s2chhaen/USV/README.md

Unmanned Surface Vehicle (USV)
# USV-Projekt

Im Projekt USV entwickeln Studenten unterschiedlicher Fachbereiche ein autonomes Wasserfahrzeug, welches eine vorgegebene Route fährt. Dabei müssen Kollisionen mit bewegten und unbewegten Hindernissen vermieden werden.

USV

(c) 2023 Joe.G
