s2chhaen/USV/01 Hardware/11 GPS/03 Software/99 demo/readme.md

## Testmessung für Kalmanfilter (GPS+IMU).
Messung und räumliche Kombination mehrerer Inertialsensoren.
Die Bewegung erfolgte im Gyrokoordinatensystem in Richtung der x-Achse

Messgrößen sind:
- Beschleunigung in ax, ay, az
- Drehraten in gx, gy, gz
- Timestamp
- Latitude, Longitude, Speed
- Satelliten

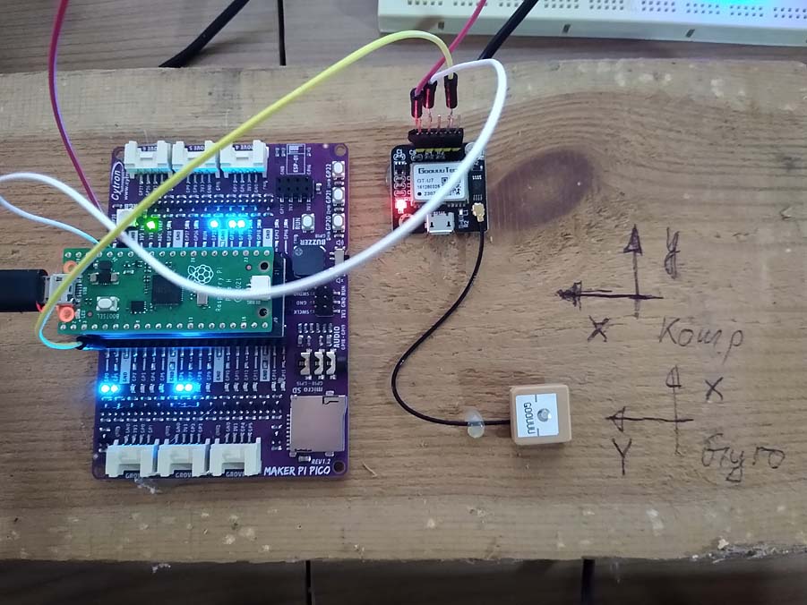
[picture p4: 01 Hardware/11 GPS/03 Software/99 demo/aufbau.jpg]
Versuchsaufbau
