s2chhaen/USV/01 Hardware/07 drive/02 Software/98 lib/README.md

## Hilfsfunktionen für die Antriebe

### PIO Module für RPi Pico RP2040 

1. uart_dma_rx.py (8 UART's für RX)
2. uart_dma_xx.py (8 UART's für TX)

### Steuerfunktion für Trust und Rudder

1. drive_system.py (aktuelle Steuerfunktion für Trust und Rudder)
2. test_drive_system.py (Testfunktionen)
