s2chhaen/USV/01 Hardware/06 energy_management/01 Firmware/Berechnungsformeln.docx

Berechnungsformeln von Spannung, Strom und Energie:

Spannung:

U=(ADC∙U_(Ref))/1024∙k=(ADC∙2,5 V)/1024∙6

ADC | … | Ausgangswert des Analog-Digital-Wandlers
URef | … | Referenzspannung des Analog-Digital-Wandlers
k | … | Verstärkungsfaktor des Spannungsteilers

Strom:

I=(ADC∙U_(Ref))/(1024∙R_S ∙m)+n/m=(ADC∙2,5 V)/(1024∙100 Ω∙0,00039487)+(0,00000451)/(0,00039487)

RS | … | Shuntwiderstand
m | … | Anstieg der Kalibrierfunktion
n | … | Offset der Kalibrierfunktion

Leistung:

P=U∙I

Energie:

E=P_(alt) ∙t+((P_(neu) -P_(alt) )∙t)/2

Palt | … | Leistung der vorherigen Messung
Pneu | … | Leistung der aktuellen Messung
t | … | Zeitintervall

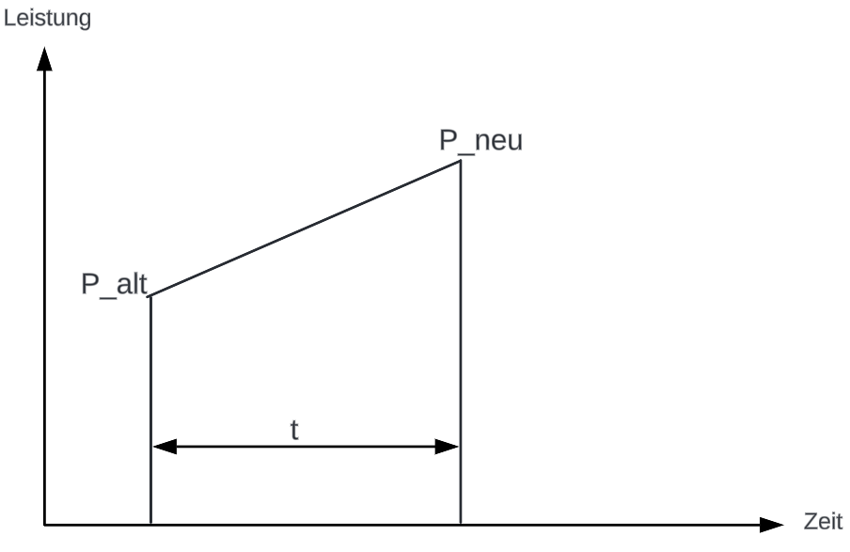
[picture p6: figure]
