s2chhaen/USV/01 Hardware/08 control/00 doc/Projektabschlusspräsentation.pdf

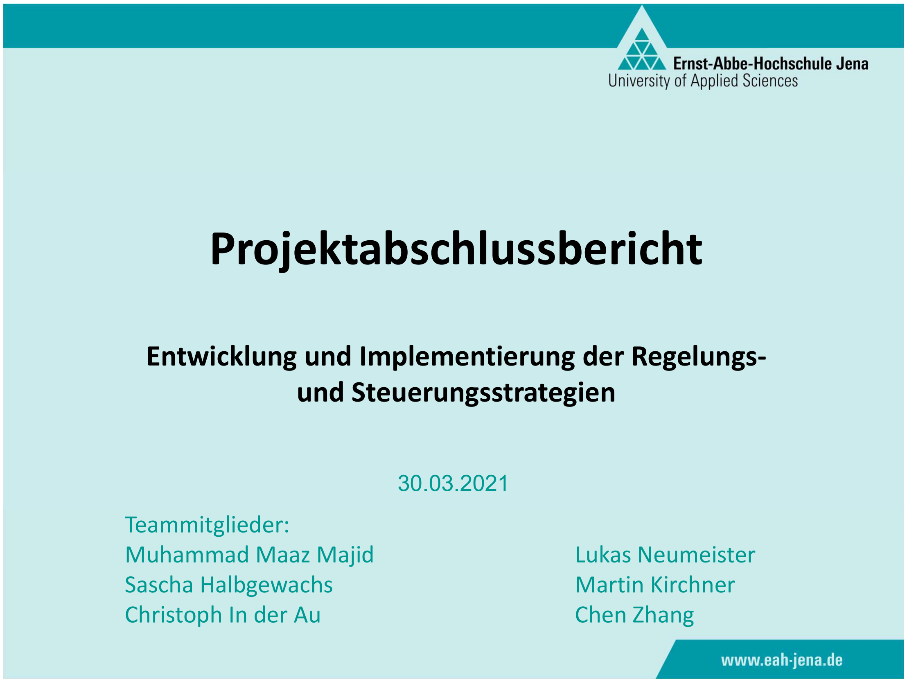
[picture p19: page 1]

# Projektabschlussbericht

## Entwicklung und Implementierung der Regelungs-und Steuerungsstrategien

30.03.2021
Teammitglieder:
Muhammad Maaz Majid | Lukas Neumeister
Sascha Halbgewachs | Martin Kirchner
Christoph In der Au | Chen Zhang

## Inhalt

## 1. Einleitung 2. Hardware und Buskommunikation 3. Regelungsstrategie 4. Ergebnisse und Validierung 5. Zusammenfassung und Ausblick

30.03.2021 | Chen Zhang | 2

# Einleitung

30.03.2021 | Chen Zhang | 3

Einleitung

## Aufteilung in Team

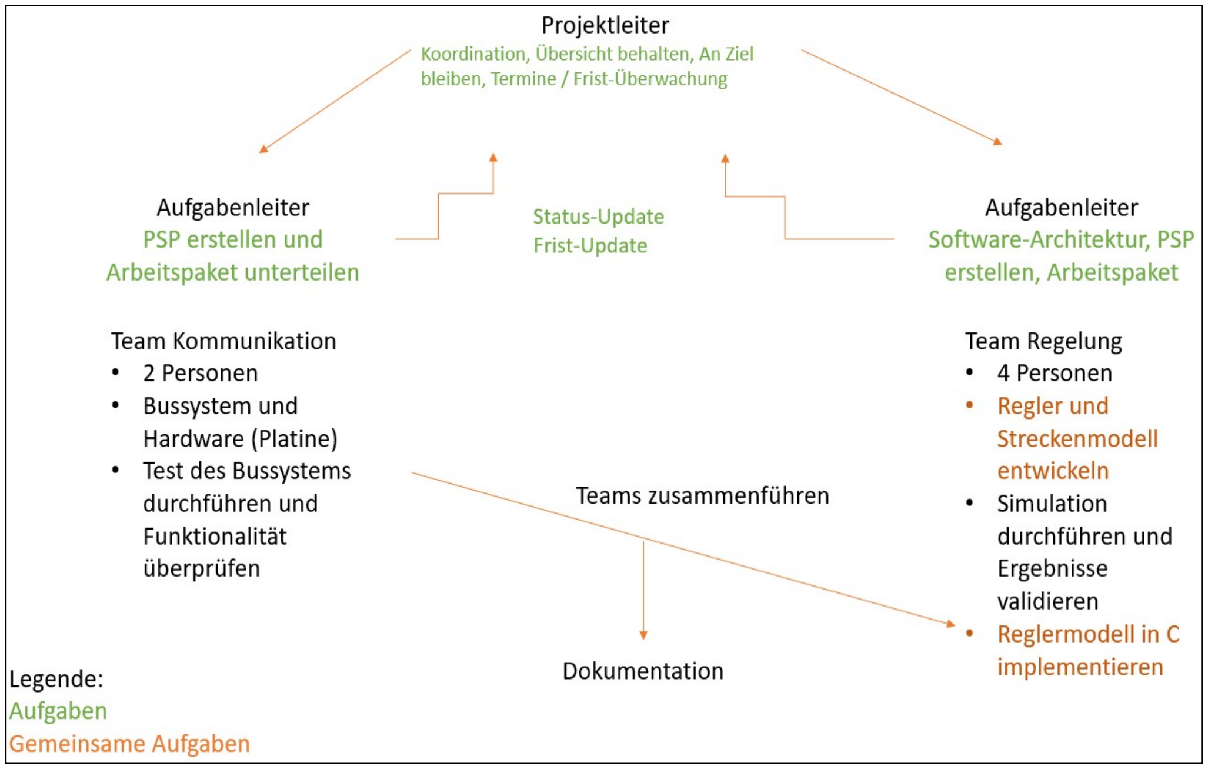
[picture p20: figure]

30.03.2021 | Chen Zhang | 4

# Hardware und Buskommunikation

30.03.2021 | Lukas Neumeister, Christoph In der Au | 5

Hardware und Buskommunikation

## Überblick

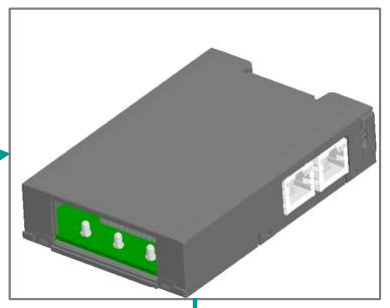
[picture p21: figure]
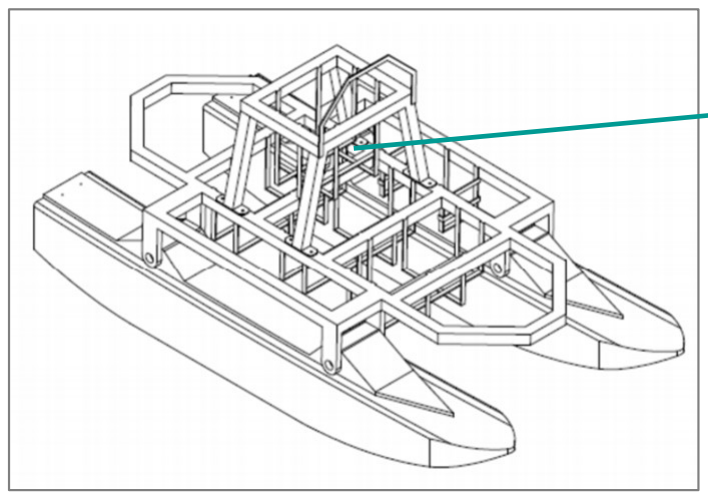
[picture p22: figure]
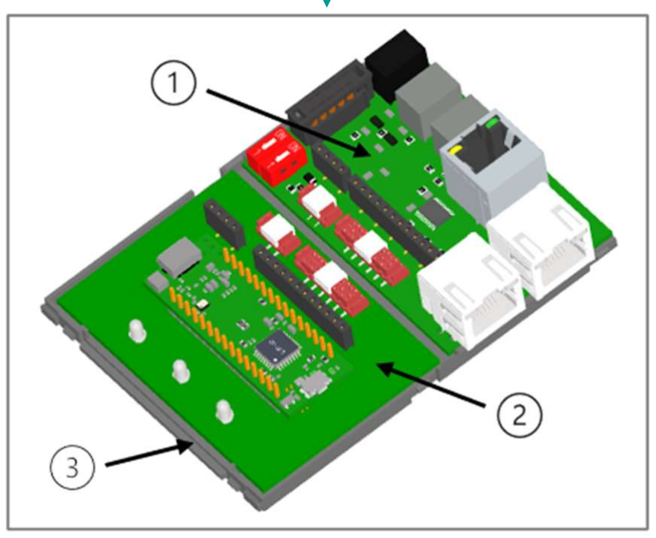
[picture p23: figure]

30.03.2021 | Lukas Neumeister, Christoph In der Au | 6

Slave und User-Unit

USV – Katamaran [1]

User-Unit
Gehäuse

Slave

Hardware und Buskommunikation

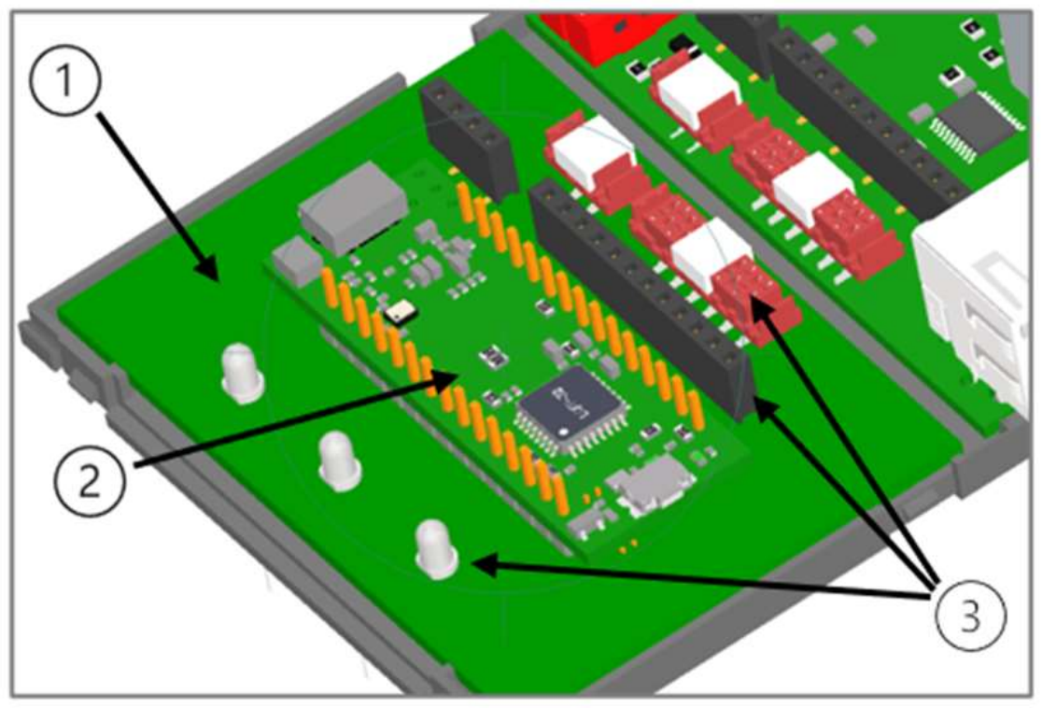
[picture p24: figure]

## Hardware

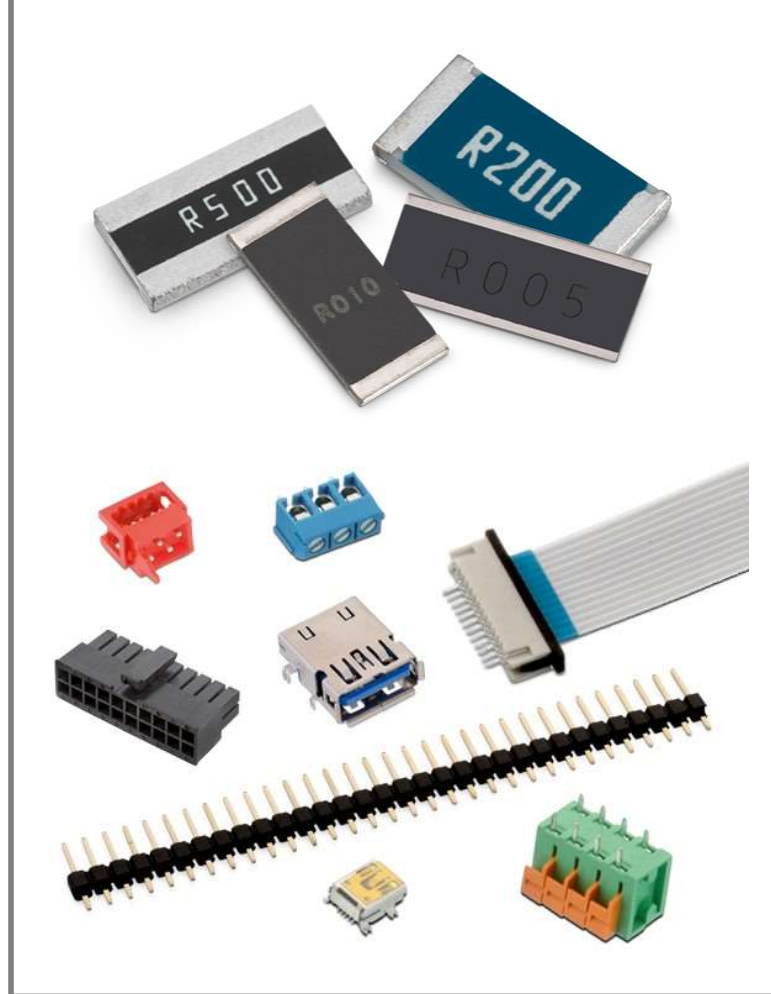
[picture p25: figure]
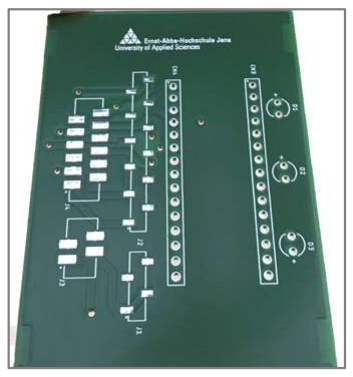
[picture p26: figure]
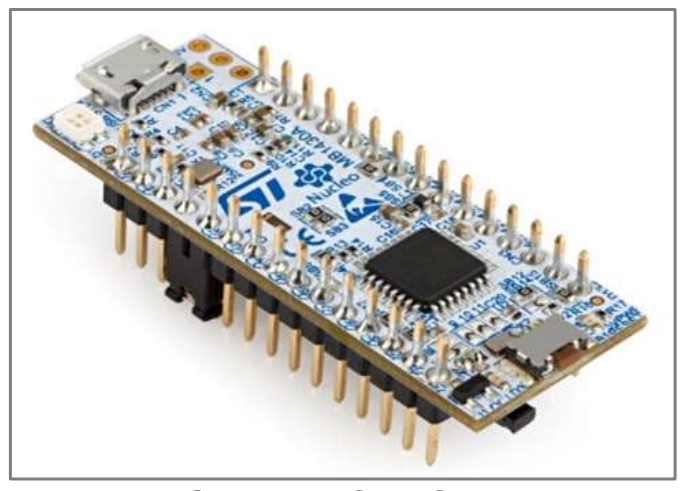
[picture p27: figure]

30.03.2021 | Lukas Neumeister, Christoph In der Au | 7
STM NUCLEO[3] | Würth Electronic [4]
Platinenlayout | Entwicklungsboard | Weitere Bauteile

Hardware und Buskommunikation

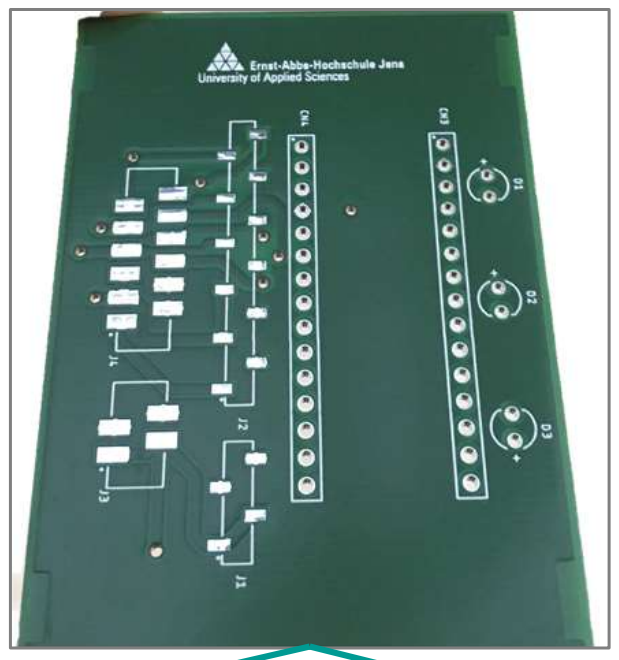
[picture p28: figure]

## Platinenlayout

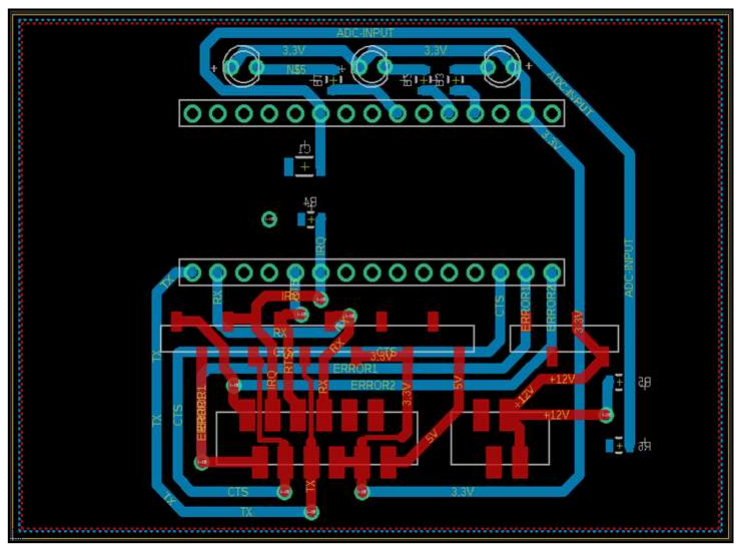
[picture p29: figure]
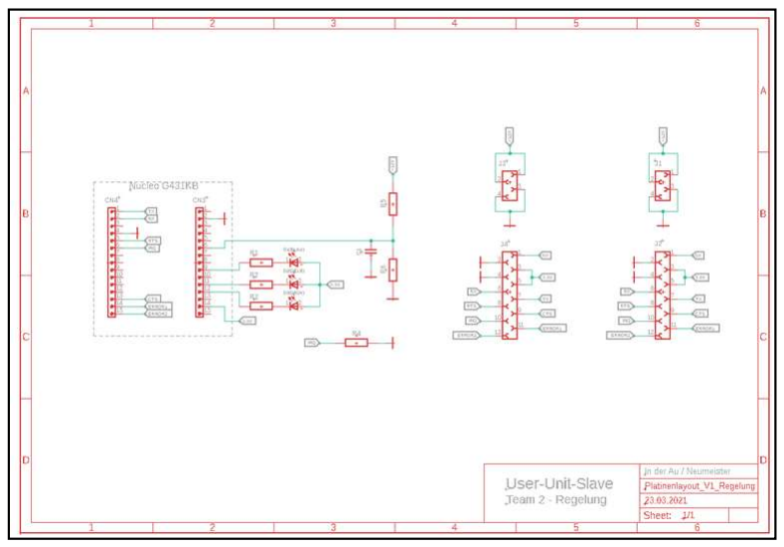
[picture p30: figure]

30.03.2021 | Lukas Neumeister, Christoph In der Au | 8
Board-Layout | Schaltplan

Hardware und Buskommunikation

## Board-Layout

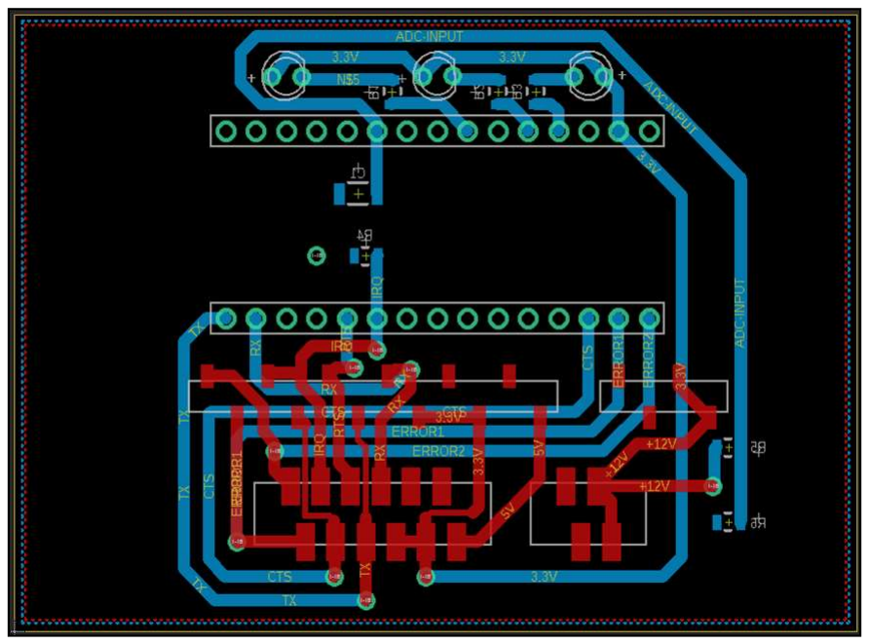
[picture p31: figure]

30.03.2021 | Lukas Neumeister, Christoph In der Au | 9
- 2-Layer-Platine
- Verwendung von VIAs
- Maße: 70,8 x 50,1 x 15 mm
- Platinenstärke: max. 1,6 mm
- Design-Rules: • EAGLE-Vorlage
- SMD 0805
- Leitungsstärken 0,5 – 1 mm
- Lochraster (2,54 mm)
- Keep-Out-Areas • Befestigung der Platine im Gehäuse

## Schaltplan

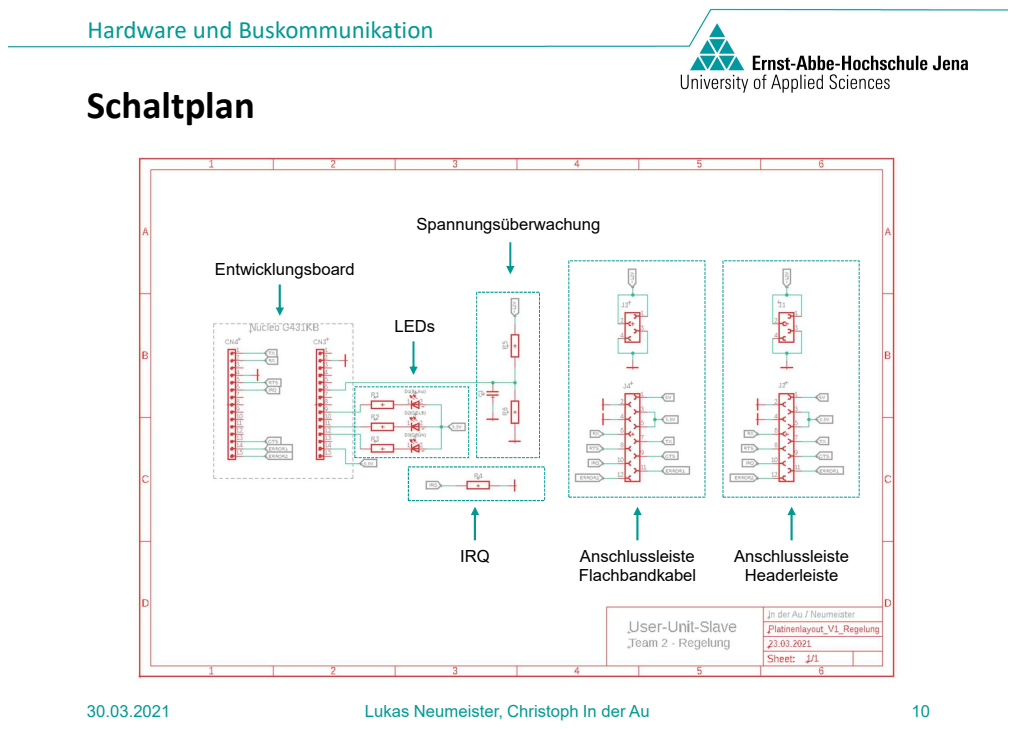
[picture p32: page 10]
Lukas Neumeister, Christoph In der Au; Entwicklungsboard; Spannungsüberwachung; LEDs; Anschlussleiste Flachbandkabel; Anschlussleiste Headerleiste; IRQ

Hardware und Buskommunikation

Hardware und Buskommunikation

## Entwicklungsboard

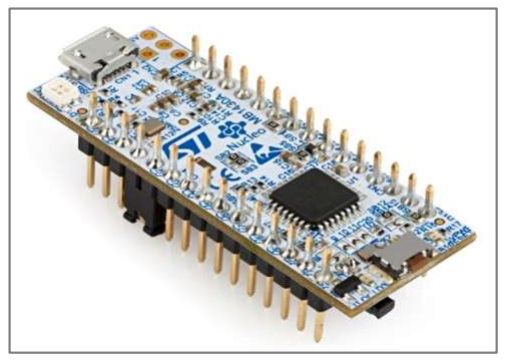
[picture p33: figure]
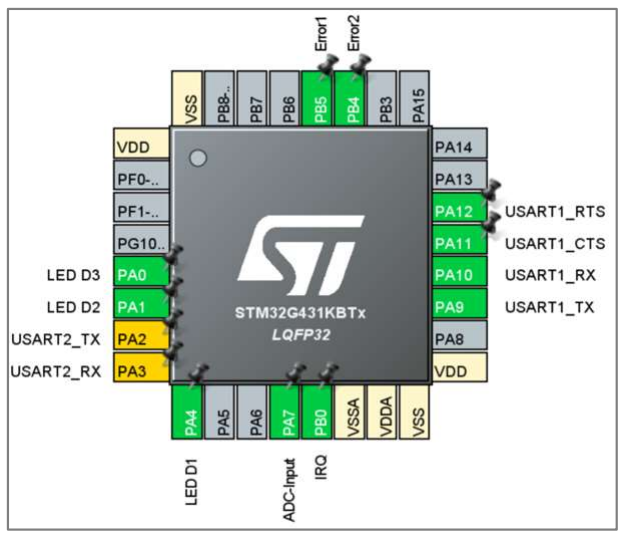
[picture p34: figure]

30.03.2021 | Lukas Neumeister, Christoph In der Au | 11

STM NUCLEO[3]

- Hersteller: STM • Typ: NUCLEO G431KB
- Software STM32CubeIDE 1.5.0
- Konfiguration der Pins
- Anforderungen: • Maße
- Versorgungsspannung
- RS232-Busspannung
- Anwendung / Support • Preis/Leistung

Hardware und Buskommunikation

## Entwicklungsboard

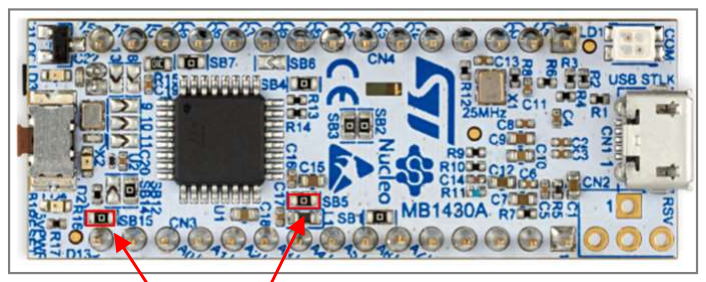
[picture p35: figure]

30.03.2021 | Lukas Neumeister, Christoph In der Au | 12
- Modifizierung Layout
- Entfernung Lötbrücke SB5
- Entfernung Lötbrücke SB15
- Nur noch Betrieb mit 3,3 V möglich

Modifizierung

Hardware und Buskommunikation

## Weitere Bauteile

30.03.2021 | Lukas Neumeister, Christoph In der Au | 13
- Anforderungen
- SMD-Bauteile (Kondensatoren, Widerstände)
- Anschlussleisten für Flachbandkabel (feste Verbindung mit Slave)
- Headerleisten (Debugging)
- THT-LEDs (Debugging)

Hardware und Buskommunikation

## Finales Platinenlayout

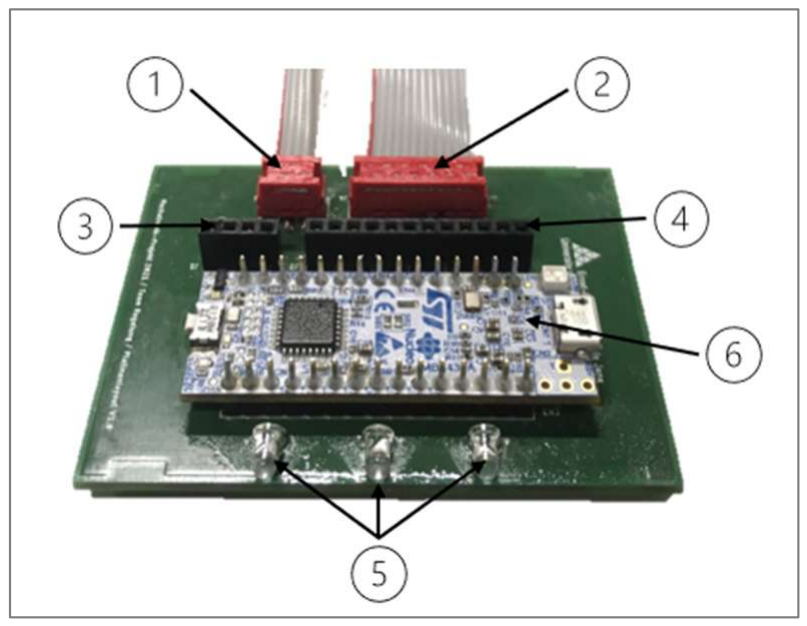
[picture p36: figure]
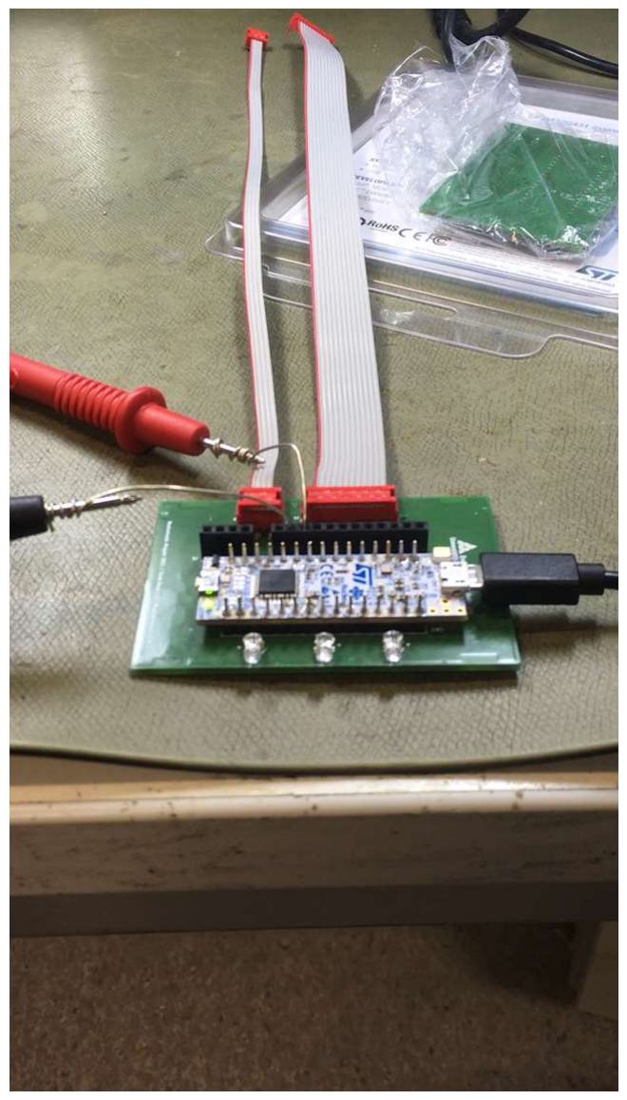
[picture p37: figure]

30.03.2021 | Lukas Neumeister, Christoph In der Au | 14

12-polig Flachbandkabel
4-polig Headerleiste

4-polig Flachbandkabel

12-polig Headerleiste
LEDs
Entwicklungsboard

Hardware und Buskommunikation

## Buskommunikation

Kommunikation User-Unit | USV-Slave:
- Bussystem: RS232-Bus
- Datenschnittstelle: UART-Schnittstelle

Datenübertragung:
- RS232-Übertragungsprotokoll definiert Datenablauf und Frameaufbau für das Schreiben und Lesen
- Blockweises Schreiben und Lesen von Daten

Entwicklungsumgebung:
- Board: NUCLEO-G431KB IDE: STM32CubeIDE 1.5.0
30.03.2021 | Lukas Neumeister, Christoph In der Au | 15

Hardware und Buskommunikation

## UARTs und ihre Aufgaben

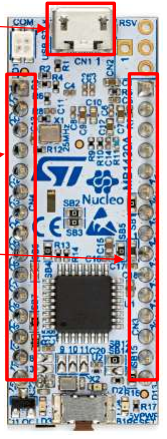
[picture p38: figure]

30.03.2021 | Lukas Neumeister, Christoph In der Au | 16

UART1
- Pin-Header
- Buskommunikation
mit dem USV-Slave

UART2
- USB-Connector
- Kommunikation mit dem
PC-Terminal
- Flashen und Debugging

## Daten schreiben

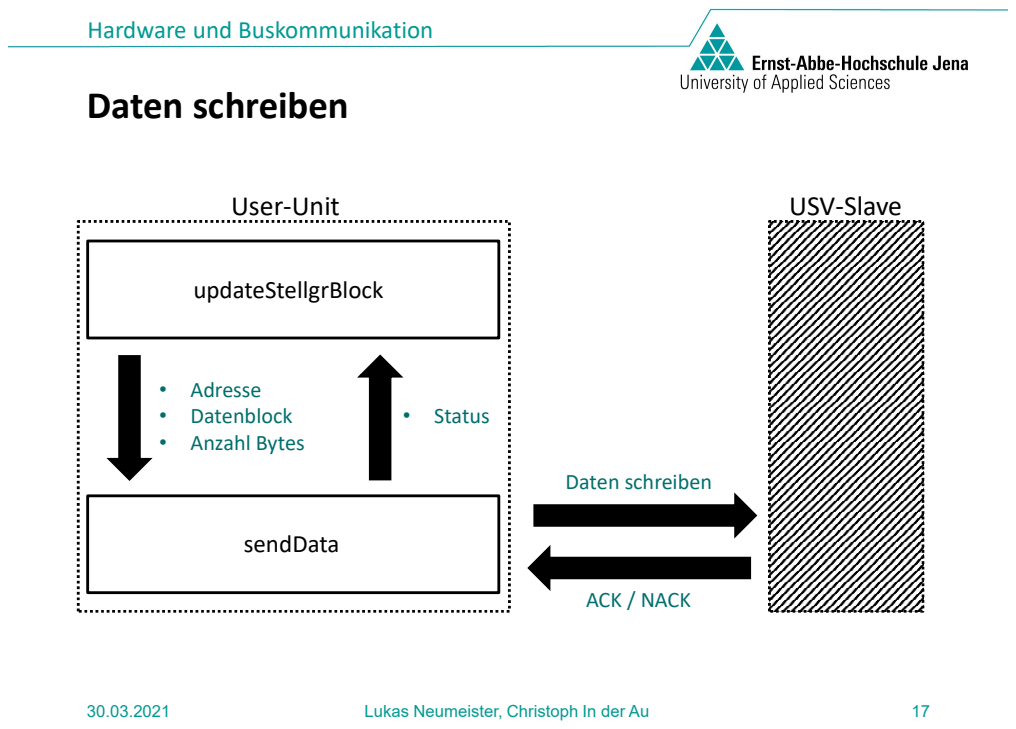
[picture p39: page 17]
Lukas Neumeister, Christoph In der Au; User-Unit; USV-Slave; updateStellgrBlock; sendData; Daten schreiben; ACK / NACK; • Adresse • Datenblock • Anzahl Bytes; • Status

Hardware und Buskommunikation

## Daten lesen

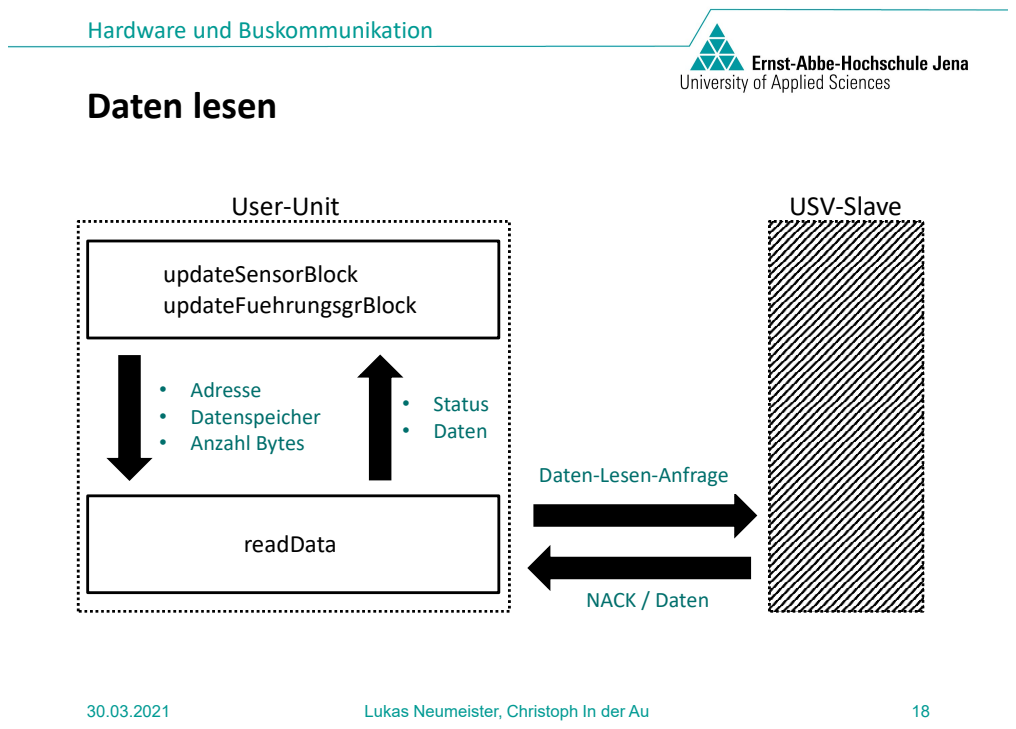
[picture p40: page 18]
Lukas Neumeister, Christoph In der Au; USV-Slave; NACK / Daten; User-Unit; updateSensorBlock updateFuehrungsgrBlock; readData; • Status • Daten

Hardware und Buskommunikation

• Adresse
• Datenspeicher • Anzahl Bytes

Daten-Lesen-Anfrage

Hardware und Buskommunikation

## Aktuelle Softwareprobleme

- Nach einer gewissen Zeitspanne hängt sich die Kommunikation auf Behebung des Problems geplant: 06.04.2021
- Slave-ID ergänzen
30.03.2021 | Lukas Neumeister, Christoph In der Au | 19

# Regelungsstrategie

30.03.2021 | Muhammad Maaz Majid | 20

Regelungsstrategie

## Regelungsstrategie

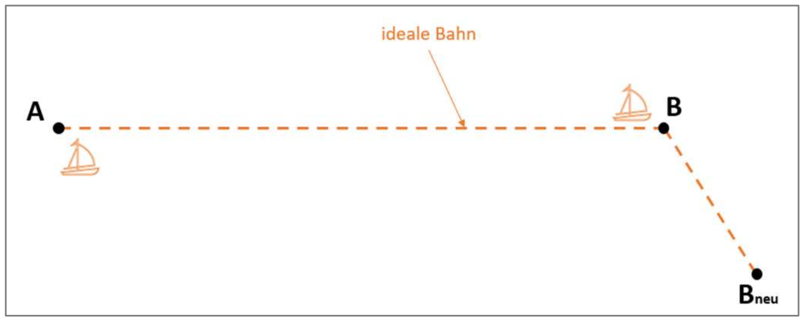
[picture p41: figure]
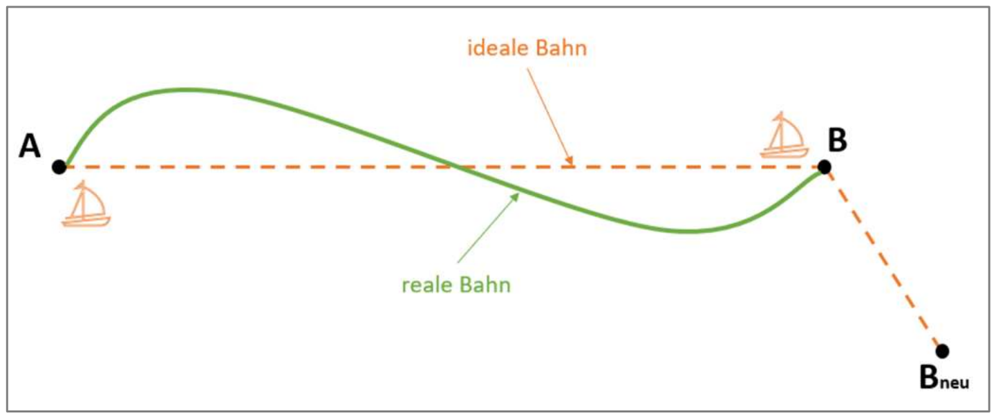
[picture p42: figure]

30.03.2021 | Muhammad Maaz Majid | 21

Regelungsstrategie

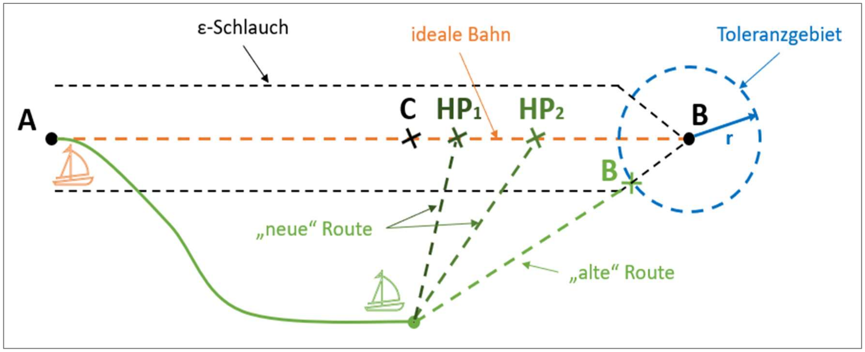
[picture p43: figure]

30.03.2021 | Muhammad Maaz Majid | 22

# Ergebnisse und Validierung

30.03.2021 | Muhammad Maaz Majid | 23

Ergebnisse und Validierung

## Ergebnisse

- PID-Regelalgorithmus umgesetzt
- Regelstrategie entwickelt und über interne Tests validiert
- Berechnung der Entfernung und Peilung implementiert und intern validiert
- Kommunikation über UART und benötigte Konvertierung umgesetzt
30.03.2021 | Muhammad Maaz Majid | 24

## Ergebnisse der Berechnungen

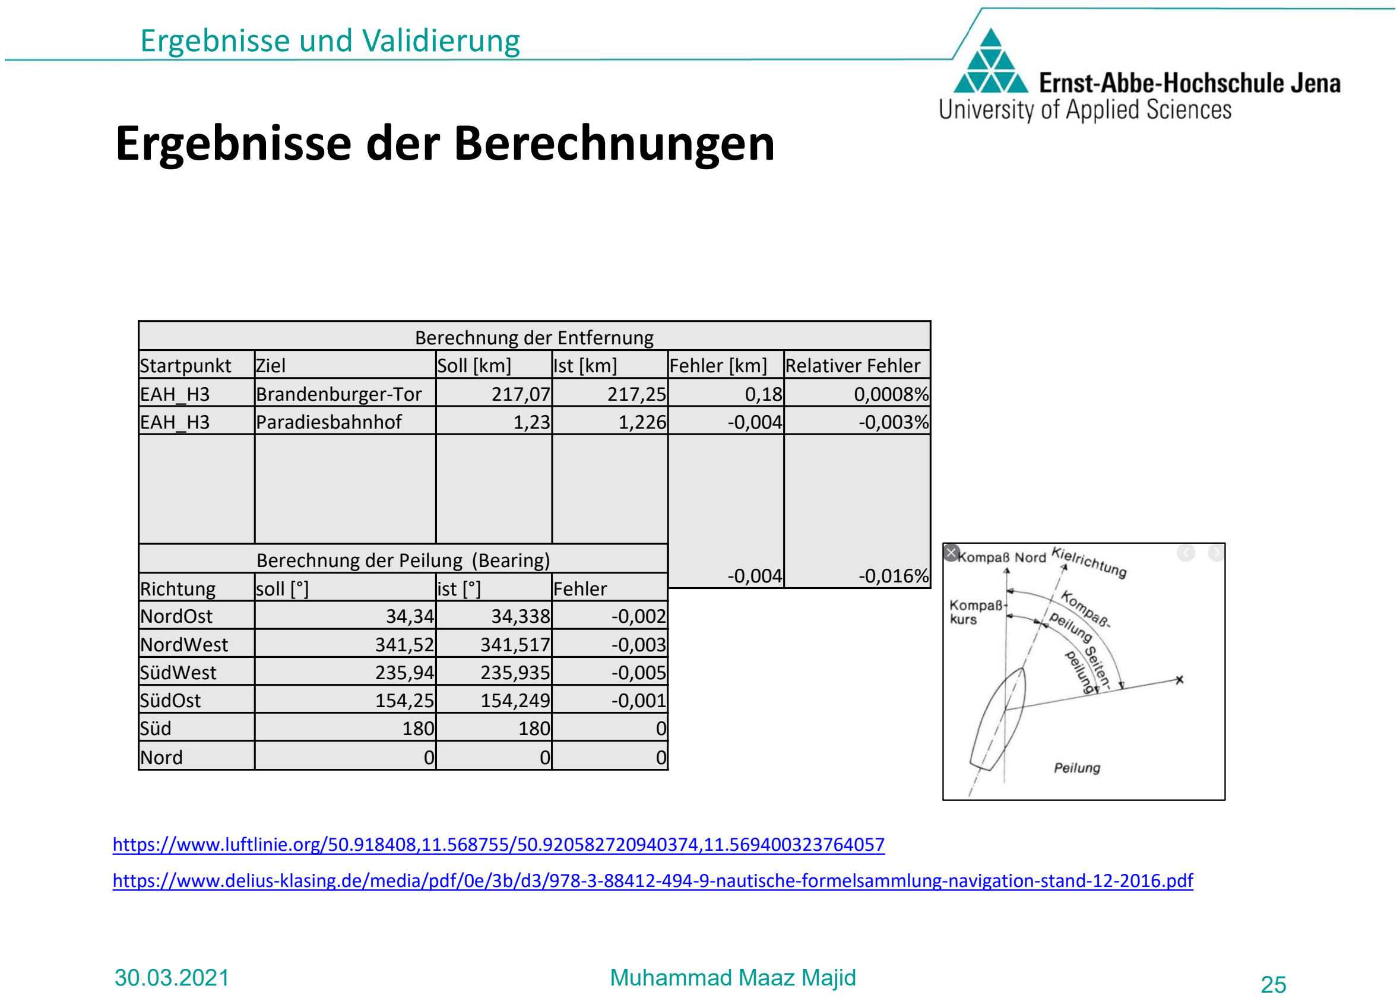
[picture p44: page 25]

Ergebnisse und Validierung

https://www.luftlinie.org/50.918408,11.568755/50.920582720940374,11.569400323764057https://www.delius-klasing.de/media/pdf/0e/3b/d3/978-3-88412-494-9-nautische-formelsammlung-navigation-stand-12-2016.pdf

25

Berechnung der Entfernung
Startpunkt | Ziel | Soll [km] | Ist [km] | Fehler [km] | Relativer Fehler
EAH_H3 | Brandenburger-Tor | 217,07 | 217,25 | 0,18 | 0,0008%
EAH_H3 | Paradiesbahnhof | 1,23 | 1,226 | -0,004 | -0,003%
| | | | -0,004 | -0,016%
EAH_H3 | Berechnung der Peilung (Bearing) Netto Parkplatz | 0,25
Richtung | soll [°] | ist [°] | Fehler
NordOst | 34,34 | 34,338 | -0,002
NordWest | 341,52 | 341,517 | -0,003
SüdWest | 235,94 | 235,935 | -0,005
SüdOst | 154,25 | 154,249 | -0,001
Süd | 180 | 180 | 0
Nord | 0 | 0 | 0

30.03.2021 Muhammad Maaz Majid

Ergebnisse und Validierung

## Berechnung Targetpoint

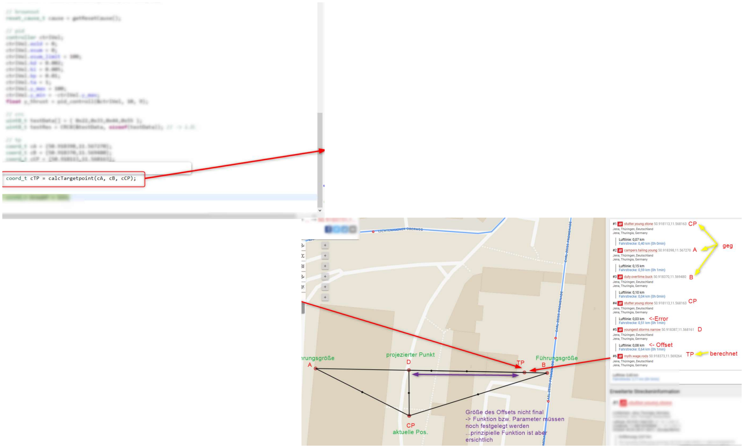
[picture p45: figure]

30.03.2021 | Muhammad Maaz Majid | 26

# Zusammenfassung und Ausblick

30.03.2021 | Muhammad Maaz Majid, Lukas Neumeister | 27

Zusammenfassung und Ausblick

## Ausblick

30.03.2021 | Muhammad Maaz Majid, Lukas Neumeister | 28
- Noch offen:
- Ermittlung exakter Reglerparameter am realen Bootmodell
- Unter Bearbeitung & wird nachgereicht:
- Implementierung Watchdog
- Detektion Brownout (Reset)
- Bugfix für Nichtwiederaufnahme der Kommunikation nach fehlerhafter Übertragung

Zusammenfassung und Ausblick

## Ausblick

30.03.2021 | Muhammad Maaz Majid, Lukas Neumeister | 29
- Folgende Erweiterungen sind denkbar:
- Fehlerbehandlungen
- Auslösen von Fehlermeldungen (z.B. Plausibilitätsprüfung Ergebnisse)
- Berechnung Targetpoints in Abhängigkeit der Geschwindigkeit
- Spannungsüberwachung (falls sinnvoll, Hardware schon vorhanden)

Zusammenfassung und Ausblick

## Zusammenfassung

- Zusammenfassung
- Hardware entwickelt und in Betrieb genommen
- Regelstrategie entwickelt und in C umgesetzt
- Buskommunikation über UART umgesetzt
- Konvertierung der Daten für Buskommunikation und Berechnung der Entfernung und Peilung umgesetzt
- PID-Regler implementiert
- Implementierte Programme intern validiert und zum Teil im Labor getestet
- Trotz schwieriger Umstände wegen Online-Semester haben wir die meisten Aufgaben rechtzeitig erledigt aufgrund guter Teamarbeit und guter Zusammenarbeit mit Prof. Grabow / Herr Franke / Team 1
30.03.2021 | Muhammad Maaz Majid, Lukas Neumeister | 30

## Vielen Dank für Ihre Aufmerksamkeit!

31 Chen Zhang, Christoph In der Au, Martin Kirchner, Muhammad Maaz Majid, Lukas Neumeister, Sascha Halbgewachs 30.03.2021

Quellen

## Quellen

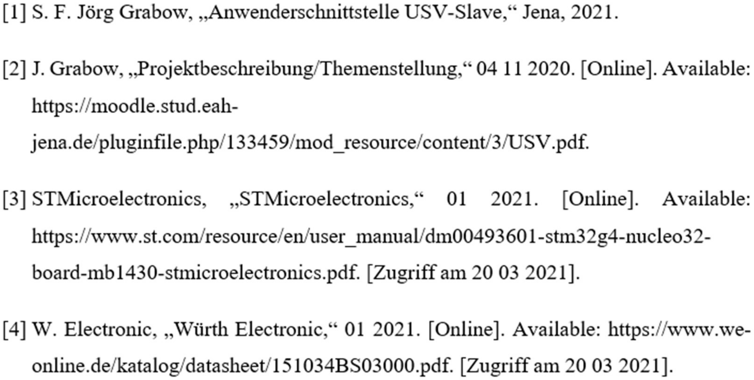
[picture p46: figure]

30.03.2021 32
