s2chhaen/USV/01 Hardware/03 APRS/02 Hardware/00 doc/USV-BG-001-BT-A.pdf

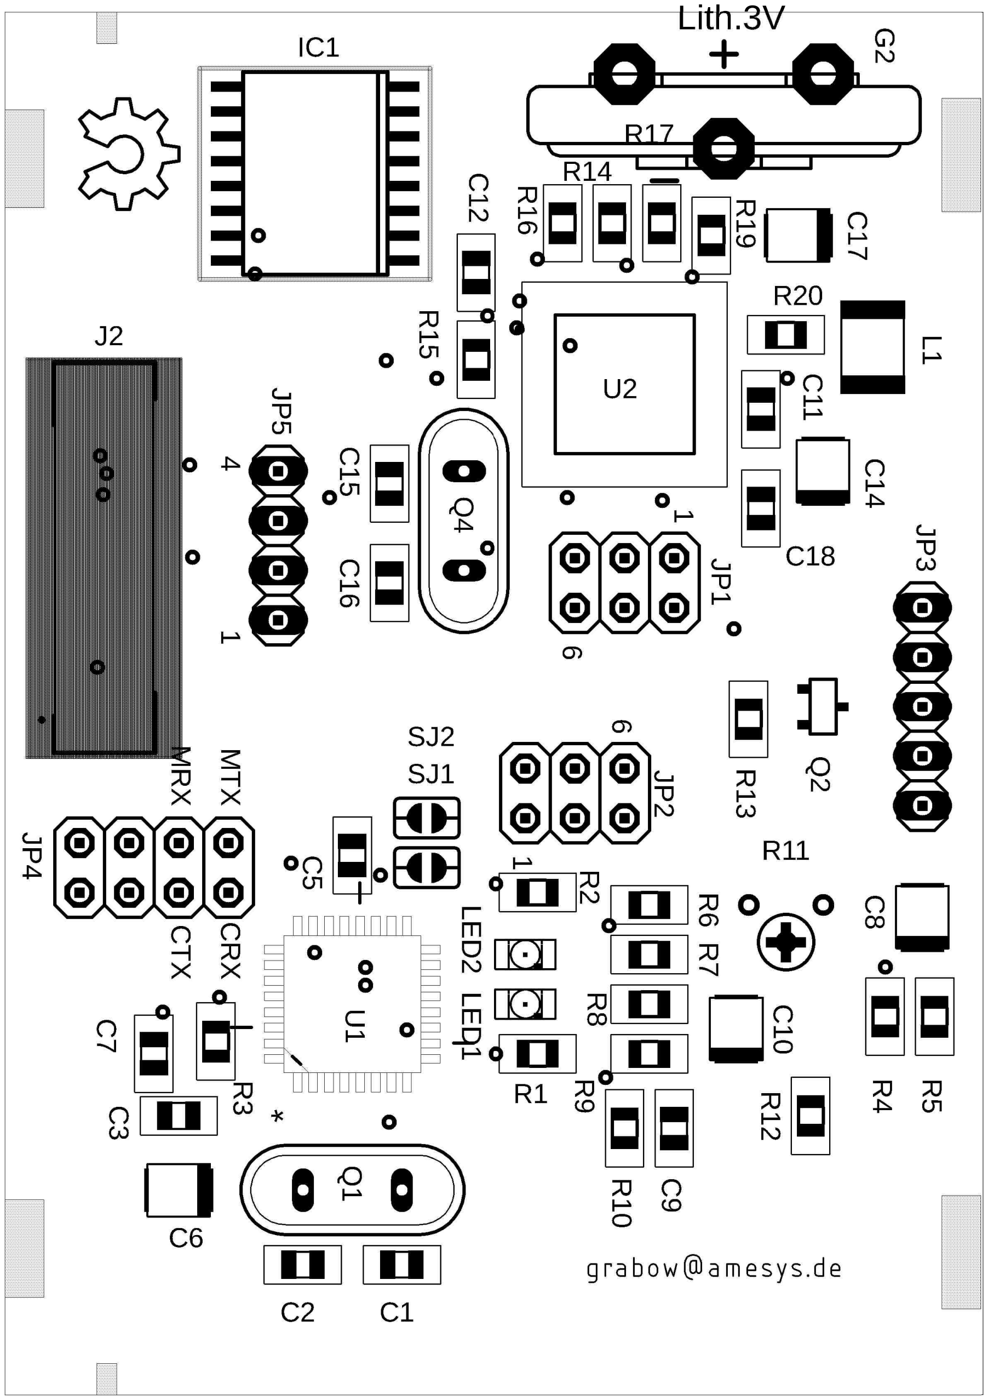
[picture p49: figure]
Lith.3V
