s2chhaen/USV/01 Hardware/01 Lidar/02 Hardware/00 doc/Kabelbelegung.xlsx

Nr | Name | Farbe
1 | 5V-Vcc | Rot
2 | GND | Schwarz
3 | Tx | Blau
4 | Rx | Grün
