s2chhaen/USV/02 Software/README.md

# Software zum USV-Projekt

1. Bussystem (Systembus zwischen Master- und Slavemodulen)
2. MMC (Mission Control Center)
3. Tools (kleine Hilfsmittel)
4. Simulation (Softwaretools zur Dynamiksimulation)
5. USV-Monitor (Tool zur Emulierung des Bussystems)
