s2chhaen/USV/00 doc/README.md

# Dokumentation zum USV-Projekt

1. Bussystem (Systembus zwischen Master- und Slavemodulen)
2. Simulation (Dynmiksimulation des Katamarans)
3. APRS (APRS-Datenschnittstelle)
4. Tools (kleine Hilfsmittel)
5. Management (Unterlagen zur Projektorganisation)
