s2chhaen/USV/01 Hardware/09 RC Control/readme.md

## FrSky Taranis Q X7 ACCESS
Die Softwareversionen von TX und RX müssen übereinstimmen, ansonsten lassen sich die Empfänger nicht binden.

aktuelle Softwareversionen am 12.10.24
TX Version: ISRM-N_2.1.9
RX Version: RX6R_RX4R_ACCST_V2.1.9_LBT.frsk
