s2chhaen/USV/02 Software/02 MCC/02 grafana/README.md

## Misson-Control-Center Dashboard zum USV

[Dashbooard](https://usv.agg.fc.eah-jena.de/d/cb240e08-9a89-4d38-8afd-2c9a5fe3cf5h/usv-aprs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)

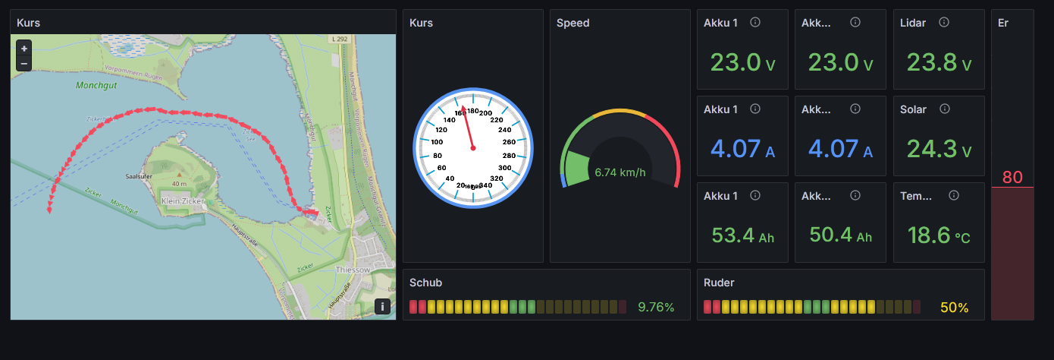
[picture p52: 02 Software/02 MCC/02 grafana/Grafana.png]
MCC-Dashboard Dashboard
