s2chhaen/USV/02 Software/02 MCC/01 python/README.md

## Python-Skripte

1. Python Skripte zum MQTT Broker
2. Python Skripte zum digitalen Zwilling des USV
