s2chhaen/USV/00 doc/02 APRS/00 MQTT/README.md

## Dokumentation zum Datenmanagement zwischen ARRS - MQTT - MariaDB

 Datei | Beschreibung
-------|-------------
APRS-Daten.pdf | Aufbau der APRS-Datenstruktur pro Sendedurchgang 
MQTT_to_SQL.pdf | Umwandlung von APRS-Daten in MQTT Daten sowie Ablage der MQTT-Daten in einer SQL-Datenbank

### Übersichtsdarstellung Datenkommunikation zum MCC

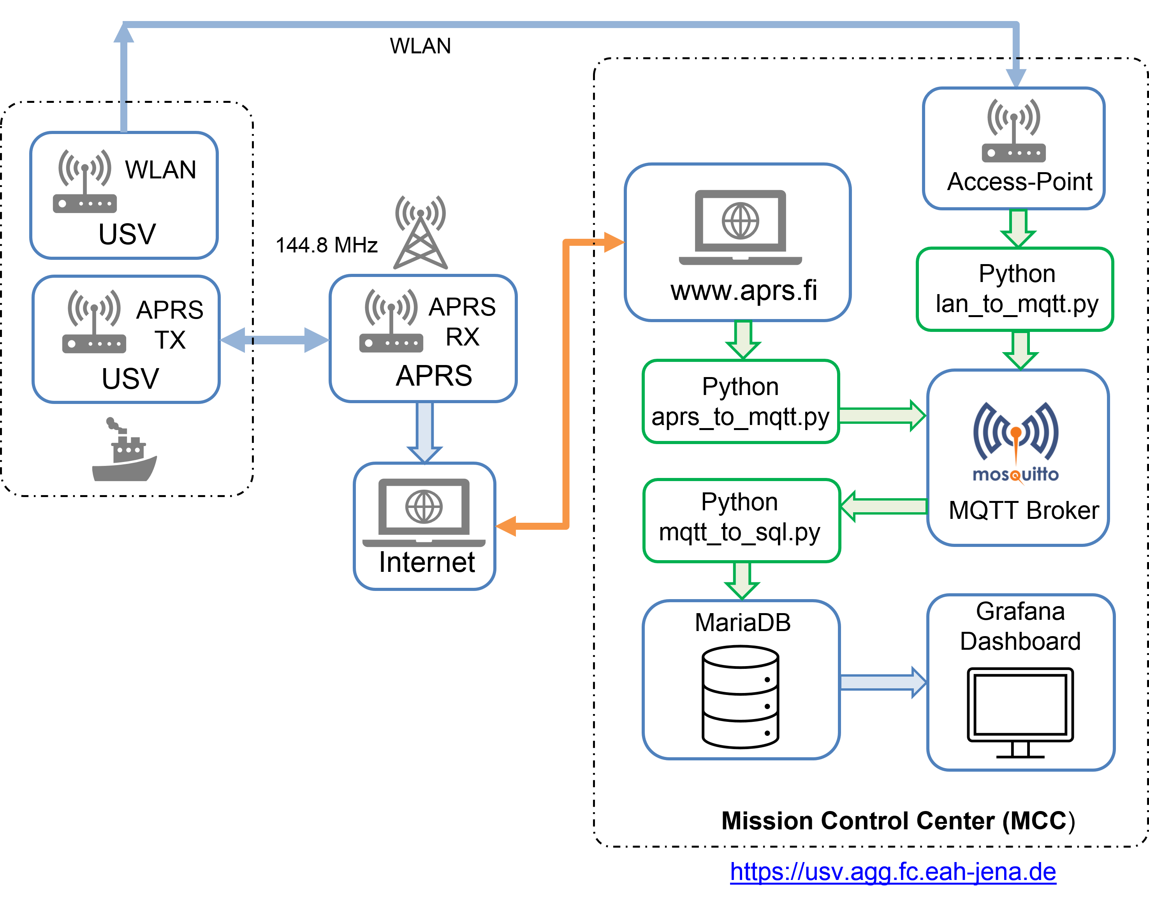
[picture p53: 00 doc/02 APRS/00 MQTT/Datenfluss.png]
MMC-Datenfluss Datenfluss


### MMC-Dashbord 

MMC-Dashboard Dashboard
