s2chhaen/USV/01 Hardware/09 RC Control/03 Firmware/01 RX/Readme.txt

*******************************Release Note******************************************

This Package is for RX4R RX6R ACCST v2.1.9 firmware update. 

Version and Files: 
RX6R_RX4R_ACCST_V2.1.9_FCC.frk                              Firmware under NonLbt mode which is certificated for FCC rules. 
RX6R_RX4R_ACCST_V2.1.9_LBT.frk                               Firmware under LBT mode which is certificated for CE rules.  
readme.txt                                                          Release note 
 
Firmware Version: v2.1.9

Please update the firmware of all your radios, RF modules and receivers accordingly.
The release history:
--------------------------------------------------------------------------------------------------------------------
v2.1.9
--------------------------------------------------------------------------------------------------
1. Fixed the issue of no PWM output caused by abnormal conditions in the S.Port link such as specific error data or exceeding the limitation of devices connected in the S.Port link (＞27 units).
Note: Please make sure the involved Receiver [Archer series (except for RS), R-XSR, RXSR-FC, RX4R, RX6R, G-RX6, G-RX8] or Transmitter [ISRM-N, ISRM-Pro, ISRM-S series RF module] in using have been both upgraded with this update or later version.
—————————————————————————————
Compatibility | ISRM Modules & ACCESS Radios
—————————————————————————-———–
ISRM-N → (Taranis X9 Lite & QX7 ACCESS & QX7S ACCESS)
ISRM-S-X9LITES → (Taranis X9 Lite S)
ISRM-S-X9DP2019 → (Taranis X9DP 2019 & X9DP 2019 SE)
ISRM-S-XLITES → (Taranis XLite S)
ISRM-Pro → (Taranis XLite Pro)
ISRM-S-X10E → (Horus X10 EXPRESS & X10S EXPRESS)
ISRM-S-X10S → (ACCESS Upgrade Module)

---------------------------------------------------------------------------------------------------------------------------------
How to upgrade receivers please refer to the video below:
https://www.frsky-rc.com/how-to-use-the-transmitter-to-flash-the-firmware-of-the-x8r-receiver/

With other radios which have s.port please choose [Flash s.port] in menu .
1. Put the firmware under the folder [FIRMWARE] of sd card.
2. Power on the radio and find the firmware,select it by press [ENT].
3. Select 'Flash S.port ', wait to end.

With Airlink S :
https://www.frsky-rc.com/how-to-upgrade-the-s-series-receivers-with-the-s-port-airlink-s/

With STK:
https://www.frsky-rc.com/how-to-use-frsky-stk-tool-to-update-firmware/
---------------------------------------------------------------------------------------------------------------------

**********************All rights reserved to FrSky Electronic ., Ltd.*********************************
