s2chhaen/USV/01 Hardware/07 drive/00 doc/Steuerkennlinie Haswing Protruar.pdf

# Steuerkennlinie Haswing Protruar

### Eingangsgröße: VVPower; Ganzzahlenwert „int16“; DD = ℤ ∧ [−16384, 16384] Ausgangsgröße: VVPPPPPP; Ganzzahlenwert „uint8“; DD = ℤ ∧ [0, 255]

### Mathematische Funktion

# VPPP(VPPPPP) = ⌊m ⋅ VPPPPP + n⌋ VPPP(VPPPPP) =

mmff

### 2ddff

# VPPPPP + n VPPP(VPPPPP) = mf ⋅ VPPPPP ⋅ 2−df + n

### mit

# mm − FFFFFFFFFFFF mmff − FFFFFFFFFFFF DDDDDDDDDD ddff − FFFFFFFFFFFF 2nn DDDDDDDD DD nn − OOOOOO

### Kennlinien Segmentierung

### - Segment 1: Vorwärtsfahrt; DD1 = ℤ ∧ [112, 235] - Segment 2: Stillstand; DD2 = ℤ ∧ [69, 111] - Segment 3: Rückwärtsfahrt DD3 = ℤ ∧ [0, 68]

### Segment 1 Funktion:

mm1 = 7.53784 ⋅ 10−3 ≈ 494
216
nn1 = 112

# VPPP(VPPPPP) = ⌊7.53784 ⋅ 10−3 ⋅ VPPPPP + 112⌋ VPPP(VPPPPP) = ⌊494 ⋅ VPPPPP ⋅ 2−16 + 112⌋

### Segment 2 Funktion:

mm2 = 335.94 ⋅ 10−3 ≈ 344
210
nn2 = 91

# VPPP(VPPPPP ) = ⌊335.94 ⋅ 10−3 ⋅ VPPPPP + 91⌋ VPPP(VPPPPP ) = ⌊344 ⋅ VPPPPP ⋅ 2−10 + 91⌋

### Segment 3 Funktion:

mm3 = 2.6932 ⋅ 10−3 ≈ 353
217
nn3 = 69

# VPPP(VPPPPP ) = ⌊335.94 ⋅ 10−3 ⋅ VPPPPP + 69⌋ VPPP(VPPPPP ) = ⌊353 ⋅ VPPPPP ⋅ 2−17 + 69⌋

### Segmentfunktion:

# VPPP(VPPPPP ) =

⎩

⎪

⎨

⎪

⎧

494

# 216 ⋅ VPPPPP + 112, if VPPPPP > 64

344

# 210 ⋅ VPPPPP + 91, if VPPPPP ≥ 64 ∧ VPPPPP ≤ 64

344

# 210 ⋅ VPPPPP + 69, if VPPPPP < 64

### Funktionsgraph

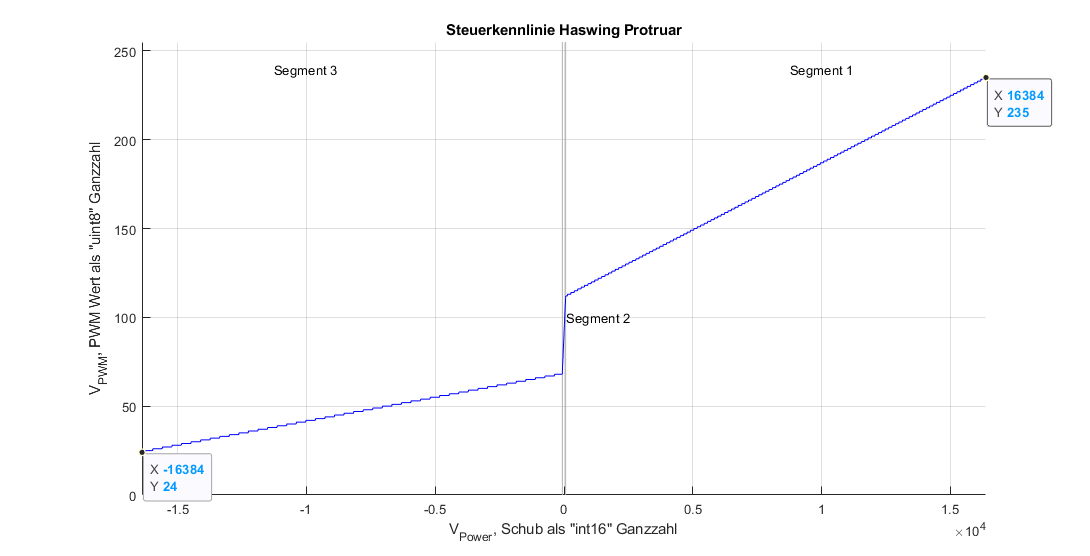
[picture p60: figure]

### Beispiel C-Code

#include <stdint.h>

// Matrix mit den Parametern für die PWM-Kennlinie
// mzmnnMatrix[][]:= {{mul 0, shift right 0, add 0}, Segment 0
// | {mul 1, shift right 1, add 1}, Segment 1
// | {mul 2, shift right 2, add 2}, Segment 2
// | {mul 3, shift right 3, add 3}, Segment 3
// | };
int24_t const mzmnnMatrix[4][3] = {{0,0,92}, {494,16,112}, {344,10,91}, {353,17,69}}; int16_t iPower;
int24_t iPWMPower24; // 24 Bit oder 32 Bit Zwischenwert
uint8_t uSegment;

iPower = get_Value(leftPower);

// Schublimitierung
iPower = MIN(iPower, 16384);
iPower = MAX(iPower, -16384);

iPWMPower24 = (int24_t)(iPower);

// Berechne für den Motor über die Kennlinie den 8-bit PWM-Wert als //Segmentweise Funktion
// Auswahl des Segmentes
if(iPower > 64)
uSegment = 1;
else if((iPower <= 64)&&(iPower >= -64)) uSegment = 2;
else if((iPower < -64))

uSegment = 3;
else
uSegment = 0;
// | Ganzzahl | Funktionswertberechnung
iPWMPower24 *= mzmnnMatrix[uSegment][0]; iPWMPower24 >>= mzmnnMatrix[uSegment][1]; iPWMPower24 += mzmnnMatrix[uSegment][2];

iPower = MIN(iPower, 255);
iPower = MAX(iPower, 0);

// Schreibe den PWM Wert in den Timer TimerCounterBx_set_PWM_Value(leftEngine, (uint8_t)iPower);
