s2chhaen/USV/01 Hardware/05 IMU/03 Software/00 docs/IMU_flowchart.pdf

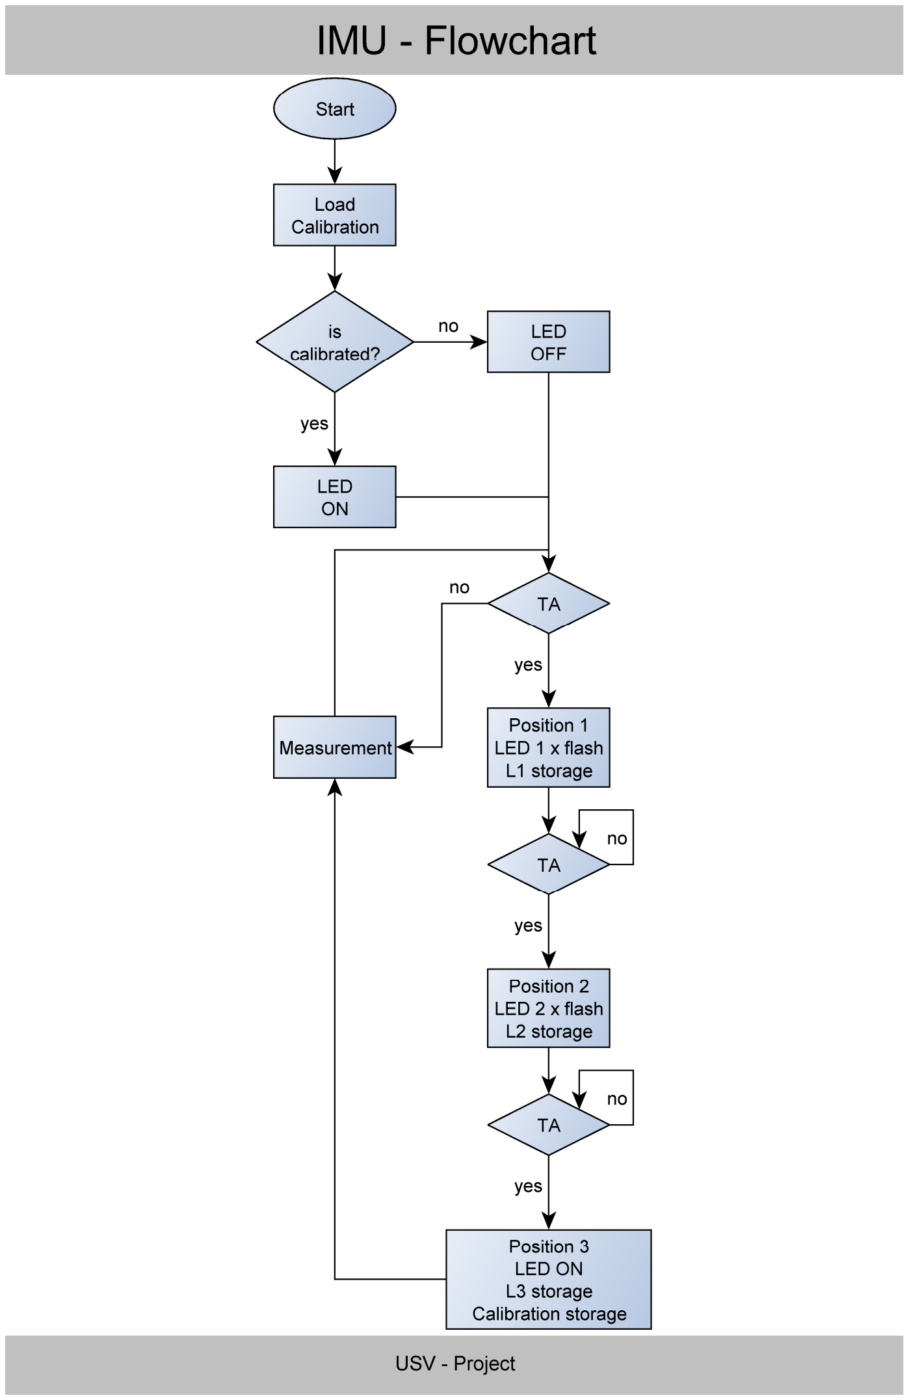
[picture p61: page 1]
