s2chhaen/USV/01 Hardware/11 GPS/03 Software/99 demo/sensor_data_0.csv

time | gps_x | gps_y | acc_x | acc_y | alpha
0 | 0 | 0 | 0.1 | 0.2 | 0.05
1 | 1 | 1.2 | 0.1 | 0.2 | 0.05
2 | 2.1 | 2.5 | 0.1 | 0.2 | 0.05
3 | 2.9 | 3.2 | 0.1 | 0.2 | 0.05
4 | 4.1 | 4.5 | 0.1 | 0.2 | 0.05
5 | 5 | 5.1 | 0.1 | 0.2 | 0.05
6 | 5.8 | 6.2 | 0.1 | 0.2 | 0.05
7 | 7 | 6.9 | 0.1 | 0.2 | 0.05
8 | 7.8 | 8.1 | 0.1 | 0.2 | 0.05
9 | 9.1 | 8.9 | 0.1 | 0.2 | 0.05
10 | 9.9 | 10 | 0.1 | 0.2 | 0.05
