s2chhaen/USV/01 Hardware/11 GPS/03 Software/99 demo/sensor_data_1.csv

time | gps_x | gps_y | acc_x | acc_y | alpha
0 | 0 | 0 | 0 | 0 | 0
1 | 1 | 1.2 | 0 | 0 | 0
2 | 2.1 | 2.5 | 0 | 0 | 0
3 | 2.9 | 3.2 | 0 | 0 | 0
4 | 4.1 | 4.5 | 0 | 0 | 0
5 | 5 | 5.1 | 0 | 0 | 0
6 | 5.8 | 6.2 | 0 | 0 | 0
7 | 7 | 6.9 | 0 | 0 | 0
8 | 7.8 | 8.1 | 0 | 0 | 0
9 | 9.1 | 8.9 | 0 | 0 | 0
10 | 9.9 | 10 | 0 | 0 | 0
