s2chhaen/USV/01 Hardware/98 Slave_Default/01 case/step/Gehäuse_CN-22-GU_assembly.stp

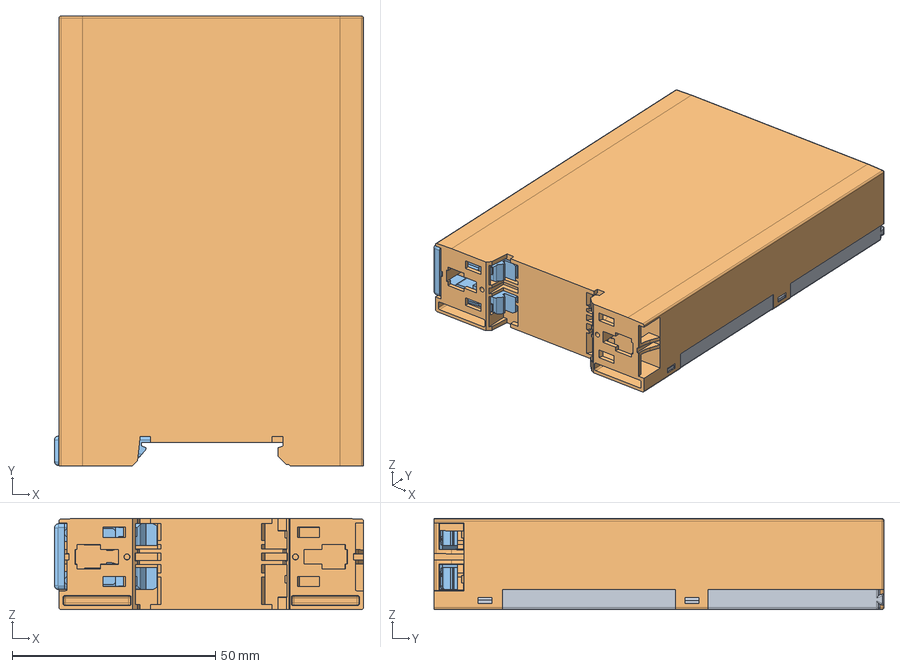
[picture p62: CAD file, 2023-11-03]
01 Hardware/98 Slave_Default/01 case/step/Gehäuse_CN-22-GU_assembly.stp
76.1 x 110.8 x 22.5 mm
65000100_CN-DU65000100_CN-DU
1007020_3Dsym
1006983_3Dsym
