s2chhaen/USV/01 Hardware/02 Radar/02 Hardware/03 CAD/Gehäuse_Sensor_Dummy.stp

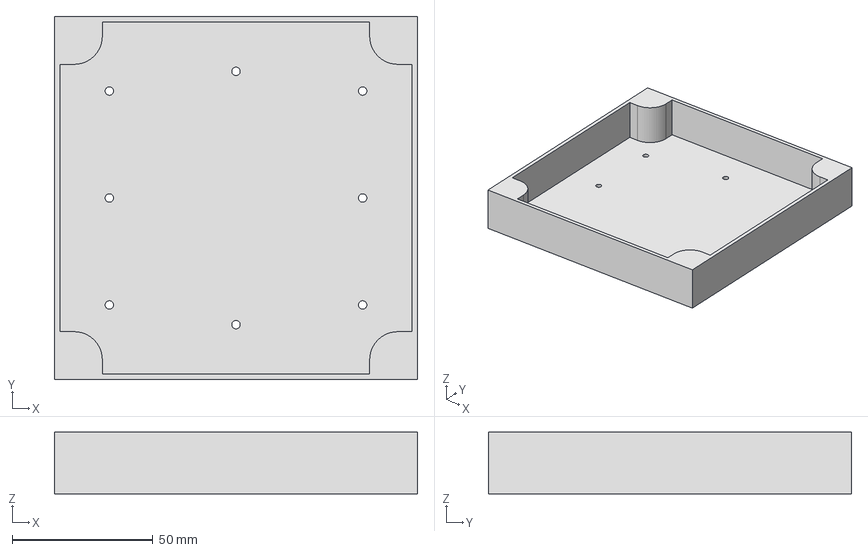
[picture p63: CAD file, 2023-06-07]
01 Hardware/02 Radar/02 Hardware/03 CAD/Gehäuse_Sensor_Dummy.stp
129.0 x 129.0 x 22.0 mm
