s2chhaen/USV/01 Hardware/99 Frame/01 Motorhalterung/STEP/Motorhalterung_BT2.1.stp

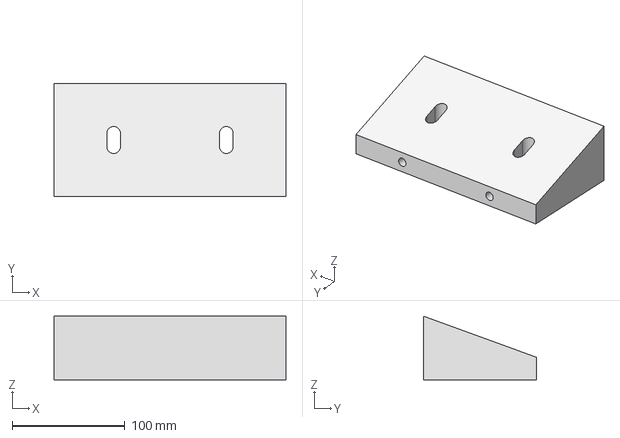
[picture p64: CAD file, 2023-06-07]
01 Hardware/99 Frame/01 Motorhalterung/STEP/Motorhalterung_BT2.1.stp
206.0 x 100.0 x 56.4 mm
