s2chhaen/USV/01 Hardware/99 Frame/02 Frame/zweite_Ebene.dxf

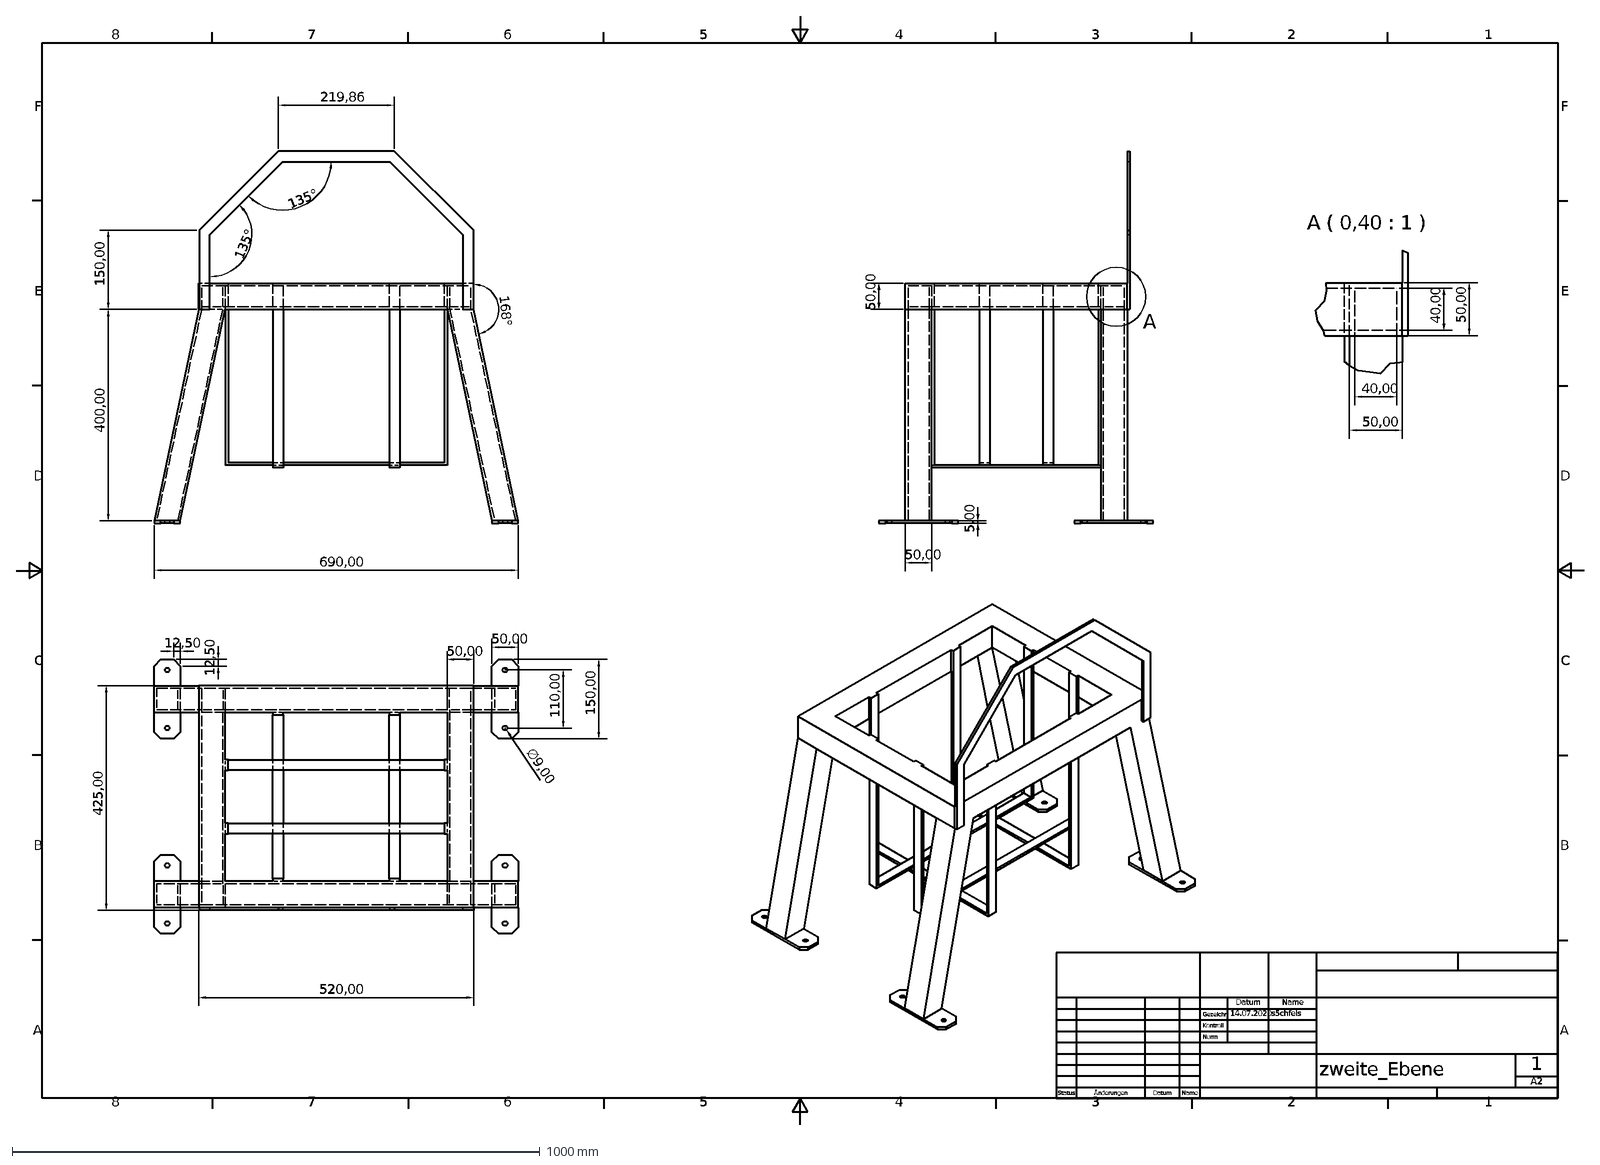
[picture p65: CAD file, 2023-06-07]
01 Hardware/99 Frame/02 Frame/zweite_Ebene.dxf
1
2
3
4
5
6
7
8
A
B
C
D
E
F
A2
zweite_Ebene
14.07.2020
s5chfeis
Status
Änderungen
Datum
Name
Gezeichn
Kontroll
Norm
50,00
110,00
∅9,00
150,00
12,50
520,00
5,00
425,00
400,00
690,00
168°
135°
219,86
A ( 0,40 : 1 )
40,00
