s2chhaen/USV/01 Hardware/02 Radar/02 Hardware/03 CAD/3D_Druck_V01.stp

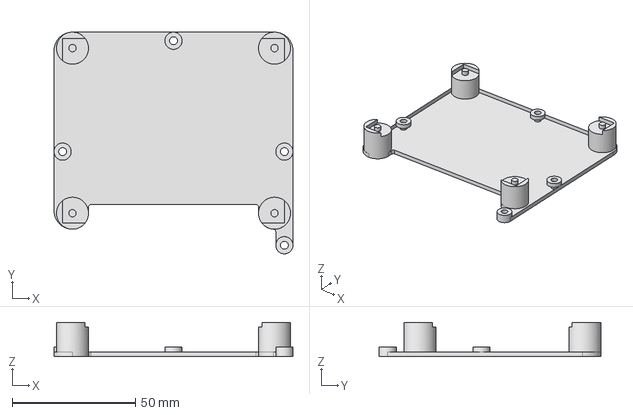
[picture p66: CAD file, 2023-06-07]
01 Hardware/02 Radar/02 Hardware/03 CAD/3D_Druck_V01.stp
97.0 x 90.0 x 14.0 mm
