s2chhaen/USV/01 Hardware/99 Frame/01 Motorhalterung/STEP/Motorhalterung_komplett.stp

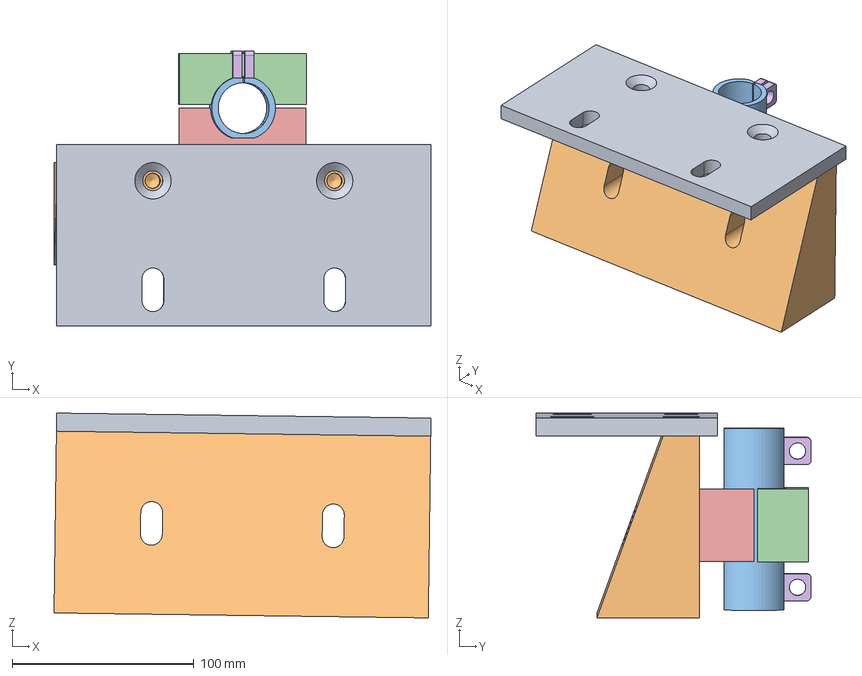
[picture p68: CAD file, 2023-06-07]
01 Hardware/99 Frame/01 Motorhalterung/STEP/Motorhalterung_komplett.stp
207.5 x 151.5 x 112.7 mm
Motorhalterung_BT1
Motorhalterung_BT2.1
Hülse
Motorhalterung_BT3
Motorhalterung_BT4
Hülse_1 x 4
