s2chhaen/USV/01 Hardware/99 Frame/02 Frame/Rahmen_neu.dxf

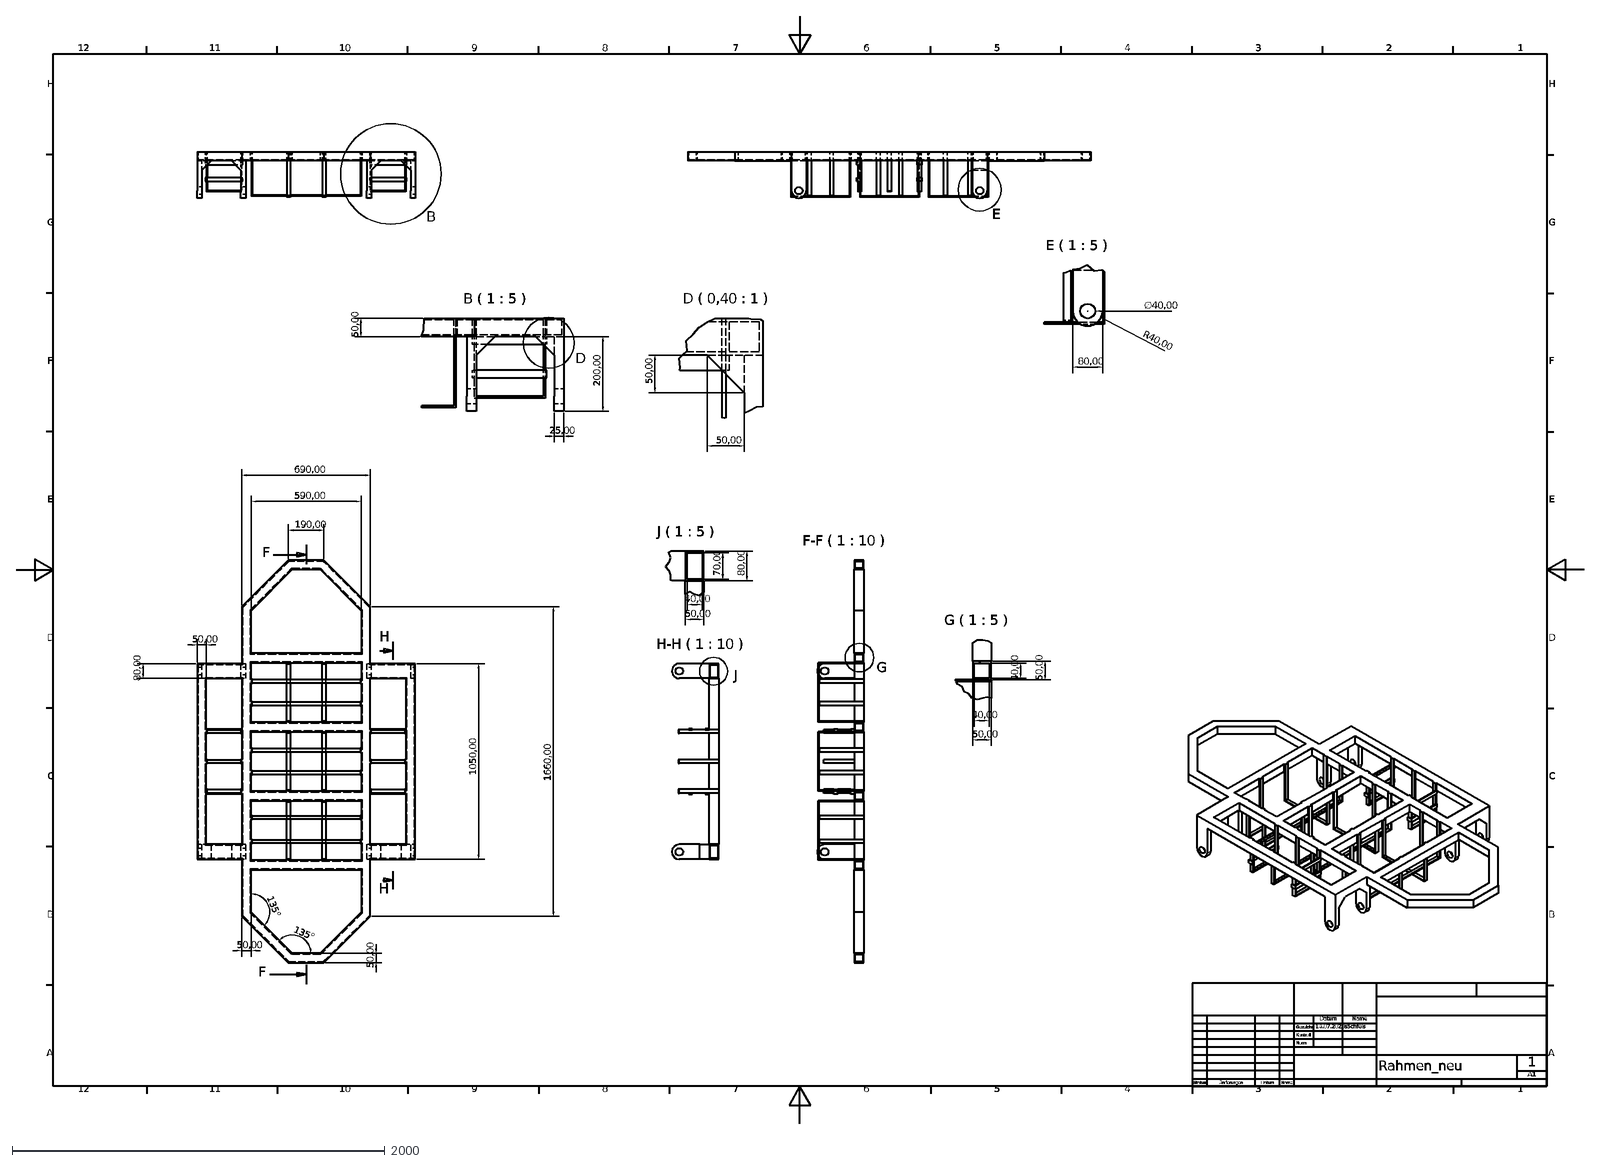
[picture p69: CAD file, 2023-06-07]
01 Hardware/99 Frame/02 Frame/Rahmen_neu.dxf
1
2
3
4
5
6
7
8
9
10
11
12
A
B
C
D
E
F
G
H
A1
Rahmen_neu
14.07.2020
s5chfeis
Status
Änderungen
Datum
Name
Gezeichn
Kontroll
Norm
B ( 1 : 5 )
D ( 0,40 : 1 )
50,00
200,00
25,00
1660,00
1050,00
690,00
190,00
135°
80,00
590,00
E ( 1 : 5 )
∅40,00
R40,00
F-F ( 1 : 10 )
G ( 1 : 5 )
40,00
H-H ( 1 : 10 )
J
J ( 1 : 5 )
70,00
