s2chhaen/USV/01 Hardware/02 Radar/02 Hardware/03 CAD/Gehäuse_und_3D-Druck-Teil.stp

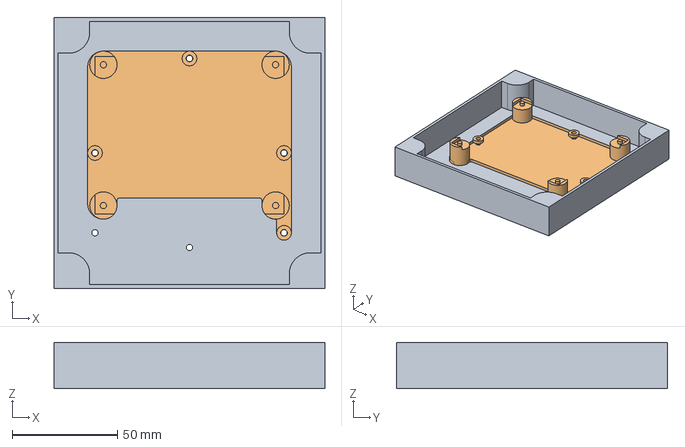
[picture p70: CAD file, 2023-06-07]
01 Hardware/02 Radar/02 Hardware/03 CAD/Gehäuse_und_3D-Druck-Teil.stp
129.0 x 129.0 x 22.0 mm
Gehäuse_Sensor_Dummy
3D_Druck_Teil_V2
