s2chhaen/USV/01 Hardware/99 Frame/01 Motorhalterung/STEP/Hülse_1.stp

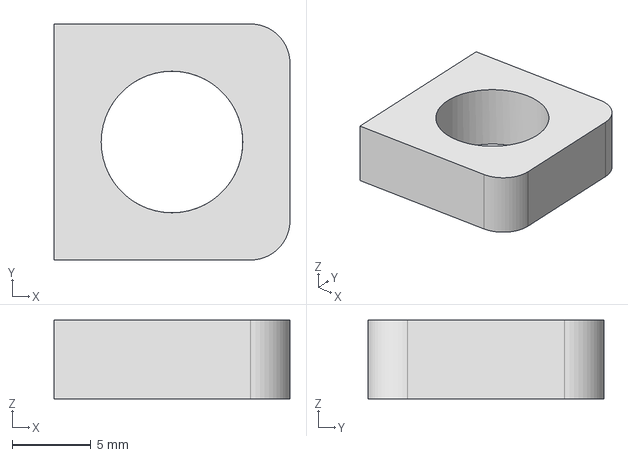
[picture p71: CAD file, 2023-06-07]
01 Hardware/99 Frame/01 Motorhalterung/STEP/Hülse_1.stp
15.0 x 15.0 x 5.00 mm
