s2chhaen/USV/01 Hardware/99 Frame/01 Motorhalterung/STEP/Motorhalterung_BG1.stp

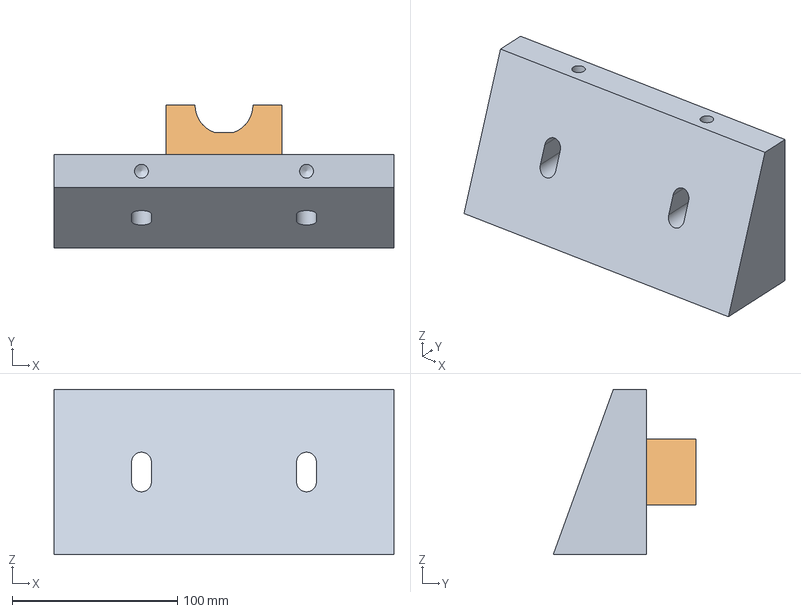
[picture p72: CAD file, 2023-06-07]
01 Hardware/99 Frame/01 Motorhalterung/STEP/Motorhalterung_BG1.stp
206.0 x 86.4 x 100.0 mm
Motorhalterung_BT2.1
Motorhalterung_BT4
