s2chhaen/USV/01 Hardware/99 Frame/01 Motorhalterung/STEP/Motorhalterung_BT1.stp

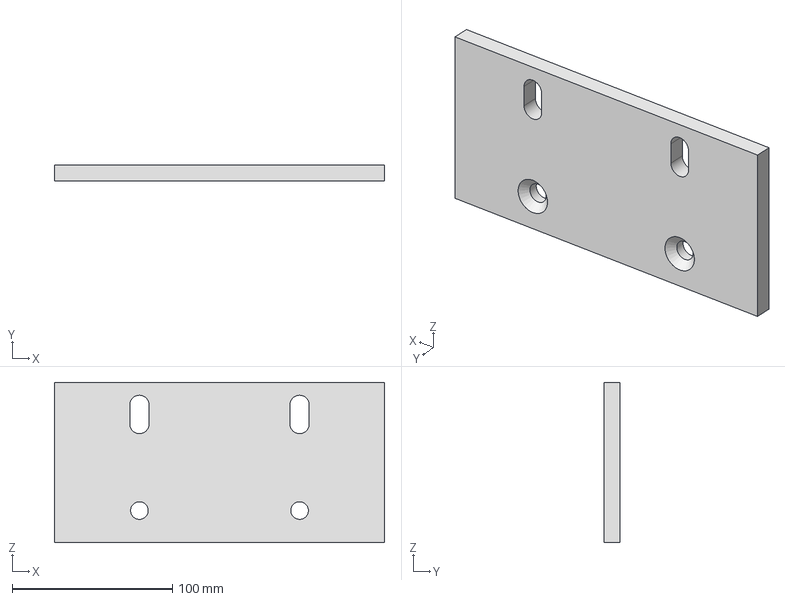
[picture p73: CAD file, 2023-06-07]
01 Hardware/99 Frame/01 Motorhalterung/STEP/Motorhalterung_BT1.stp
206.0 x 10.0 x 100.0 mm
