s2chhaen/USV/01 Hardware/99 Frame/01 Motorhalterung/STEP/Hülse.stp

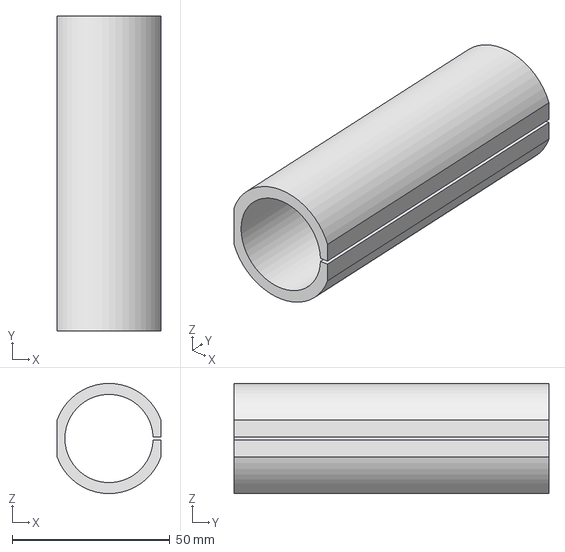
[picture p74: CAD file, 2023-06-07]
01 Hardware/99 Frame/01 Motorhalterung/STEP/Hülse.stp
33.0 x 100.0 x 35.0 mm
