s2chhaen/USV/01 Hardware/99 Frame/01 Motorhalterung/STEP/Huelse_1_komplett.stp

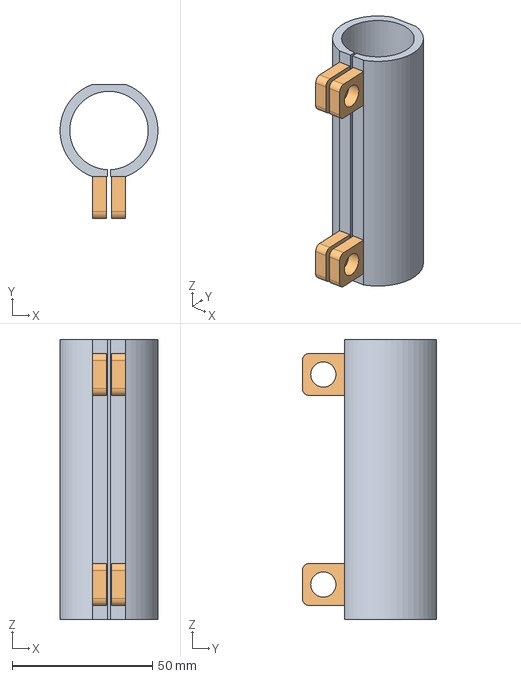
[picture p75: CAD file, 2023-06-07]
01 Hardware/99 Frame/01 Motorhalterung/STEP/Huelse_1_komplett.stp
35.0 x 48.0 x 100.0 mm
Hülse
Hülse_1 x 4
