s2chhaen/USV/(list of files, cad)

Other CAD files:
01 Hardware/02 Radar/02 Hardware/03 CAD/3D_Druck_V01.ipt
01 Hardware/02 Radar/02 Hardware/03 CAD/3D_Druck_V01.stl
01 Hardware/02 Radar/02 Hardware/03 CAD/3D_Druck_V02.ipt
01 Hardware/02 Radar/02 Hardware/03 CAD/Gehäuse_Sensor_Dummy.ipt
01 Hardware/02 Radar/02 Hardware/03 CAD/Gehäuse_und_3D-Druck-Teil.iam
01 Hardware/99 Frame/01 Motorhalterung/Hülse.ipt
01 Hardware/99 Frame/01 Motorhalterung/Motorhalterung_BT1.ipt
01 Hardware/99 Frame/01 Motorhalterung/Motorhalterung_BT2.1.ipt
01 Hardware/99 Frame/01 Motorhalterung/Motorhalterung_BT3.ipt
01 Hardware/99 Frame/01 Motorhalterung/Motorhalterung_komplett.iam
01 Hardware/99 Frame/02 Frame/Akkuboxdummy.ipt
01 Hardware/99 Frame/02 Frame/Katamaran.iam
01 Hardware/99 Frame/02 Frame/Kufe.ipt
01 Hardware/99 Frame/02 Frame/MFH-Boxdummy.ipt
01 Hardware/99 Frame/02 Frame/Rahmen_neu.ipt
01 Hardware/99 Frame/02 Frame/ZARGES-Boxdummy.ipt
01 Hardware/99 Frame/02 Frame/zweite_Ebene.ipt
