s2chhaen/USV/01 Hardware/01 Lidar/03 Software/01 source/Lidar-Algorithmus/Testdaten_Labor.csv

Alle Messwerte eines Scans formatiert | Tuesday, 1.August 2023 - 14.06.44
Nr | Radius | Winkel | X-Wert | Y-Wert | Status
1 | 67cm | 0.00° | 67cm | 0cm
2 | 67cm | 0.50° | 67cm | 1cm
3 | 71cm | 1.00° | 71cm | 1cm
4 | 73cm | 1.50° | 73cm | 2cm
5 | 72cm | 2.00° | 72cm | 3cm
6 | 76cm | 2.50° | 76cm | 3cm
7 | 77cm | 3.00° | 77cm | 4cm
8 | 79cm | 3.50° | 79cm | 5cm
9 | 81cm | 4.00° | 81cm | 6cm
10 | 8187cm | 4.50° | 8162cm | 642cm
11 | 8187cm | 5.00° | 8156cm | 714cm
12 | 8187cm | 5.50° | 8149cm | 785cm
13 | 8187cm | 6.00° | 8142cm | 856cm
14 | 8187cm | 6.50° | 8134cm | 927cm
15 | 8187cm | 7.00° | 8126cm | 998cm
16 | 8187cm | 7.50° | 8117cm | 1069cm
17 | 8187cm | 8.00° | 8107cm | 1139cm
18 | 103cm | 8.50° | 102cm | 15cm
19 | 8187cm | 9.00° | 8086cm | 1281cm
20 | 120cm | 9.50° | 118cm | 20cm
21 | 109cm | 10.00° | 107cm | 19cm
22 | 108cm | 10.50° | 106cm | 20cm
23 | 116cm | 11.00° | 114cm | 22cm
24 | 202cm | 11.50° | 198cm | 40cm
25 | 196cm | 12.00° | 192cm | 41cm
26 | 205cm | 12.50° | 200cm | 44cm
27 | 201cm | 13.00° | 196cm | 45cm
28 | 194cm | 13.50° | 189cm | 45cm
29 | 192cm | 14.00° | 186cm | 46cm
30 | 192cm | 14.50° | 186cm | 48cm
31 | 193cm | 15.00° | 186cm | 50cm
32 | 190cm | 15.50° | 183cm | 51cm
33 | 191cm | 16.00° | 184cm | 53cm
34 | 187cm | 16.50° | 179cm | 53cm
35 | 188cm | 17.00° | 180cm | 55cm
36 | 189cm | 17.50° | 180cm | 57cm
37 | 193cm | 18.00° | 184cm | 60cm
38 | 189cm | 18.50° | 179cm | 60cm
39 | 183cm | 19.00° | 173cm | 60cm
40 | 188cm | 19.50° | 177cm | 63cm
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
338 | 99cm | 168.50° | -97cm | 20cm
339 | 99cm | 169.00° | -97cm | 19cm
340 | 99cm | 169.50° | -97cm | 18cm
341 | 98cm | 170.00° | -97cm | 17cm
342 | 98cm | 170.50° | -97cm | 16cm
343 | 97cm | 171.00° | -96cm | 15cm
344 | 96cm | 171.50° | -95cm | 14cm
345 | 96cm | 172.00° | -95cm | 13cm
346 | 95cm | 172.50° | -94cm | 12cm
347 | 95cm | 173.00° | -94cm | 12cm
348 | 94cm | 173.50° | -93cm | 11cm
349 | 94cm | 174.00° | -93cm | 10cm
350 | 93cm | 174.50° | -93cm | 9cm
351 | 94cm | 175.00° | -94cm | 8cm
352 | 92cm | 175.50° | -92cm | 7cm
353 | 91cm | 176.00° | -91cm | 6cm
354 | 90cm | 176.50° | -90cm | 5cm
355 | 8191cm | 177.00° | -8180cm | 429cm
356 | 8191cm | 177.50° | -8183cm | 357cm
357 | 8191cm | 178.00° | -8186cm | 286cm
358 | 8191cm | 178.50° | -8188cm | 214cm
359 | 8191cm | 179.00° | -8190cm | 143cm
360 | 8191cm | 179.50° | -8191cm | 71cm
361 | 8191cm | 180.00° | -8191cm | 0cm
Alle Messwerte eines Scans formatiert | Tuesday, 1.August 2023 - 14.06.53
Nr | Radius | Winkel | X-Wert | Y-Wert | Status
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
