s2chhaen/USV/01 Hardware/06 energy_management/02 Hardware/01 Stromsensor/Kalibrierfunktion CYHCT-L20K-U60A-42.xlsx

Stommesswiderstand | 219.39
Windungen | 5 | Oszilloskop
Strom Elektronische Last / A | Strom Sensor Eingang / A | Spannung Strommesswiderstand / mV | std / mV | Res / (mV/div) | Strom Sensor Ausgang / mA
0.000 | 0 | 2.07 | 25 | 50 | 0.009
0.100 | 0.5 | 40.3 | 4.6 | 50 | 0.184
0.200 | 1 | 84.4 | 2.6 | 50 | 0.385
0.300 | 1.5 | 128.12 | 3.5 | 50 | 0.584
0.400 | 2 | 172.94 | 1.14 | 50 | 0.788
0.500 | 2.5 | 216 | 0.91 | 50 | 0.985
0.600 | 3 | 260 | 0.65 | 50 | 1.185
0.600 | 3 | 258 | 0.65 | 100 | 1.176
0.700 | 3.5 | 302 | 0.55 | 100 | 1.377
0.800 | 4 | 346 | 0.57 | 100 | 1.577
0.900 | 4.5 | 389.9 | 0.5 | 100 | 1.777
1.000 | 5 | 433 | 0.45 | 100 | 1.974
1.200 | 6 | 520.8 | 0.77 | 100 | 2.374
1.200 | 6 | 519.9 | 0.8 | 200 | 2.370
1.400 | 7 | 607.98 | 0.03 | 200 | 2.771
1.600 | 8 | 697.86 | 0.66 | 200 | 3.181
1.800 | 9 | 786 | 0.42 | 200 | 3.583
2.000 | 10 | 874.92 | 0.51 | 200 | 3.988
2.200 | 11 | 967 | 0.15 | 200 | 4.408
2.400 | 12 | 1052.2 | 0.26 | 200 | 4.796
2.400 | 12 | 1016.3 | 0.45 | 500 | 4.632
2.800 | 14 | 1195.4 | 0.44 | 500 | 5.449
3.200 | 16 | 1370 | 0.071 | 500 | 6.245
3.600 | 18 | 1550 | 0.052 | 500 | 7.065
4.000 | 20 | 1729 | 1.14 | 500 | 7.881
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
