s2chhaen/USV/01 Hardware/98 Slave_Default/00 docs/USV_RS485_Slave_PinLayout.pdf

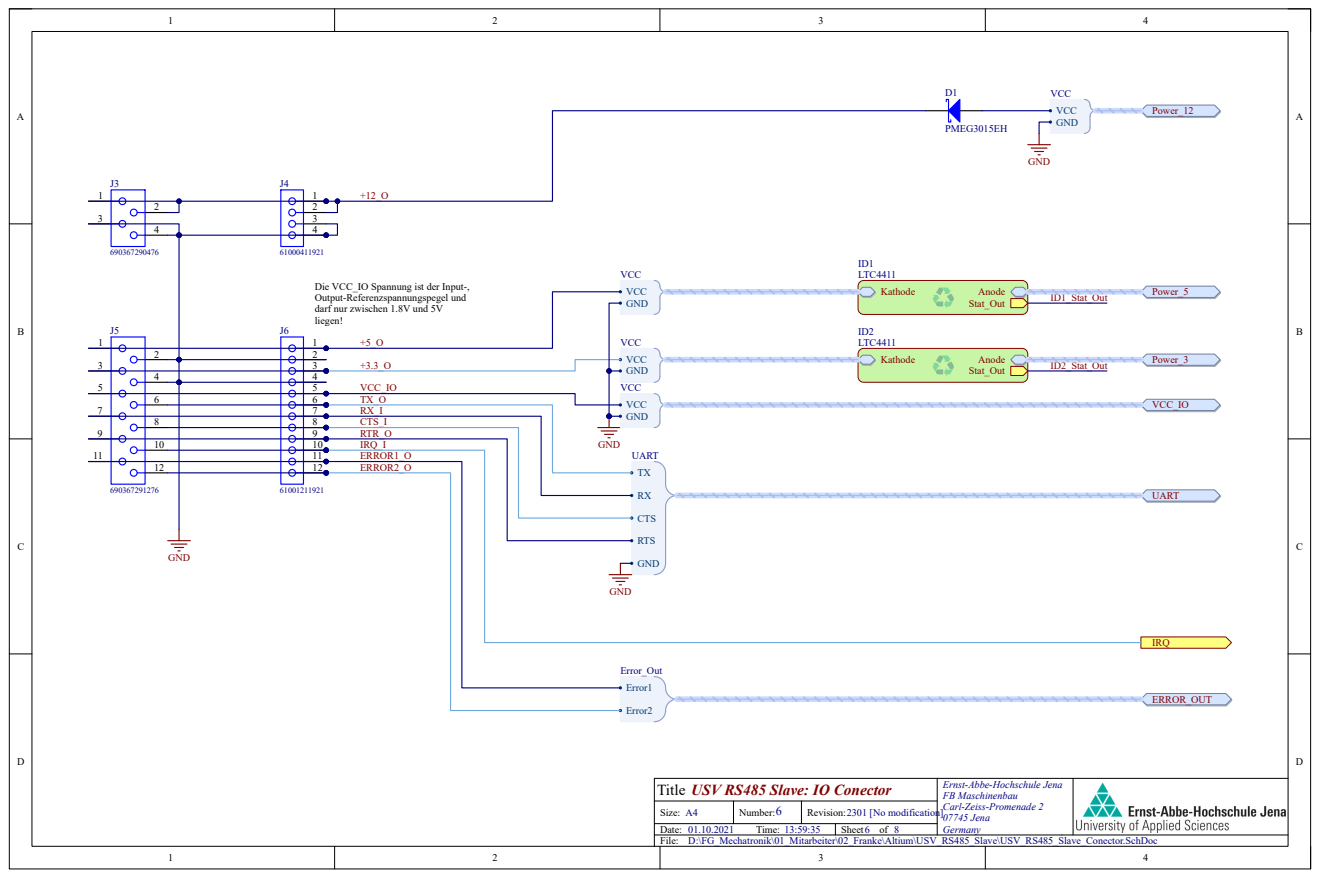
[picture p94: page 1]
Germany; 2301 [No modification]; D:\FG_Mechatronik\01_Mitarbeiter\02_Franke\Altium\USV_RS485_Slave\USV_RS485_Slave_Conector.SchDoc; Title; Size:; Number:; Date: File:; Revision:; Time:; Sheet; Power_3; Power_5; Power_12; Kathode; Anode; Stat_Out; ID2 LTC4411; ID1 LTC4411; GND; VCC GND; VCC; TX_O RX_I CTS_I RTR_O; VCC_IO; IRQ; ERROR_OUT; RTS; CTS; UART; Error1; Error2; Error_Out; ERROR1_O ERROR2_O; IRQ_I; PMEG3015EH; ID1_Stat_Out; ID2_Stat_Out

Die VCC_IO Spannung ist der Input-,
Output-Referenzspannungspegel und
darf nur zwischen 1.8V und 5V
liegen!

USV RS485 Slave: IO Conector

Ernst-Abbe-Hochschule Jena
FB Maschinenbau
Carl-Zeiss-Promenade 2
07745 Jena
