s2chhaen/USV/01 Hardware/05 IMU/02 Hardware/00 docs/USV-BG-002-SP-A.pdf

A

A

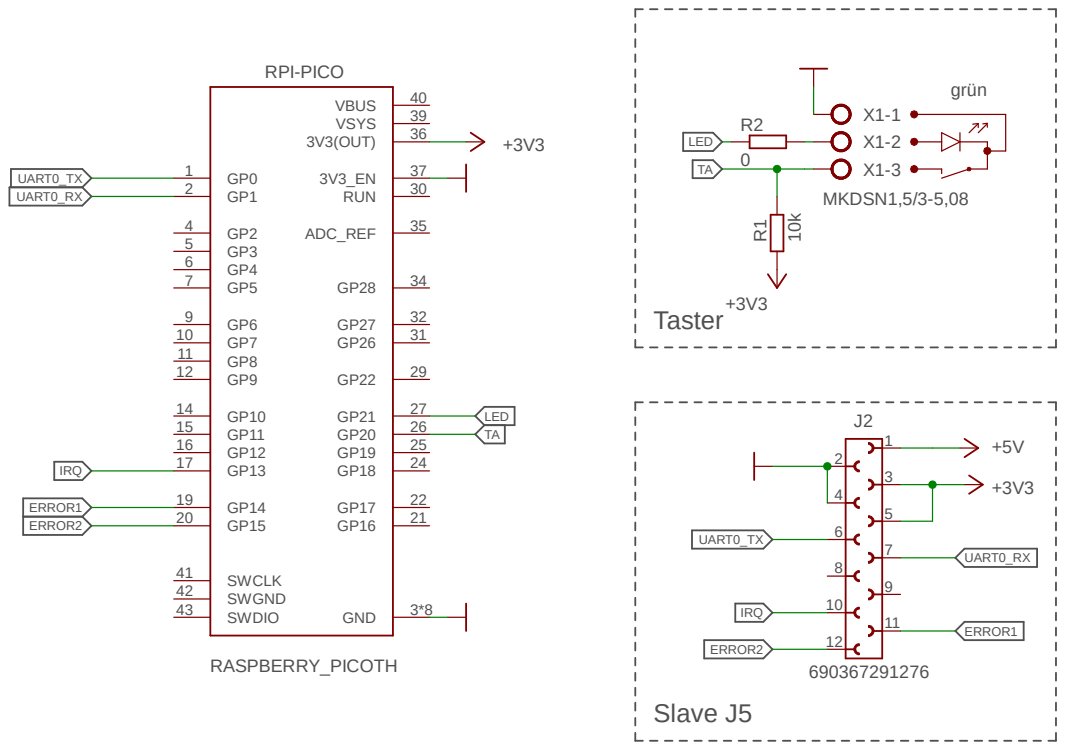
[picture p103: page 1]
Taster; IMU-Unit; USV Slave; J.Grabow; Slave J5; grün; RASPBERRY_PICOTH; MKDSN1,5/3-5,08; RUN; ADC_REF; 3V3(OUT); GND; VSYS; 39 VBUS; SWDIO 43; SWGND 42; SWCLK 41; RPI-PICO; IRQ; ERROR1; ERROR2; UART0_TX; UART0_RX; LED; Sheet:; USV-BG-002-SP-A
