s2chhaen/USV/01 Hardware/01 Lidar/02 Hardware/00 doc/Uni_Seriell.pdf

# 12 J4⁻SLAVE

# IRQ ERR¹

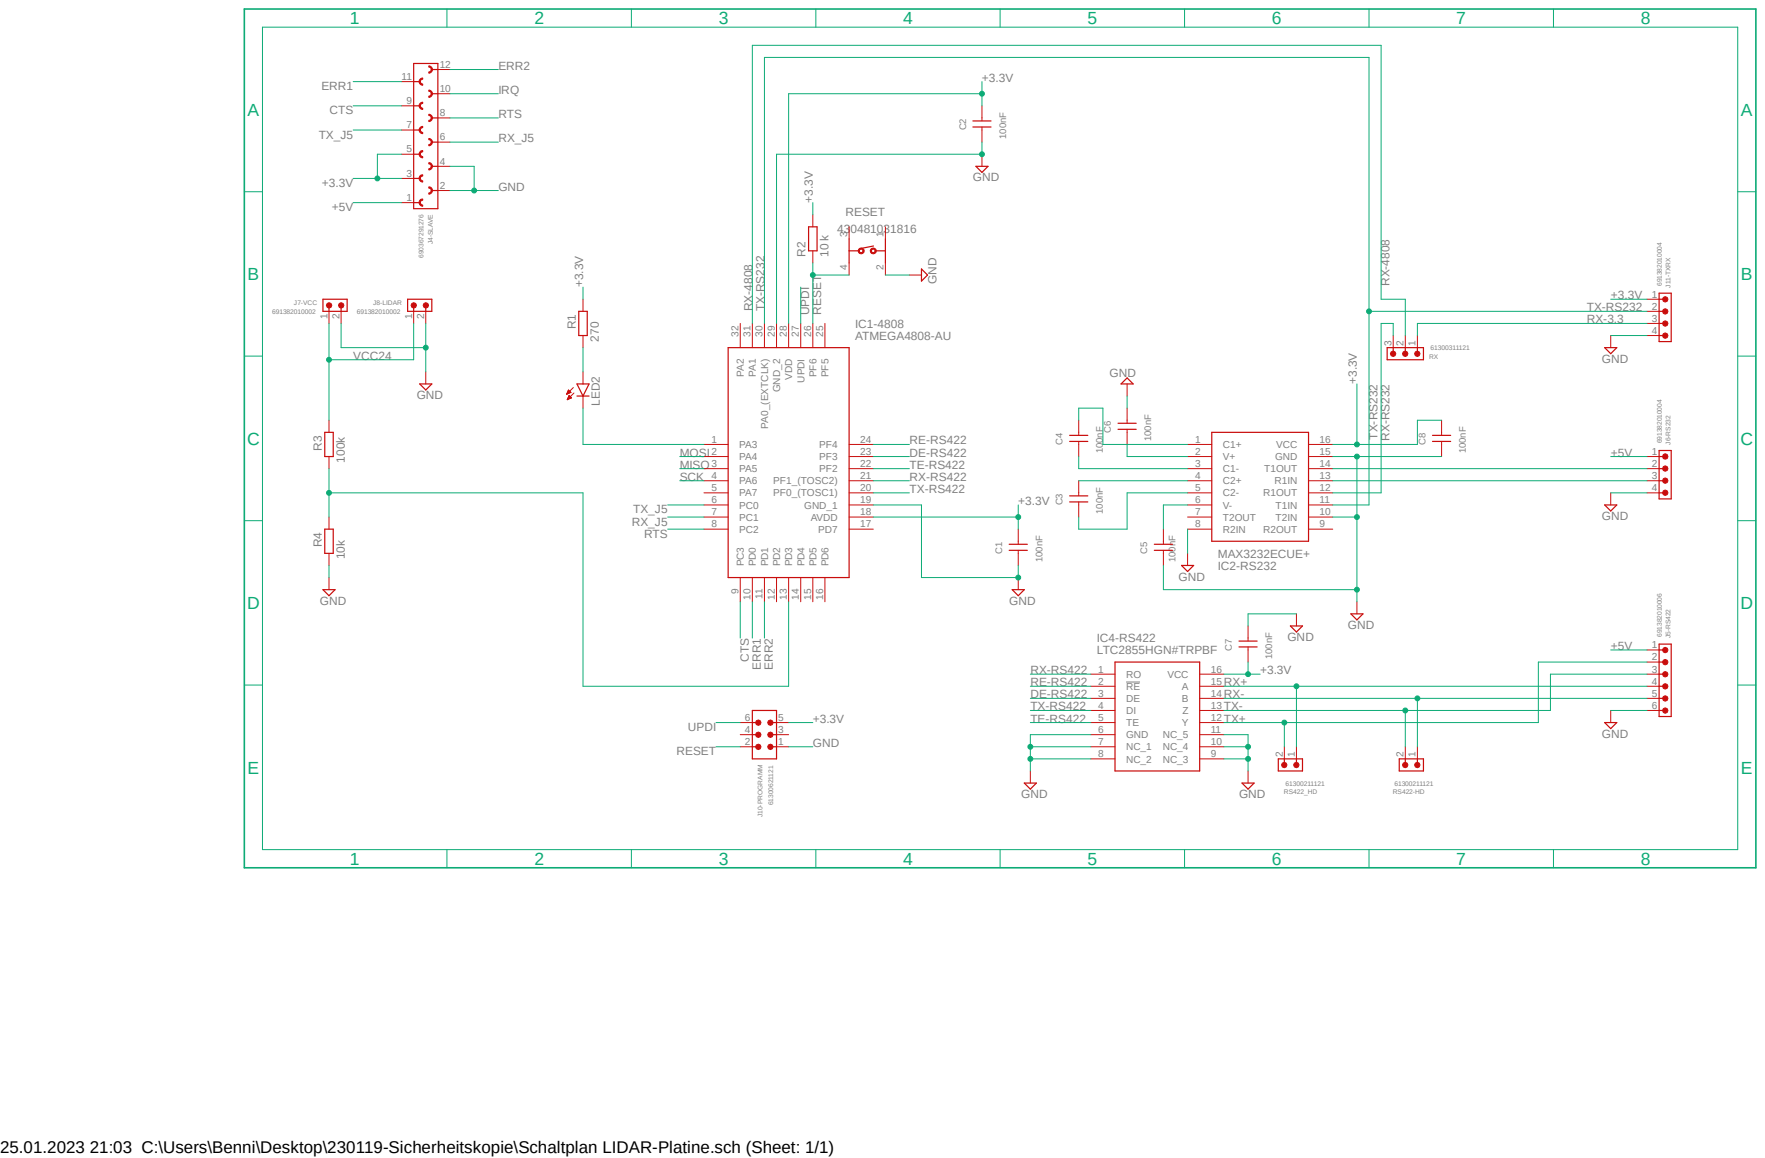
[picture p104: page 1]
25.01.2023 21:03 C:\Users\Benni\Desktop\230119-Sicherheitskopie\Schaltplan LIDAR-Platine.sch (Sheet: 1/1) ²⁷⁰; ATMEGA4808-AU; MAX3232ECUE+; GND; GND 10 k; GND 100nF 100nF; GND ⁶⁹⁰³⁶⁷²⁹¹²⁷⁶; LTC2855HGN#TRPBF; 61300311121 GND 100k 10k; PC³; IC2-RS232 R² LED²; 2 RESET; 5 J10⁻PROGRAMM; J8-LIDAR; J7-VCC; 4 J11⁻TXRX; 6 J5⁻RS⁴²²; 4 J6⁻RS²³²; GND 6; VCC; ERR²; ERR2; RTS; CTS; ERR1; MISO SCK; RESET; MOSI; RX⁻⁴⁸⁰⁸ RX⁻⁴⁸⁰⁸; TX⁻RS²³² TX⁻RS²³²; TE-RS422 UPDI; UPDI; RX⁻RS²³²; VCC24

9 PD0 10 PD1 11 PD2 12 PD3 13 PD4 14 PD5 15 PD6 16 PF4 24 PF3 23 PF2 22 PF1_(TOSC2) 21 PF0_(TOSC1) 20 GND_1 19 AVDD 18 PD7 17 PA2 32 PA1 31 PA0_(EXTCLK) 30 GND_2 29 VDD 28 UPDI 27 PF6 26 PF5 25R1IC1-4808 C1+ 1 V+ 2 C1- 3 C2+ 4 C2- 5 V- 6 T2OUT 7 R2IN 8 VCC 16 GND 15 T1OUT 14 R1IN 13 R1OUT 12 T1IN 11 T2IN 10 R2OUT 9
