s2chhaen/USV/00 doc/00 Bussystem/Buskonzept_Übersicht.pdf

## Slave

## Slave

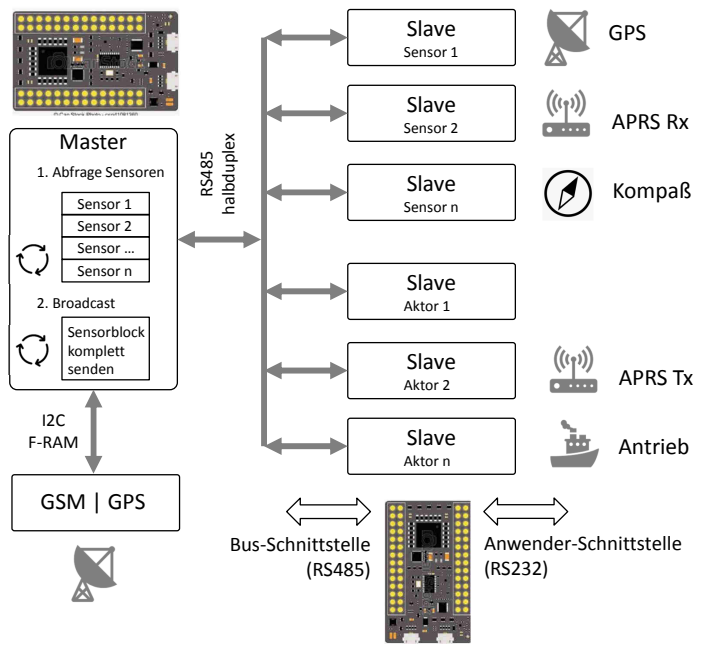
[picture p105: page 1]
Master; 1. Abfrage Sensoren; Sensor 1; Sensor 2; Sensor …; Sensor n; Sensorblock komplett senden; 2. Broadcast; Slave; Aktor 1; Aktor 2; Aktor n; halbduplex; GPS; Antrieb; APRS Tx; APRS Rx; Kompaß; Bus-Schnittstelle (RS485); Anwender-Schnittstelle (RS232); GSM | GPS; I2C F-RAM

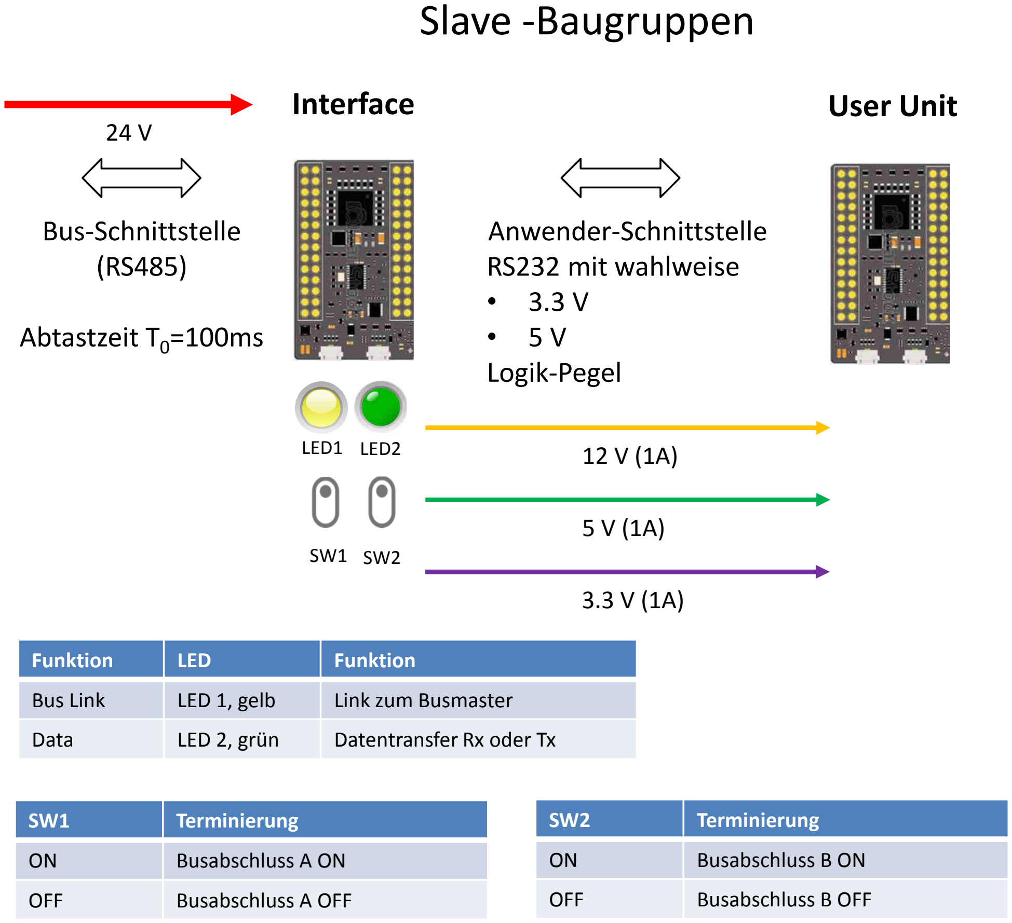
[picture p106: figure]
Slave -Baugruppen; Bus-Schnittstelle (RS485); Abtastzeit T0=100ms; Anwender-Schnittstelle RS232 mit wahlweise • 3.3 V • 5 V Logik-Pegel; Funktion; LED; Bus Link; LED 1, gelb; Link zum Busmaster; Data; LED 2, grün; Datentransfer Rx oder Tx; Interface; User Unit; Terminierung; Busabschluss A ON; OFF; Busabschluss A OFF; Busabschluss B ON; Busabschluss B OFF; LED1 LED2

# Master -Baugruppe

## Master

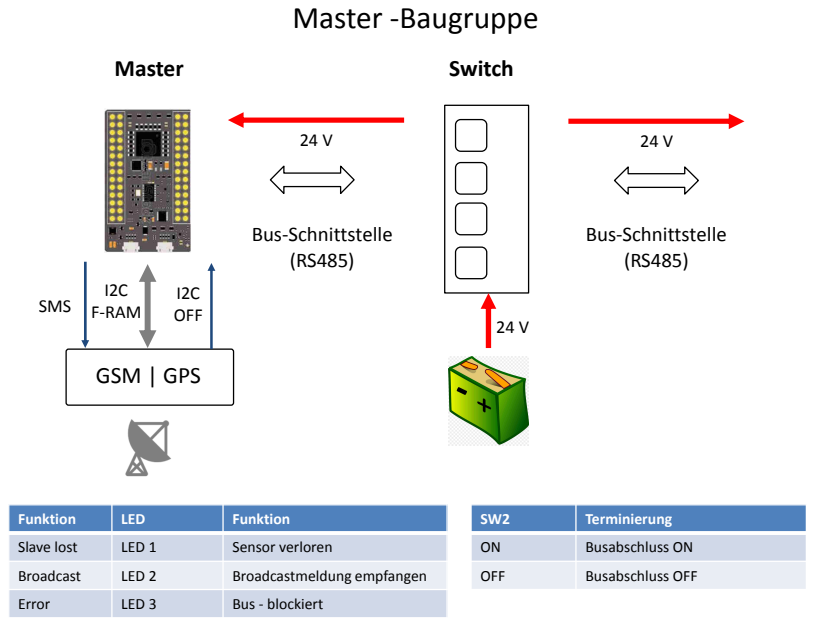
[picture p107: page 3]
Bus-Schnittstelle (RS485); Switch; I2C F-RAM; GSM | GPS; I2C OFF SMS; Funktion; LED; Slave lost; LED 1; Sensor verloren; Broadcast; LED 2; Broadcastmeldung empfangen; Error; LED 3; Bus - blockiert; Terminierung; Busabschluss ON; OFF; Busabschluss OFF

# Bus - Topologie

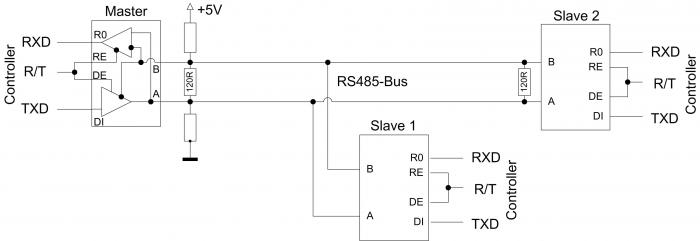
[picture p108: figure]
