s2chhaen/USV/01 Hardware/09 RC Control/00 doc/RX6R ACCST-Manual-1.pdf

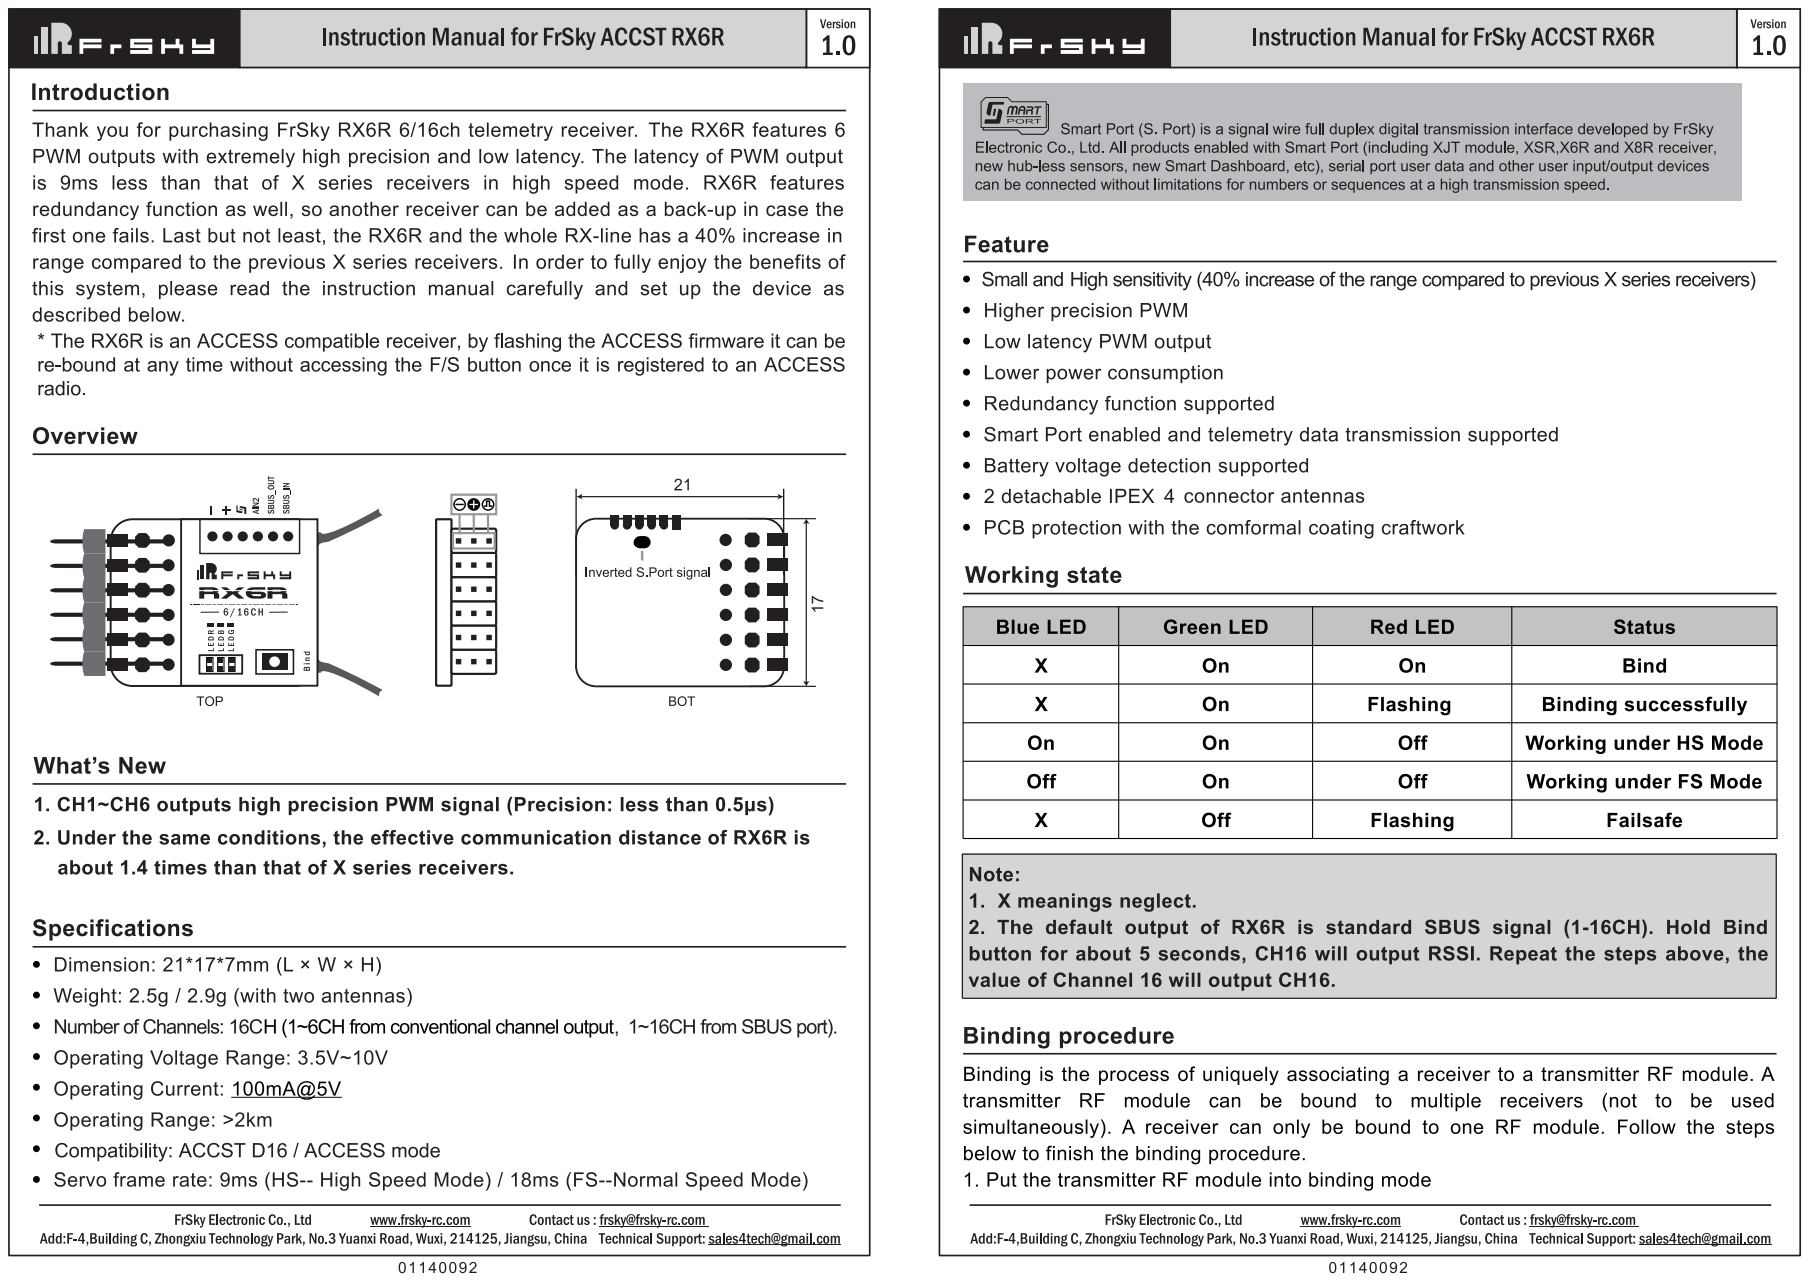
[picture p109: page 1]

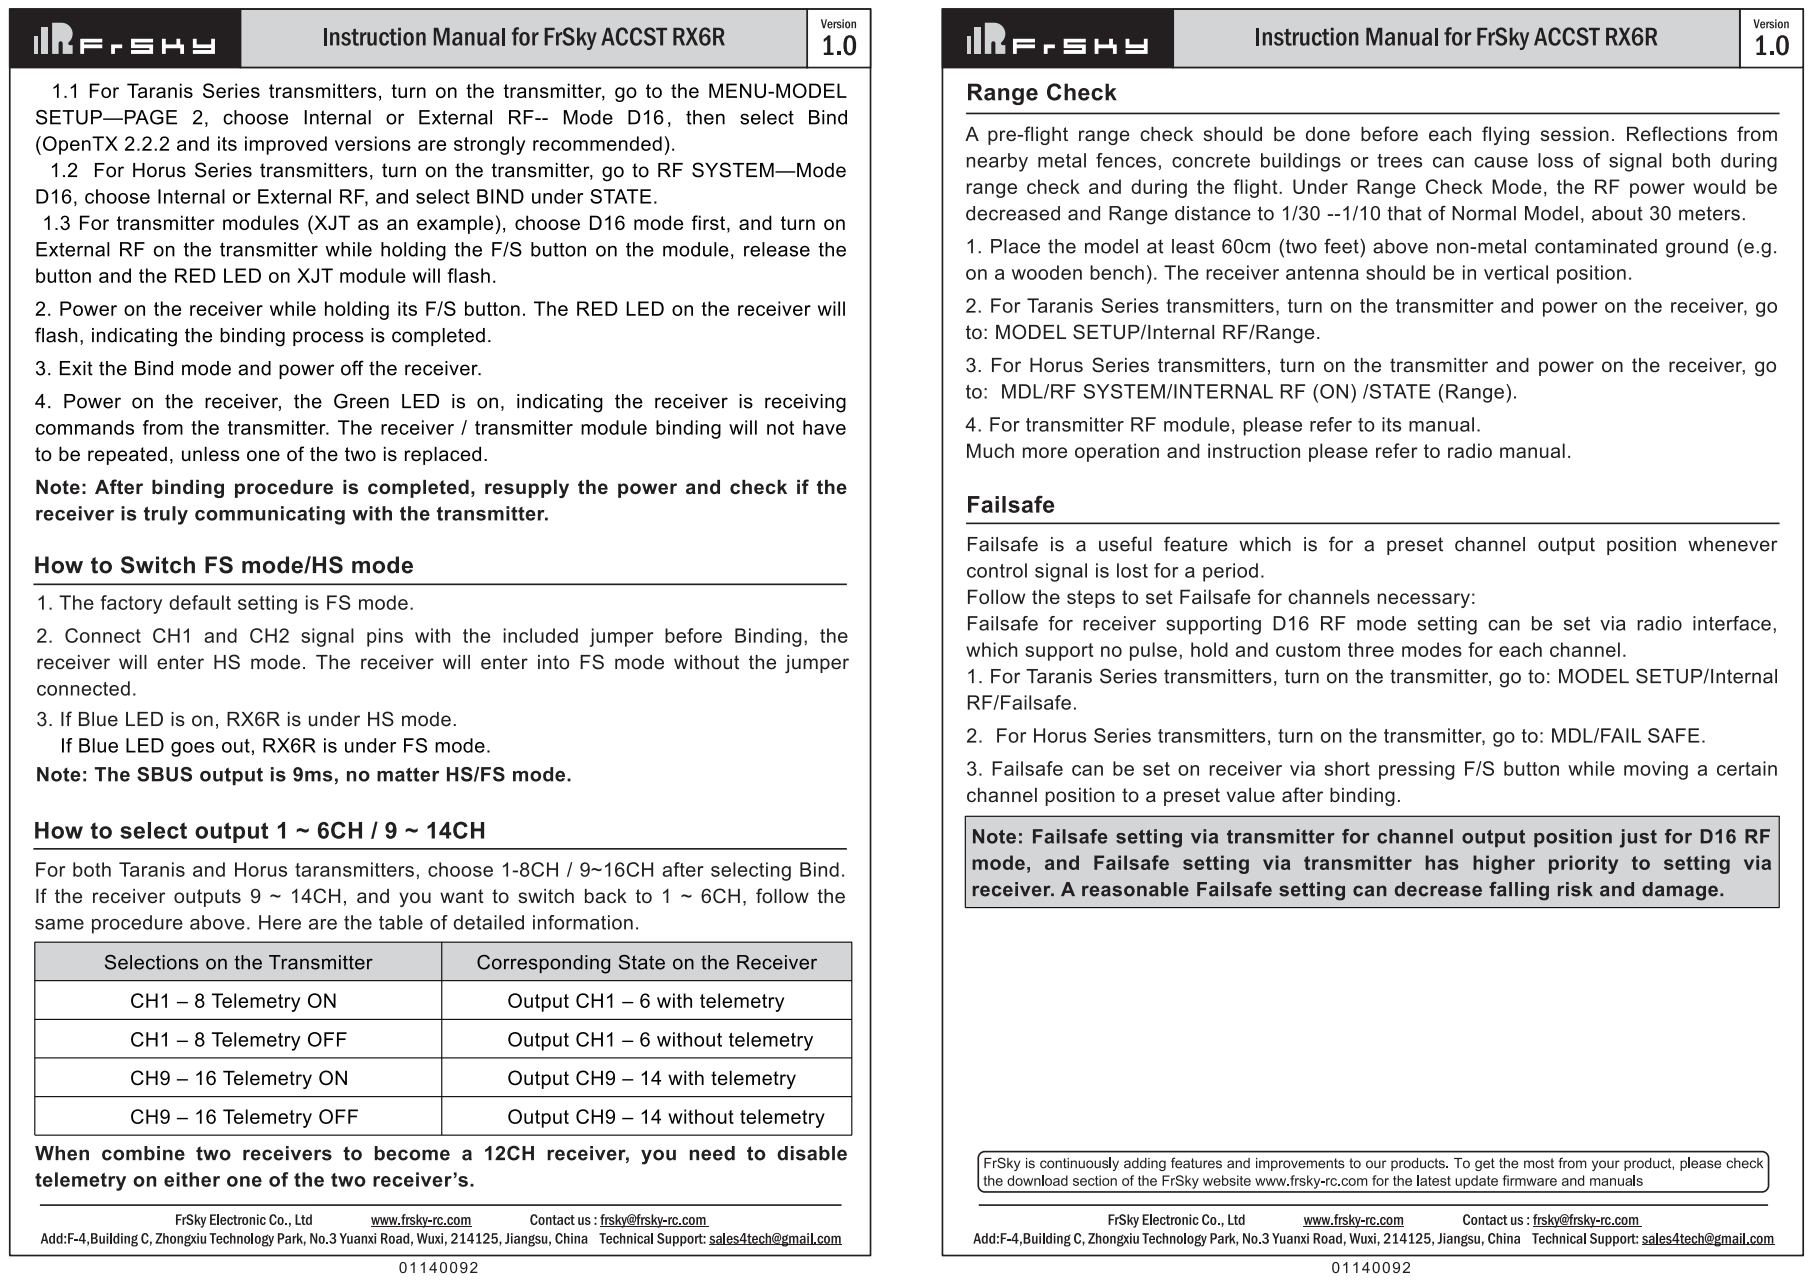
[picture p110: page 2]
