s2chhaen/USV/01 Hardware/08 control/01 Hardware/Control_Sheet.pdf

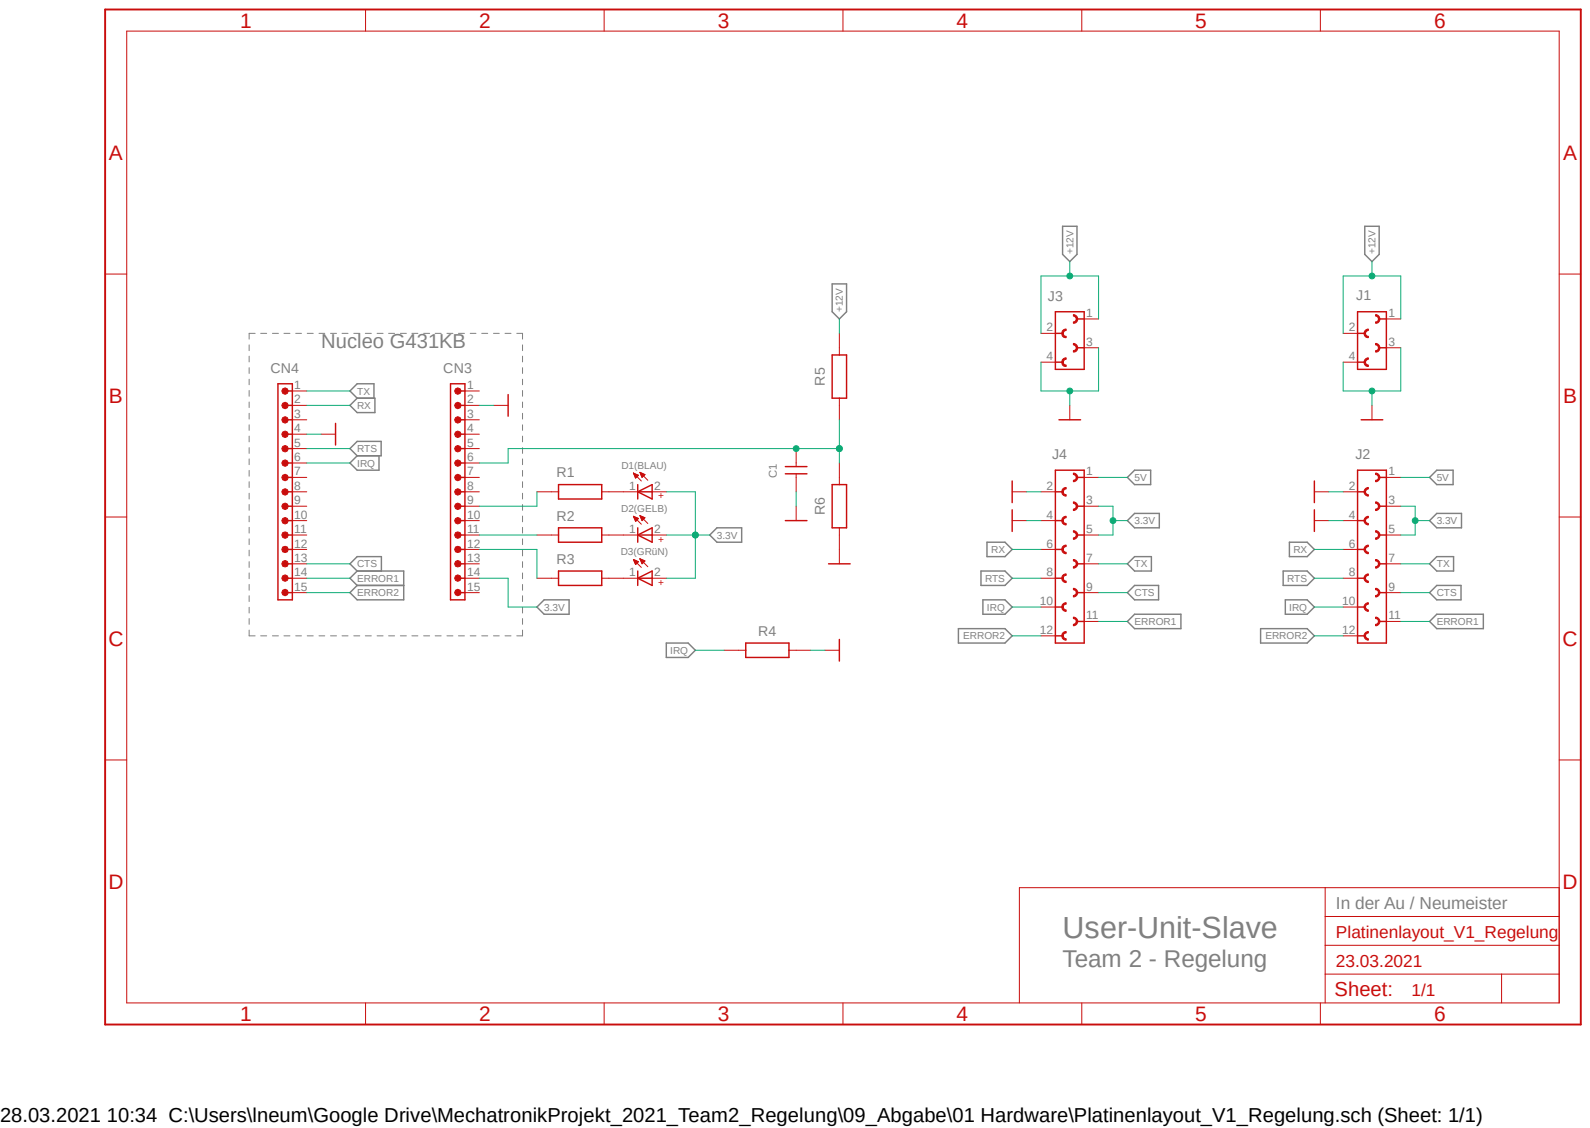
[picture p112: page 1]

28.03.2021 10:34 C:\Users\lneum\Google Drive\MechatronikProjekt_2021_Team2_Regelung\09_Abgabe\01 Hardware\Platinenlayout_V1_Regelung.sch (Sheet: 1/1)
