s2chhaen/USV/01 Hardware/98 Slave_Default/00 docs/USV_RS485_Slave.pdf

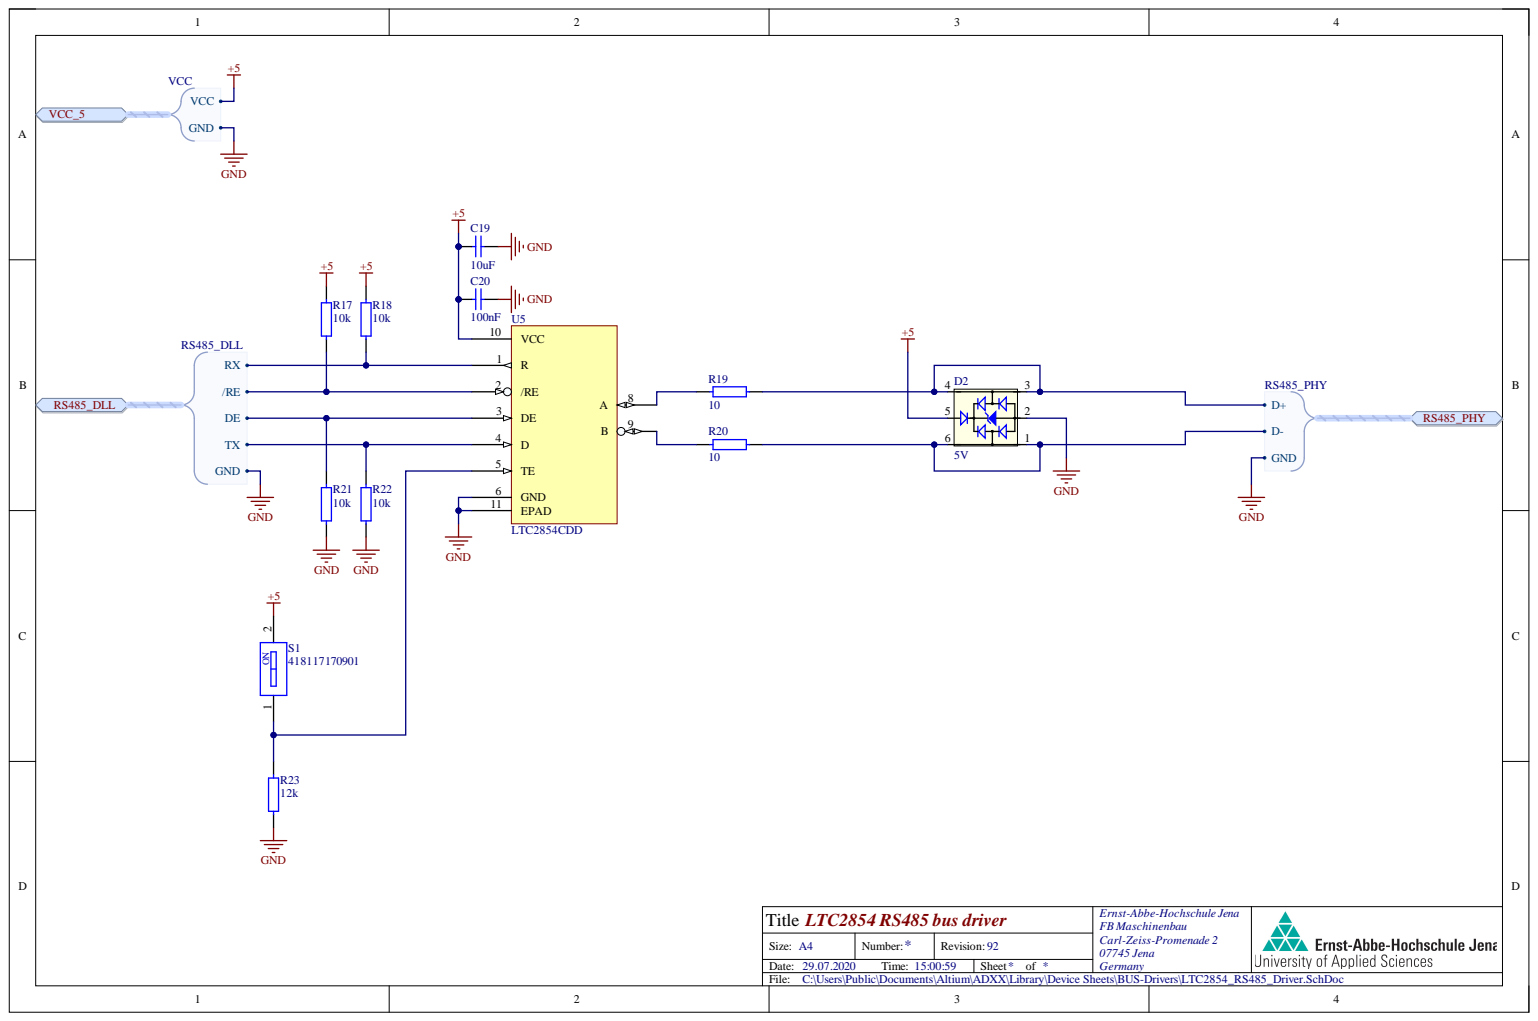
[picture p113: page 1]

1 1

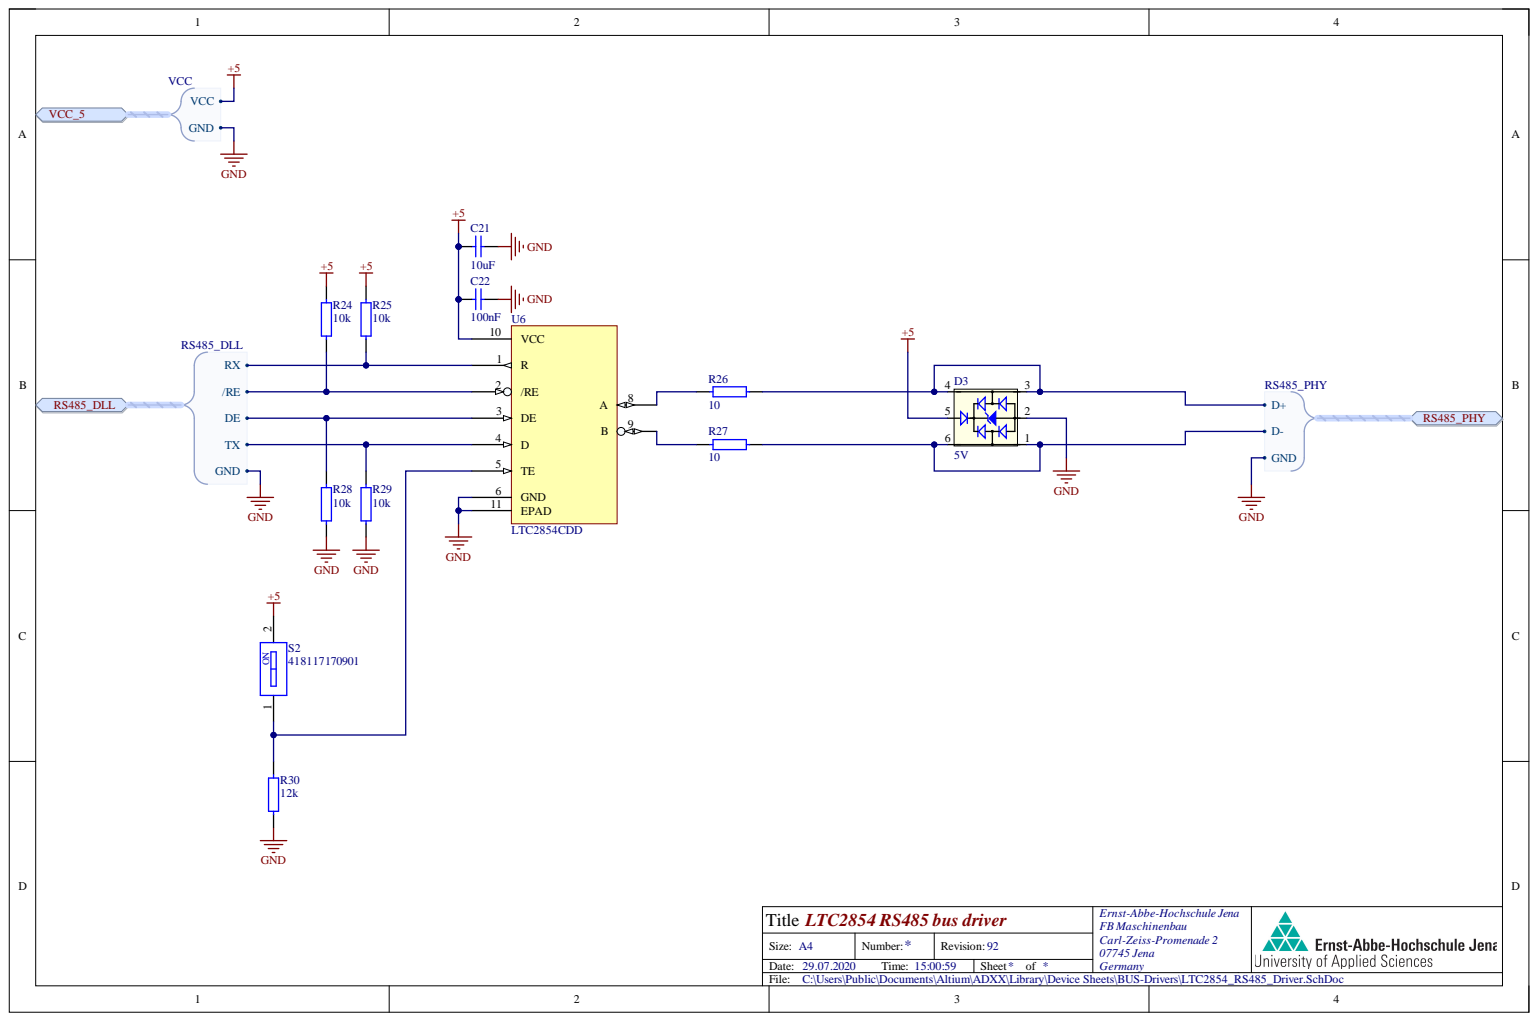
[picture p114: page 2]

1 1

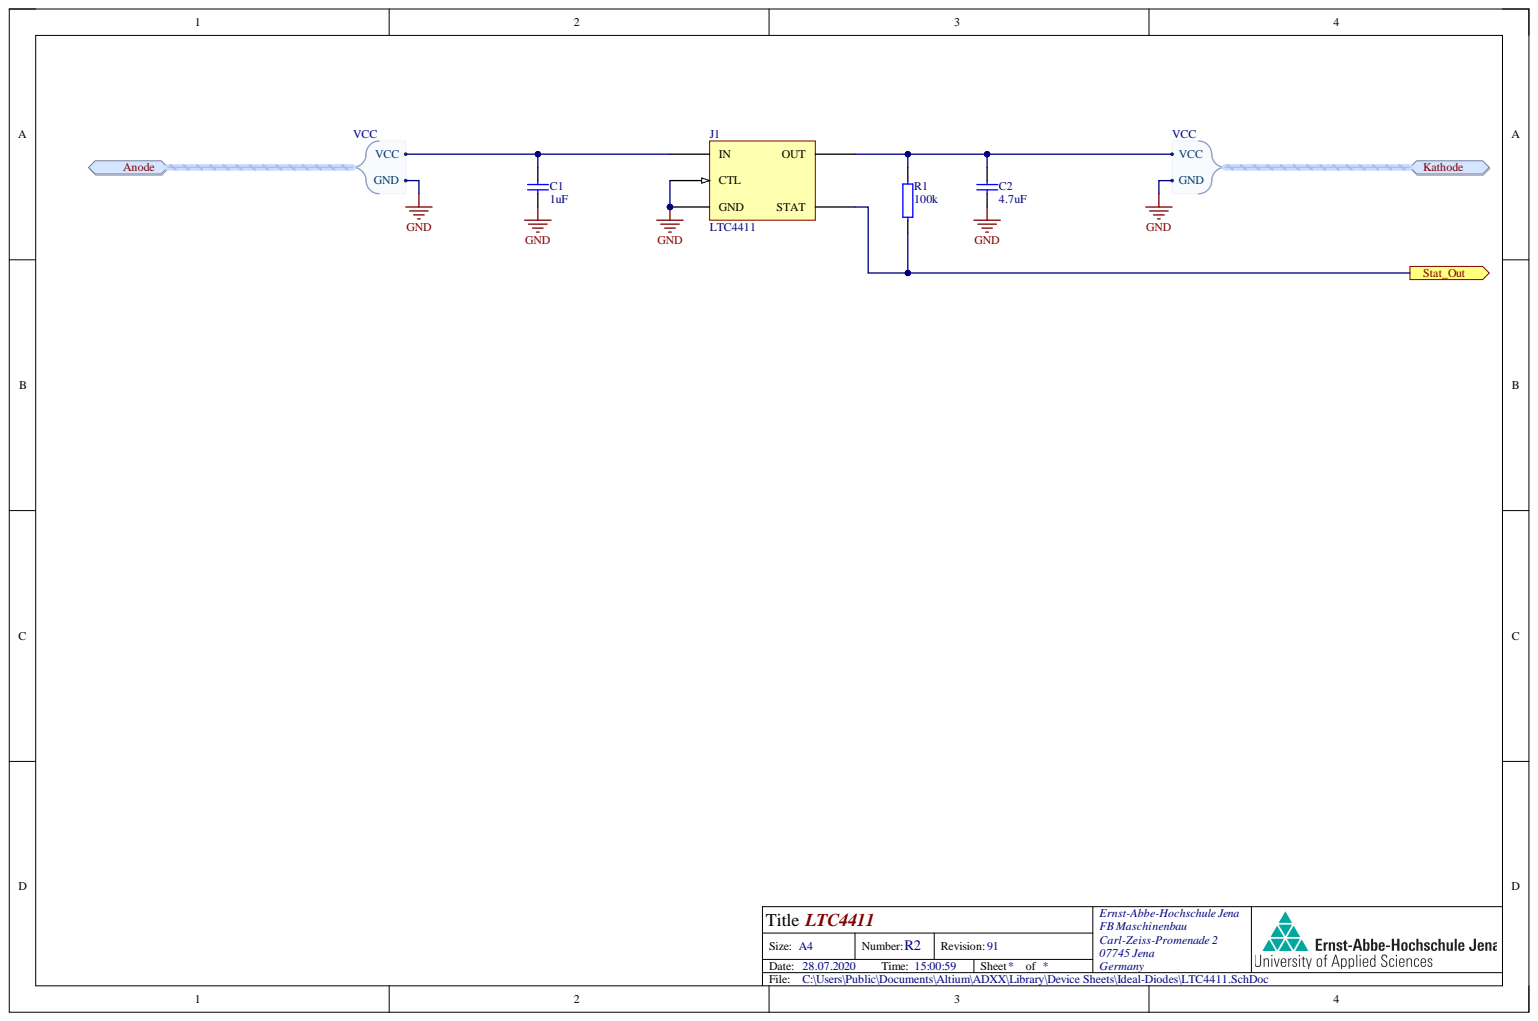
[picture p115: page 3]

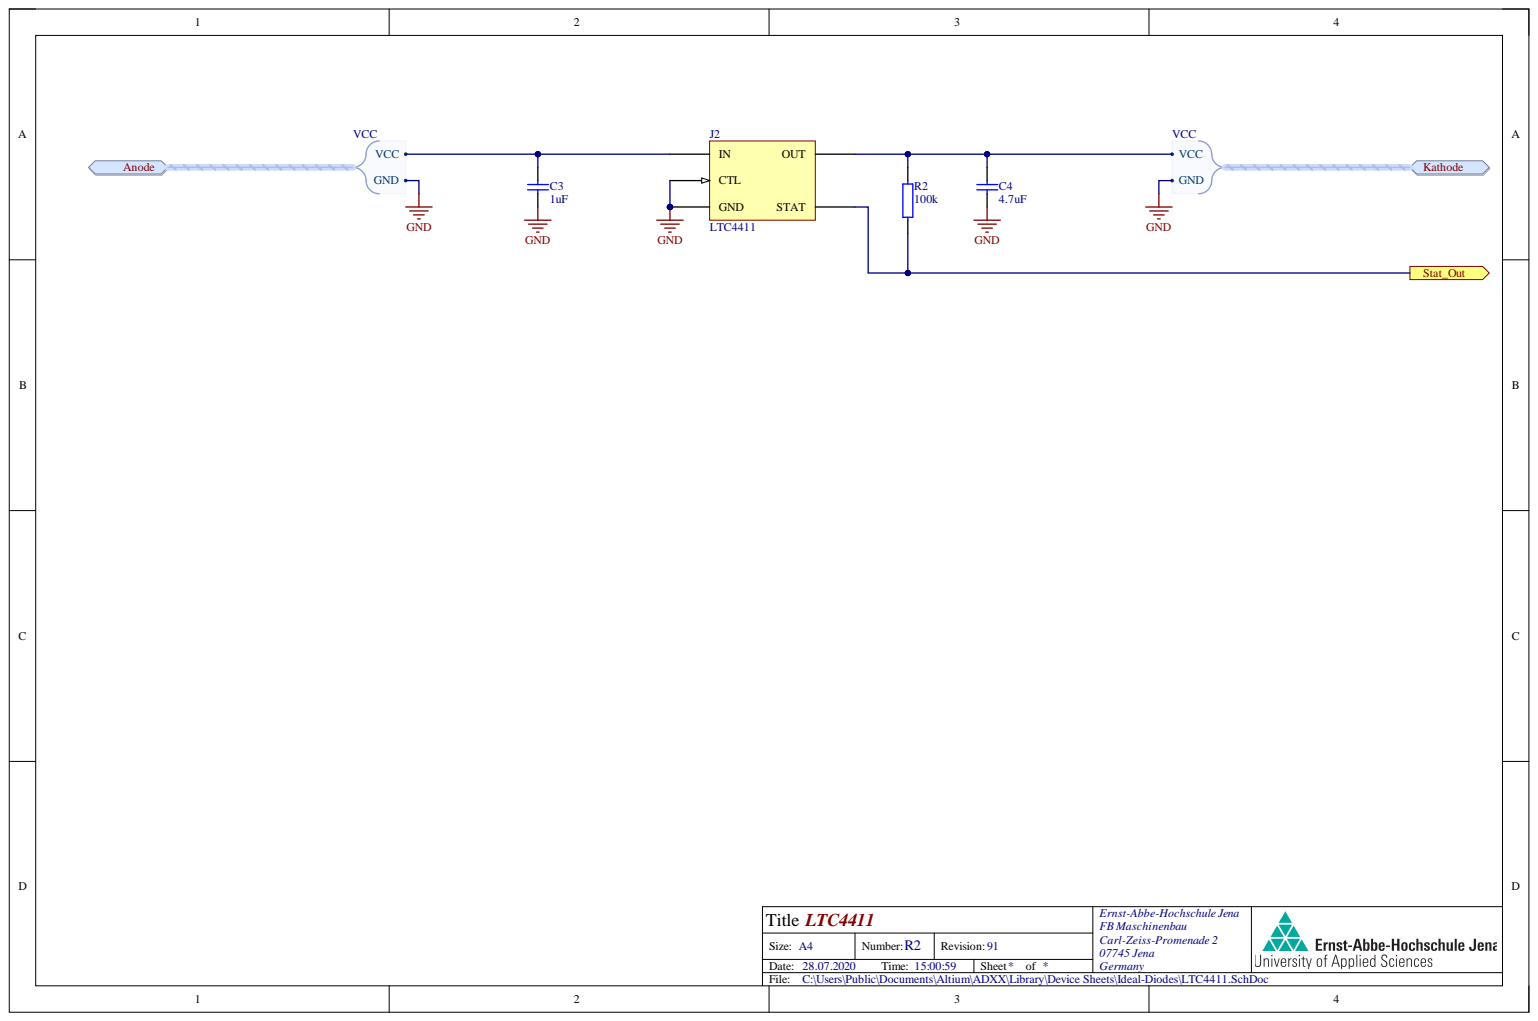
[picture p116: page 4]

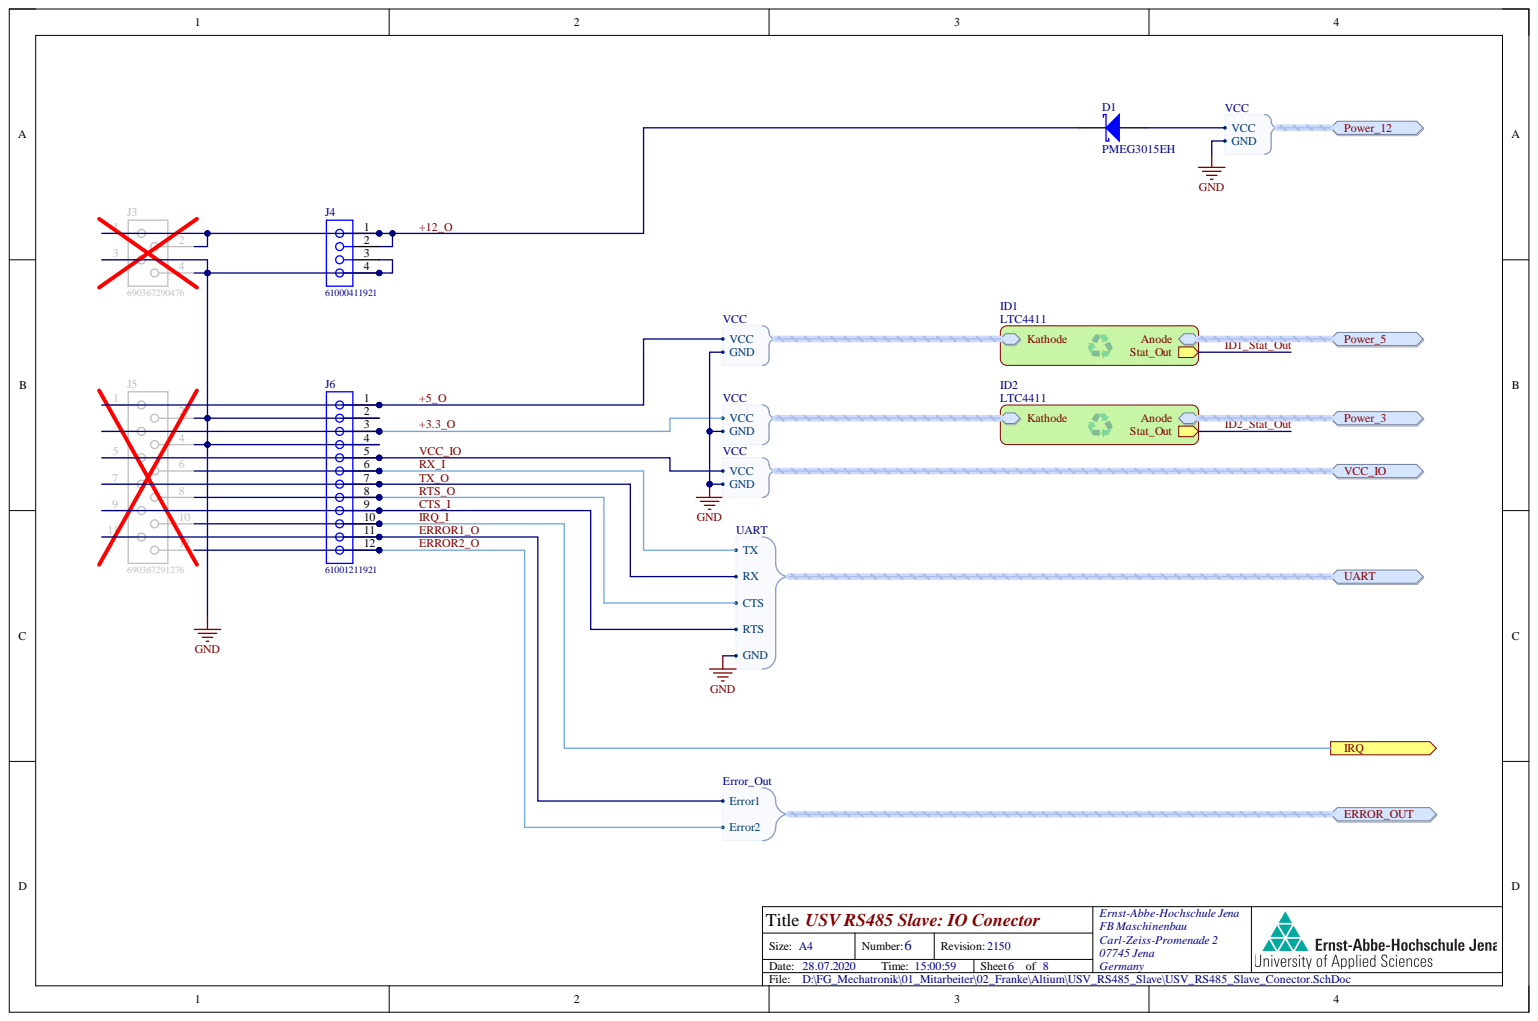
[picture p117: page 5]

VCC GND VCC

4 | | 2134567891 | VCC_ I O

9 | | 8 | | | CTS_ I

1 1 | | 1 0 | | 0 1 1 | IRQ _ I G N D ERROR1 _ O

7 6 | | 2 1 | ERROR2 _ O

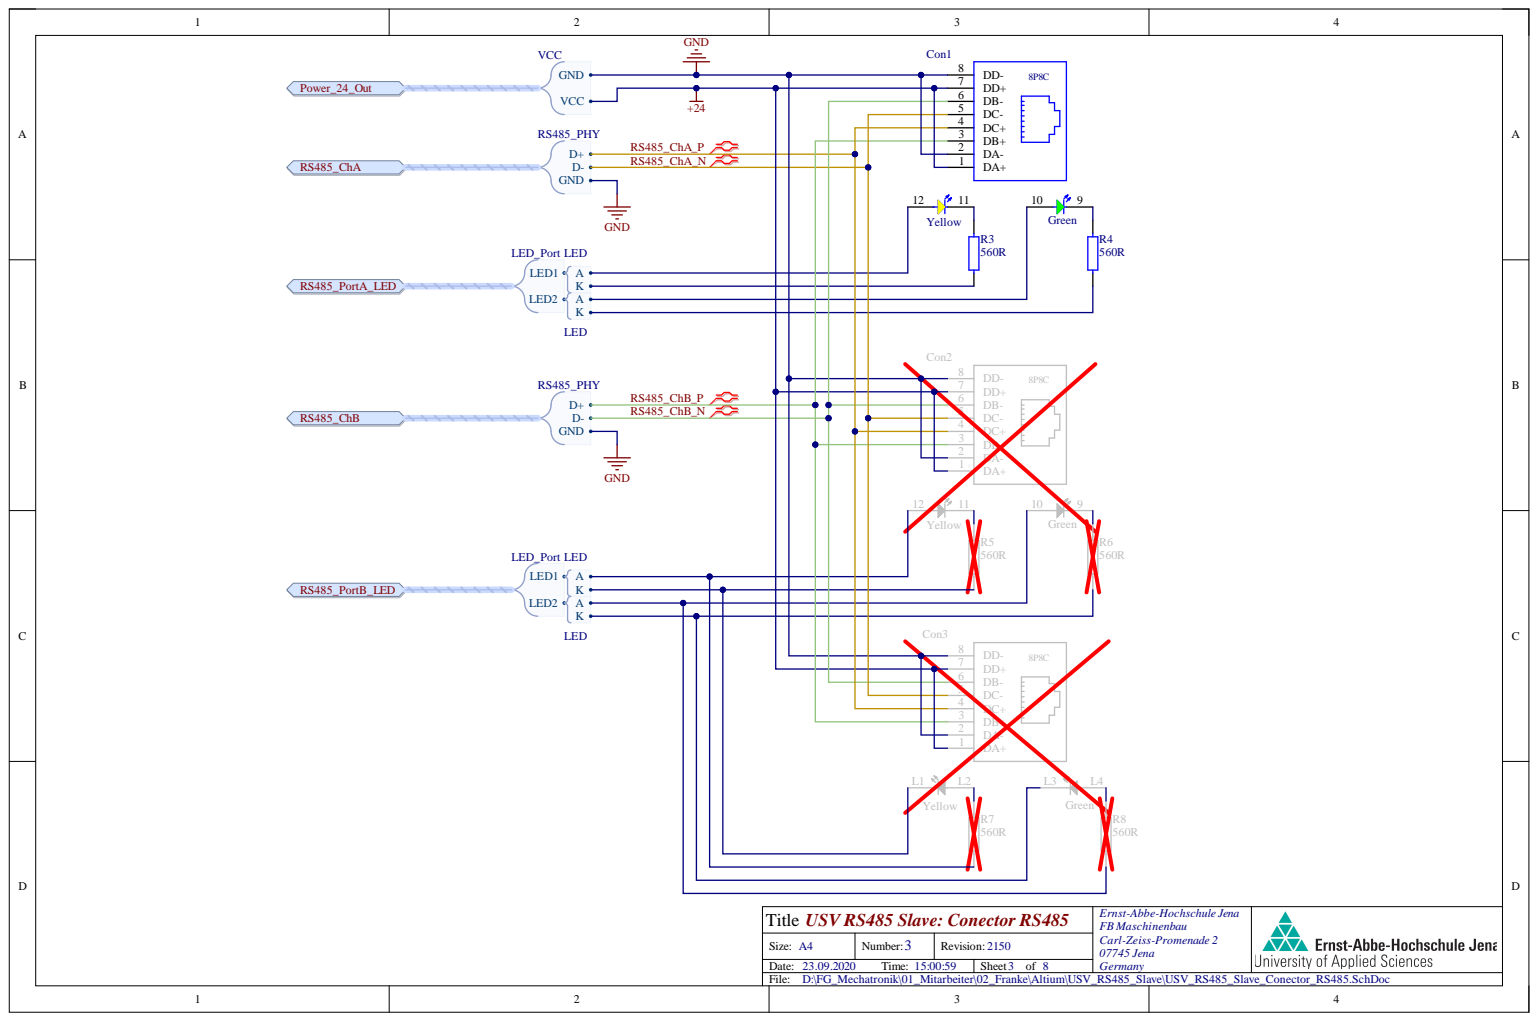
[picture p118: page 6]

Ernst-Abbe-Hochschule Jena
FB Maschinenbau
Carl-Zeiss-Promenade 2
07745 Jena

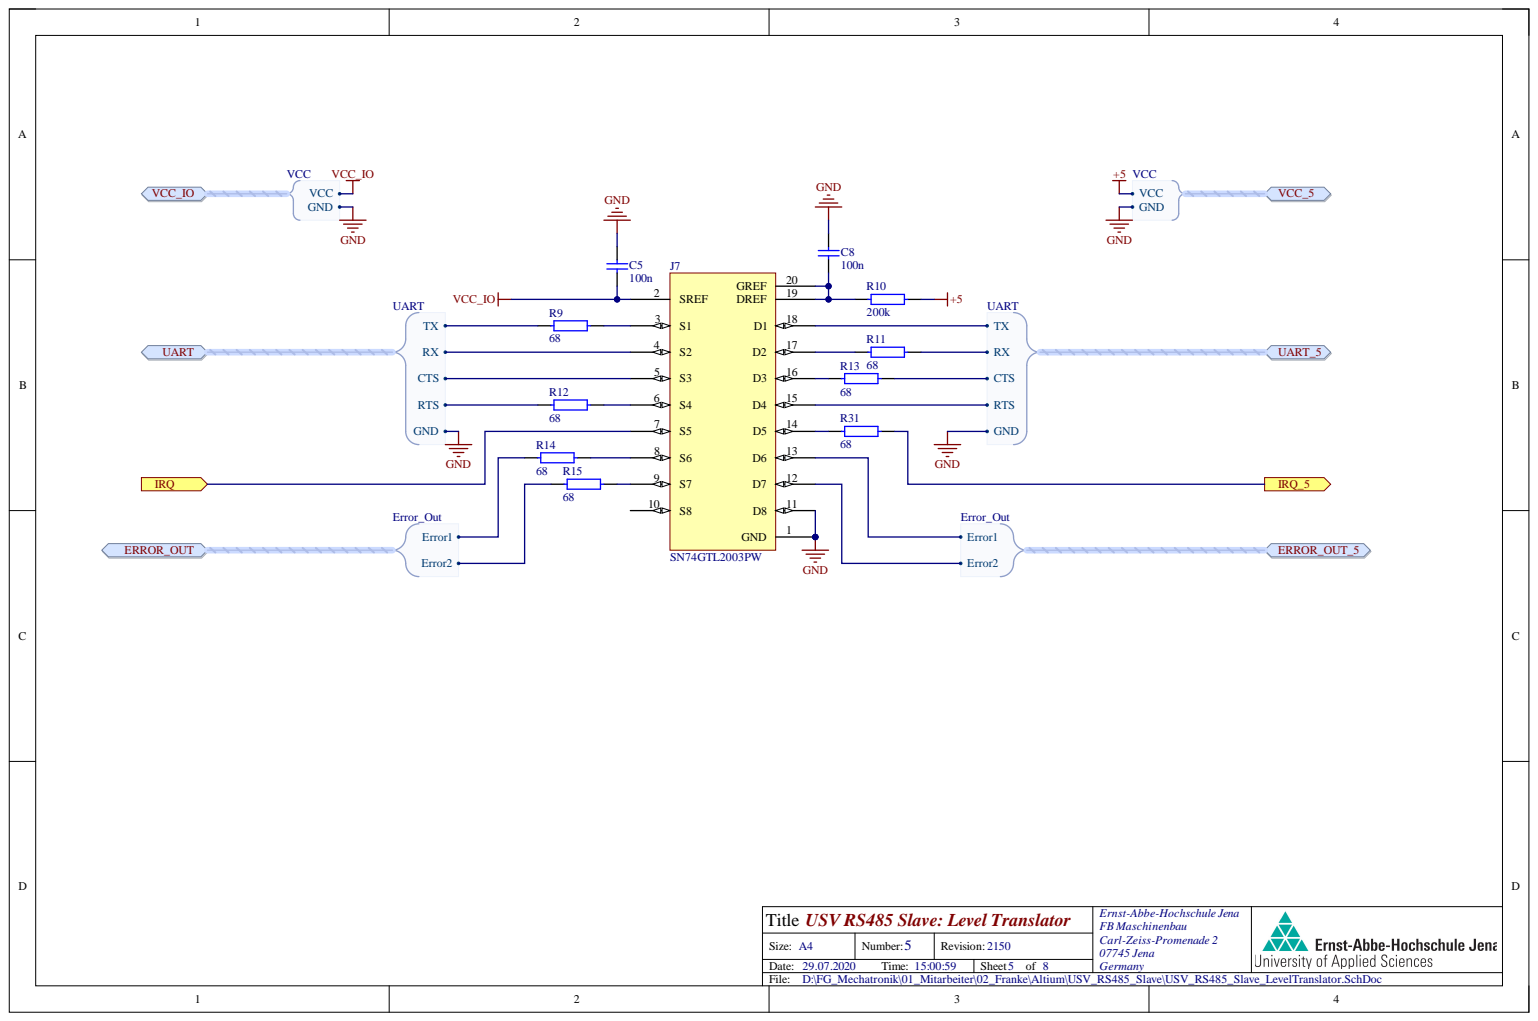
[picture p119: page 7]

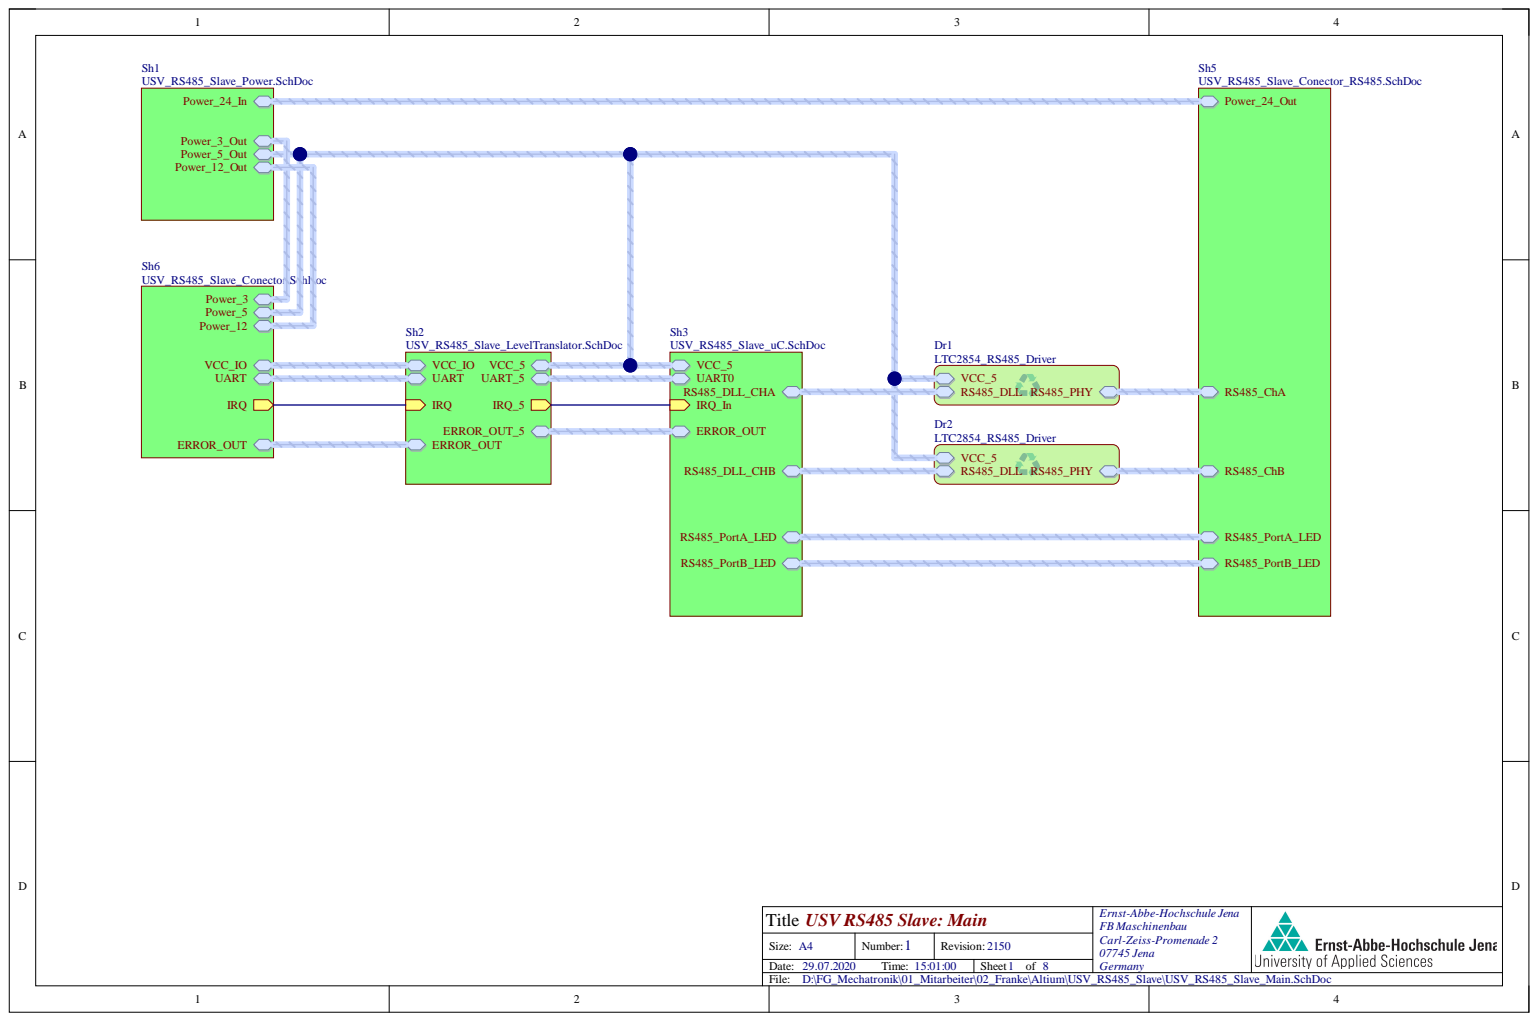
[picture p120: page 8]

Ernst-Abbe-Hochschule Jena
FB Maschinenbau
Carl-Zeiss-Promenade 2
07745 Jena

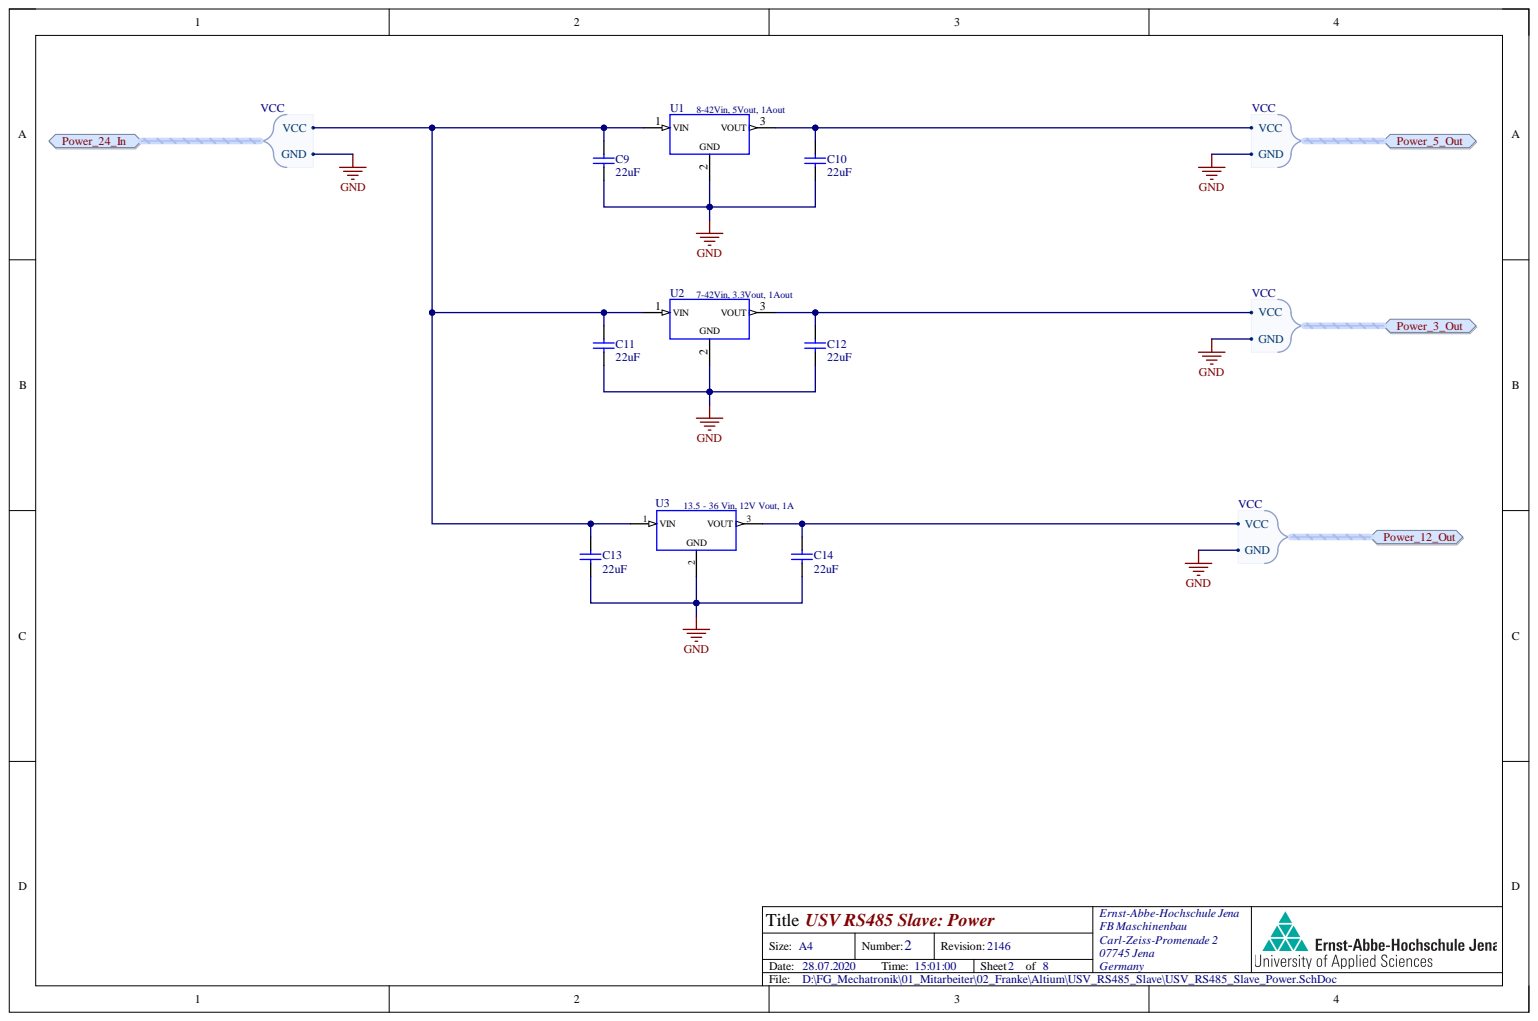
[picture p121: page 9]

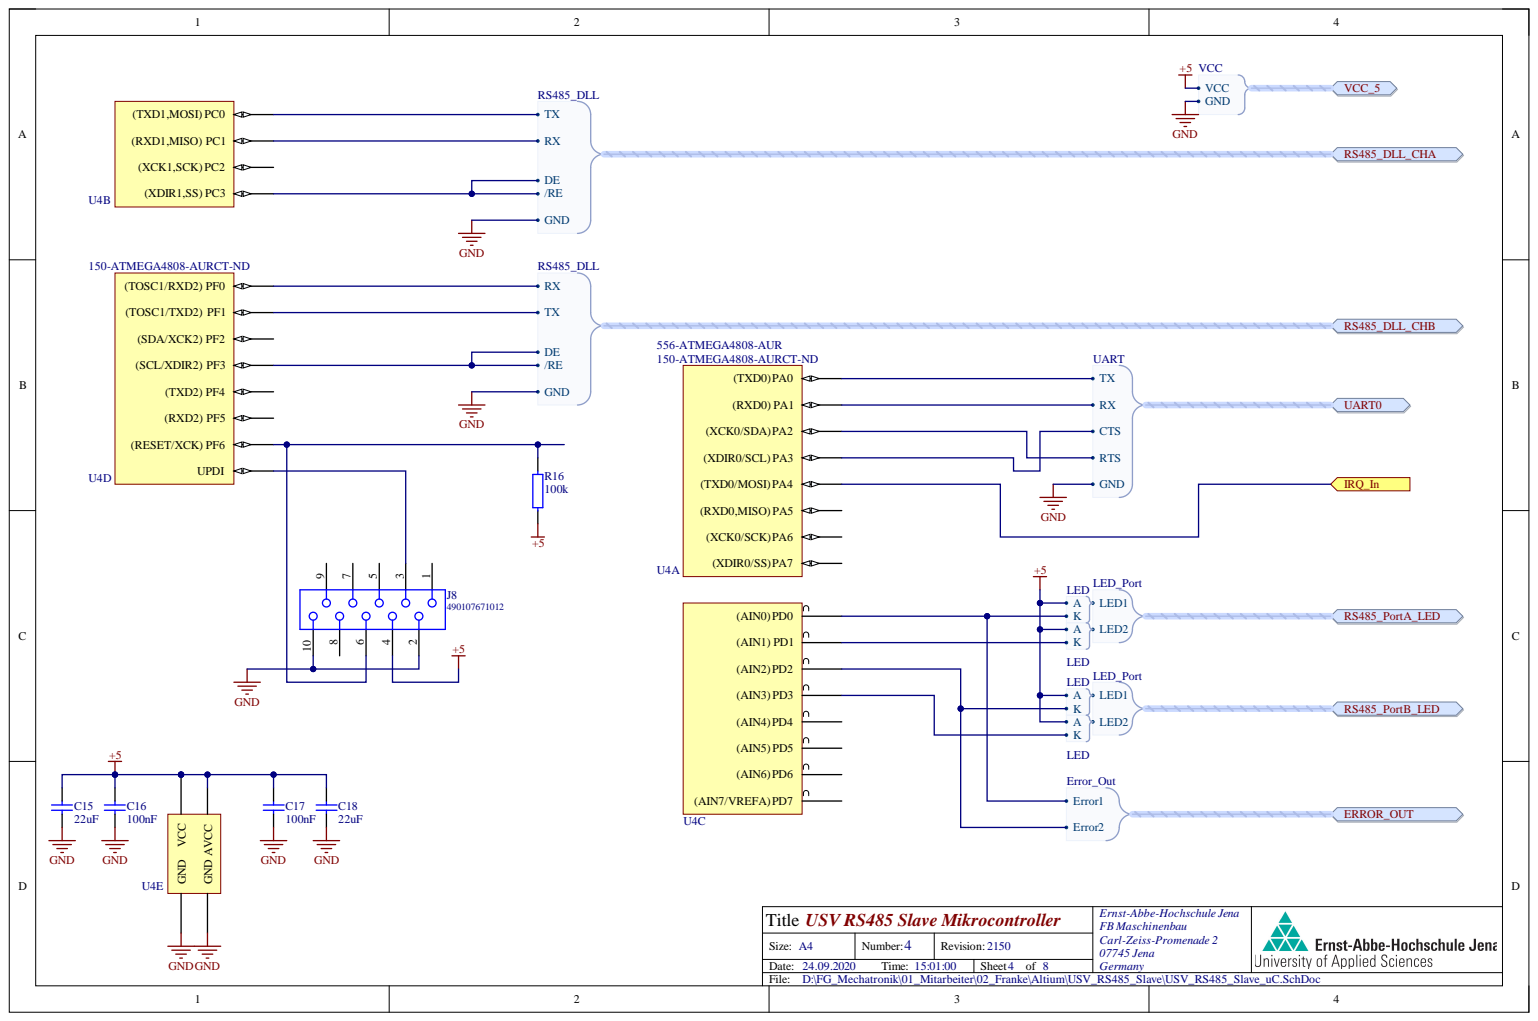
[picture p122: page 10]

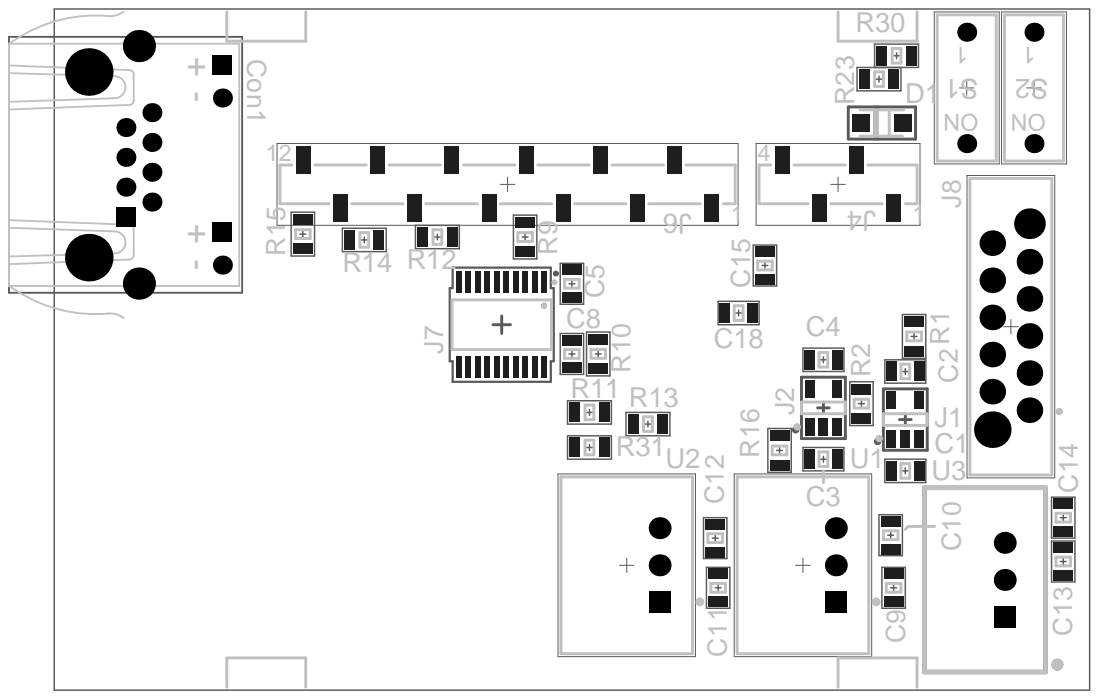
[picture p123: page 11]

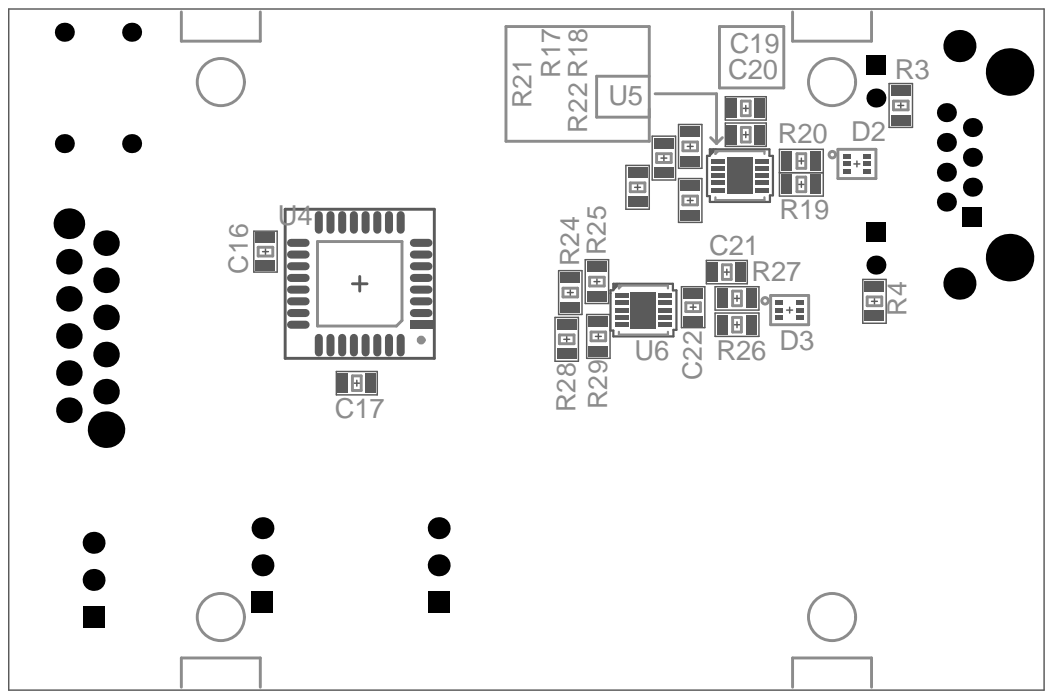
[picture p124: page 12]

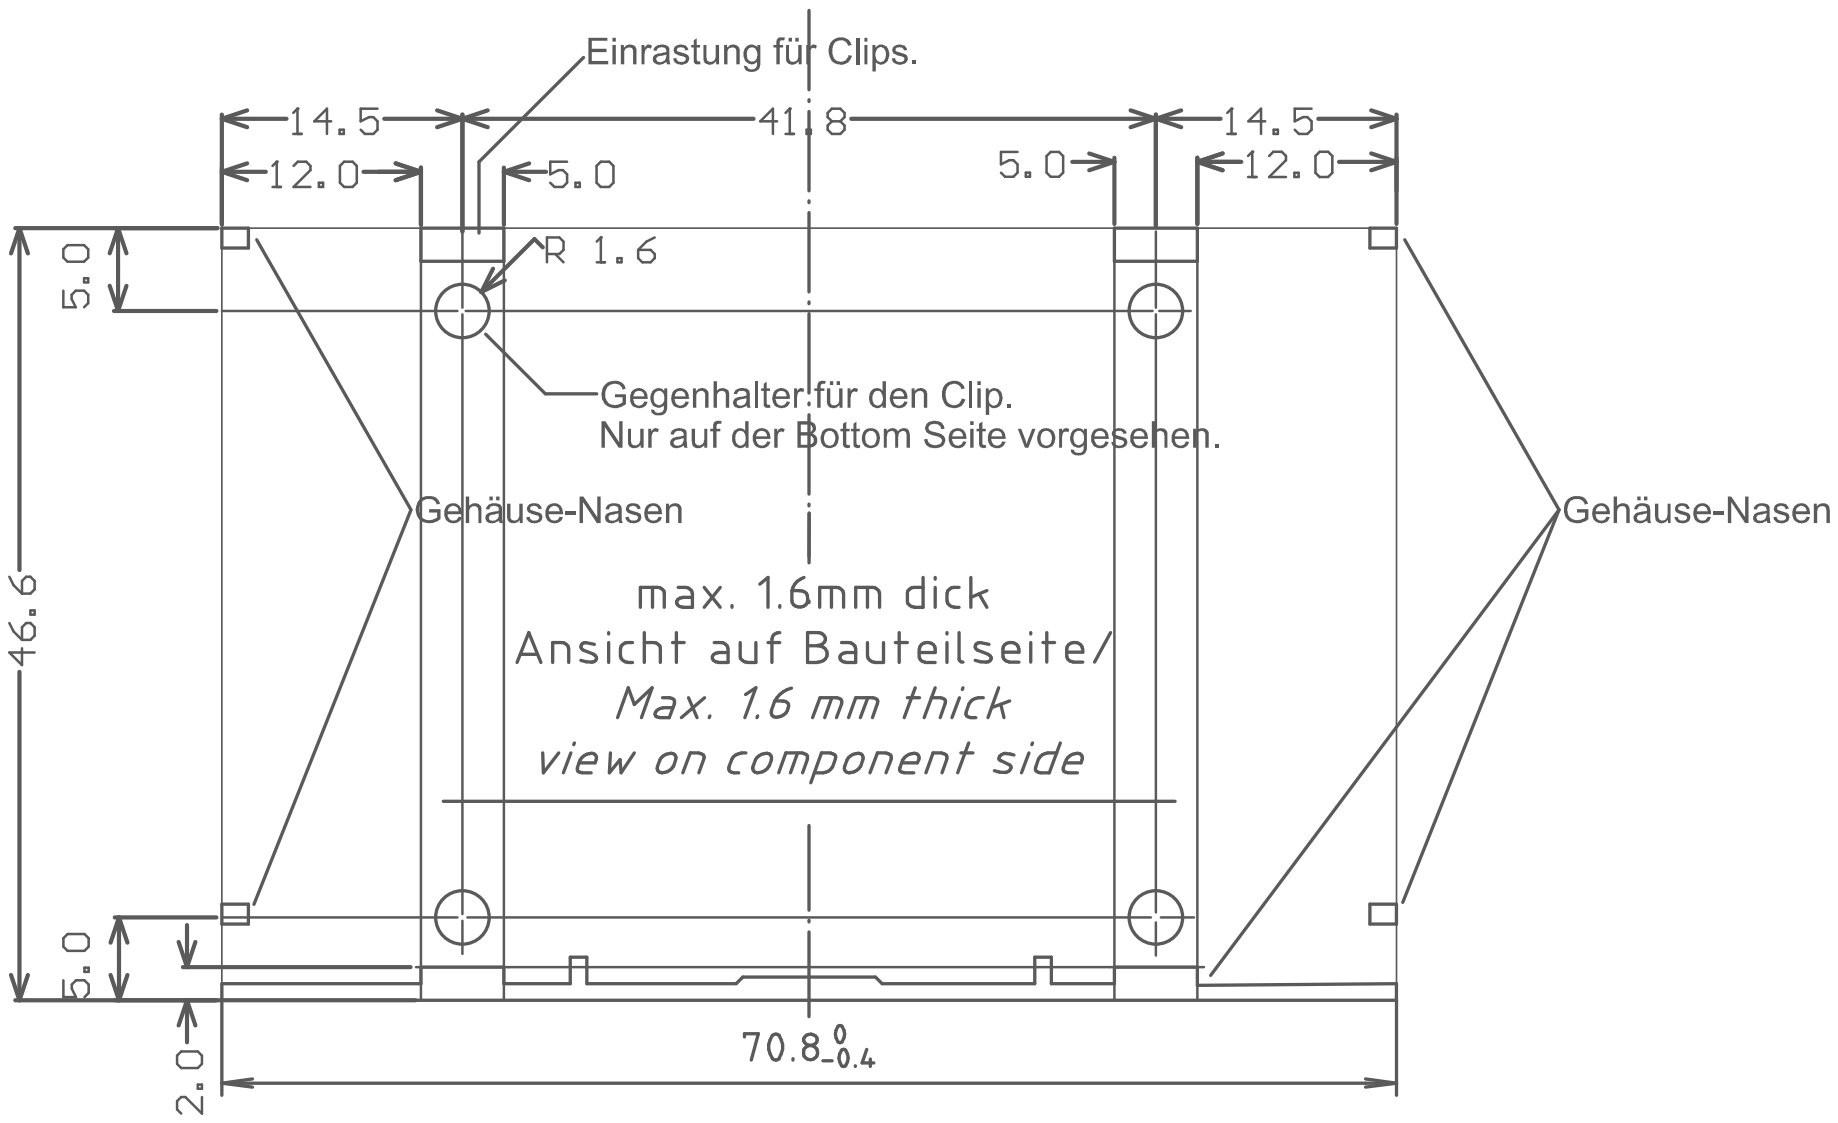
[picture p125: page 13]

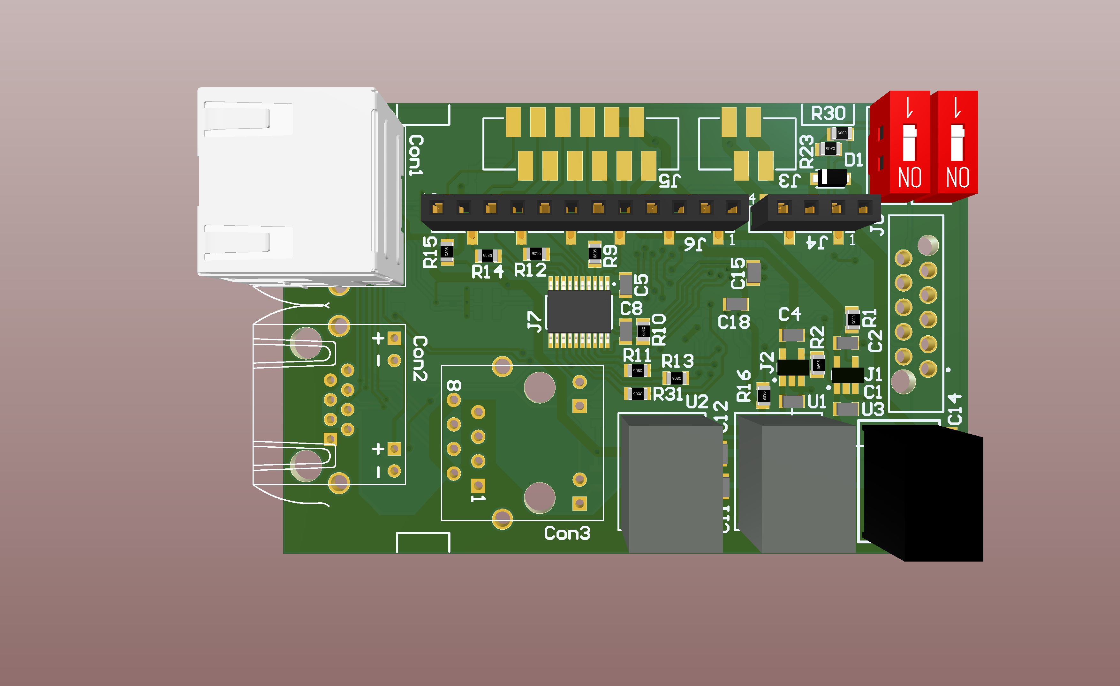
[picture p126: page 14]

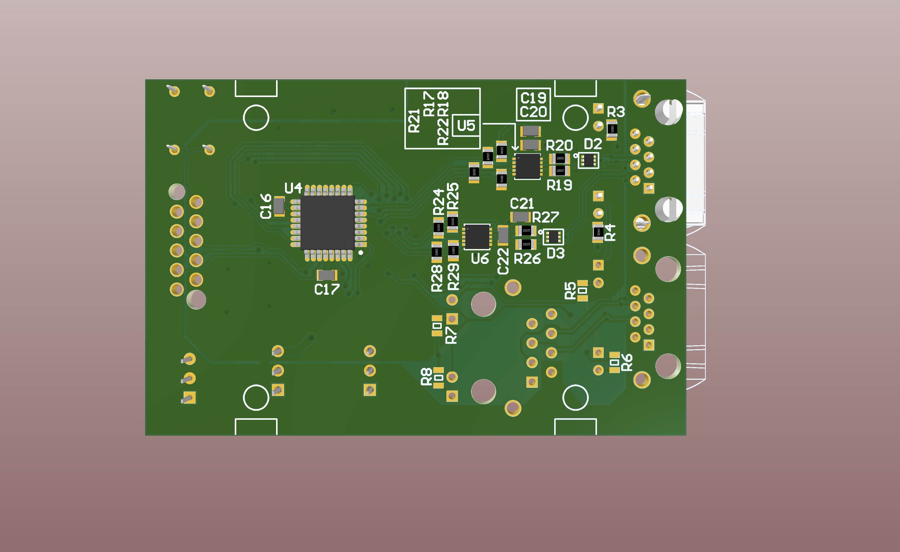
[picture p127: page 15]

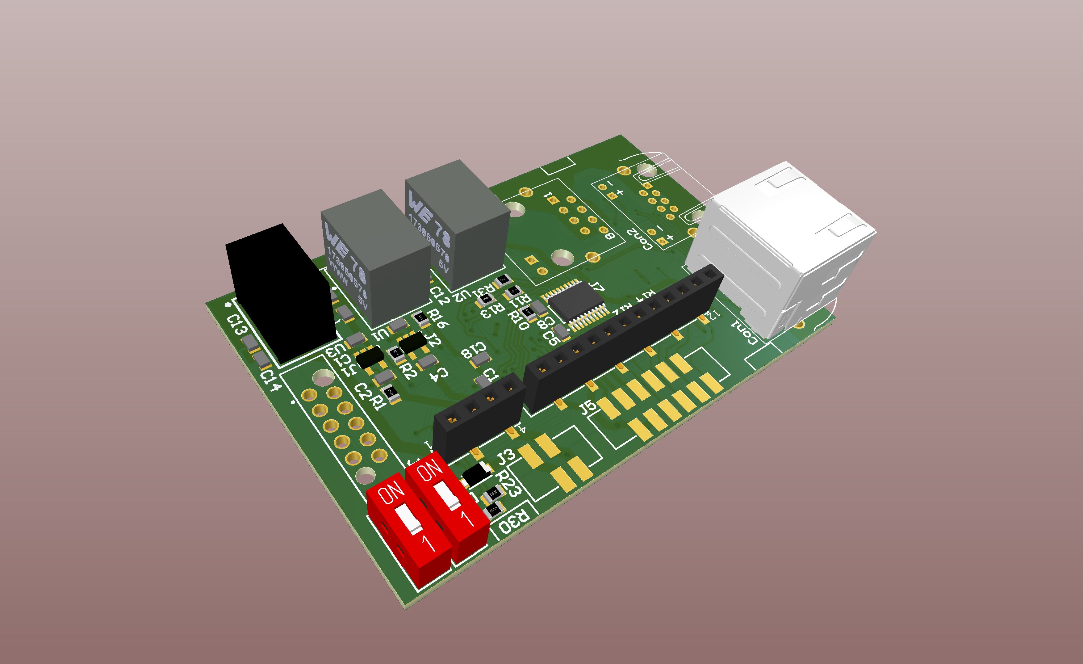
[picture p128: page 16]

Designator | Quantity | Comment | Footprint | LibRef | Supplier 1 | Supplier Part Number 1 | Supplier 2 | Supplier Part Number 2 | Supplier 3 | Supplier Part Number 3 | Manufacturer_Par t_Number | Manufacturer | partNo | Publisher | Part Number
C1, C3 | 2 1uF | | SMD-0805 | C
C2, C4 | 2 4.7uF | | SMD-0805 | C
C5, C8 | 2 100n | | SMD-0805 | C
C9, C10, C11, C12, C13, C14, C15, C18 | 8 22uF | | SMD-0805 | C
C16, C17, C20, C22 | 4 100nF | | SMD-0805 | C
C19, C21 | 2 10uF | | SMD-0805 | C
Con1 | 1 WE-Modular Jack Connectors 615008141321 | | 615008141321 | WE-Modular Jack Connectors 615008141321 | | | | | | | | W¨¹rth Elektronik eiSos GmbH | 615008141321
D1 | 1 PMEG3015EH | | SOD123F | PMEG3015EH | Digi-Key | 1727-3871-1-ND | Farnell | 1510686 | RSComponents | 485622
D2, D3 | 2 5V | | SOT563 | WE-TVS-HS,SOT563, 82400152 | | | | | | | | Würth Elektronik eiSos GmbH | 82400152
J1, J2 | 2 LTC4411 | | TSOT-23-5 | LTC4411 | Farnell | 1663916 | Digi-Key | LTC4411ES5#TRMPBFCT-ND
J4 | 1 61000411921 | | 61000411921 | 61000411921 | | | | | | | | | | Wurth Elektronik | 61000411921
J6 | 1 61001211921 | | 61001211921 | 61001211921 | | | | | | | | | | Wurth Elektronik | 61001211921
J7 | 1 SN74GTL2003PW | | PW20-M | SN74GTL2003PW | Digi-Key | SN74GTL2003PW-ND | Mouser | 595-SN74GTL2003PW | Arrow | SN74GTL2003PW
J8 | 1 490107671012 | | 490107671012_Perma nent Application | 490107671012 | | | | | | | | | | Wurth Elektronik | 490107671012
R1, R2, R16 | 3 100k | | R-SMD-0805 | R
R3, R4 | 2 560R | | R-SMD-0805 | R
R9, R11, R12, R13, R14, R15, R31 | 7 68 | | R-SMD-0805 | R
R10 | 1 200k | | R-SMD-0805 | R
R17, R18, R21, R22, R24, R25, R28, R29 | 8 10k | | R-SMD-0805 | R
R19, R20, R26, R27 | 4 10 | | R-SMD-0805 | R
R23, R30 | 2 12k | | R-SMD-0805 | R
S1, S2 | 2 418117170901 | | 418117170901 | 418117170901 | | | | | | | | | | Wurth Elektronik | 418117170901
U1 | 1 8-42Vin, 5Vout, 1Aout | | 173010x42 | 173010542 | | | | | | | | | | Wurth Elektronik | 173010542
U2 | 1 7-42Vin, 3.3Vout, 1Aout | | 173010x42 | 173010342 | | | | | | | | | | Wurth Elektronik | 173010342
U3 | 1 TSRN 1-24120 | | SIP-3 | TSRN 1-24120 | Digi-Key | 1951-2613-ND | Farnell | 2280250 | RSComponents | 7553413P
U4 | 1 ATmega4808-AUR | | 32-Pin TQFP | ATmega4808-AUR | Digi-Key | 150-ATMEGA4808-AURCT-ND | Mouser | 556-ATMEGA4808-AUR
U5, U6 | 2 LTC2854CDD | | DFN-10_DD-L | LTC2854CDD | Digi-Key | LTC2854CDD#PBF-ND | RSComponents | 423743 | Farnell | 1609796 | LTC2854CDD#PBF
