s2chhaen/USV/01 Hardware/98 Slave_Default/01 case/case_1.pdf

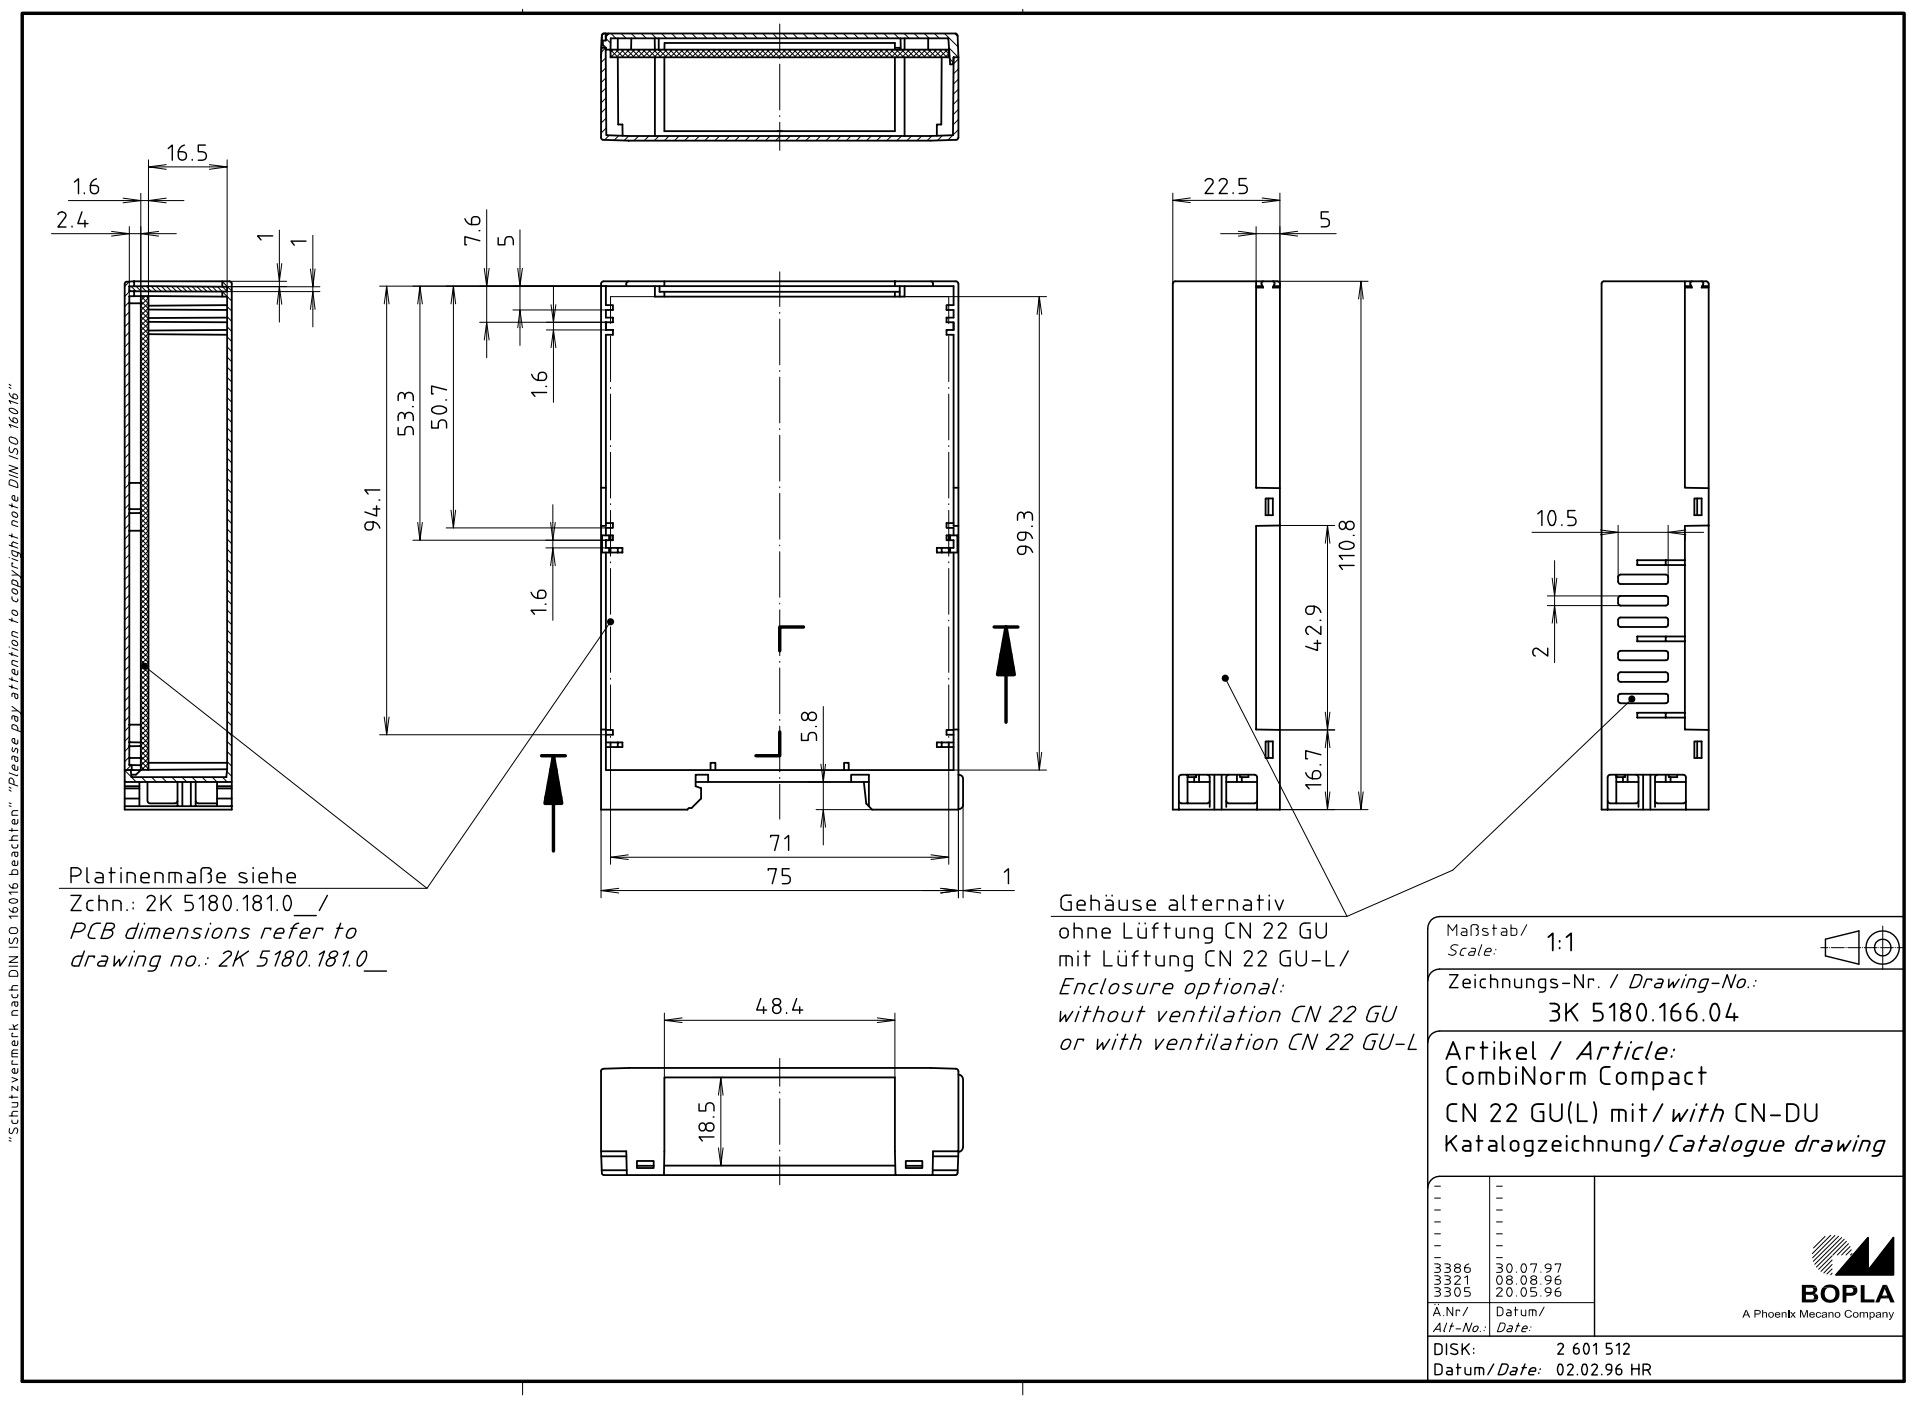
[picture p129: page 1]
