s2chhaen/USV/01 Hardware/98 Slave_Default/01 case/case_pcb.pdf

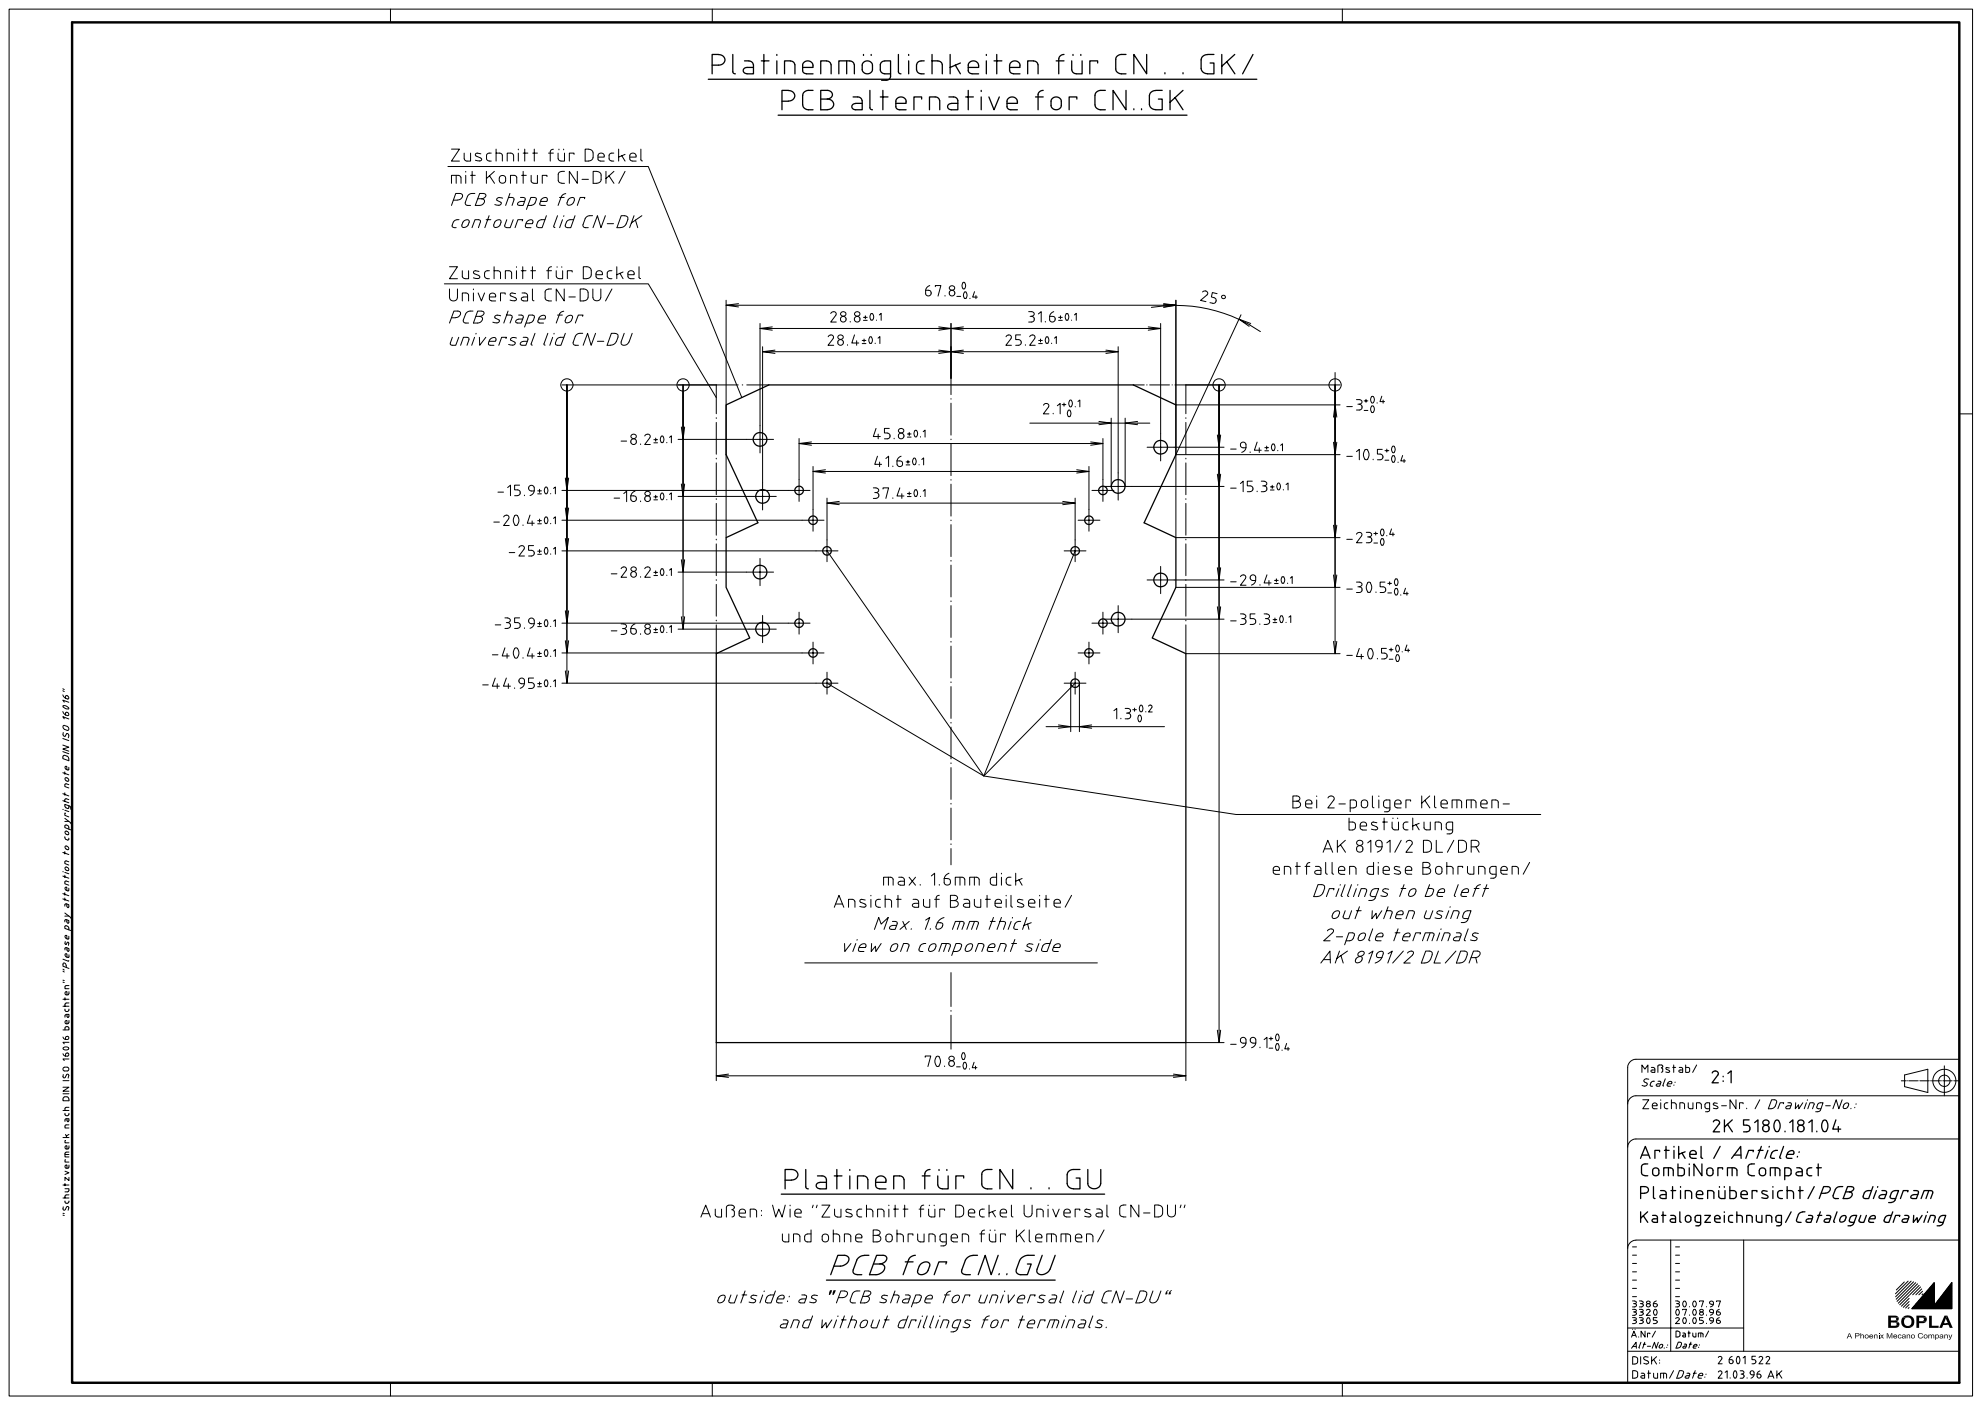
[picture p130: page 1]
