s2chhaen/USV/01 Hardware/98 Slave_Default/01 case/case_pcb_2.pdf

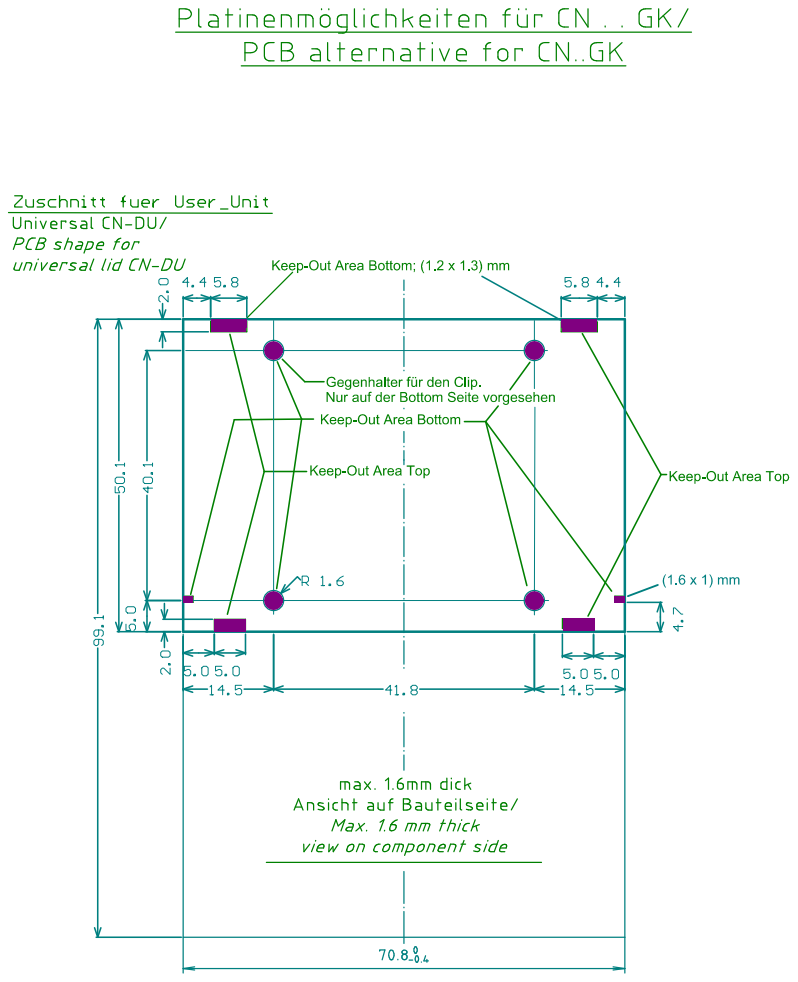
[picture p131: page 1]
