s2chhaen/USV/01 Hardware/99 Frame/00 doc/Ebene_2.pdf

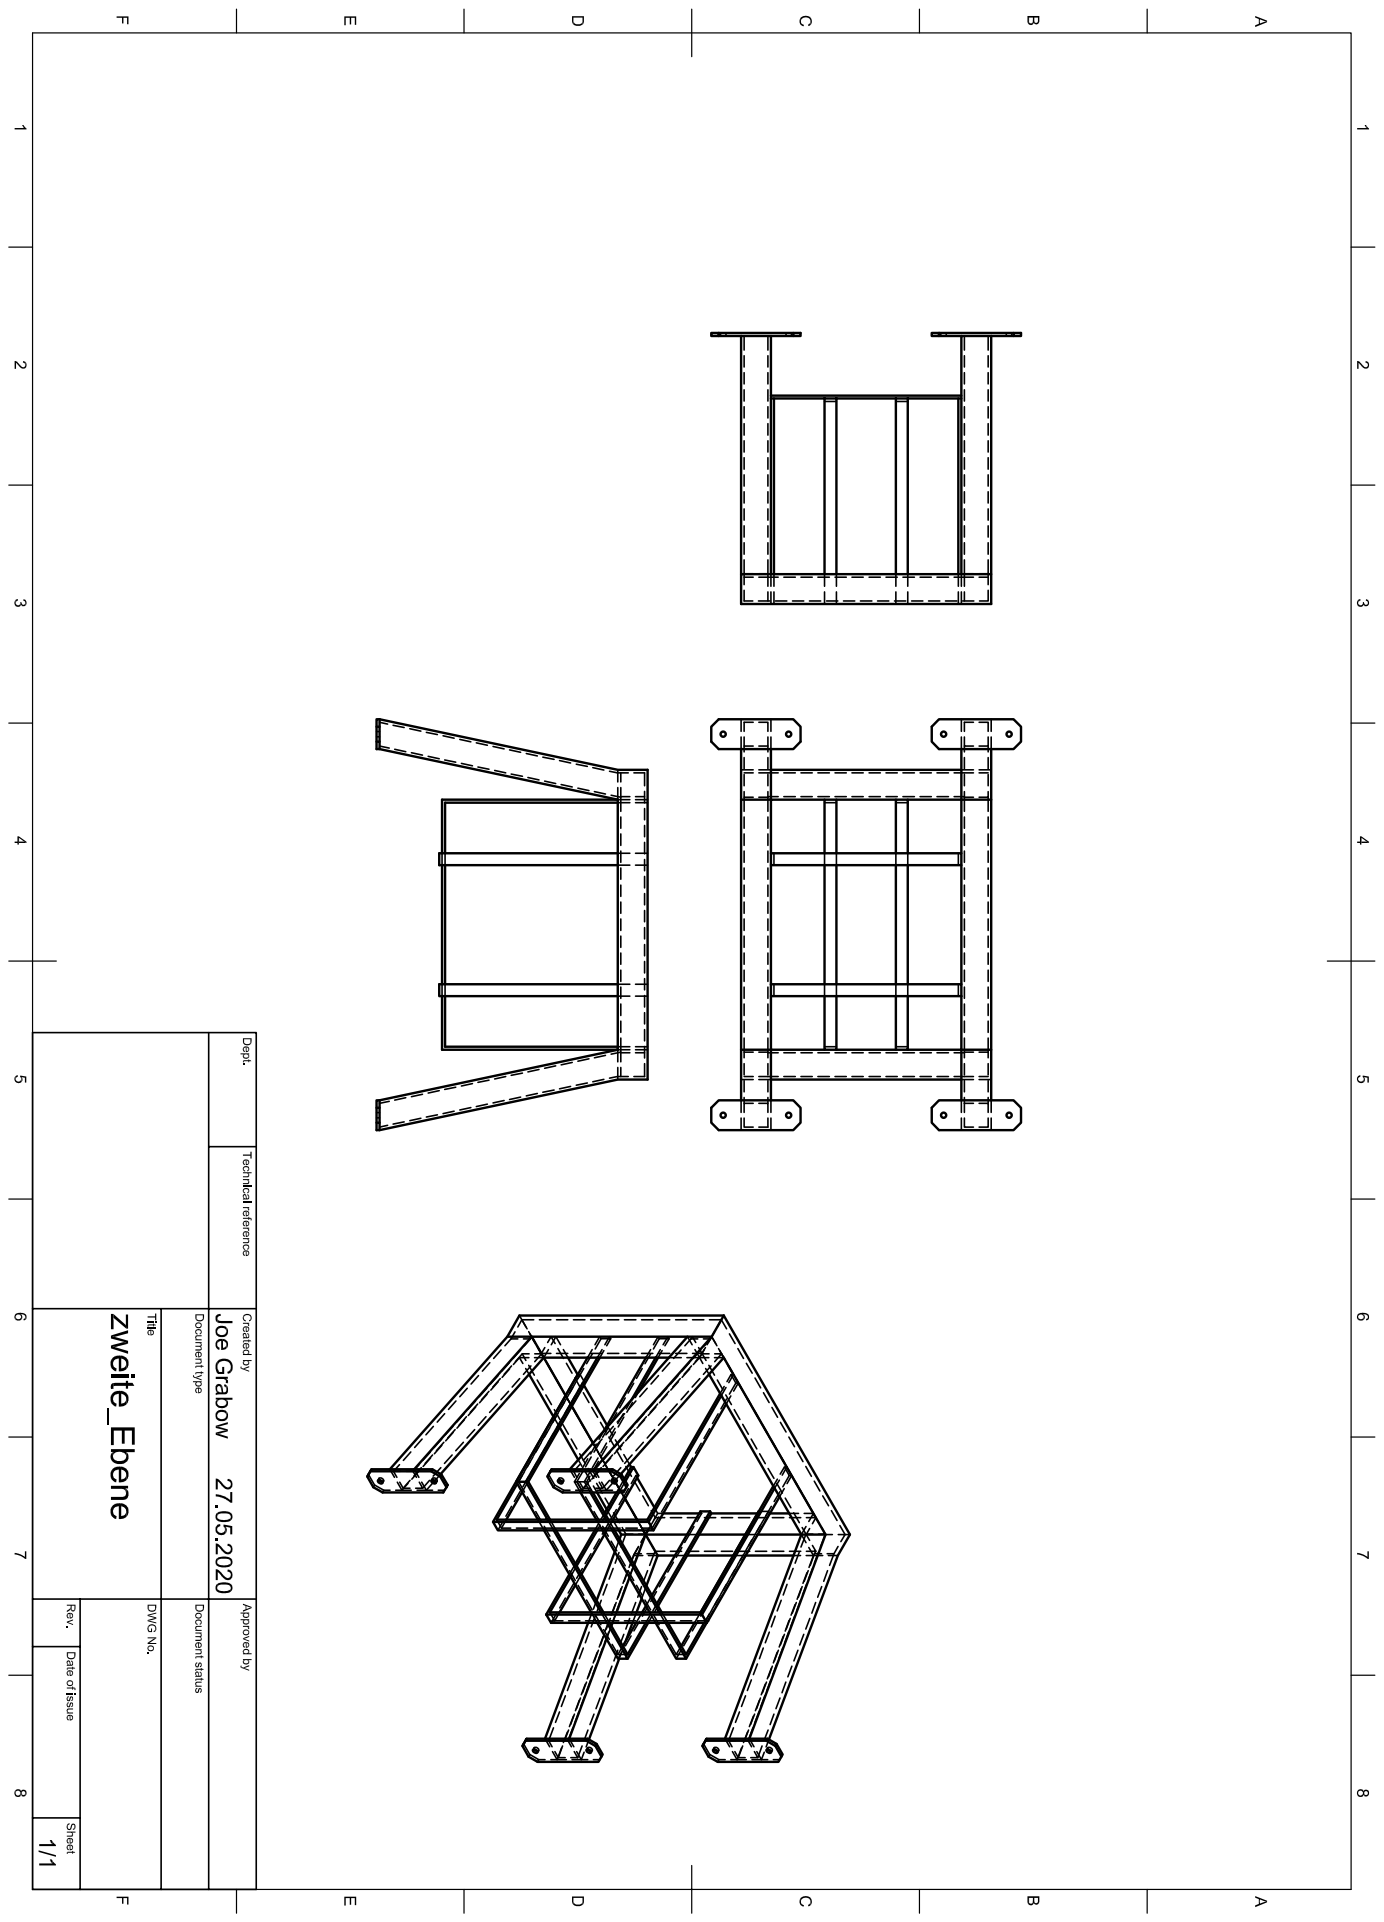
[picture p132: page 1]
