s2chhaen/USV/01 Hardware/99 Frame/00 doc/Grundrahmen.pdf

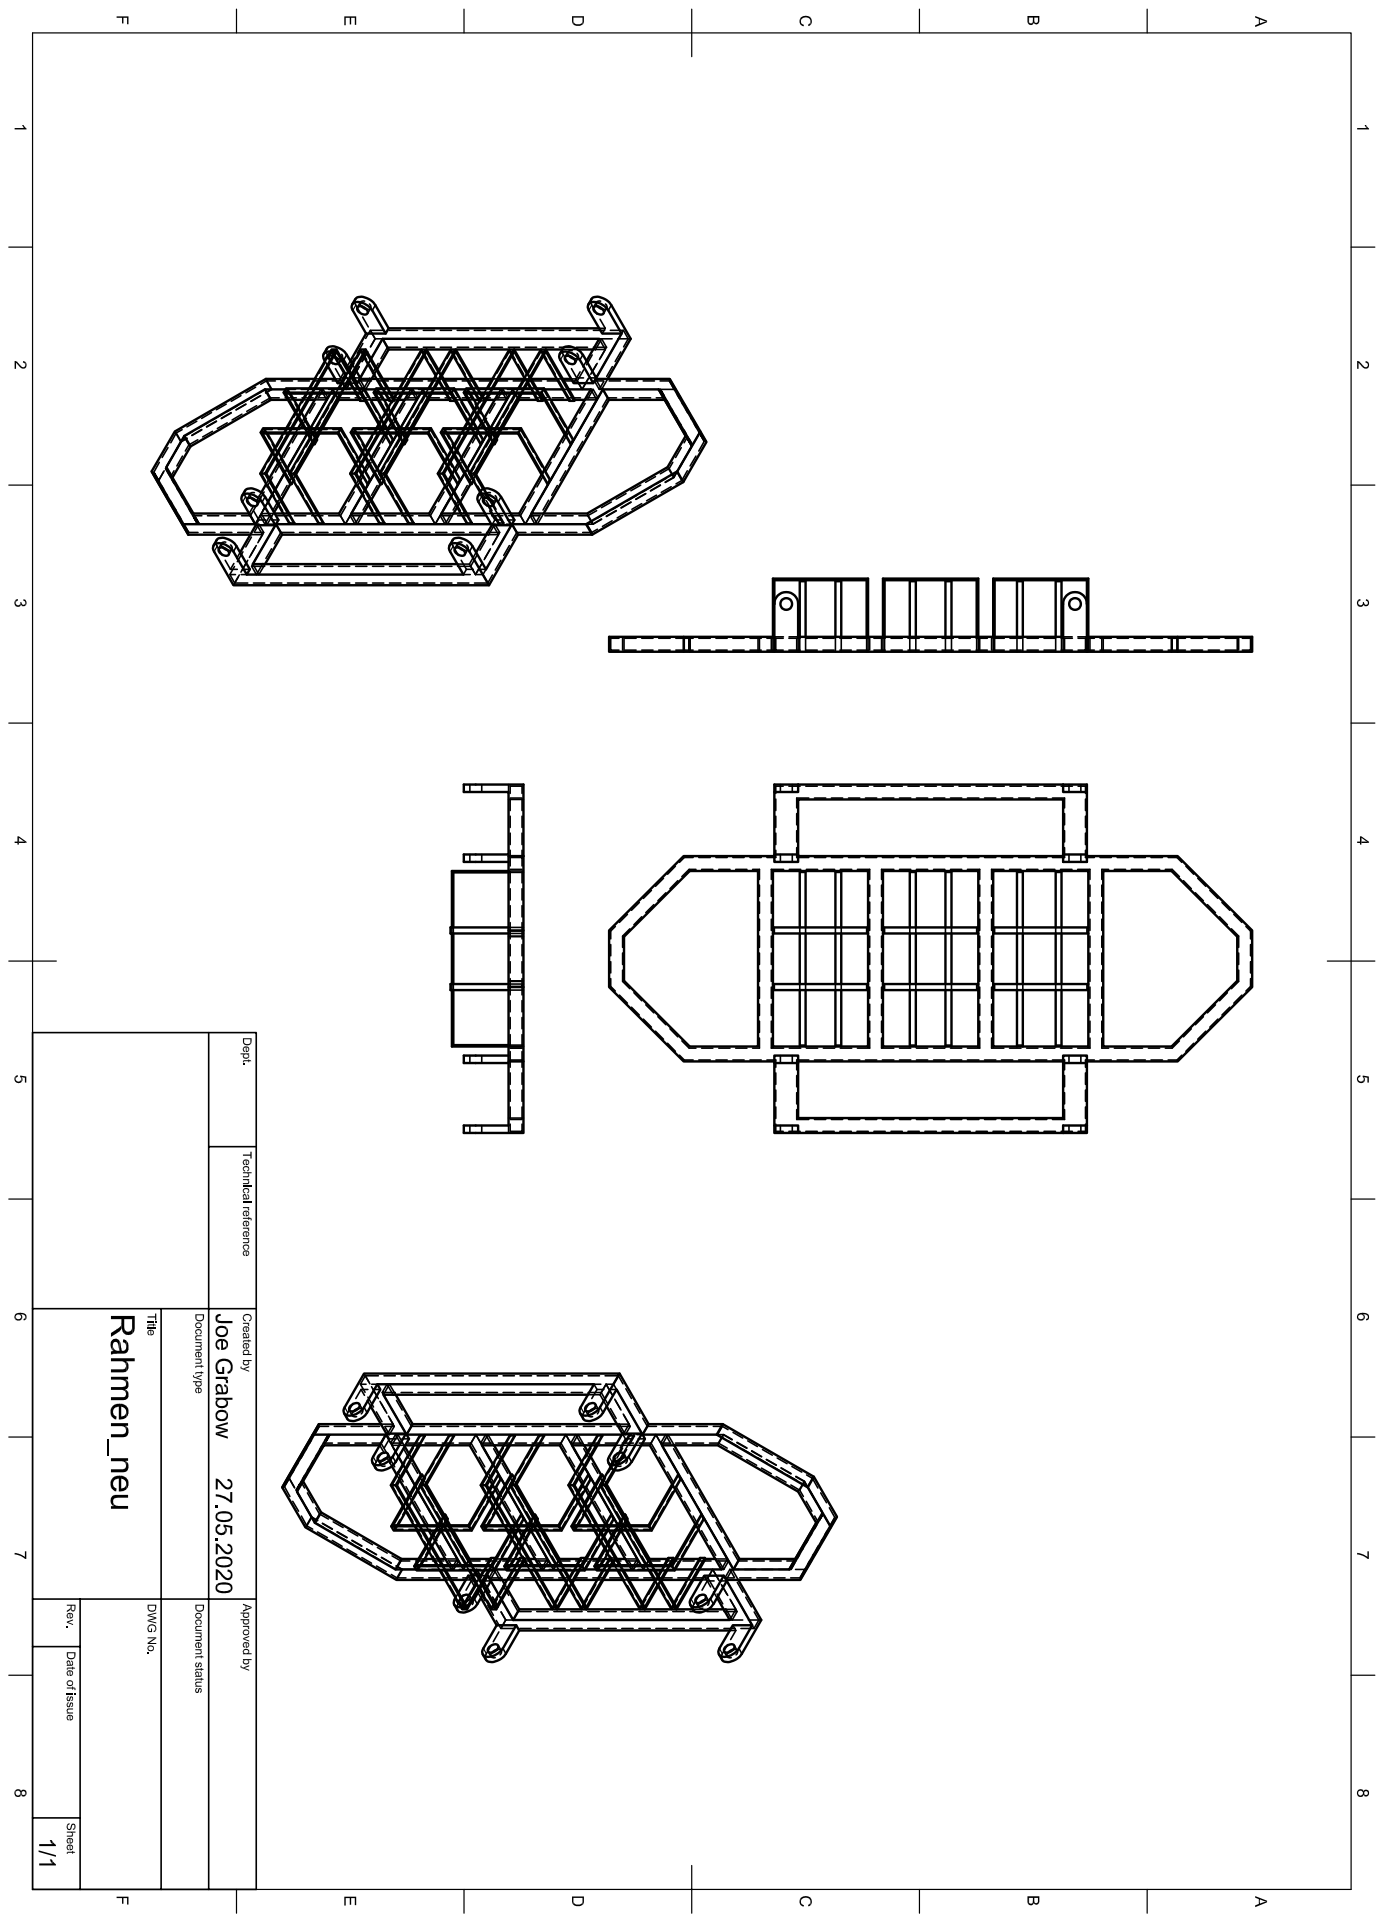
[picture p133: page 1]
