s2chhaen/USV/01 Hardware/99 Frame/00 doc/Katamaran_1.pdf

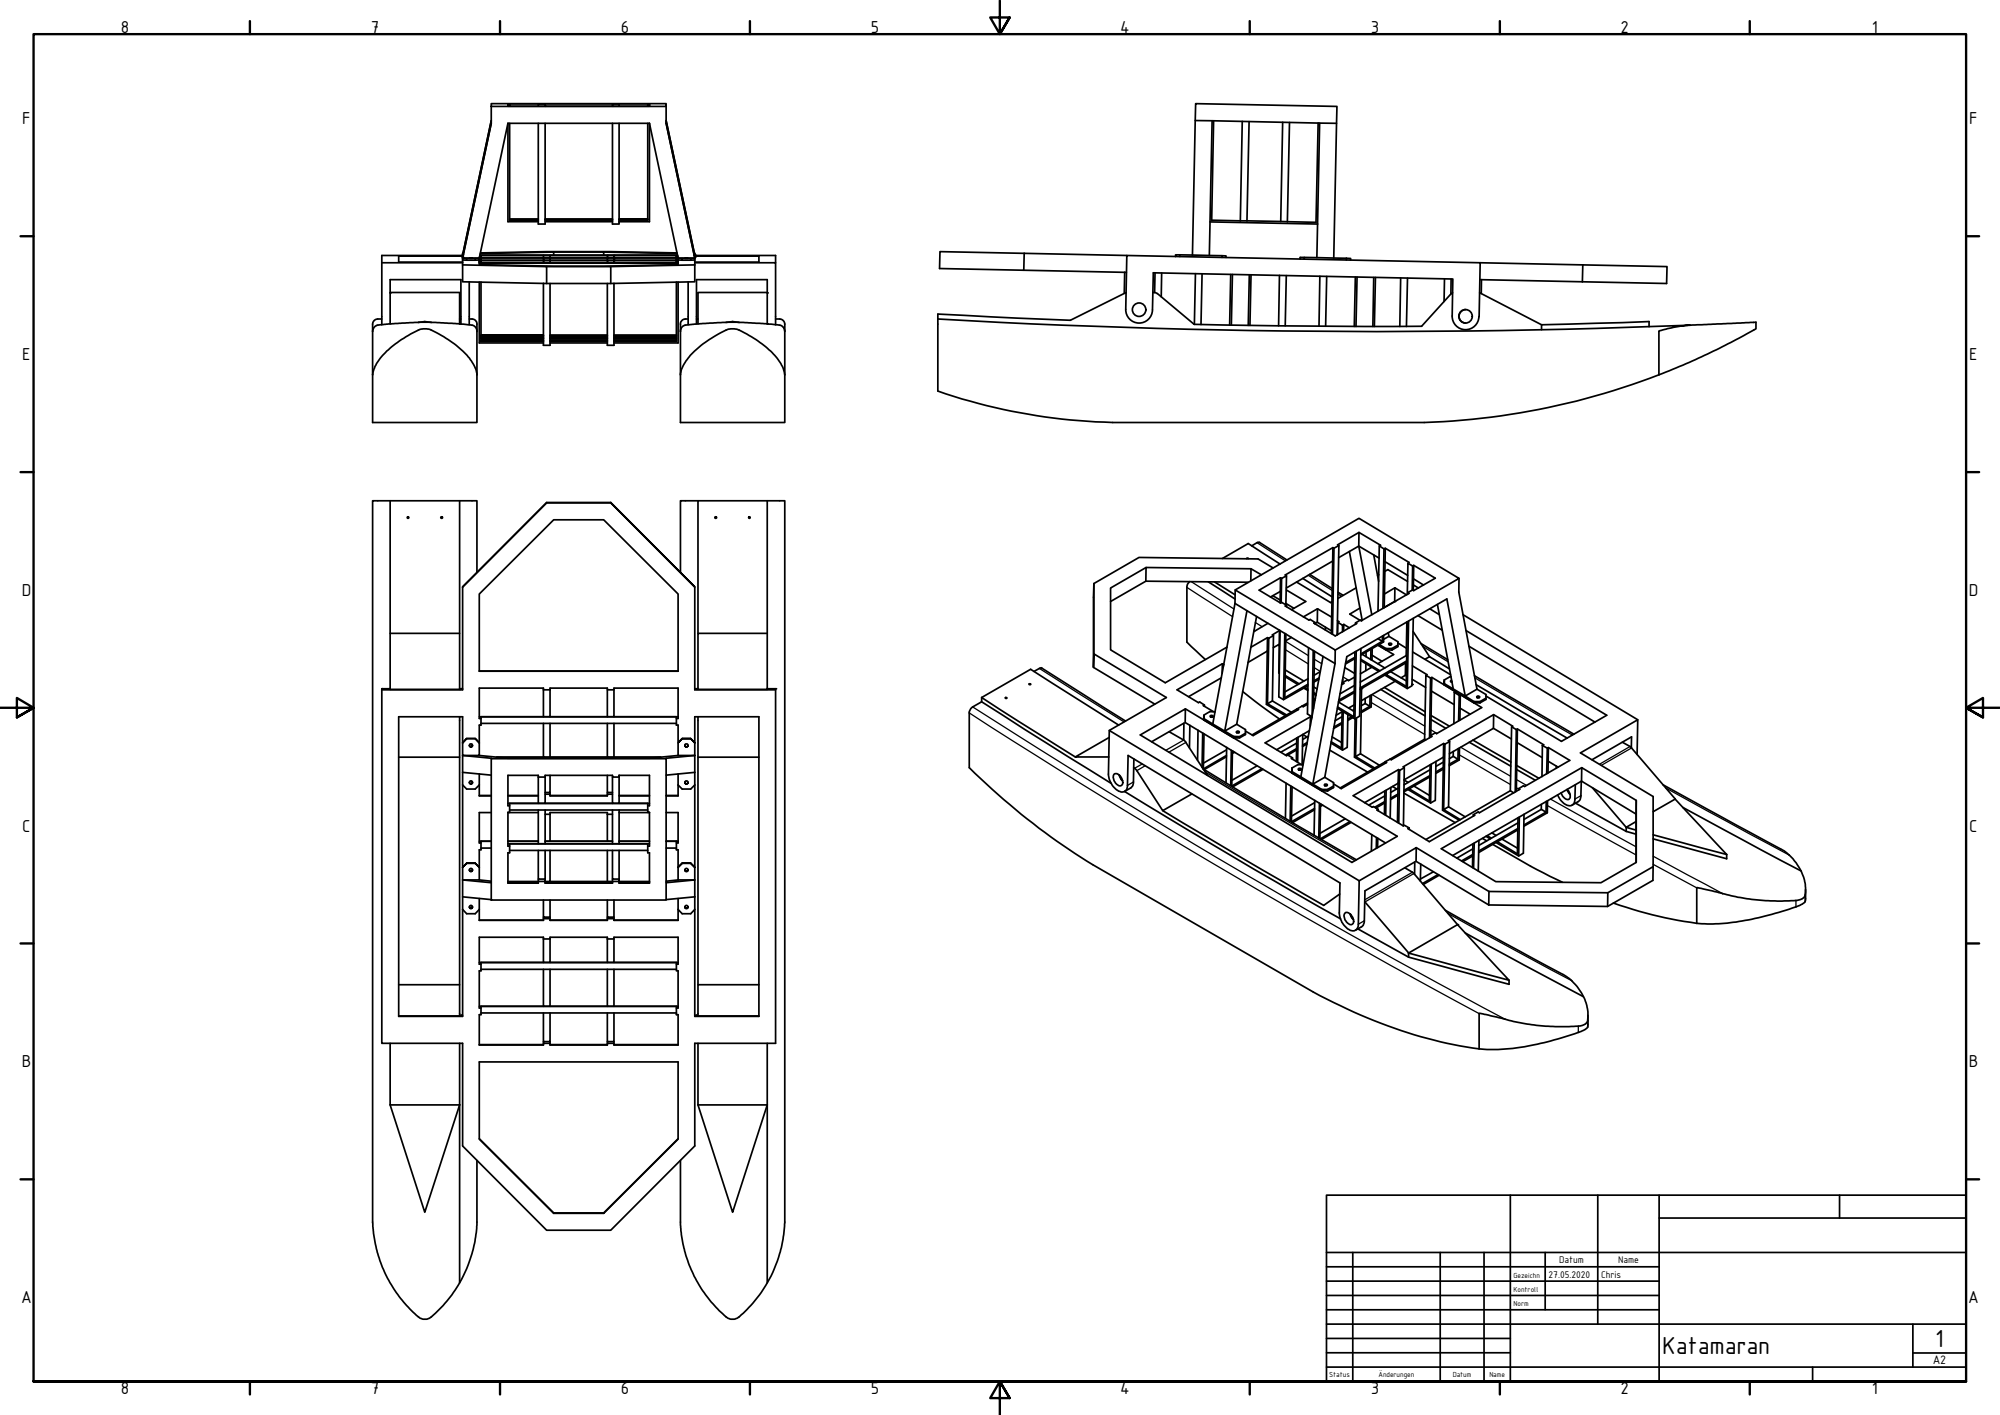
[picture p134: page 1]

Datum | Name

Gezeichn | 27.05.2020 | Chris

Kontroll

Norm
