s2chhaen/USV/01 Hardware/03 APRS/02 Hardware/00 doc/USV-BG-001-BB-A.pdf

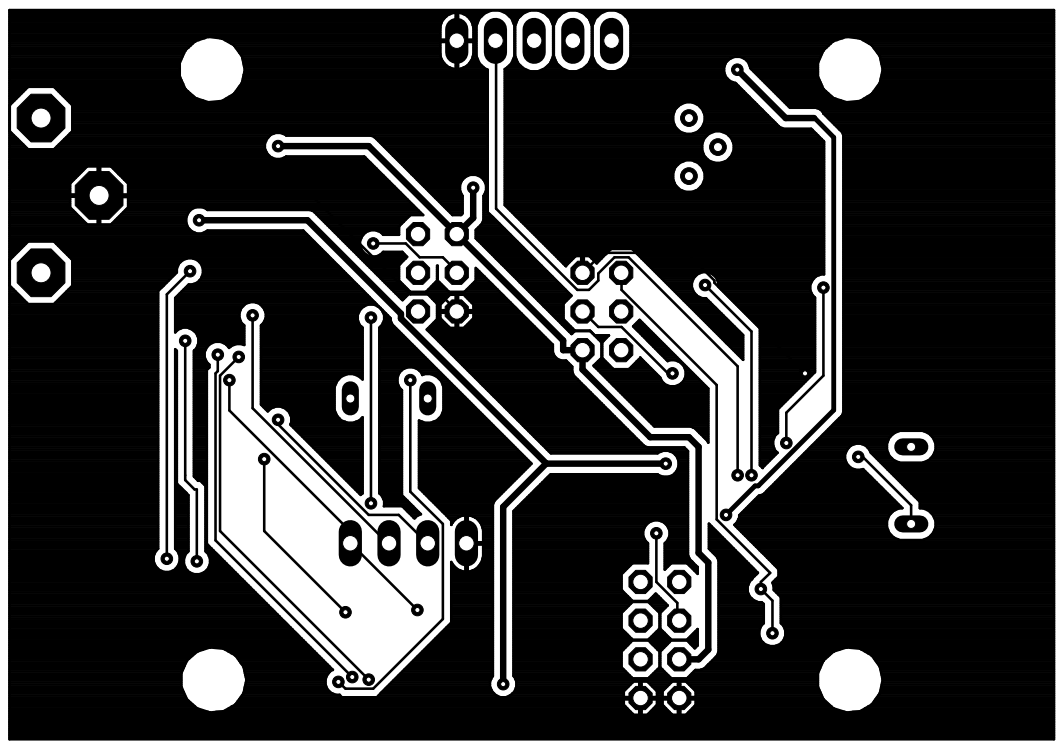
[picture p135: page 1]
