s2chhaen/USV/01 Hardware/03 APRS/02 Hardware/00 doc/USV-BG-001-LT-A.pdf

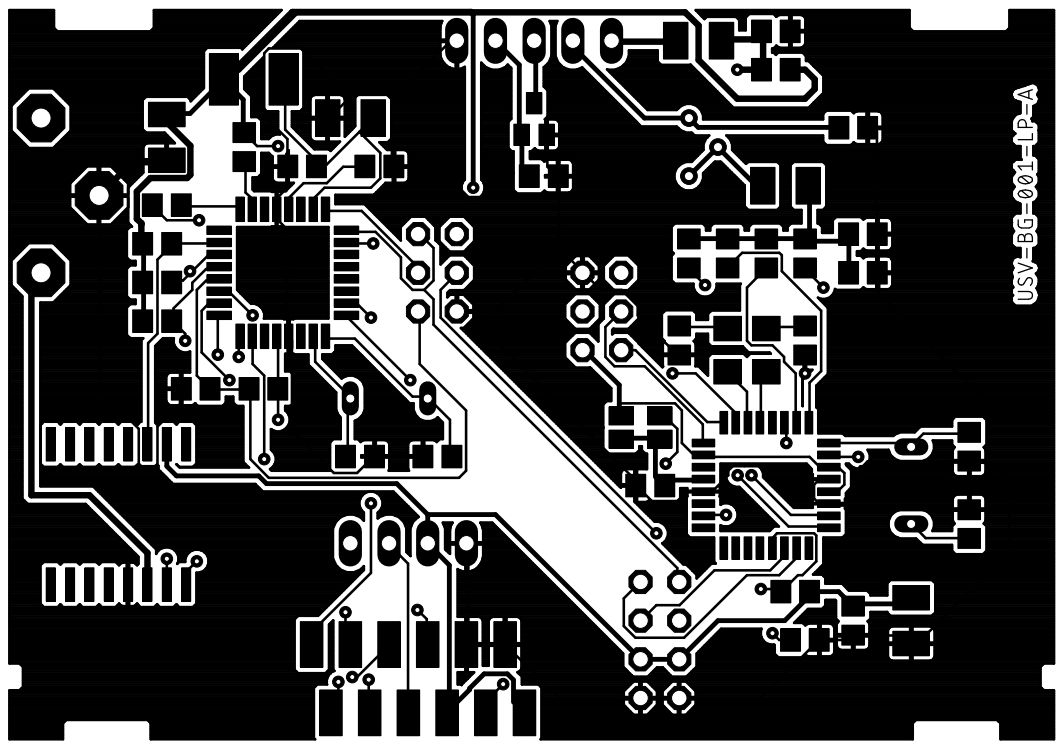
[picture p136: page 1]
