s2chhaen/USV/01 Hardware/03 APRS/02 Hardware/00 doc/USV-BG-001-SP-A.pdf

A

A

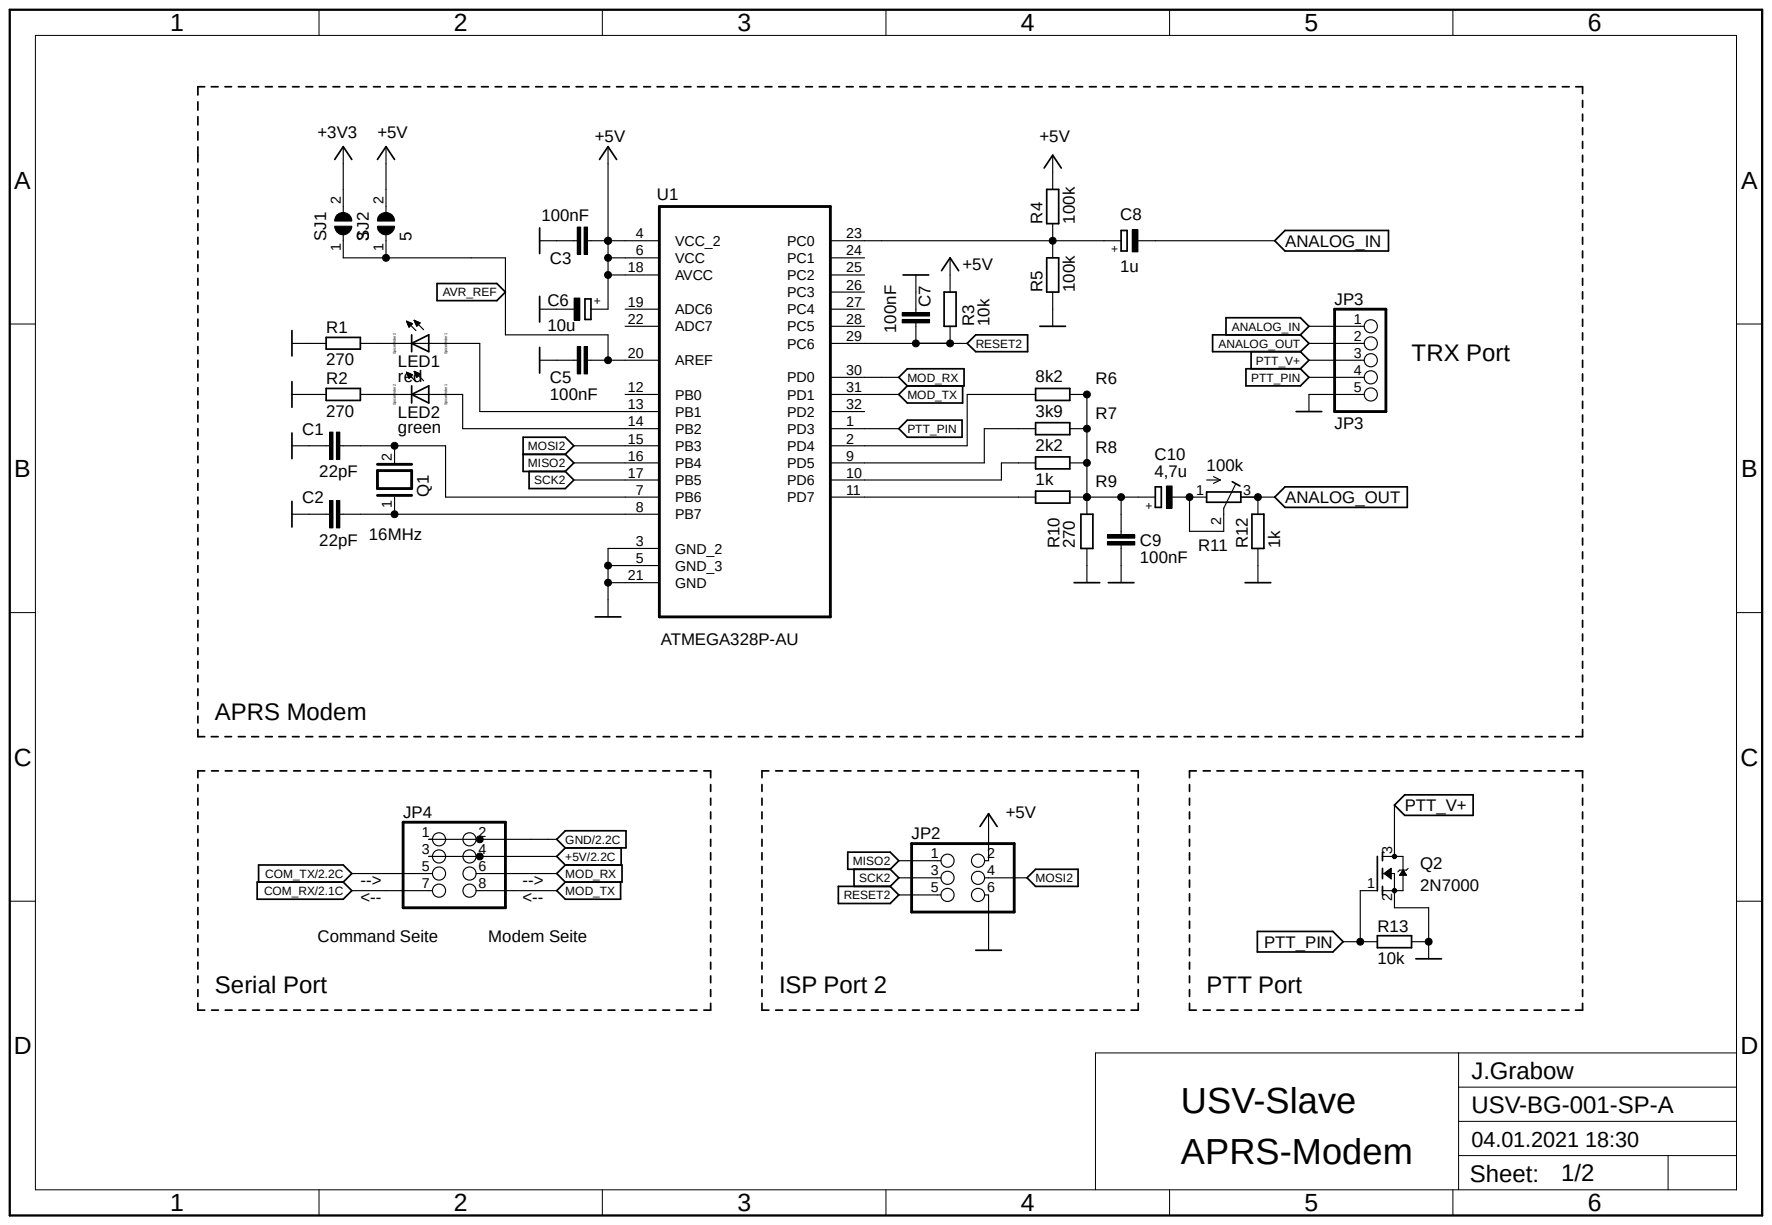
[picture p137: page 1]

A

A

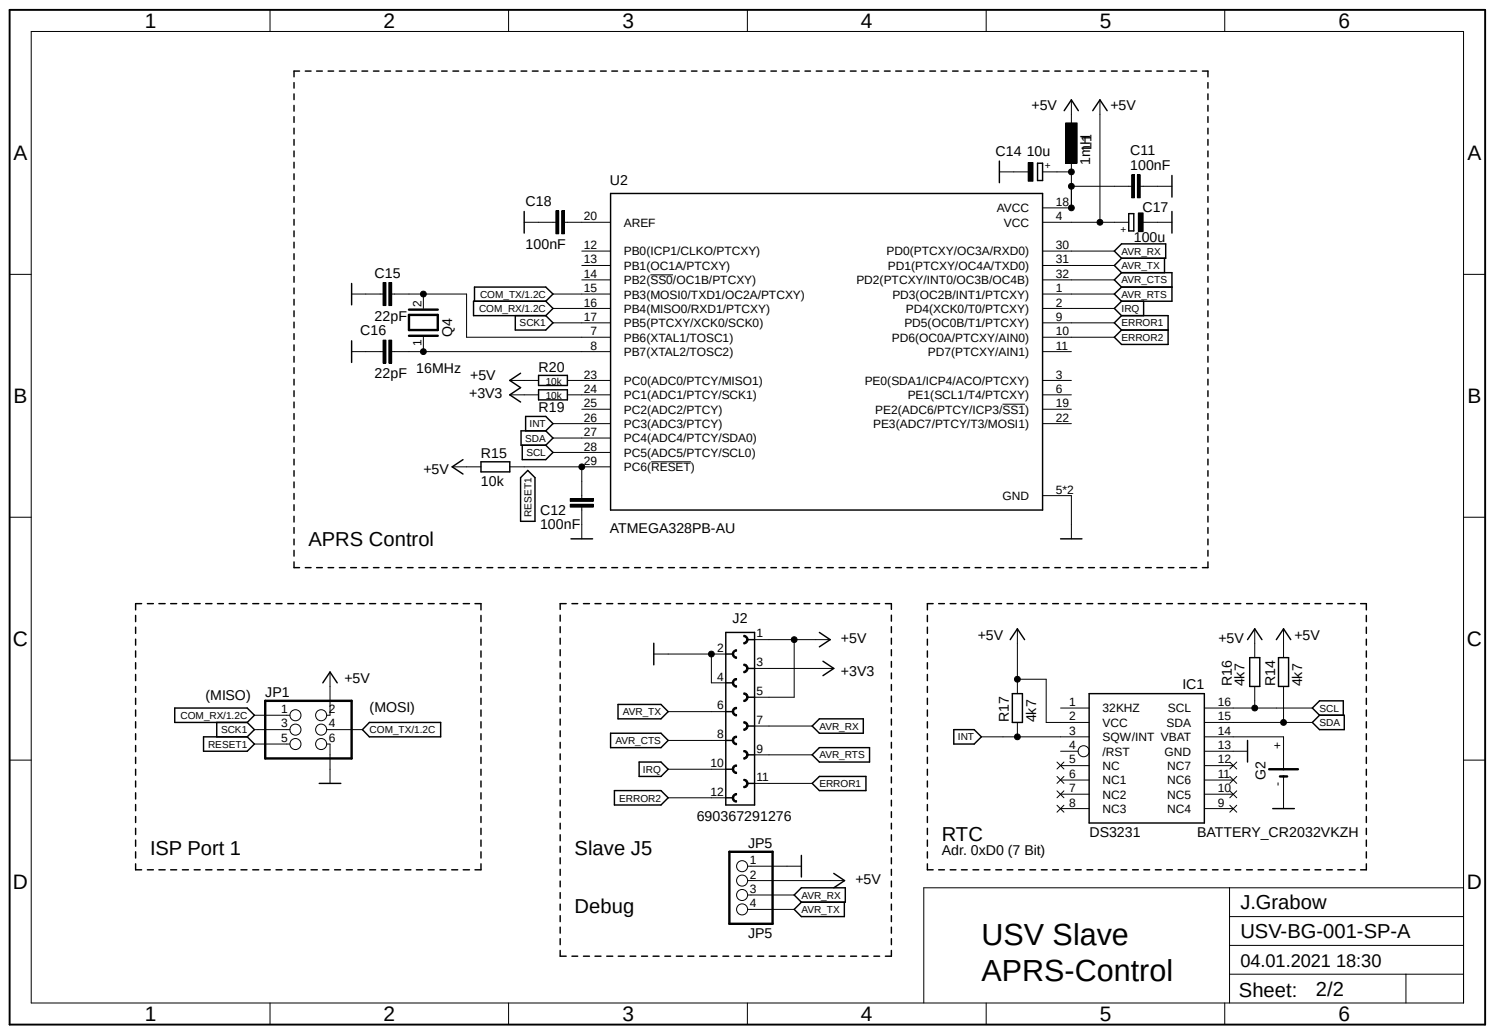
[picture p138: page 2]
