s2chhaen/USV/01 Hardware/13 lighting/01 Hardware/00 doc/BPW34.asc

Ccable: cap; 100p
D1: diode; DP
I1: current; PULSE(0u 100u 10u 100n 100n 100u 200u); AC 1
R1: res; 50k
Rsh: res; 1G
U1: LTC6241
V1: voltage; 3.3
Named nets: 0, VCC, out, in
.tran 0 1m 0 1u
.options plotwinsize=0
.ac dec 100 1k 1e7
.model DP D(Is=1e-10 Cjo=70p Rs=5 N=1.5)
PHOTO DIODE WITH TRANSIMPEDANCE AMPLIFIER
Photo Diode
K
A
BPW34
BPW34: 80uA @ 1000Lux
