s2chhaen/USV/(list of files, drawings)

Other design files:
01 Hardware/97 RP2040_Stamp/02 Hardware/03 board/Altium/RP2xxx_Stamp.SchLib
