s2chhaen/USV/01 Hardware/08 control/01 Hardware/Control.brd

## EAGLE design 01 Hardware/08 control/01 Hardware/Control.brd (2024-09-11)

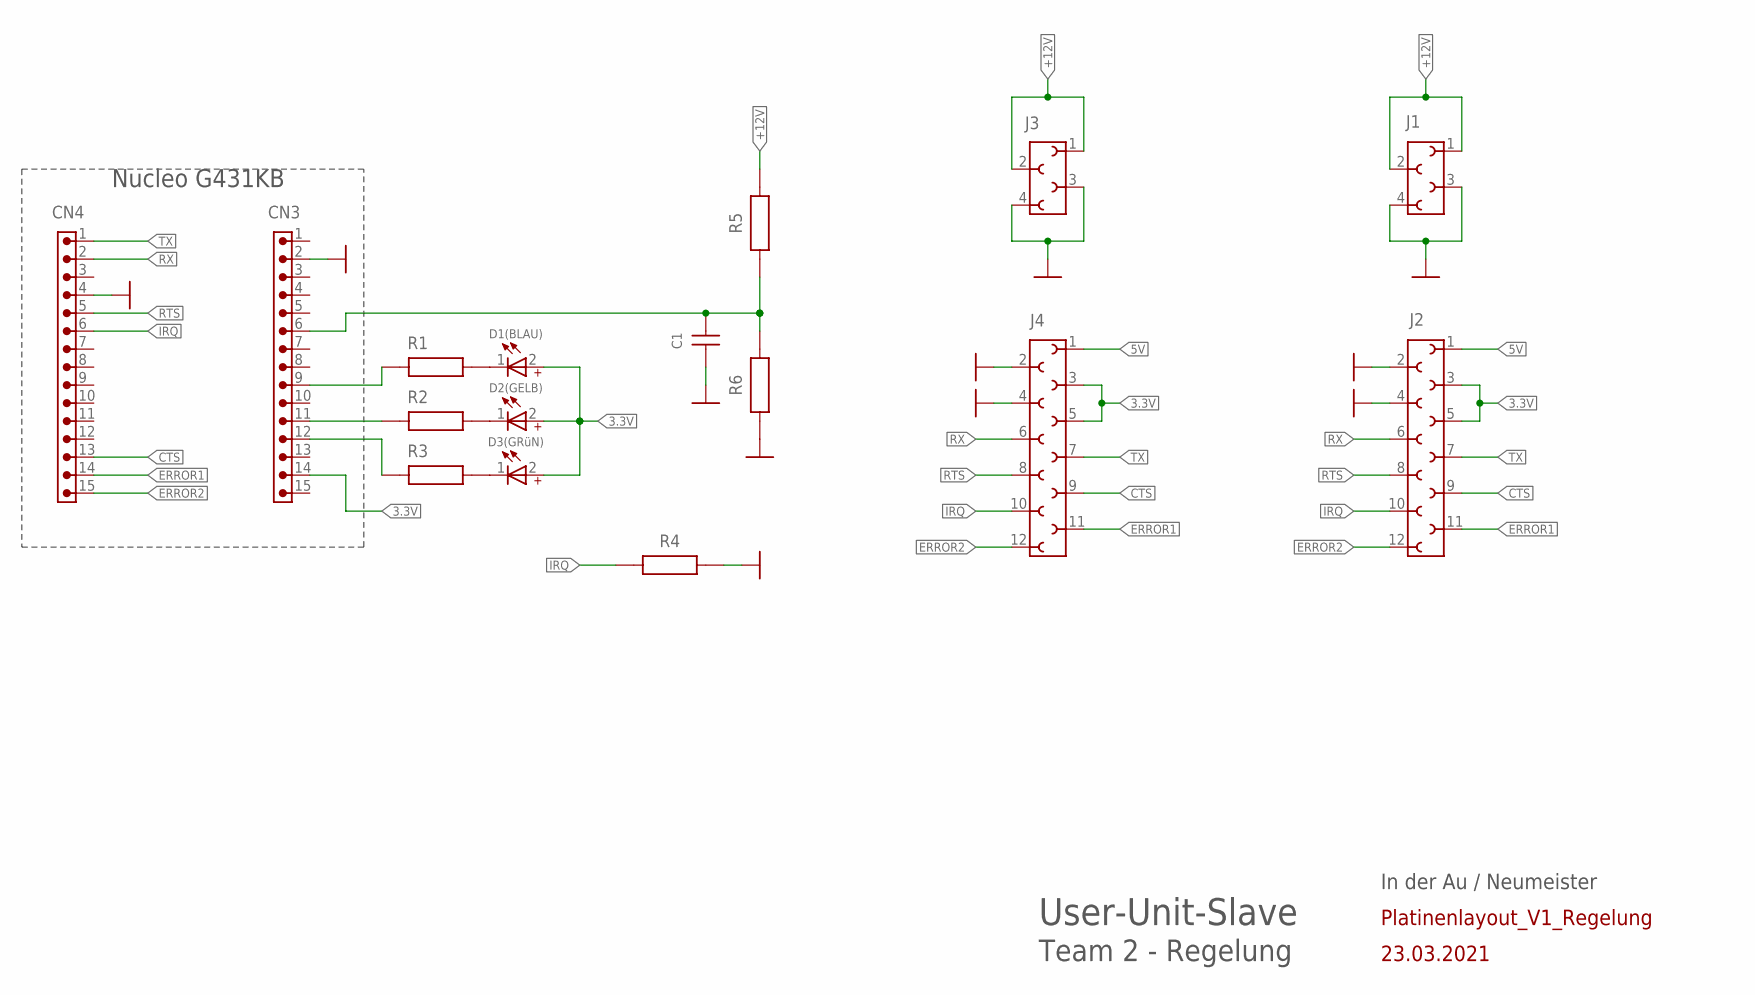
[picture p139: schematic Control.sch]

Parts:
C1: 10 nF; WCAP-CSGP_1206_H1.25
CN3, CN4: 61301511121
D1(BLAU): WL-TMRC_3MM_151031SS06000_WITHOUTSTOPPER; WL-TMRC_3MM
D2(GELB): WL-TMRC_3MM_151031YS06000_WITHOUTSTOPPER; WL-TMRC_3MM
D3(GRüN): WL-TMRC_3MM_151031VS06000_WITHOUTSTOPPER; WL-TMRC_3MM
J1: 6100XX11921_61000411921; 61000411921
J2: 6100XX11921_61001211921; 61001211921
J3: 690367290476
J4: 690367291276
R1, R2, R3, R5, R6: 1Ohm; WRIS-KSKE_0805_2.0X1.25X0.6(LXWXH)
R4: 0.1Ohm; WRIS-KSKE_0805_2.0X1.25X0.6(LXWXH)

Connections:
3.3V: CN3.14, D1(BLAU).2 (+), D2(GELB).2 (+), D3(GRüN).2 (+), J2.3, J2.5, J4.3, J4.5
5V: J2.1, J4.1
+12V: J1.1, J1.2, J3.1, J3.2, R5.2
ADC-INPUT: C1.2, CN3.6, R5.1, R6.2
CTS: CN4.13, J2.9, J4.9
ERROR1: CN4.14, J2.11, J4.11
ERROR2: CN4.15, J2.12, J4.12
GND: C1.1, CN3.2, CN4.4, J1.3, J1.4, J2.2, J2.4, J3.3, J3.4, J4.2, J4.4, R4.2, R6.1
GPIO_D1: CN3.9, R1.1
GPIO_D2: CN3.11, R2.1
GPIO_D3: CN3.12, R3.1
IRQ: CN4.6, J2.10, J4.10, R4.1
unnamed: D1(BLAU).1 (-), R1.2
unnamed: D2(GELB).1 (-), R2.2
unnamed: D3(GRüN).1 (-), R3.2
RTS: CN4.5, J2.8, J4.8
RX: CN4.2, J2.6, J4.6
TX: CN4.1, J2.7, J4.7

Notes on the sheet:
Nucleo G431KB
Team 2 - Regelung
User-Unit-Slave
In der Au / Neumeister
Platinenlayout_V1_Regelung
23.03.2021

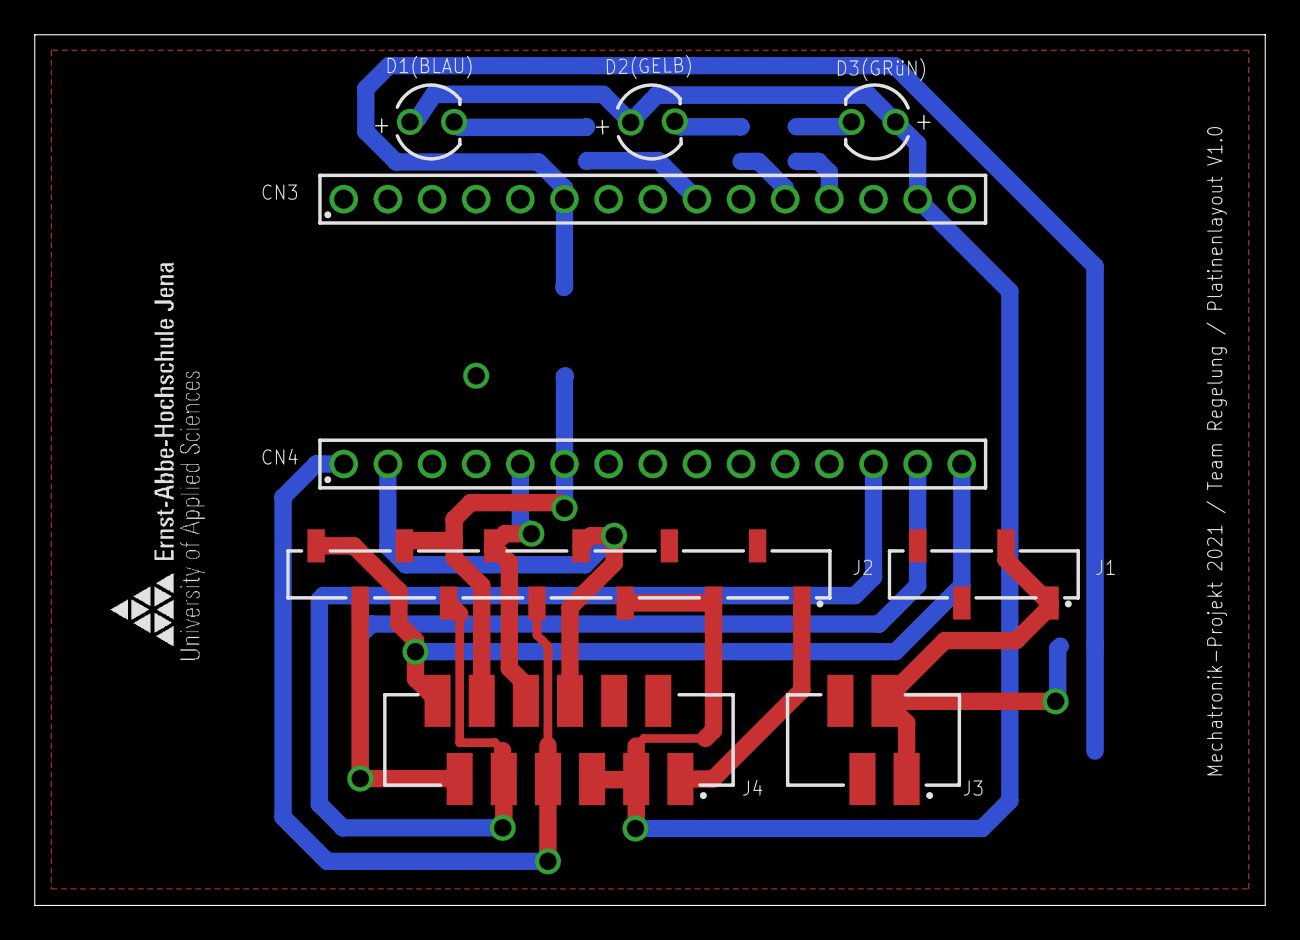
[picture p140: board Control.brd from above]

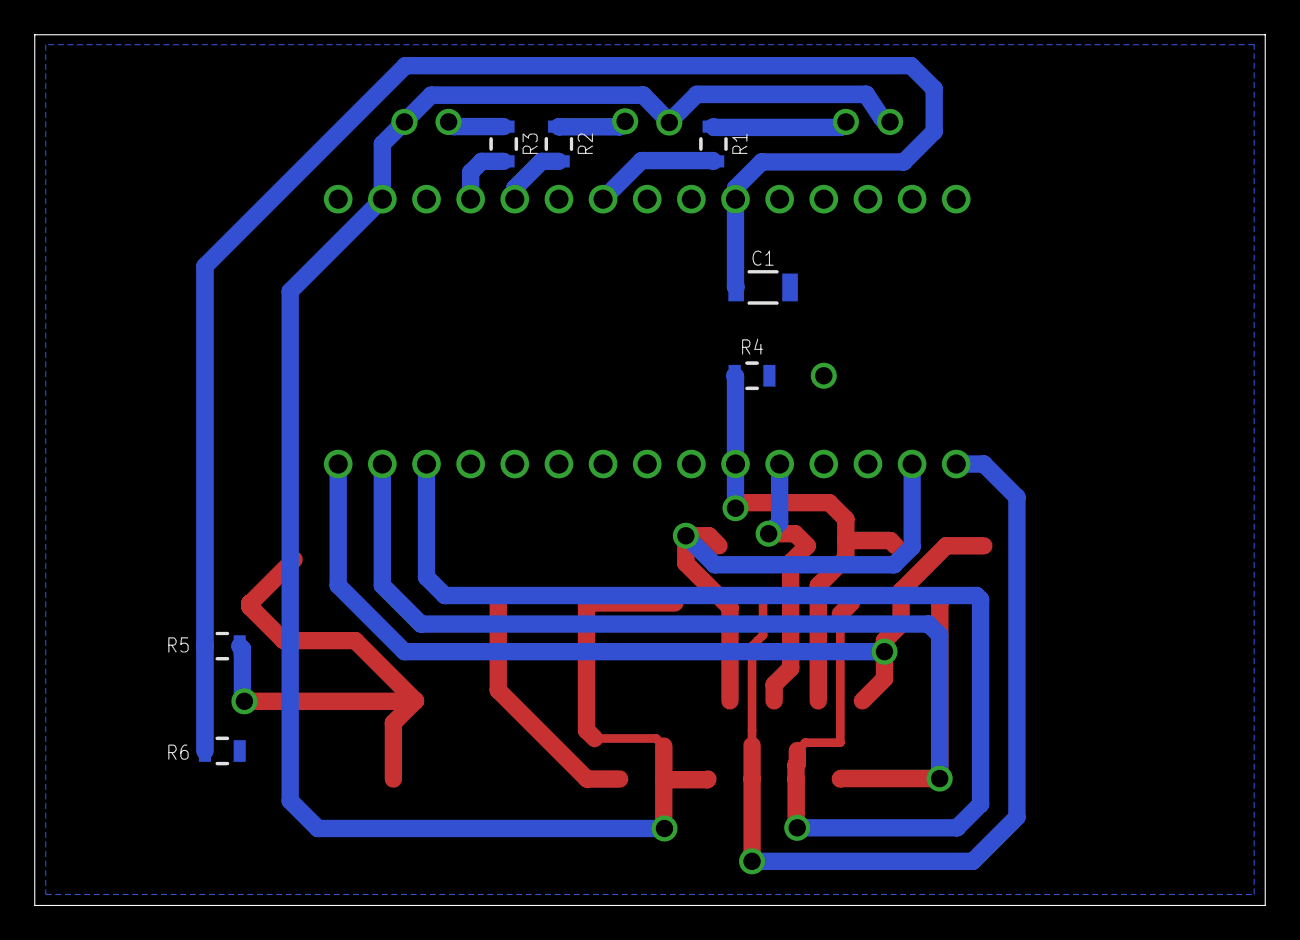
[picture p141: board Control.brd from below]

Board: 2 copper layers, 70.8 x 50.1 mm, 16 parts (7 on the bottom side), 18 nets.
