s2chhaen/USV/01 Hardware/05 IMU/02 Hardware/02 sheet/USV-BG-002-SP-A.brd

## EAGLE design 01 Hardware/05 IMU/02 Hardware/02 sheet/USV-BG-002-SP-A.brd (2023-11-06)

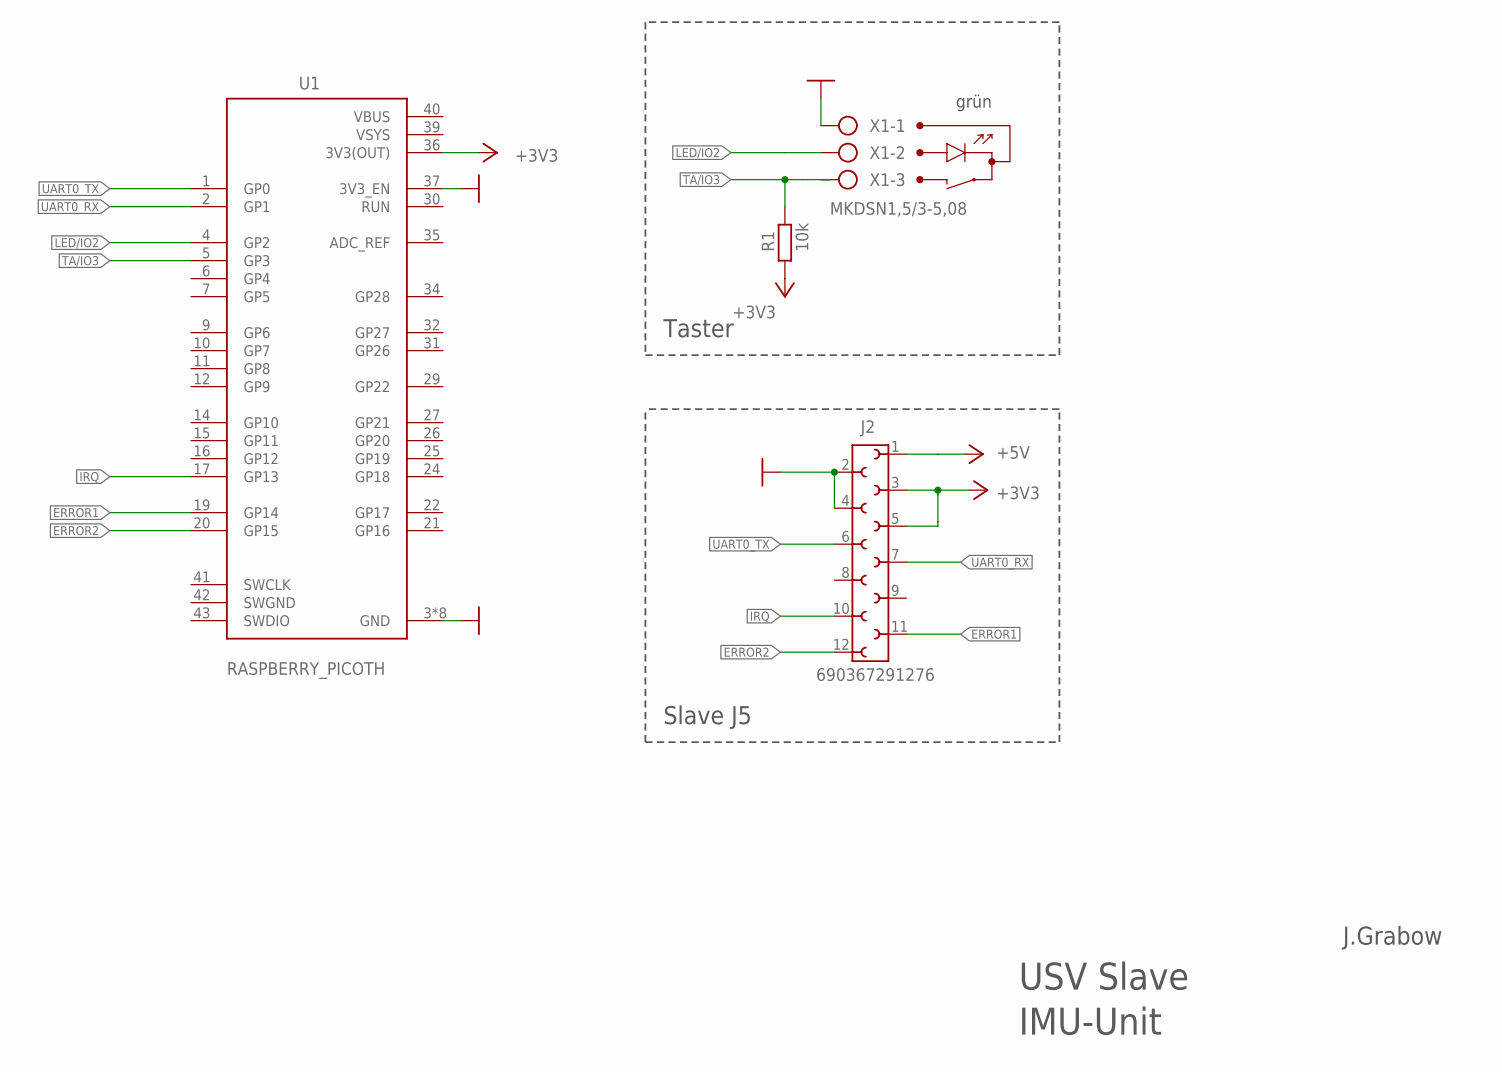
[picture p142: schematic USV-BG-002-SP-A.sch]

Parts:
J2: 690367291276
R1: 10k; M0805
U1: RASPBERRY_PICOTH; PICO-PKG-TH
X1: MKDSN1,5/3-5,08

Connections:
+3V3: J2.3, J2.5, R1.1, U1.36 (3V3(OUT))
+5V: J2.1
ERROR1: J2.11, U1.19 (GP14)
ERROR2: J2.12, U1.20 (GP15)
GND: J2.2, J2.4, U1.3 (GND), U1.8 (GND), U1.13 (GND), U1.18 (GND), U1.23 (GND), U1.28 (GND), U1.33 (GND), U1.37 (3V3_EN), U1.38 (GND), X1.1
IRQ: J2.10, U1.17 (GP13)
LED/IO2: U1.4 (GP2), X1.2
SWGND: U1.42 (SWGND)
TA/IO3: R1.2, U1.5 (GP3), X1.3
UART0_RX: J2.7, U1.2 (GP1)
UART0_TX: J2.6, U1.1 (GP0)
VBUS: U1.40 (VBUS)
VSYS: U1.39 (VSYS)

Notes on the sheet:
Taster
IMU-Unit
USV Slave
J.Grabow
Slave J5
grün

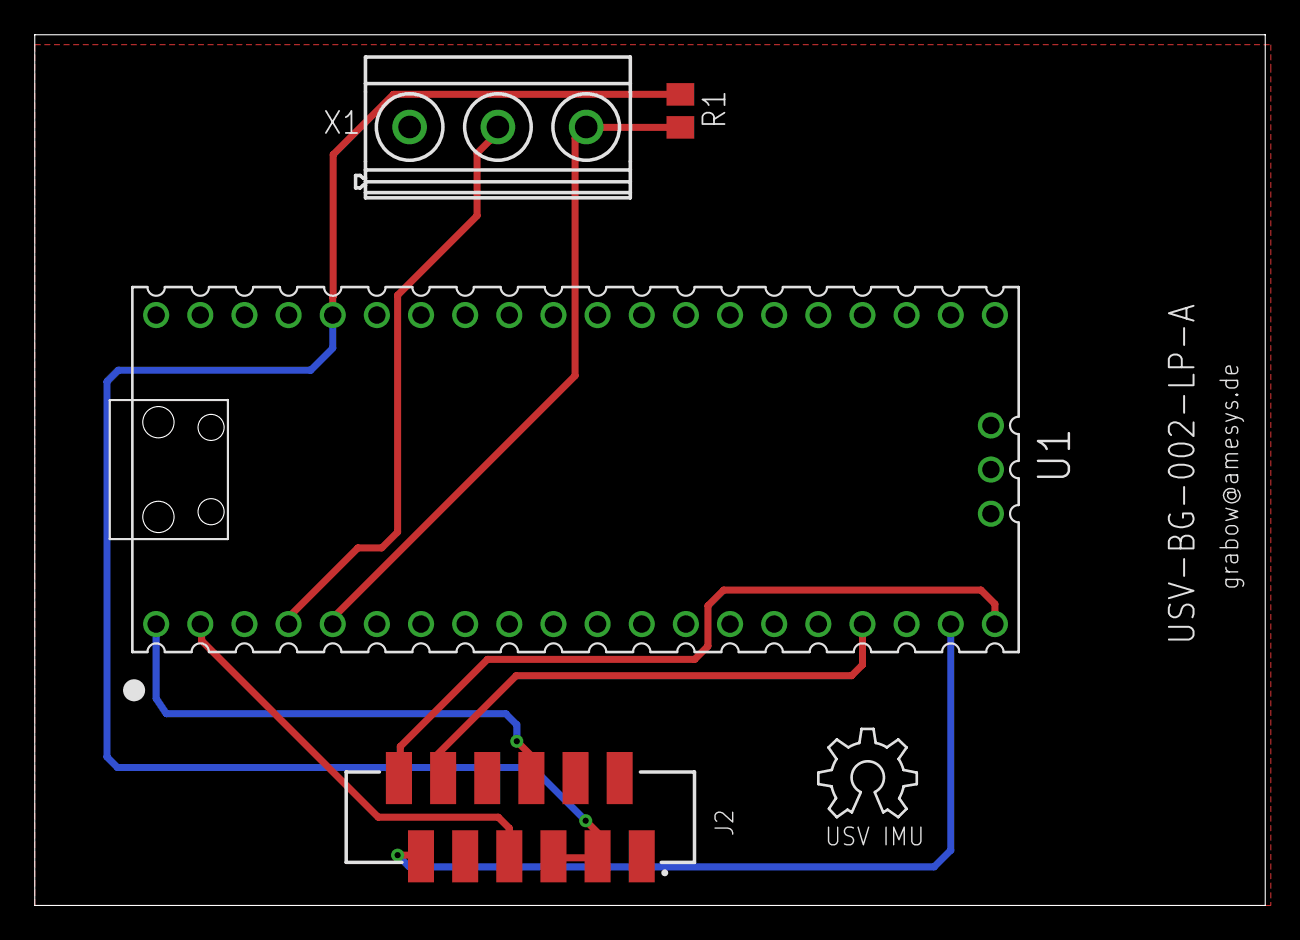
[picture p143: board 01 Hardware/05 IMU/02 Hardware/02 sheet/USV-BG-002-SP-A.brd from above]

Board: 2 copper layers, 70.8 x 50.1 mm, 5 parts (0 on the bottom side), 9 nets.

Other parts of the board:
U$1: OSHW_6X200_NOTEXT
