s2chhaen/USV/01 Hardware/03 APRS/02 Hardware/01 sheet/USV-BG-001-SP-A.brd

## EAGLE design 01 Hardware/03 APRS/02 Hardware/01 sheet/USV-BG-001-SP-A.brd (2023-11-03)

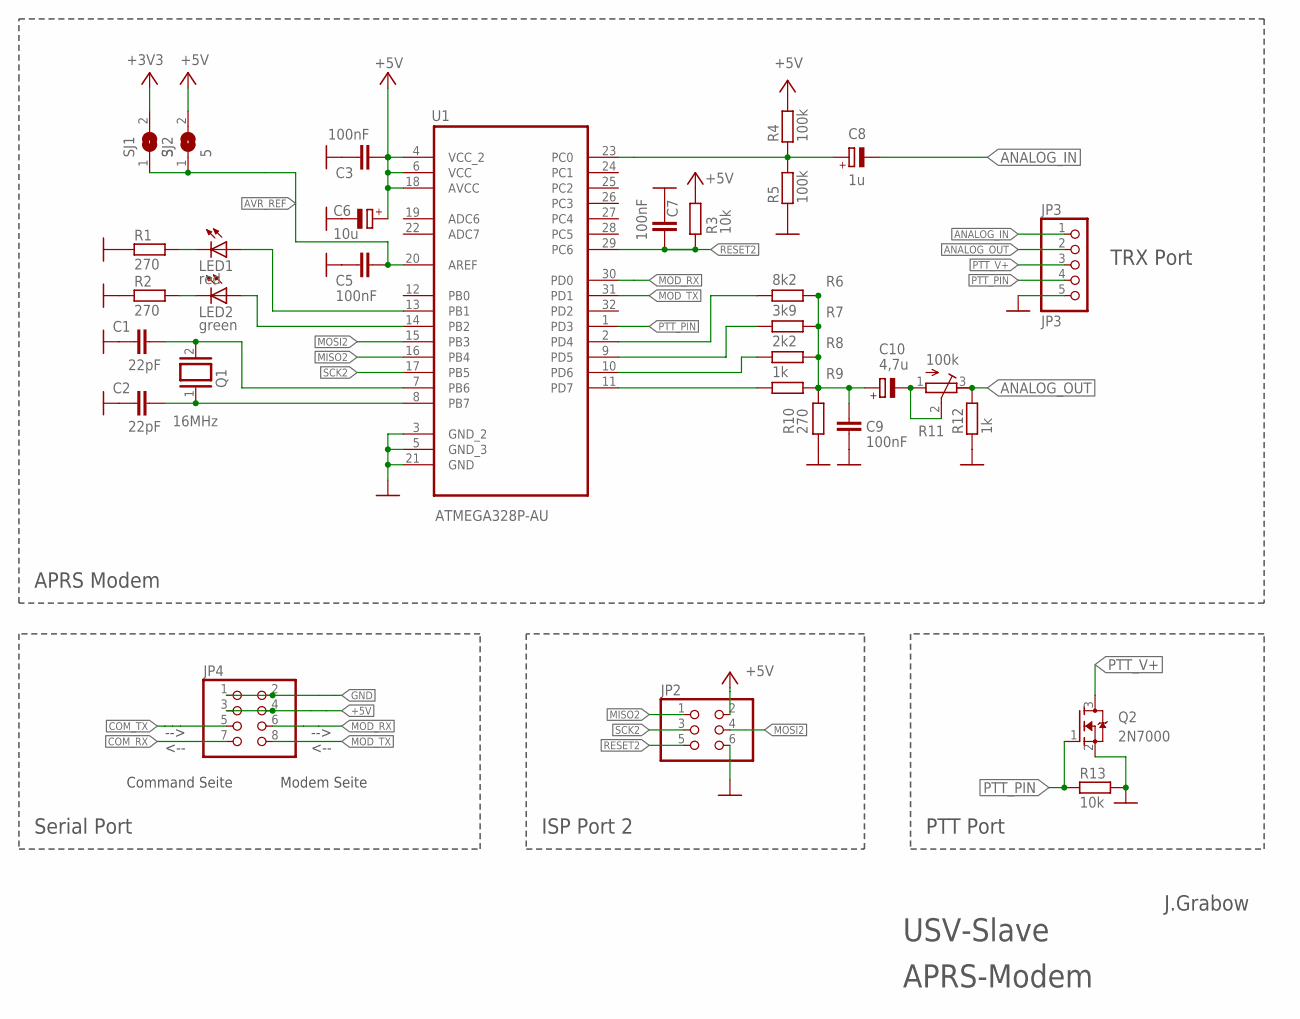
[picture p144: schematic USV-BG-001-SP-A.sch, sheet 1]

Parts:
C1, C2: 22pF; C0805
C3, C5, C7, C9: 100nF; C0805
C6: 10u; SMC_B
C8: 1u; SMC_B
C10: 4,7u; SMC_B
JP2: PINHD-2X3; 2X03
JP3: JP3; 1X05
JP4: PINHD-2X4; 2X04
LED1: red; LED_1206
LED2: green; LED_1206
Q1: 16MHz; QS
Q2: 2N7000; SOT23
R1, R2, R10: 270; R0805
R3, R13: 10k; R0805
R4, R5: 100k; R0805
R6: 8k2; R0805
R7: 3k9; R0805
R8: 2k2; R0805
R9, R12: 1k; R0805
R11: 100k; RTRIM3339P
SJ1: 3; SJ
SJ2: 5; SJ
U1: ATMEGA328P-AU; QFP80P900X900X120-32N

Connections:
+3V3: SJ1.2; also elsewhere on the board
+5V: C3.2, C6.+, JP2.2, JP4.3, JP4.4, R3.1, R4.2, SJ2.2, U1.4 (VCC_2), U1.6 (VCC), U1.18 (AVCC); also elsewhere on the board
ADC0: C8.+, R4.1, R5.2, U1.23 (PC0)
ANALOG_IN: C8.-, JP3.1
ANALOG_OUT: JP3.2, R11.3 (E), R12.2
AVR_REF: C5.2, SJ1.1, SJ2.1, U1.20 (AREF)
COM_RX: JP4.7; also elsewhere on the board
COM_TX: JP4.5; also elsewhere on the board
DAC_1: R6.2, U1.2 (PD4)
DAC_2: R7.2, U1.9 (PD5)
DAC_3: R8.2, U1.10 (PD6)
DAC_4: R9.2, U1.11 (PD7)
GND: C1.2, C2.2, C3.1, C5.1, C6.-, C7.1, C9.2, JP2.6, JP3.5, JP4.1, JP4.2, Q2.2 (S), R1.1, R2.1, R5.1, R10.1, R12.1, R13.2, U1.3 (GND_2), U1.5 (GND_3), U1.21 (GND); also elsewhere on the board
MISO2: JP2.1, U1.16 (PB4)
MOD_RX: JP4.6, U1.30 (PD0)
MOD_TX: JP4.8, U1.31 (PD1)
MOSI2: JP2.4, U1.15 (PB3)
unnamed: C1.1, Q1.2, U1.7 (PB6)
unnamed: C9.1, C10.+, R6.1, R7.1, R8.1, R9.1, R10.2
unnamed: LED2.C, R2.2
unnamed: LED2.A, U1.14 (PB2)
unnamed: C10.-, R11.1 (A), R11.2 (S)
unnamed: LED1.A, U1.13 (PB1)
unnamed: C2.1, Q1.1, U1.8 (PB7)
unnamed: LED1.C, R1.2
PTT_PIN: JP3.4, Q2.1 (G), R13.1, U1.1 (PD3)
PTT_V+: JP3.3, Q2.3 (D)
RESET2: C7.2, JP2.5, R3.2, U1.29 (PC6)
SCK2: JP2.3, U1.17 (PB5)

Notes on the sheet:
Modem Seite
Command Seite
Serial Port
ISP Port 2
PTT Port
APRS Modem
TRX Port
APRS-Modem
J.Grabow
-->
<--
USV-Slave

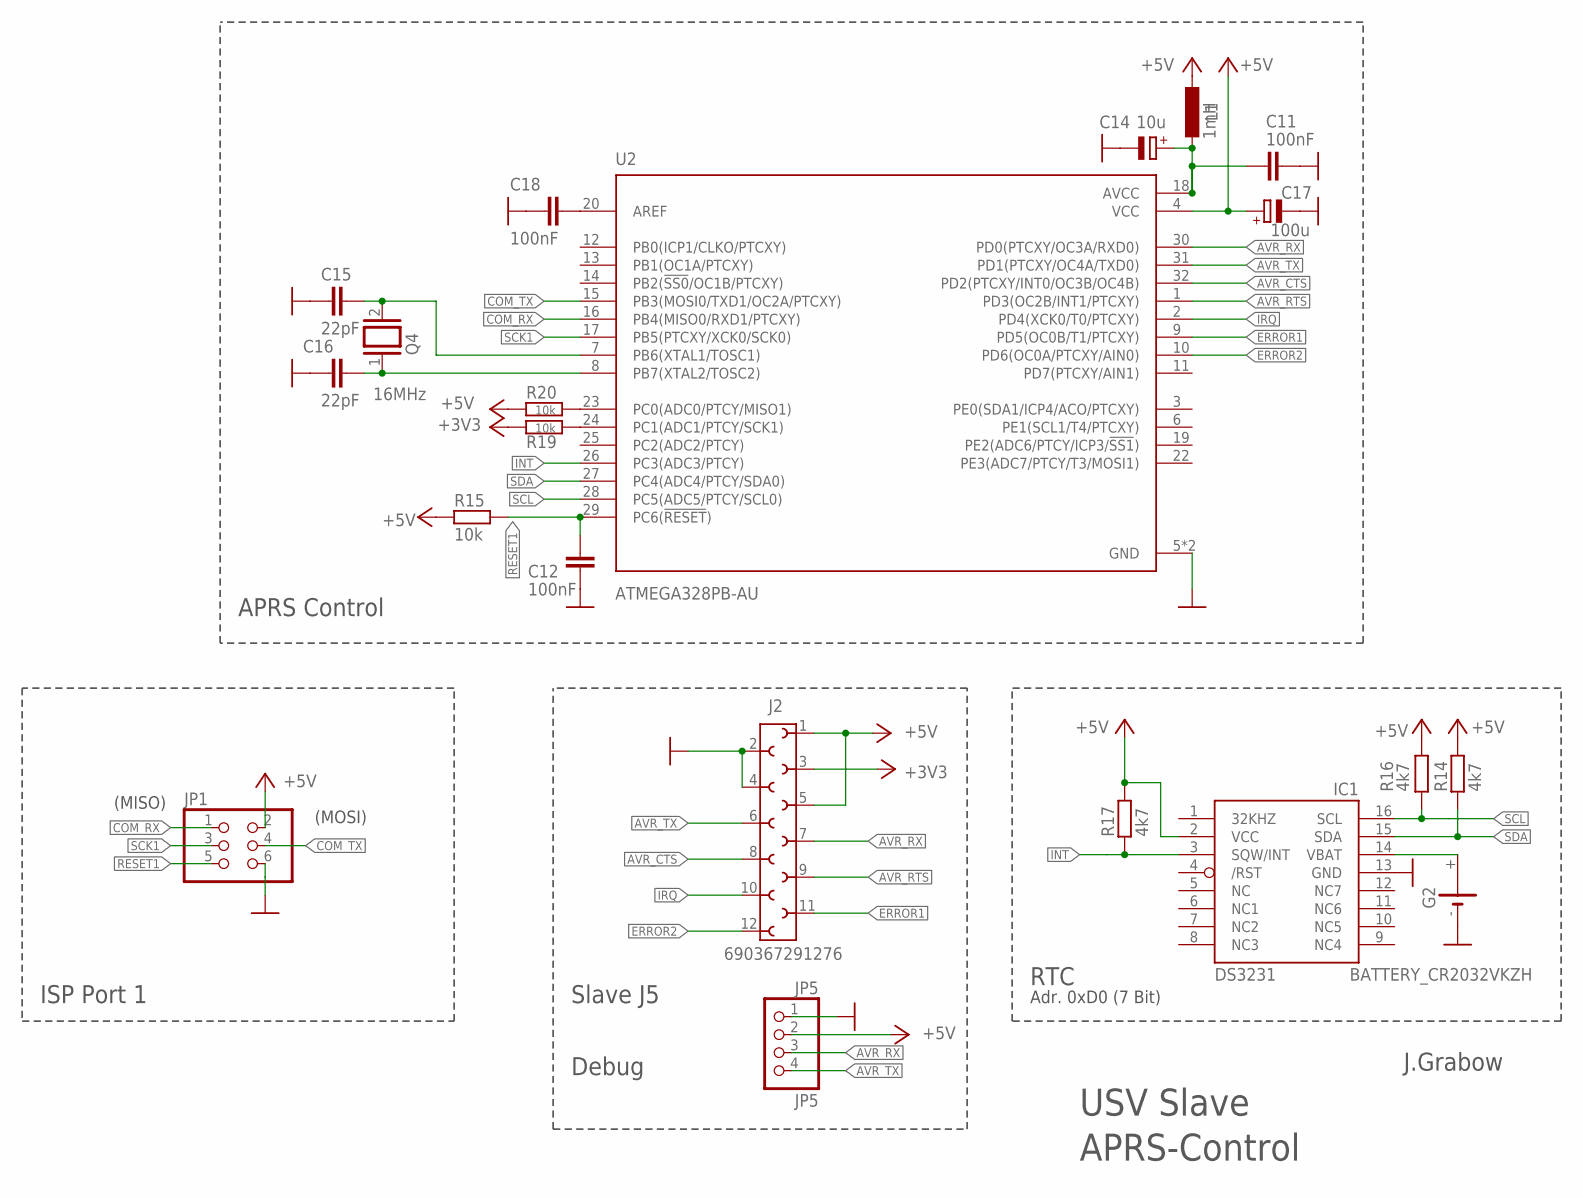
[picture p145: schematic USV-BG-001-SP-A.sch, sheet 2]

Parts:
C11, C12, C18: 100nF; C0805
C14: 10u; SMC_B
C15, C16: 22pF; C0805
C17: 100u; SMC_B
G2: BATTERY_CR2032VKZH; BATTERY_KZH20PCB-V
IC1: DS3231/SO; SO16W
J2: 690367291276
JP1: PINHD-2X3; 2X03
JP5: JP5; 1X04
L1: 1mH; L1812
Q4: 16MHz; QS
R14, R16, R17: 4k7; R0805
R15, R19, R20: 10k; R0805
U2: ATMEGA328PB-AU; QFP80P900X900X120-32N

Connections:
+3V3: J2.3, R19.1; also elsewhere on the board
+5V: C17.+, IC1.2 (VCC), J2.1, J2.5, JP1.2, JP5.2, L1.1, R14.2, R15.1, R16.2, R17.2, R20.1, U2.4 (VCC); also elsewhere on the board
AVR_CTS: J2.8, U2.32 (PD2(PTCXY/INT0/OC3B/OC4B))
AVR_RTS: J2.9, U2.1 (PD3(OC2B/INT1/PTCXY))
AVR_RX: J2.7, JP5.3, U2.30 (PD0(PTCXY/OC3A/RXD0))
AVR_TX: J2.6, JP5.4, U2.31 (PD1(PTCXY/OC4A/TXD0))
COM_RX: JP1.1, U2.16 (PB4(MISO0/RXD1/PTCXY)); also elsewhere on the board
COM_TX: JP1.4, U2.15 (PB3(MOSI0/TXD1/OC2A/PTCXY)); also elsewhere on the board
ERROR1: J2.11, U2.9 (PD5(OC0B/T1/PTCXY))
ERROR2: J2.12, U2.10 (PD6(OC0A/PTCXY/AIN0))
GND: C11.2, C12.2, C14.-, C15.2, C16.2, C17.-, C18.1, G2.-, IC1.13 (GND), J2.2, J2.4, JP1.6, JP5.1, U2.5 (GND), U2.21 (GND); also elsewhere on the board
INT: IC1.3 (SQW/INT), R17.1, U2.26 (PC3(ADC3/PTCY))
IRQ: J2.10, U2.2 (PD4(XCK0/T0/PTCXY))
unnamed: C16.1, Q4.1, U2.8 (PB7(XTAL2/TOSC2))
unnamed: C15.1, Q4.2, U2.7 (PB6(XTAL1/TOSC1))
unnamed: G2.+, IC1.14 (VBAT)
unnamed: C11.1, C14.+, L1.2, U2.18 (AVCC)
unnamed: C18.2, U2.20 (AREF)
unnamed: R20.2, U2.23 (PC0(ADC0/PTCY/MISO1))
unnamed: R19.2, U2.24 (PC1(ADC1/PTCY/SCK1))
RESET1: C12.1, JP1.5, R15.2, U2.29 (PC6(!RESET!))
SCK1: JP1.3, U2.17 (PB5(PTCXY/XCK0/SCK0))
SCL: IC1.16 (SCL), R16.1, U2.28 (PC5(ADC5/PTCY/SCL0))
SDA: IC1.15 (SDA), R14.1, U2.27 (PC4(ADC4/PTCY/SDA0))

Notes on the sheet:
ISP Port 1
(MOSI)
(MISO)
APRS-Control
USV Slave
J.Grabow
Slave J5
APRS Control
RTC
Adr. 0xD0 (7 Bit)
Debug

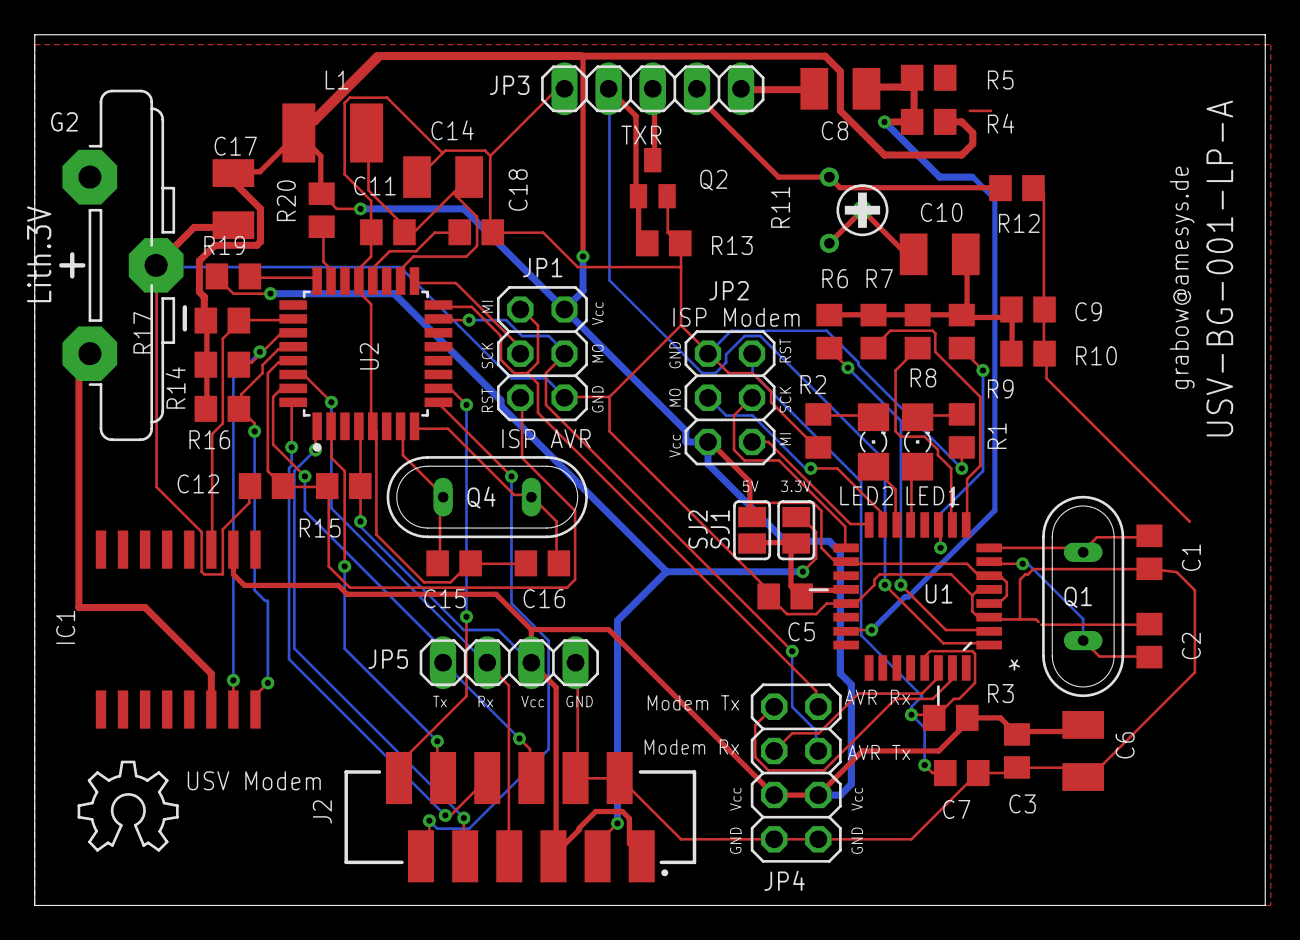
[picture p146: board USV-BG-001-SP-A.brd from above]

Board: 2 copper layers, 70.8 x 50.1 mm, 54 parts (0 on the bottom side), 48 nets.

Other parts of the board:
U$1: OSHW_6X200_NOTEXT
