s2chhaen/USV/01 Hardware/05 IMU/02 Hardware/99 production/USV-BG-002-SP-A.brd

## EAGLE design 01 Hardware/05 IMU/02 Hardware/99 production/USV-BG-002-SP-A.brd (2023-11-27)

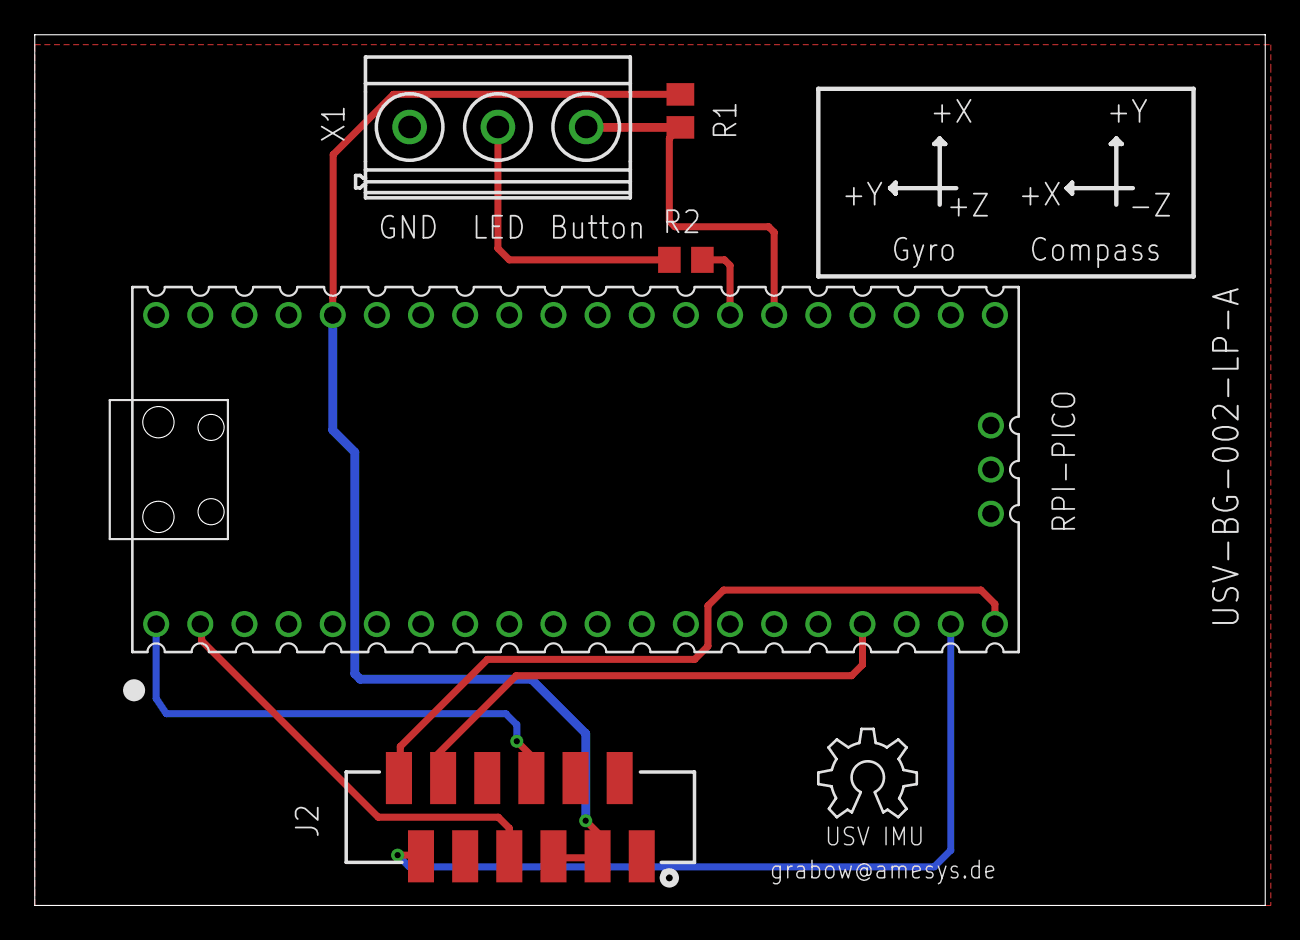
[picture p147: board 01 Hardware/05 IMU/02 Hardware/99 production/USV-BG-002-SP-A.brd from above]

Board: 2 copper layers, 70.8 x 50.1 mm, 6 parts (0 on the bottom side), 10 nets.

Parts:
J2: 690367291276
R1: 10k; M0805
R2: 0; R0805
RPI-PICO: RASPBERRY_PICOTH; PICO-PKG-TH
U$1: OSHW_6X200_NOTEXT
X1: MKDSN1,5/3-5,08

Connections:
+3V3: J2.3, J2.5, R1.1, RPI-PICO.36
ERROR1: J2.11, RPI-PICO.19
ERROR2: J2.12, RPI-PICO.20
GND: J2.2, J2.4, RPI-PICO.3, RPI-PICO.8, RPI-PICO.13, RPI-PICO.18, RPI-PICO.23, RPI-PICO.28, RPI-PICO.33, RPI-PICO.37, RPI-PICO.38, X1.1
IRQ: J2.10, RPI-PICO.17
LED: R2.1, RPI-PICO.27
LED/IO2A: R2.2, X1.2
TA: R1.2, RPI-PICO.26, X1.3
UART0_RX: J2.7, RPI-PICO.2
UART0_TX: J2.6, RPI-PICO.1
