s2chhaen/USV/01 Hardware/01 Lidar/02 Hardware/02 board/Uni_Seriell.brd

## EAGLE design 01 Hardware/01 Lidar/02 Hardware/02 board/Uni_Seriell.brd (2023-06-07)

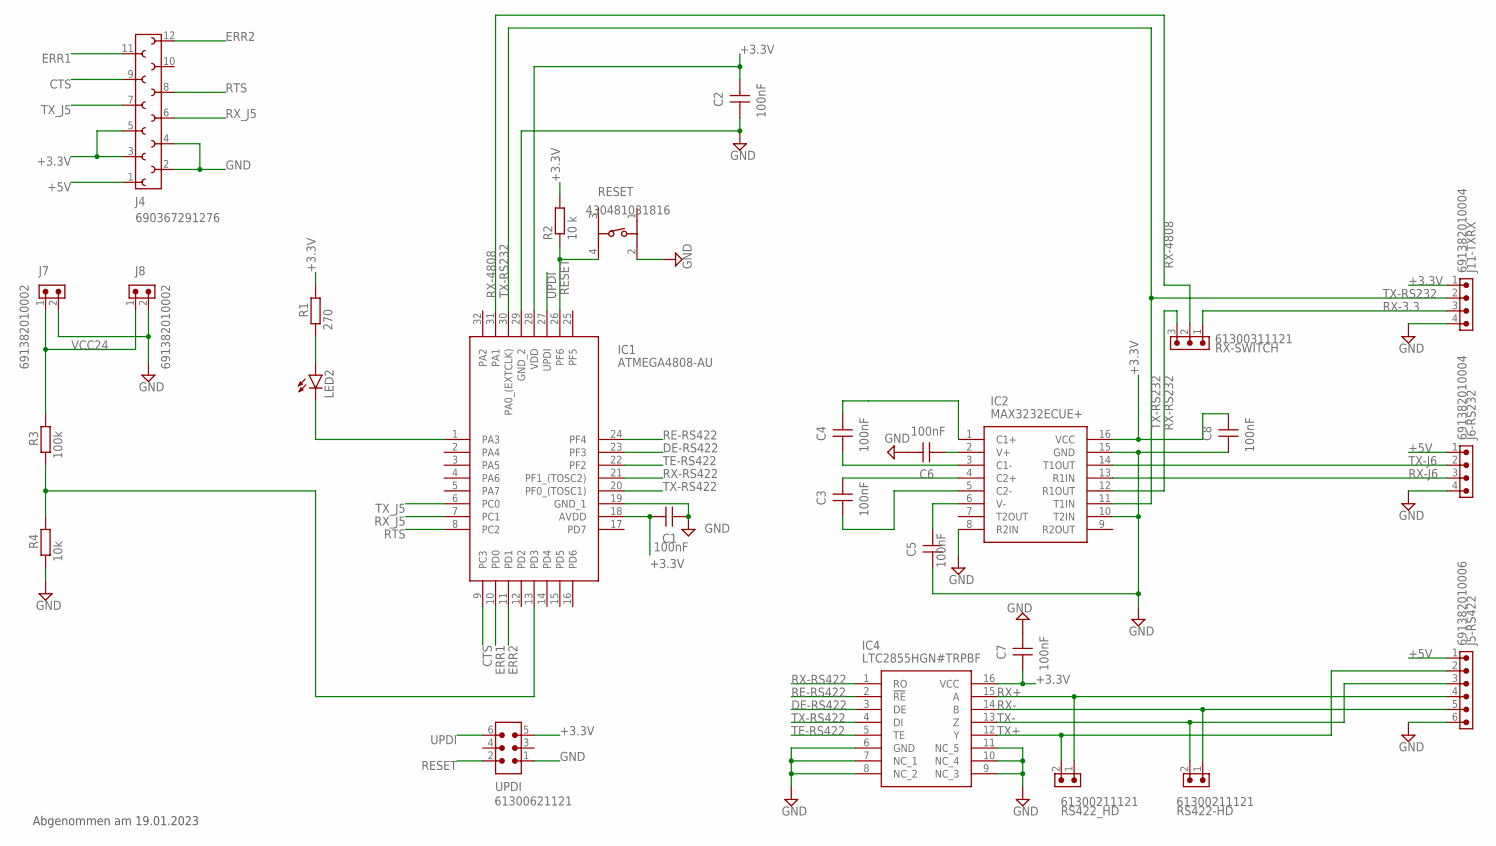
[picture p148: schematic Uni_Seriell.sch]

Parts:
C1, C2, C3, C4, C5, C6, C7, C8: 100nF; WCAP-CSST_0805
IC1: ATMEGA4808-AU; QFP80P900X900X120-32N
IC2: MAX3232ECUE+; SOP65P640X110-16N
IC4: LTC2855HGN#TRPBF; SOP64P601X175-16N
J4: 690367291276
J5-RS422: 691382010006
J6-RS232, J11-TXRX: 691382010004
J7, J8: 691382010002
LED2: LEDCHIP-LED0805; CHIP-LED0805
R1: 270; R0805
R2: 10 k; R0805
R3: 100k; R0805
R4: 10k; R0805
RESET: 430481031816
RS422-HD, RS422_HD: 61300211121
RX-SWITCH: 61300311121
UPDI: 61300621121

Connections:
+3.3V: C1.2, C2.2, C7.1, C8.2, IC1.18 (AVDD), IC1.28 (VDD), IC2.16 (VCC), IC4.16 (VCC), J4.3, J4.5, J11-TXRX.1, R1.2, R2.2, UPDI.5
+5V: J4.1, J5-RS422.1, J6-RS232.1
CTS: IC1.9 (PC3), J4.9
DE-RS422: IC1.23 (PF3), IC4.3 (DE)
ERR1: IC1.10 (PD0), J4.11
ERR2: IC1.11 (PD1), J4.12
GND: C1.1, C2.1, C5.1, C6.2, C7.2, C8.1, IC1.19 (GND_1), IC1.29 (GND_2), IC2.8 (R2IN), IC2.10 (T2IN), IC2.15 (GND), IC4.6 (GND), IC4.7 (NC_1), IC4.8 (NC_2), IC4.9 (NC_3), IC4.10 (NC_4), IC4.11 (NC_5), J4.2, J4.4, J5-RS422.6, J6-RS232.4, J7.2, J8.2, J11-TXRX.4, R4.1, RESET.2, UPDI.1
unnamed: IC1.13 (PD3), R3.1, R4.2
unnamed: IC1.1 (PA3), LED2.C
unnamed: LED2.A, R1.1
unnamed: C5.2, IC2.6 (V-)
unnamed: C6.1, IC2.2 (V+)
unnamed: C3.2, IC2.4 (C2+)
unnamed: C3.1, IC2.5 (C2-)
unnamed: C4.1, IC2.3 (C1-)
unnamed: C4.2, IC2.1 (C1+)
RE-RS422: IC1.24 (PF4), IC4.2 (!RE)
RESET: IC1.26 (PF6), R2.1, RESET.4, UPDI.2
RTS: IC1.8 (PC2), J4.8
RX+: IC4.15 (A), J5-RS422.4, RS422_HD.1
RX-: IC4.14 (B), J5-RS422.5, RS422-HD.1
RX-3.3: J11-TXRX.3, RX-SWITCH.1
RX-4808: IC1.31 (PA1), RX-SWITCH.2
RX-J6: IC2.13 (R1IN), J6-RS232.3
RX-RS232: IC2.12 (R1OUT), RX-SWITCH.3
RX-RS422: IC1.21 (PF1_(TOSC2)), IC4.1 (RO)
RX_J5: IC1.7 (PC1), J4.6
TE-RS422: IC1.22 (PF2), IC4.5 (TE)
TX+: IC4.12 (Y), J5-RS422.2, RS422_HD.2
TX-: IC4.13 (Z), J5-RS422.3, RS422-HD.2
TX-J6: IC2.14 (T1OUT), J6-RS232.2
TX-RS232: IC1.30 (PA0_(EXTCLK)), IC2.11 (T1IN), J11-TXRX.2
TX-RS422: IC1.20 (PF0_(TOSC1)), IC4.4 (DI)
TX_J5: IC1.6 (PC0), J4.7
UPDI: IC1.27 (UPDI), UPDI.6
VCC24: J7.1, J8.1, R3.2

Notes on the sheet:
Abgenommen am 19.01.2023

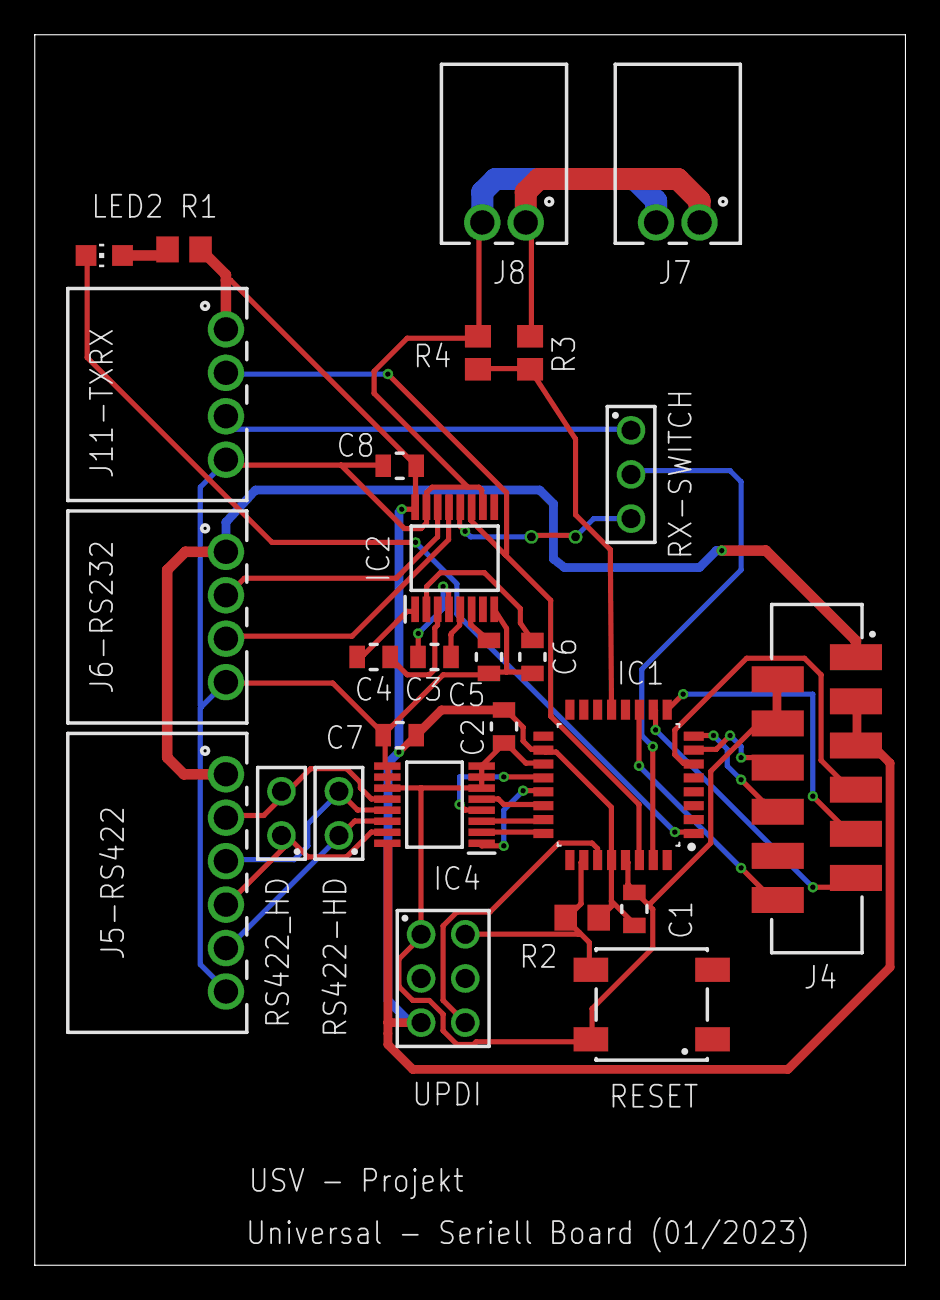
[picture p149: board Uni_Seriell.brd from above]

Board: 2 copper layers, 50.1 x 70.8 mm, 27 parts (0 on the bottom side), 36 nets.
