s2chhaen/USV/01 Hardware/01 Lidar/03 Software/01 source/lidarProtocolHandler/main.c

/**
 * main.c
 * Description: Hauptdatei, wo das Hauptprogramm implementiert wird,
 * für Versuch im Abschnitt 6.1.2 (Dokumentation)
 * Author: Thach
 * Created: 10/07/2023
 * Version: 1.0
 * Revision: 1.0
 */

#include <stdio.h>
#include <stdlib.h>
#include <stdint.h>
#include <inttypes.h>
#include <math.h>
#include "ioModul.h"
#include "protocol.h"
#include "filter_FIR.h"
#include "FilterCoefs/wr_qFormFilterCof.h"

int main()
{
    uint8_t data[1024] = {0};
    uint16_t dataLen = sizeof(data)/sizeof(uint8_t);
//#define SEG_0_ACTIVE
#ifdef SEG_0_ACTIVE
    readFile("31h-LMS-Status-anfordern.txt");
    getData(data,&dataLen);
    checkConfig(data,dataLen);
    dataLen = sizeof(data)/sizeof(uint8_t);
#endif // SEG_0_ACTIVE

#define SEG_1_ACTIVE
#ifdef SEG_1_ACTIVE
    uint8_t protocolCheck = 0;
    int32_t measuredVal[800] = {0};
    uint16_t measuredValLen = sizeof(measuredVal)/sizeof(int32_t);
    int64_t output[800] = {0};
    //Messwerte lesen
    readFile("30h-01h-Messwerte-anfordern.txt");
    getData(data,&dataLen);
    protocolCheck = checkData(data,dataLen);
    dataLen = sizeof(data)/sizeof(uint8_t);
    if(protocolCheck){
        getExtractedData(measuredVal,&measuredValLen);
    }
    for(int i = 0; i < measuredValLen; i++){
        measuredVal[i] <<= FIXED_POINT_BITS;

    }
    //schreiben der ungefilterten Daten in Matlab-Ordner
    writeFileInt32((uint8_t*)"../Lidar-Algorithmus/lidarValues_raw", \
                   sizeof("../Lidar-Algorithmus/lidarValues_raw")/sizeof(uint8_t), \
                   TEXT_FORM, measuredVal,measuredValLen);
    //Filterung mit FIR-Filter
    fir_init((int16_t*)wr_num,wr_numLen);
    fir_runFiP(measuredVal,output,measuredValLen);
    //schreiben der gefilterten Daten in Matlab-Ordner
    writeFileInt64((uint8_t*)"../Lidar-Algorithmus/lidarValues_filtered", \
                   sizeof("../Lidar-Algorithmus/lidarValues_filtered")/sizeof(uint8_t), \
                   TEXT_FORM, output,measuredValLen);
#endif // SEG_1_ACTIVE
    printf("Ausgabe in .\\01 Hardware\\01 Lidar\\03 Software\\01 source\\Lidar-Algorithmus");
    return 0;
}
