s2chhaen/USV/01 Hardware/05 IMU/03 Software/01 master/imu.py

# coding: utf-8
"""
Program history
06.11.2023    V. 1.0    Start

IMU measuring system for USV project
https://github.com/Joe-Grabow/USV

@author: Joe Grabow (grabow@amesys.de)
"""
__version__ = '1.0'
__author__ = 'Joe Grabow'

import ujson
from machine import Timer, Pin
from picozero import Button
from time import sleep

led = Pin(2, Pin.OUT, value=0)  # GPIO2 for LED
button = Button(3)  # GPIO3 for Calibration Button

def flash(state):
    if state == 0:  # LED off
        blink.deinit()  # flash off
        led.off()
    elif state == 1:  # flash slow
        blink.init(period=500, mode=Timer.PERIODIC, callback=lambda t:led.value(not led.value()))
    elif state == 2:  # flash fast
        blink.init(period=200, mode=Timer.PERIODIC, callback=lambda t:led.value(not led.value()))
    elif state == 3:  # LED on
        blink.deinit()  # flash off
        led.on()  
    return()

def wait_for_press():
    while not button.is_pressed:
        pass

# sub-programme for calibration
def calibration():
        print("state 1: device horizontal")
        flash(1)
        sleep(1)
        wait_for_press()
        
        print("state 2: device horizontal and rotate z axis 180 degrees")
        flash(2)
        sleep(1)
        wait_for_press()
        
        print("state 3: flip device and keep it horizontal")
        flash(3)

# sub-programme for measurement
def measurement():
        print("Measurement")

def save_cal_data(c_data):
    with open('cal_data.json', 'w') as data:
        ujson.dump(c_data, data)
    
def load_cal_data():
    with open('cal_data.json', 'r') as data:
        c_data = ujson.load(data)
    return(c_data)


blink = Timer(period=500, mode=Timer.PERIODIC, callback=lambda t:led.value(not led.value()))
flash(0)

cal_flag = 0
cal_data = [cal_flag, 0, 0, 0]
save_cal_data(cal_data)
cal_data = load_cal_data()
print(cal_data)

while True:
    sleep(0.2)
    if button.is_pressed:
        calibration()
    else:
        measurement()
