s2chhaen/USV/01 Hardware/02 Radar/03 Software/01 source/RadarMain/RadarMain/main.h

/*
 * main.h
 * Description: Header-Datei der main.c-Datei
 * Created: 12/13/2023 2:55:29 PM
 * Author: Thach
 * Version: 1.1
 * Revision: 1.2
 */ 


#ifndef MAIN_H_
#define MAIN_H_

#include <avr/io.h>
#include <avr/interrupt.h>
#include <stdio.h>
#include <stdlib.h>
#include "radarHandler.h"
#include "registerModel.h"
#include "usvDataHandler.h"
#include "radarDataPrc.h"
#include "comConfig.h"

#define USV_CHECKSUM_POLYNOM 0xD5

#endif /* MAIN_H_ */
