s2chhaen/USV/01 Hardware/06 energy_management/01 Firmware/GccApplication3/GccApplication2/ATMegaXX09/Port/Port.c

////////////////////////////////////////////////////////////////////////////////////////////////////
// Port.c
//
// Created: 11.09.2020 16:55:22
//  Author: franke
////////////////////////////////////////////////////////////////////////////////////////////////////
