s2chhaen/USV/01 Hardware/06 energy_management/01 Firmware/GccApplication3/GccApplication2/ATMegaXX09/Port/USART_config.h

////////////////////////////////////////////////////////////////////////////////////////////////////
//
// USART_config.h
//  (Beta) für USART 1-4
// Created: 07.09.2019 10:56:22
//  Author: franke
//
//////////////////////////////////////////////////////////////////////////////////////////////////// 


#ifndef USART_CONFIG_H_
#define USART_CONFIG_H_

////////////////////////////////////////////////////////////////////////////////////////////////////
// Config Code
////////////////////////////////////////////////////////////////////////////////////////////////////
// Eventsystem aktivieren (1) oder deaktivieren (0)
#define USART_USE_EVENTSYSTEM 1
// Pfad zu Event-Headerdatei
#define USART_EVENTSYSTEM_HEADER "..\..\Eventsystem\Eventsystem.h"

////////////////////////////////////////////////////////////////////////////////////////////////////
// End Config Code
////////////////////////////////////////////////////////////////////////////////////////////////////

#endif /* USART_CONFIG_H_ */

// EOF //
