s2chhaen/USV/01 Hardware/06 energy_management/01 Firmware/GccApplication3/GccApplication2/ATMegaXX09/USART/ATMegaXX09Clock.h

////////////////////////////////////////////////////////////////////////////////////////////////////
// ATMegaXX09Clock.h
//
// Created: 15.11.2019 15:30:00
//  Author: franke
// Update: 27.04.2022 13:27:55
//  Create Timeout for the external 32kHz Crystal
////////////////////////////////////////////////////////////////////////////////////////////////////


#ifndef ATMEGAXX09CLOCK_H_
#define ATMEGAXX09CLOCK_H_

#include <stdint.h>

////////////////////////////////////////////////////////////////////////////////////////////////////
// externe Taktquelle
////////////////////////////////////////////////////////////////////////////////////////////////////
#define EXTCLK 0

////////////////////////////////////////////////////////////////////////////////////////////////////
// globale Variable für die CPU Taktrate
////////////////////////////////////////////////////////////////////////////////////////////////////
extern uint32_t CLK_CPU;

////////////////////////////////////////////////////////////////////////////////////////////////////
// Initialisierung des Core Takt mit 20MHz und Starten des externen 32768 Hz Quarzes für den RTC
// Rückgabewert: 0 - Initialisierung des externen Quarz-Oszillator erfolgreich
//				 1 - Initialisierung des externen Quarz-Oszillator fehlgeschlagen (Timeout)
////////////////////////////////////////////////////////////////////////////////////////////////////
uint8_t init_Core_CLK(void);

#endif /* ATMEGAXX09CLOCK_H_ */

//EOF//
