s2chhaen/USV/01 Hardware/06 energy_management/01 Firmware/GccApplication3/GccApplication2/conversation.h

/*
 * IncFile1.h
 *
 * Created: 2023/12/12 15:40:55
 *  Author: 芋泥啵啵奶茶
 */ 


#ifndef INCFILE1_H_
#define INCFILE1_H_

void daten_conversion (char *data, uint8_t *arr);
uint8_t range_conversion (char *data);
void string_from_Frame(uint8_t *data, uint8_t length, char *str_daten);



#endif /* INCFILE1_H_ */
