s2chhaen/USV/01 Hardware/01 Lidar/03 Software/01 source/LidarMain/LidarMain/LidarMain/comConfig.h

/*
 * comConfig.h
 * Description: enthält Struktur zur Konfiguration und Bits-Position in IO-Stream-Register
 * Created: 12/15/2023 10:00:07 AM
 * Author: Thach
 * Version: 1.0
 * Revision: 1.2
 */ 


#ifndef COMCONFIG_H_
#define COMCONFIG_H_

#include <stdint.h>

//IO-Bit-Position
#define STREAM_LIDAR_STATUS_BIT_POS 0
#define STREAM_LIDAR_DATA_BIT_POS 1

/*Struktur für Konfiguration der USART-Einheit*/
typedef struct{
	uint8_t usartNo:2;
	uint32_t baudrate;
	uint8_t usartChSize;
	uint8_t parity;
	uint8_t stopbit;
	uint8_t sync:1;
	uint8_t mpcm:1;
	uint8_t address;
	uint8_t portMux:2;
}usartConfig_t;

enum comProgramPos{
	COM_PROGRAMM_NORMAL_POS, //nicht in interrupt
	COM_PROGRAMM_TX_POS,//in USART-ISR von TX
	COM_PROGRAMM_RX_POS,//in USART-ISR von RX
};
#endif /* COMCONFIG_H_ */
