s2chhaen/USV/01 Hardware/01 Lidar/03 Software/01 source/lidarProtocolHandler/filterConfig.h

/**
 * filterConfig.h
 * Description: Header-Datei zum Speichern der Filter-Parameter
 * Author: Thach
 * Created: 10/08/2023
 * Version: 1.0
 * Revision: 1.0
 */

#ifndef FILTERCONFIG_H_INCLUDED
#define FILTERCONFIG_H_INCLUDED

#define FIXED_POINT_BITS 15
#define CONVERT_FACTOR_INT ((1<<FIXED_POINT_BITS) - 1)
#define OUTPUT_MAX_LEN 512

#endif // FILTERCONFIG_H_INCLUDED
