s2chhaen/USV/01 Hardware/01 Lidar/03 Software/01 source/lidarProtocolHandler/filter_FIR.h

/**
 * filter_FIR.h
 * Description: Header-Datei für Filterungsvorgang
 * Author: Thach
 * Created: 10/08/2023
 * Version: 1.0
 * Revision: 1.0
 */


#ifndef FILTER_FIR_H_INCLUDED
#define FILTER_FIR_H_INCLUDED

#include <string.h>
#include <inttypes.h>
#include <stdio.h>
#include <inttypes.h>
#include <stdint.h>
#include "filterConfig.h"

#define FIR_FILTER_ORDER 3U
#define FIR_OLD_VALUES_BUFFER_LEN_BITS ((FIR_FILTER_ORDER-1U)/2U + 1U)
#define FIR_OLD_VALUES_BUFFER_LEN (1<<FIR_OLD_VALUES_BUFFER_LEN_BITS)

typedef struct{
    int32_t data[FIR_OLD_VALUES_BUFFER_LEN];
    uint8_t beginIdx :FIR_OLD_VALUES_BUFFER_LEN_BITS;
    uint8_t endIdx   :FIR_OLD_VALUES_BUFFER_LEN_BITS;
}ffOldBufferFIR_t;

typedef struct{
    double data[FIR_OLD_VALUES_BUFFER_LEN];
    uint8_t beginIdx :FIR_OLD_VALUES_BUFFER_LEN_BITS;
    uint8_t endIdx   :FIR_OLD_VALUES_BUFFER_LEN_BITS;
}ffOldBufferFIRFloat_t;

void fir_init(int16_t* inputFFCofs, uint16_t ffLen);
void fir_runFiP(int32_t* data, int64_t* output, uint16_t len);

#endif // FILTER_FIR_H_INCLUDED
