s2chhaen/USV/(commit log)

2023-06-16 Erzeugt eine Duplicate, um das Program zu debuggen
    Refactoriierung nach der Überprüfung der implementierten Funktionen. Noch zu bearbeiten
2023-06-16 Notiz-Hochladen. Achtung: keinen Bericht
    3 Sprachen stehen in der Notiz
2023-06-16 Hinzufuege checksumCRC16() Funktion
    Durch Anpassung des Muster-Muster-Program in Buch von Hersteller und Anpassung der Global-Variablen-Type
2023-06-18 wiederherstellen in Ausgangszustand, die Daten werden in Develop-Branch verschoben
2023-06-18 Aktualisierung des Software-Ordner
2023-06-19 Kabelbelegung hinzufügen
    [Kabelbelegung.xlsx]
2023-06-19 fehlende Kommando und Subkommando hinzufügen
2023-06-19 Hinzufuege der Paramter für Lidar-Daten
    noch in Verarbeitung
2023-06-20 Refaktoriziierung der Funktionen von dataSend() und dataReceive()
2023-06-20 Refaktorisierung der Init-Funktion für Taktgeber
2023-06-21 Objektierung des Slave-Gerätes in separten Daten
2023-06-21 weitere Reafaktorisierung der Funktionen bytes_to_value(), round_values() und cm_to_m(). Noch zu erledigen
2023-06-21 Includieren die Header-Daten fuer slave_device und Bib fuer Interrupt von AVR
2023-06-21 hinzufuegen der Header-Datei, die die Fehler-Type beinhaelt
2023-06-21 Loeschen der Funktionen von setup(), daten_senden(), daten_empfangen(). Zerkleinern Funktion init() in kleineren seperaten Funktionen
2023-06-21 erldigen die Implementation der dataTx()-Funktion
2023-06-21 erledigen der Implementation des dataTX()-Funktionsprototyp
2023-06-21 hinzufuegen die Version von slave_device.c und slave_device.h
2023-06-21 Korrektur des Schreibensfehler von dataTx() Funktion
2023-06-23 machen callbackTx() und callbackRx() lokale Funktionen
2023-06-23 wiederorganisieren die ganze Datei, Refaktorisierung der Funktionen callbackTx() und dataTx()
2023-06-24 2. Moeglichkeit von callbackTx() hinzugefuegt, 1. wird deaktiviert
2023-06-28 Hinzufuegen der 3 verschiedenen Moeglichkeit um die Daten zu senden
2023-06-28 Erhoehung der max. Anzahl von Byte zu FIFO von USART jedes Mal
2023-06-28 Testen der Funktionalitaet von USART_send_Array()-Funktion
2023-06-30 Anordnung der Ueberpruefungsstruktur
2023-06-30 redefinieren der Max. Byte-Anzahl, die in FIFO hinzuzugefuegt sind
2023-06-30 Hinzugefuegt der Struktur von Stoppuhr
2023-06-30 Anordnung von Testen USART fuer beide Senden- und Empfangenfunktionalitaet. Nicht stabil
2023-07-03 umbenennen der Namen von slave-device Header und C-Daten
2023-07-03 Hinzugefuegt der Konfiguration-Header-Datei fuer Slave-Device
2023-07-04 definieren der Anzahl von Stopuhren (Subtimer), USART-Beobachtern und der Prescaler-Konstante, Refaktorisieren der Struktur von Register-Struct, definieren der waitCycle()-Funktion
2023-07-04 Implementation der ISR fuer Timer A, waitCycle() und setUsartWatcherTimeout() Funktionen. Refaktorisierung der timerInit(), waitUs() Funktionen
2023-07-04 Refaktorisierung der slaveDevice_t Struktur, Loeschen der enum BufferState_t, neu wird in slaveDeviceConfig definiert
2023-07-04 refaktorisiert der initDev()-Funktion, noch zu testen. Implementation der deinitDev() Funktion
2023-07-04 Loeschen der resetDev() Funktion, der Ersatz heisst deinitDev()
2023-07-05 testConfig.h wird geloescht und durch DebugAndTestHeader.h ersetzt. Durch die neue Datei mit der neuen Namen und der deutlicheren Anordnung soll es besser fuer Debug werden
2023-07-05 hinzugefuegt der API fuer slaveDevice (grob struktutiert). Anwendung der Funktionspointer in Objekt-Struct fuer eine hohe Anpassung und Erweiterung
2023-07-05 Wieder angeordnet der include Daten
2023-07-05 das slaveDevice_t Struct in slaveDeviceAPI.h verschoben, die nicht notwendigen alten Structs geloescht
2023-07-05 der Zustand von rx-FIFO und die Parameter fuer slaveDevice wieder defniert
2023-07-05 neue Funktionen getUsartWatcherTimeout() und setWatchedObj() defniert. slaveDeviceAPI Header eingefuegt
2023-07-06 Refaktorisierung der callbackRx() und dataTx(). Getestet, diese Method funktioniert gut bei 75,3kBaud. echoTest() in main.c verschoben
2023-07-06 Refaktorisierung der timerInit(), waitUs() Funktionen. Neue Implementation setWatchedObj() und getUsartWatcherTimeout() Funktionen. Definieren des neuen beobachteten Objektes slaveDevice_t* obj_p
2023-07-06 nicht notwendige Variablen und Funktionen loeschen. Das Test Programm fuer Inbetriebnahme von USART hinzugefuegt, getestet, funktioniert gut in Baudrate von 76,8kBaud
2023-07-06 Erstellt neue Loesung fuer Frametesten
2023-07-06 die alte Loesung wird in Inbetriebnahme USART umbenannt und im neuen Ordner verschoben
2023-07-07 die nicht notwendigen Daten werden geloest
2023-07-07 umbenennen das 'Dataframe testen' Ordner zu 'USVMonitor Testen', um die Bedeutung zu verdeutlichen
2023-07-07 Löschen die alten Daten im Repo
2023-07-07 checksum crc16() Funktion wird hinzugefuegt
2023-07-07 das Ordner 'USVMonitor Testen' wird geloescht und wieder neu erstellt aufgrund der nicht einheitlichen Aenderung bei Namen nach der Umbenennung. Die Daten werden neu hinzugefuegt und wieder commit
2023-07-07 HAL-Bibliothek wird wieder in 'Testen mit USVMonitor' Ordner hinzugefuegt
2023-07-07 hinzufügen und anpassen der alten timerUnit Daten
2023-07-07 hinzufügen der main.h aus dem letzten Modul 'Inbetriebnahme USART', noch nicht angepasst
2023-07-07 hinzufügen der errorList.h aus dem alten Modul, angepasst
    [errorList.h]
2023-07-07 hinzufuegen der checksum crc8 und crc16 Funktionen
2023-07-07 hinzufuegen des Entwurfs von API des usvMonitorhandlers. Ab jetzt das Modell Driver-API wird angewendet, um die Wiederverwendbarkeit zu verbessern
2023-07-09 Korrektur der Parameters von dataRx_t Funktionszeiger
2023-07-09 Refaktorisierung der getData()-Funktion noch in Bearbeitung
2023-07-09 Hinzugefügt sind: neue Macros zur Behandlung der 3,4 Byte vom Lesenprotokoll. Struct usvMonitorHandler_t refaktorisiert: rxObj, txObj und statusObj sind geloescht, weil sie unrelevant sind. Gelöscht 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
2023-07-09 initDev() refaktorisiert: Umbenennung der Parameter
2023-07-09 initDev() refaktorisiert: Neue Parameter dev_p, zu initialisierender Handler, und inputCrc8,Checksum CRC8 Polynom
2023-07-09 initDev() refaktorisiert und dokumentiert: neue Initialisation entsprechenden dem neuen redefinierten usvMonitorHandler_t Struct
2023-07-09 Korrekutr des Header-Guards. Erledigen der Refaktorisierung der getData() Funktion
2023-07-09 Refaktorisierung und Dokumentation der getData()-Funktion erledigt
2023-07-10 Gelöscht werden: nicht notwendige Macros und Kommentare. Refraktorisiert ist die Definition der setData() Funktion. Alle nicht Standard-Header werden gelöscht und deren Implementation wird in Impleme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
2023-07-10 Korrektur der Rechtschreibung in getData(). Fehlerdefinition aus der errorList.h und die Implementation von CRC8-Checksum Funktion aus Math/checksum.h Bibliothek hier verschoben, um die dynamische Ei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
2023-07-10 NULL_POINTER Fehler in der Liste hinzugefügt
2023-07-10 Entwurf vom Interpretierer: Struct von Interpretierer userUnit_t, Definition der drei Funktionen: initUserUnit(), usartDataTx() und usartDataRx()
2023-07-10 Implementiert und dokumentiert wird die usartDataTx() - Funktion. Noch zu überprüfen sind initUserUnit(), usartCallbackTx(). Noch zu implementiert wird userDataRx() und usartCallbackRx()
2023-07-11 neues Macro über Byte-Empfangenzeit. Redefinition der Länge von rx- und tx-Buffer. Redifinition der userInit_t Struct: reduzieren rx- und tx-Buffer in 1 Buffer für jedes Typ, Umbenennung strReadPtr z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
2023-07-11 die timerUnit Header hinzugefügt
2023-07-11 Implementation der usartDataRx() und usartCallbackRx() Funktionen, noch nicht getestet und nicht dokumentiert
2023-07-12 wieder definieren der Parameter von dataRx_t Zeiger entsprechend der neuen Definition von dataRx() Funktion in userUnit.h
2023-07-12 Refraktorisierung der getData() Funktion: Anpassung des Aufruf des dataRx_t() Funktionszeiger mit der neuen Definition von dataRx() in userUnit.c
2023-07-12 usartConfig_t redefiniert: nicht notwendiger Mitglieder rxByte in struct gelöscht, die Definition der empfangenen Byte wird manuell in jeder Funktion definiert
2023-07-12 initUserUnit refaktorisiert: die Definition der empfangenen Byte wird manuell in jeder Funktion definiert nicht hier
2023-07-12 refaktorisiert der waitUs() Funktion: Rückgabewert verändert
2023-07-12 nicht notwendige Macros gelöscht. Header von usvMonitorHandlerAPI und userUnit hinzugefügt
2023-07-12 Anordnung des Testes, nicht notwendige Funktion gelöscht
2023-07-13 Änderung der maximalen Länge von tx-Buffer.Refaktorisierung der userUnit_t Struct: 2 Flags hinzugefügt, um die Änderung der USART-FIFO zu bezeichnen, Rx- und Tx- Counter ist reduziert zu 1 Byte statt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
2023-07-13 usartCallbackTx() refaktorisiert: richtige Zuweisung der Adresse von rxBuffer-Element zu der output Variable data[], Behandlung mit dem neuen Flag send von userUnit_t struct. Refaktorisierung der usa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
2023-07-13 ISR für Timer-A-Overflow refaktorisiert: Löschen die Wirkung von USART auf Stopuhr, da es nicht mehr notwendig ist
2023-07-13 Anordnung der Versuche zum Test der Funktion
2023-07-13 kleine Korrektur: kopieren die Daten von struct zu Array mit memcpy
2023-07-15 Freitag 16.07.2023: Refaktorisierung der main.c Datei: LED-Einschalten mit einer Dauer von 1 Minute als Fehlerbezeichnung, wenn irgend eine Schritt von Datenlesen nicht erfolgreich ist
2023-07-15 Refaktorisierung der sFIFO_t Struct: volatile Eigenschaft für p_write and p_read hinzugefügt, um die Richtigkeit ihrer Werte bei der Doppelzugriff aus normalen Funktionen und ISR zu gewährleisten
2023-07-15 Korrektur der falsche Werte für Lesen und Schreiben Anforderung im Protokoll
2023-07-15 Refaktorisierung der waitCyvle() Funktion: Korrektur der Anzahl der Schleife gemäß der Formel: reale Zeit = cycle/4*20, damit jede Zyklus (cycle) fast 1us gleich ist
2023-07-15 Refaktorisierung der dataGet() Funktion: Korrektur der Wartezeit bei Senden und Empfangen, der Teil der Antwortempfangen ist deaktiviert, um den Fehler zu suchen
2023-07-16 Funktion checkRxData() implementiert: zum Checken, ob ein Datenblock richtig übertragt oder nicht wird. Die deaktiviert Stelle in Funktion getData() wird richtig wieder eingestellt. Debug ist in Bear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
2023-07-17 Refaktorisierung von getData() Funktion: Bytes 3 und 4 checkende Reihefolge wird ausgetauscht, weil das System 'little endian' verwendet
2023-07-17 neues Flag, dynamicWait, als Bezeichnung für eine Wartedauer in Abhängigkeit von Zustand-Flag an der Anwenderseite statt einer festgelegten Wartezeit in usvMonitorHandler_t Struct hinzugefügt, noch i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
2023-07-17 getData() refaktorisiert: alle temp-Variablen als volatile und globale Variablen umdefiniert aufgrund des Debuggers, neue Anordnung des Datenempfangens: 1. Startbit, 2.Zustand-und-Informationsbytes u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
2023-07-17 usartCallbackRx() refaktorisiert: vereinfachert des Schreibens der Daten in Speichernbuffer (rxBuffer). usartDataTx() refaktorisiert: Warte in Abhängigkeit vom Zustand der Empfangbuffer statt einer f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
2023-07-17 getData()-Versuch: das Programm versucht das 8 Bytes langes Register mit Adresse von 0x100 zu lesen. Ergebnis: Mit Matlab-Simulator:erfolgreich Datensenden und -lesen. Noch in Testphase
2023-07-18 neuer Fehlertyp in der Liste hinzugefügt
2023-07-18 neue warte-Funktion in Abhängigkeit von den noch zu empfangenen Bytes und timeOut-Zeit implementiert: wenn die Bedingung erfüllt, stoppt die Warte und gibt keinen Fehler zurück, sonst gibt timeOut-Fe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
2023-07-18 waitWithBreak() Funktion refaktorisiert: Zeit in us wird durch Zyklen als Einheit ersetzt. Funktion usartDataRx() refaktorisiert: die passende Wartezyklenformel gefunden
2023-07-18 Zustand der main() Funktion, wobei es keinen Fehler gibt:Lesen globales Error Status Byte (GESB) Register mit Adresse von Slave (spezifische ID) gleich 0
    [main.c]
2023-07-18 Zustand der main() Funktion, wobei es den Fehler gibt: Kurswinkel lesen mit Adresse von Slave (spezifische ID) gleich 0
2023-07-18 Zustand der main() Funktion, wobei es den Fehler gibt:Lesen globales Error Status Byte (GESB) Register mit Adresse von Slave (spezifische ID) gleich 1
    [main.c]
2023-07-18 uuaslProtocolHeader_t refaktorisiert: Positionaustausch von slaveAdd und regAdd im Protokoll. Grund: Korrektur des Missverständnis ihrer Bedeutung in der Dokumentation
2023-07-18 readProtocolPrint() dokumentiert und refaktorisiert: mit der neuen Strucktur von uuaslReadProtocol_t angepasst
2023-07-18 readProtocolPrint() refaktorisiert: Dokumentation korrigiert. Funktion writeProtocolHeaderPrint() dokumentiert und refaktorisiert: mit der neuen Struktur von uuaslProtocolHeader_t angepasst
2023-07-18 writeProtocolHeaderPrint() und getData() refaktorisiert:mit der neuen Struktur von uuaslProtocolHeader_t angepasst
2023-07-19 Entwurf der Definition für getMultiregister() noch zu bearbeiten
2023-07-19 Entwurf von getMultiregister() Funtkion, noch zu arbeiten. Funktion searchEnd() implementiert: sucht das Register in der Liste, bis dem die Länge len (Eingabe) erreichen kann
2023-07-19 von 18.07.2023: Test die getData()-Funktion nach der Korrektur der Struktur von Lesenprotokoll: funktioniert mit verschiedenen Adressen
2023-07-19 Lidar-Register-Adresse in der Liste hinzugefügt
2023-07-19 die Adresse von Lidar-Sensor in der Liste hinzugefügt. Funktion getTotalLen() implementiert: die gesamte Länge von Bytes zwischen 2 Registers zurückgeben. Funktion searchEnd() refaktorisiert: falsche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
2023-07-19 writeProtocolHeaderPrint() umbenannt und refaktorisiert: neuer Name protocolHeaderPrint(), rw-Request als Paramter hinzugefügt, Funktion dient jetzt als Header-Generator für alle Protokolle nicht nur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
2023-07-19 setData() refaktorisiert; die Länge bei Header muss um 7 (die Anzahl der anderen Bytes außer der Datenbytes im Protokoll) erhöht nicht nur die Eingabelänge, die Variable txProtocol in buffer umbenann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
2023-07-19 main.c aktuellisiert: Testlauf für Registerschreiben, noch zu testen. Die Multiregisterlesen und -schreiben Funktion sind noch zu implementiert
2023-07-20 main.c aktualisiert; macht Variable error1 globale Variablen für Debuggerzweck
    [main.c]
2023-07-20 getMultiregister() Funtkion refaktorisiert: Vorgang vom Sendprotokollbilden und -senden. Noch zu bearbeiten: Antwortprotokoll empfangen und bewerten
2023-07-20 searchEnd() refaktorisiert: mach typecast bei len Variable von unsigned zu signed vor Zuweisung, neue Bedingung bei der for-Schleife. Funktion getMultiregister() refaktorisiert: Zwischenspeicher buff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
2023-07-20 getMultiregister() refaktorisiert: Routine für Empfangen und Behandlung des Antwortprotokolls
2023-07-20 Redefinition der maximalen Länge des Datenframes
2023-07-20 Definition der neuen Funktion setMultiregister()
2023-07-20 Implementation der setMultiregister(): Entwurf der Routine für die Funktion, Zwischenspeichern Variable bufferMultiTx als volatile und globale Variable festgelegt zum Debuggen, noch zu testen
2023-07-20 Wiederanodrnung der Versuche in main() Funktion
2023-07-21 setMultiregister() refaktorisiert: mach den Bufferzeiger als globale, volatile Variable zum Debuggen, Korrektur der nicht richtigen Verwendung der Zwischenbuffer Variable, Korrektur der falschen Posi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
2023-07-21 Versuch angeordnet: Schreiben die Daten in einen Datenblock und Lesen aus demselben Datenblock. Funktioniert gut
2023-07-21 slaveReg_t Struct refaktorisiert: Erhöhung der maximalen Länge des Registers aufgrund des Lidar-Register
2023-07-21 readProtocolPrint() refaktorisiert: die checksum-Polynom als Parameter hinzugefügt. Funktion getData() refaktorisiert: mit der Änderungen der readProtocol() Funktion angepasst
2023-07-21 Hinzufüge der Adresse von Lidar und Radar und deren Registerlänge in der Liste
2023-07-21 main.c: Header hinzugefügt, um das Reset bei falschem Interrupt zu verhindern
    [main.c]
2023-07-22 userUnit.c und userUnit.h: userDataRx() refaktorisiert: Typ des Parameters length verändert: uint8_t zu uint16_t
2023-07-22 usvMonitorHandlerAPI.h: Parameter bei Definition des dataRx_t Zeigers verändert, um die Einheitlich mit der dataTx_t zu halten
2023-07-22 userUnit.c: Funktion waitWithBreak() refaktorisiert: 2 neue Paramter hinzugefügt, damit die Funktion eine beliebige Variable statt nur die Variable toRxByte von struct userUnit_t betrachten kann
2023-07-22 userUnit.c: Kommentare hinzugefügt, waitWithBreak() refaktorisiert: Ersetzt der alten Variable uu.rxObj.toRxByte mit Paramter obj, usartDataTx() refaktorisiert: Variable toTxByte von struct userUnit_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
2023-07-22 userUnit.h: nicht notwendige Macros gelöscht, die max. Kapizität der tx- und rx-Zwischenspeicherbuffer erhöht
2023-07-22 'Inbetriebnahme der USART': Alle Rechnername bei der Stelle von Author wird als echten Namen des Authors umbenannt
2023-07-23 lock.h und lockList.c gelöscht: kein Lock-Mechanismus erforderlich, da das Programm in Reihe läuft
2023-07-23 error_list.h umbenannt zu errorList.h
    [errorList.h]
2023-07-23 dataprep.h und dataprep.c gelöscht: keine Lidardatenbearbeitung in Programm zum Inbetriebnahme der USART notwendig
2023-07-23 slaveDeviceConfig.h umbenannt zu slaveDeviceConfigAndDef.h: Alle Strukturdefinition und Konfiguration von slaveDevice hier verschoben
2023-07-23 Defintion von slaveDevice_t Struct in slaveDeviceConfigAndDef verschoben. slaveDevice_struct refaktorisiert: keine Zeiger für Sende- und Empfangenfunktion notwendig, da keine API mehr
2023-07-23 timerUnit.h: Bibiliothek aktualisiert, nicht notwendige Strukturdefinition und Kommentare gelöscht
2023-07-23 timerUnit.h: die Anzahl der zu beobachtenden USART-Einheit korrigiert, Version hinzugefügt
    [timerUnit.h]
2023-07-23 timerUnit.c: Korrektur der Anzahl vom USART-Wächter, da das Beobachtenmechanismus nur für eine USART-Einheit implementiert
2023-07-23 timerUnit.c: timerInit() Funktion refaktorisiert: Behandlung mit der USART-Wächter korrigiert, sodass es mit der neuen Anzahl der USART-Wächter passt
    [timerUnit.c]
2023-07-23 timerUnit.c : Funktion setUsartWatcherTimeout() refaktorisiert: Parameter usartNr gelöscht, da nur eine USART-Einheit in diesem gesamten Modul notwendig, NULL-Zeiger Behandlung hinzugefügt
2023-07-23 timerUnit.h : Definition der setUsartWatcherTimeout() refaktorisiert: mit der Implementation in der C-Source-Datei angepasst
2023-07-23 timerUnit.c und timerUnit.h : getUsartWatcherTimeout() refaktorisiert: Parameter usartNr gelöscht, da nur eine USART-Einheit in diesem gesamten Modul notwendig
2023-07-23 userUnit.c : ISR für Timer-Overflow refaktorisiert: mit nur einer Einzel-USART-Wächter angepasst, da nur eine USART-Einheit in diesem gesamten Modul notwendig
2023-07-23 slaveDevice.c : Funktion dataTx() refaktorisiert: angepasst mit der neuen slaveDevice_t struct: Senden-Zähler(txTime) nicht mehr notwendig
2023-07-23 slaveDevice.c : version 1 von Funktion callbackTx() refaktorisiert: mit neuer Definition von slaveDevice_t angepasst, die Anzahl der noch zu sendenden Bytes betrachtet statt des Sende-Zähler (txTime)
2023-07-23 Startversion der Lidar-User-Unit-Programmsdokumentation hinzugefügt
2023-07-23 slaveDevice.c : Version 1 von callbackTx() Funktion: Korrektur der Syntaxfehler
2023-07-23 slaveDevice.c : version 2 und 3 von Funktion callbackTx() refaktorisiert: mit neuer Definition von slaveDevice_t angepasst, globale Zwischenvariable wieder als lokale Variable nach dem Debuggen wiede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
2023-07-23 slaveDevice.c:Funktion callbackRx() refaktorisiert: 2. Möglichkeit neben der Timeout-Mechanismus (1. Möglichkeit) hinzugefügt: sie erkennt das Ende von Text mit vorgeschriebenem Symbol, angepasst mit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
2023-07-23 slaveDeviceConfigAndDef.h : Hinzufüge der Symbol zum Beenden des empfangene Strings entspricht der 2.Möglichkeit in rxCallback() Funktion in slaveDevice.c
2023-07-23 timerUnit.c: ISR für Timer-overflow refaktorisiert: Nullzeiger checken hinzugefügt
2023-07-23 slaveDevice.c: callbackRx() refaktorisiert: Inkrementation der writeFIFOPtr korrigiert, da FIFO ein Ringbuffer ist. Funktion initDev() refaktorisiert: angepasst mit der neuen Funktion setUsartWatcher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
2023-07-23 slaveDevice.c und slaveDevice.h: initDev() refaktorisiert: 2 Paramter rxLength und txLength gelöscht, da Buffer für rx und tx statisch definiert sind
2023-07-23 main.c: checksumCrc16() und CRC8() Funktionen und Variablen in init() gelöscht, da sie nicht notwendig sind
2023-07-24 timerUnit.c: ISR() refaktorisiert: Index für USART-Wächter korrigiert
    [timerUnit.c]
2023-07-24 slaveDevice.c: Funktion callbackRx(), initDev() und dataRx() refaktorisiert: Korrektur der Behandlung, wenn USART-Timeout-Mechanismus nicht aktiv ist
2023-07-24 slaveDevice.c: dataTx() refaktorisiert: optimiert die Quellcode
2023-07-24 slaveDevice.c: dataRx() refaktorisiert: optimiert die Quellcode
2023-07-24 die Struktur der slaveDevice_t als Version 1 gespeichert: diese hat viele Unterstruktur
2023-07-24 die Struktur der slaveDevice_t Version 1 refaktorisiert: umbenannt der Mitglieder mit sinnvoller Name, alle C-Source angepasst mit neuer Namen
2023-07-24 main.c: alle Testversuche sauber angeordnet, Test der Version 1 der Struktur slaveDevice_t mit 1. Methode zum automatischen Beenden der Eingabezeichenfolge (mit Timeout-Mechanismus) bei 250kBaud: fun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
2023-07-25 Struktur slaveDevice_t: der Mitglieder nextPhase gelöscht, da er nicht notwendig ist
2023-07-25 slaveDevice.c : Funktion rxCallback() refaktorisiert: der Algorithmus von Zeichenfolgenbeenden mit Sonderzeichen wird mit neuen Mitgliedern von slaveDevice_t angepasst
2023-07-25 slaveDevice.c: dataRx() optimiert: Alle mehrmalige Zugriffe auf Mitglieder von slaveDevice_t zum Lesen durch Lesen einer Zwischenvariable, was den Wert des Mitglieders speichert, ersetzt, nicht notwe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
2023-07-25 slaveDevice.c: alle Versionen von callbackTx() optimiert: nicht notwendige zwischen Variablen gelöscht, Alle mehrmalige Zugriffe auf Mitglieder von slaveDevice_t zum Lesen durch Lesen der Zwischenvar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
2023-07-25 slaveDevice.c : Optimierung der callbackRx() in Bearbeitung
2023-07-25 slaveDevice.c : Optimierung der callbackRx(): nicht notwendige zwischen Variablen gelöscht, Alle mehrmalige Zugriffe auf Mitglieder von slaveDevice_t zum Lesen durch Lesen der Zwischenvariablen, was 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
2023-07-25 slaveDeviceConfigAndDef.h : die alternative Struktur der slaveDevice_t als Version 2 gespeichert: diese hat nur eine große Struktur
2023-07-25 timerUnit.h und timerUnit.c: Quellcode optimiert: Falltrennung bei der Anwendung der Method zur Beendung der Zeichenfolge (im USART-Moduls) mit Timeout und mit Sonderzeichen
2023-07-25 main.c: Test der Version 1 der Struktur slaveDevice_t mit 2. Methode zum automatischen Beenden der Eingabezeichenfolge (mit Sonderzeichen) bei 250kBaud: funktioniert gut, keinen Verlust
2023-07-25 main.c: Version und Revision hinzugefügt, alle Versuche außer dem Versuch Echo-Test deaktiviert
2023-07-25 errorList.h: Beschreibung, Version und Revision hinzugefügt
    [errorList.h]
2023-07-25 timerUnit.h: Beschreibung, Version, Revision und Kommentare hinzugefügt, Korrektur der Enumeration vom Prescaler
2023-07-25 timerUnit.c: Beschreibung, Version, Revision, Kommentare für die ganze Datei und die Dokumentation in Quellcode für Funktion resetAllGenerator(), searchFreeGenerator() hinzugefügt
    [timerUnit.c]
2023-07-26 timerUnit.c: Alle Dokumentation in Quellcode für alle übrige Funktion hinzugefügt
2023-07-26 timerUnit.h: Beschreibung der Funktionalität des Moduls hinzugefügt
2023-07-26 slaveDeviceConfigAndDef.h: Beschreibung, Version, Revision und Kommentare hinzugeüfgt, nicht notwendige Enumaration und Kommentare gelöscht, Guarder wiederdefinieren
2023-07-26 slaveDeviceConfigAndDef.h: Macro USART_TIME_PRO_BYTE_US gelöscht, 2 Macros BAUDRATE_BAUD und BIT_PER_SYM hinzugefügt, Zeit pro Byte wird durch Formel berechnet statt statischer Berechnung
2023-07-26 slaveDevice.h: Beschreibung, Version und Revision hinzugefügt
2023-07-26 slaveDevice.c: Beschreibung, Version, Revision und Dokumentation der Quellcode hinzugefügt. Formel zur Berechnung der timeout-Zeit in callbackRx() und initDev() hinzugefügt
2023-07-26 slaveDevice.h: Korrektur des Guard-Header
2023-07-26 Beschreibung, Version und Revision hinzugefügt
2023-07-26 main.c: Funktion init() refaktorisiert: die default-Wert für result, der Wert für Baudrate durch Macro aus slaveDeviceConfigAndDef.h festgelegt. Richtige Erzeugdatum aktualisiert
2023-07-26 errorList.h: Korrektur des Guard-Headers
    [errorList.h]
2023-07-27 Dokumentation aktualisiert: Beschreibung der USART-Einheitstesten hinzugefügt
2023-07-27 Dokumentation aktualisiert: Korrektur der Rechtschreibungsfehler
2023-07-29 userUnit.h: Hinzufüge der Revision und Kommentare
2023-07-29 userUnit.c: Revision, Kommentar und Dokumentation in Quellcode für alle Funktionen hinzugefügut
2023-07-29 userUnit.h: Kommentar zur Erklärung der Rolle jedes Mitglieders von User-Unit-Struktur
2023-07-29 timerUnit.h: Revision hinzugefügt. Die übrigen nicht notwendigen Macros und Struktur gelöscht
2023-07-29 timerUnit.h: max. Anzahl des Stopuhren in timer-Einheit erhöht
2023-07-29 timerUnit.c: Revision hinzugefügt. Nicht notwendige Kommentare gelöscht. Dokumentation in Quellcode hinzugefügt
2023-07-29 errorList.h, main.c, and main.h: Revision hinzugefügt. Das Programm ist noch in Dokumentationsphase und Testphase
    [errorList.h, main.c, main.h]
2023-07-30 usVMonitorHandlerAPIConfig.h: neue Datei erstellt, Zur Definition der Konfiguration für User-Unit-Gerät
2023-07-30 usvMonitorHandlerAPI.c: Revision hinzugefügt. Funktion getData(), setData(), getMultiregister() und setMultiregister() refaktorisiert: Zwischenspeicherbuffer und deren Zeiger umbenannt, nicht notwend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
2023-07-30 usvMonitorHandlerAPI.c: Funktion getData(), setData(), getMultiregister() und setMultiregister() refaktorisiert: Nach jedem Senden und Empfangen der Daten, muss man warten. warte()-Funktion wiederang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
2023-07-30 usvMonitorHandlerAPI.c: Funktion getData(), setData(), getMultiregister() und setMultiregister() refaktorisiert: der Aufruf der warte()-Funktion wird von Benutzer (über den Wert von Macro WAIT_FUNCTI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
2023-07-30 usVMonitorHandlerAPIConfig.h: Kommentar zur Erklärung der Rolle von Macros hinzugefügt
2023-07-31 usvMonitorHandlerAPI.c: getMultiregister() und setMultiregister() refaktorisiert: Korrektur der aus der Optimierung entstehenden Index-Fehler
2023-07-31 userUnit.c: waitWithBreak() refaktorisiert: Korrektur der aus der Erweiterung entstehenden Fehler bei Wertvergleichbedingung
2023-07-31 main.c: Wiederanordnung der Versuche, Namen des Macros zu dem Name der Versuche umbenannt. Versuch zum Schreiben und dann Lesen des Datenblock wieder angeordnet und durchgeführt, funktioniert gut
2023-07-31 usvMonitorHandlerAPI.h: Lidar-Adresse verändert, weil die Byte-Länge des Lidar-Datenblock auf 360 erhöht wird, um die Auflösung zu erweitern
2023-07-31 usvMonitorHandlerAPI.c: Aktualisierung der Registerliste mit der neuen Adresse und neuen Bytelänge des Lidardatenblocks. 2 Funktionen getMultiregister() und setMultiregister() sind zu refaktorisieren
2023-07-31 Lidar-UserUnit-Software-Dokumentation.odt and Lidar-UserUnit-Software-Dokumentation.pdf: Kapitel 3 erstellt: Beschreibung und Durchführung hinzugeüfgt. Abschnitt 2.1.2. korrigiert
2023-07-31 usvMonitorHandlerAPI.c: Refaktosierung der Funktionen setMultiregister() und getMultiregister in Bearbeitung: Deaktiviert der Hauptcode
2023-08-01 usvMonitorHandlerAPI.h: Definition aller Paramter des Datenframes
2023-08-01 usvMonitorHandlerAPI.c: setMultiregister() refaktorisiert: Mehrmalige Sendung, wenn die Eingabelänge größer als Nutzdatenlänge ist, noch zu testen
2023-08-01 usvMonitorHandlerAPI.c: setMultiregister() refaktorisiert: alte Implementation total löschen und Kommentar hinzugefügt, noch zu testen
2023-08-01 Anmerkung für Syntax der Daten für LIDAR und RADAR(1).odt and Anmerkung für Syntax der Daten für LIDAR und RADAR(1).pdf: Informationen über die neue Adresse für Lidar-Register hinzugefügt
2023-08-01 usvMonitorHandlerAPI.c: Refaktorisierung der getMultiregister() in Bearbeitung (zwischengespeichert)
2023-08-01 usvMonitorHandlerAPI.c: Funktion getMultiregister() refaktorisiert: Mehr Datenblocklesen möglich, die alte Version von Funktion gelöscht, noch zu testen
2023-08-03 usvMonitorHandlerAPI.c: Funktion getTotalLen() refaktorisiert: die Bedingungen korrigiert, sodass das Anfangsregister und Endregister gleicheinander sein dürfen. Dadurch ermöglicht es die Vewendung d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
2023-08-03 usvMonitorHandlerAPI.c: Korrektur der Version
2023-08-03 Lidar-UserUnit-Software-Dokumentation.odt and Lidar-UserUnit-Software-Dokumentation.pdf: Beschreibung der Programmstruktur hinzugeüfgt
2023-08-19 Testdaten_Labor.csv and Testdaten_Labor_mitBuch30cm_15-45Grd.csv: Verschiebung der unbearbeiteten Daten von Matlab-Ordner zum Haupt-Repo
    [Testdaten_Labor.csv, Testdaten_Labor_mitBuch30cm_15-45Grd.csv]
2023-08-19 LidarDataExtract.m: Verschiebung der Datenextrahierungsdaten vom Matlab-Ordner zum Haupt-Repo
2023-08-19 quadtreeNodeClass.m: 15.08.2023: Hinzufüge der Modellierung eines Nodes vom Quadtree
2023-08-19 quadtreeClass.m: 17.08.2023: Hinzufüge der Modellierung vom Quadtree
2023-08-19 Ausgabe nach dem Ausführen des Extrahierungsprogramms
2023-08-20 quadtreeClass.m: Refaktorisierung des Konstruktor: Ein total leeres Objekt erzeugt am Anfang, pointData Attribute gelöscht, da es nicht mehr notwendig ist
2023-08-20 quadtreeClass.m: makeNodes Funktion gelöscht, und durch setRoot() Funktion ersetzt
2023-08-20 quadtreeClass.m: Funktion setRoot() zur Festlegung vom Wurzel, checkPoint() zum Checken, ob eine Eingabe ein Punkt ist, und checkTopAndBotPoint() zum Checken, ob zwei Punkte Eigenschaften für Obergre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
2023-08-20 quadtreeClass.m: Anzahl der maximalen Punkte pro Node als Attribute hinzugefügt
2023-08-21 quadtreeClass.m: Hinzufüge der Funktion addChildForNode(): vier Unternode für ein Node erzeugt. Attribute node vom Objekt als Cell statt Array festgelegt
2023-08-21 logn.m: Hinzufüge der Funktion logn(): Logarithmus mit Base n im Ordner Math
2023-08-21 quadtreeNodeClass.m: Keine Veerbung von handle Class mehr, um die Anzahl der Parameter/Argumente vom Konstruktion zu erhöhen. Die Attribute parent und child hinzugefügt. Konstruktor refaktorisiert: D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
2023-08-21 quadtreeClass.m: Funktion setRoot() refaktorisiert: Die Eltern in Konstruktor vom quadtreeNodeClass hinzugefügt. Attribute parent gelöscht, da es in quadtreeNodeClass verschoben wird
2023-08-22 quadtreeClass.m: private Funktionen als public bis zum Ende der Testphase vorläufig festgelegt. Entwurf von Funktion searchNode() hinzugefügt
2023-08-23 quadtreeNodeClass.m: Konstruktor refaktorisiert: Parameter level hinzugefügt, um die Postion des Nodes im Tree zu bestimmen
2023-08-23 quadnodeCompare.m: mit der neuen Name vom Vergleichfunktion angepasst
2023-08-23 quadtreeNodeClass.m: Vererbung von Class handle wiederhergestllt für void-Rückgabe, Default-Wert für child-Attribut festgelegt, Anwendung des Default-Konstruktors statt des selbst-defnierten. Attribu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
2023-08-23 quadnodeCompare.m: Funktion refaktorisiert. Checken des Init-Zustanddes von beiden Nodes hinzugefügt
2023-08-23 quadtreeClass.m: Fehler code (als Kommentare) beinhalten zum Speichern. Attribute node, child, parent, level als numerische Array statt als Cell/Zell behandelt, da Cell-Daten-Struktur viele versteckt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
2023-08-23 main.m: Main-Daten zur Ausführung der gesamten Quellcode hinzugefügt
2023-08-23 LidarDataExtract.m: Die Datenspeicher gelöschen, stattdessen werden die Ergebnisse in Workspace hochgeladen zur Weiterbearbeitung in main.m. Neue Revision
2023-08-23 LidarDataExtract.m: datasetNumbers Variable gelöscht, da sie nicht notwendig ist
2023-08-23 Update checkPoint.m and quadtreeClass.m: checkPoint() Funktion vom quadtreeClass wird hier verschoben
2023-08-26 quadtreeNodeClass.m: Änderung der Anordnung von Attributen und Hinzufüge die Erklärungskommentare dafür. Hinzufüge der Funktion setName() für Knot/Node zum Debuggen. Revision aktualisieren
2023-08-26 quadtreeClass.m: Kommentare zur Erklärung hinzugefügt. Funktion addChildrenForNode() refaktorisiert: Name von Knoten hinzugefügt zum Debuggen. Hinzufüge der Funktionen updateChildAttNode() und update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
2023-08-26 main.m: Testen der Funktion updateChildAttLvl() und updateChildAttNode()
2023-08-27 main.m: Testen der Funktion getLeaf(), funktioniert
2023-08-27 quadtreeClass.m: insert2ParentAttribute() umbenannt: neue Name insert2ParentAtt()
2023-08-27 testfield.m: Testen der Implementation vom stackClass
2023-08-27 quadtreeNodeClass.m: Funktion removeAllPoints() zur Entfernung aller Punkte von Knoten und als Rückgabe gespeichert
2023-08-27 stackClass.m: push() Funktion refaktorisert: Kippen der Input-Array-Position, um LIFO-Eigenschaft zu behalten
2023-08-29 quadtreeClass.m: Hinzufüge der checkPoint() Funktion in Klasse, da die externe Funktion checkPoint() nicht aufrufbar in Klasse. Funktion addChildrenForNode() refaktorisiert: level-Attribut-Aktualisie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
2023-08-30 Entwicklungsrichtung mit zwei-Dimension-Array (X und Y) Algorithmus sowie dem entsprechenden Algorithmen entfallen aber noch gespeichert. Das Programm ist fehlerhaft
2023-09-07 Testprobe fuer Butterworth-IIR-Filter gespeichert
2023-09-07 LidarDataExtract.m and main.m: Hauptfunktion, die feststellt, wie die Versuche durch geführt wird
2023-09-07 Testprobe fuer ChebyshevType-I-IIR-Filter gespeichert
2023-09-14 Update filterButterworth.fda: gelöscht, da es nicht mehr notwendig ist
2023-09-14 Testprobe für Chebyshev-Typ-II-IIR-Filter gespeichert
2023-09-14 Testprobe für Elliptic Filter gespeichert
2023-09-14 Testprobe für Maximally Flat Filter gespeichert
2023-09-14 Testprobe für Least pth Norm Filter gespeichert
2023-09-14 Testprobe für Equiripple Filter gespeichert
2023-09-14 Testprobe für Least Squares Filter gespeichert
2023-09-14 main.m: Entwurf des Testprogramms
2023-09-15 main.m: Type des Filters korrigiert. Ausführung für FIR-Filter (Beispiel)
2023-09-15 main.m: Kopieren der Radiusdaten in einem Text-Datei (input.txt) zur Bearbeitung in C
2023-09-15 Entwurf ein Programm zur Filterung der Daten in C. Noch in Bearbeitung: Datenlesen aus Text-Datei implementiert
2023-09-17 ioModul.c: Funktion getAvaDataLen() implementiert: Berechnung der verfügbaren Datenlänge in Ring-Buffer. Funktion char2Num() implementiert: Umwandlung von Nummerzeichen zur Nummer. Funktionen max() u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
2023-09-17 Hinzufüge der Koeffizienten der Filter im Form der Header-Daten und exFilter.h zur Verwaltung der Koeffizient
2023-09-19 main.m: Ausführung für IIR-Filter (Beispiel) gespeichert
2023-09-19 main.m: Aktualisierung der Ausführung von FIR-Filter
2023-09-19 main.m: Aktualisierung der Ausführung von IIR Filter: Korrektur der Eingabe der Parameter in Filter
2023-09-22 Speichern der ausgewählten Filter
2023-09-22 Löschen aller nicht mehr notwendigen Filter
2023-09-22 filterFIRScript.m und main.m: Verschiebung der Ausführung der Filter in einem seperaten Skript
2023-09-22 input.txt, input_fixed.txt, und input_float.txt: input.txt gelöscht und durch input_fixed.txt zur Fixed-Point-Format und input_float.txt zur Floating-Point-Format ersetzt
2023-09-22 printInFile.m: Funktion, um die Werte vor dem Filtern in txt-Datei auszugeben, hinzugefügt
2023-09-22 printOutFile.m: Skript zum Ausdrucken der Ausgaben in einer txt-Datei
2023-09-22 filterIIRScript.m: Skript zur Ausführung des IIR-Filter
2023-09-22 filterFIRScript.m: Skript refraktorisiert: Fälle trennen
2023-09-22 main.m: Skript refaktorisiert: Filter in seperaten Skripten durchführen, Ein- und Ausgaben in txt-Daten ausdrucken
2023-09-22 Ausgabe nach dem Filtern Koeffizienten mit Equripple-Methode-Entwurf in txt-Daten (eine mit Floating-Point-Format, eine mit Fixed-Point-Format)
2023-09-22 Ausgabe nach dem Filtern Koeffizienten mit Least-Squares-Methode-Entwurf in txt-Daten (eine mit Floating-Point-Format, eine mit Fixed-Point-Format)
2023-09-22 Ausgabe nach dem Filtern Koeffizienten mit Maximally-Flat-FIR-Methode-Entwurf in txt-Daten (eine mit Floating-Point-Format, eine mit Fixed-Point-Format)
2023-09-22 Ausgabe nach dem Filtern Koeffizienten mit Window-Kaiser-Methode-Entwurf in txt-Daten (eine mit Floating-Point-Format, eine mit Fixed-Point-Format)
2023-09-22 Ausgabe nach dem Filtern Koeffizienten mit Window-Triangular-Methode-Entwurf in txt-Daten (eine mit Floating-Point-Format, eine mit Fixed-Point-Format)
2023-09-22 Ausgabe nach dem Filtern Koeffizienten mit Window-Bartlett-Methode-Entwurf in txt-Daten (eine mit Floating-Point-Format, eine mit Fixed-Point-Format)
2023-09-22 Ausgabe nach dem Filtern Koeffizienten mit Window-Rectangular-Methode-Entwurf in txt-Daten (eine mit Floating-Point-Format, eine mit Fixed-Point-Format)
2023-09-22 Header Datei mit Filter Koeffizienten darin gelöscht, neue Header-Daten mit Daten-Format-Trennung werden erstellt
2023-09-22 extFilter.h: Inklusion der Header Daten mit Filter Koeffizienten wird gelöscht
2023-09-22 ioModul.c und ioModul.h: Alle Daten gelöscht und wieder hinzugefügt Schritt für Schritt für bessere Dokumentation
2023-09-22 filter_IIR.c und filter_IIR.h: Alle Daten gelöscht und wieder hinzugefügt Schritt für Schritt für bessere Dokumentation
2023-09-22 main.c und main.h: Alle Daten gelöscht und wieder hinzugefügt Schritt für Schritt für bessere Dokumentation
2023-09-22 filterConfig.h: Hinzufüge der Config-Header
2023-09-22 wt_dFormFilterCof.h und wt_qFormFilterCof.h: Hinzufüge der Filter-Koeffizienten vom Window-Triangular-Filter in d- und q-Form
2023-09-22 wr_dFormFilterCof.h und wr_qFormFilterCof.h: Hinzufüge der Filter-Koeffizienten vom Window-Rectangular-Filter in d- und q-Form
2023-09-22 wk_dFormFilterCof.h und wk_qFormFilterCof.h: Hinzufüge der Filter-Koeffizienten vom Window-Kaiser-Filter in d- und q-Form
2023-09-22 wb_dFormFilterCof.h und wb_qFormFilterCof.h: Hinzufüge der Filter-Koeffizienten vom Window-Bartlett-Filter in d- und q-Form
2023-09-22 mf_dFormFilterCof.h und mf_qFormFilterCof.h: Hinzufüge der Filter-Koeffizienten vom Maximally-Flat-FIR-Filter in d- und q-Form
2023-09-22 lsq_dFormFilterCof.h und lsq_qFormFilterCof.h: Hinzufüge der Filter-Koeffizienten vom Least-Squares-Filter in d- und q-Form
2023-09-22 eq_dFormFilterCof.h und eq_qFormFilterCof.h: Hinzufüge der Filter-Koeffizienten vom Equiripple-Filter in d- und q-Form
2023-09-22 ioModul.h: Definition der Struktur für Zeichenfolge-Ring-Buffer, Inklusion der notwendigen Bibliotheken und Definition der Parameter
2023-09-22 ioModul.c und ioModul.h: Funktion readFile() Prototyp hinzugefügt
2023-09-22 ioModul.c: Deklaration der buffer zum Speichern der Daten aus den txt-Daten
2023-09-22 ioModul.c: Implementation der Funktion readFile() zum Einlesen der Daten von "input_fixed.txt" - Datei
2023-09-22 ioModul.c und ioModul.h: Funktion getData() Prototyp hinzugefügt
2023-09-23 ioModul.c; Implement der Funktion char2Num()
2023-09-23 ioModul.c: Implementation der Funktion max()
2023-09-23 ioModul.c: Implementation der Funktion string2Num() und Inklusion der relevanten Bibliothek dafür
2023-09-23 ioModul.c: Implementation der Funktion getData() fertig
2023-09-23 filterFIRScript.m: Korrektur der falschen Aufnahem des Datenabschnittes nach dem Filtern
2023-09-26 filter_IIR.h: Definition der Filterordnung
2023-09-26 filter_IIR.h: Definition der Struktur für FIFO und ihre Paramter
2023-09-26 filter_IIR.h: Definition der Type von Filter für spätere Funktion
2023-09-26 filter_IIR.c: Deklaration der globalen Variablen zum Speichern der Filterkoeffizient
2023-09-26 filter_IIR.c und filter_IIR.h: Prototyp für Funktion void iir_init() hinzugefügt
2023-09-26 filter_IIR.c: Implementation der Funktion iir_init() hinzugefügt
2023-09-26 filter_IIR.c und filter_IIR.h: Prototyp für Funktion iir_run() hinzugefügt
2023-09-26 filter_IIR.h: Hinzufüge der notwendigen Bibliotheken
2023-09-26 filter_IIR.h: Hinzufüge der Bibliothek für int-Nummertyp
2023-09-26 filterConfig.h: Definition der Bitlänge für Fixed-Point-Form von Kommazahl
    [filterConfig.h]
2023-09-26 filter_IIR.h: Hinzufüge der Konfiguration für Filter
2023-09-26 filter_IIR.c: Implementation der Funktion iir_run() hinzugefügt
2023-09-26 filter_IIR.c und filter_IIR.h: iir_run() zu iir_runFP() umbenannt
2023-09-26 filter_IIR.c: Deklaration der zwei globalen Variablen zum Speichern der Filterkoeffizienten im Floating-Point-Form
2023-09-26 filter_IIR.h: Definition der Struktur für FIFO, deren Mitglieder in Floating-Point-Form sind
2023-09-26 filter_IIR.c: Deklaration der neuen globalen Variablen zum Speichern der alten Berechnungsergebnisse (Floating-Point-Zahl)
2023-09-26 filterConfig.h: Definition des Umwandlungsfaktor von floating- zu fixed-point für signed int
    [filterConfig.h]
2023-09-26 filterConfig.h: Korrektur des Umwandlungsfaktors
2023-09-26 filter_IIR.c: iir_init() refaktorisiert: Filterkoeffizient auch in Buffer für Floating-point-Zahlen gespeichert
2023-09-26 filterConfig.h: Korrektur der Schreibweise von CONVERT_FACTOR_INT Definition
2023-09-26 filter_IIR.c und filter_IIR.h: iir_runFP() zu iir_runFiP() umbenannt
2023-09-26 filter_IIR.c: iir_init() refaktorisiert: Umwandlung zur Double-Zahl hinzugefügt
2023-09-26 filter_IIR.c: Funktion iir_runFiP() refaktorisiert: memcpy vorläufig durch Schleifen-Kopieren ersetzt
2023-09-26 filter_IIR.c: Funktion iir_runFiP() refaktorisiert: Phasenverschiebung mit Formeln berechnet statt Festlegung
2023-09-26 filter_IIR.c: iir_init() refaktorisiert: oldFLat Struktur Initialisation für Indizes hinzugefügt. Implementation von iir_runFlP() hinzugeüfgt: Das Vertauschen der Indizies von Urspungsfunktion iir_ru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
2023-09-26 filter_IIR.h: Funktion iir_runFlP() refaktorisiert: Variablentype von Parametern verändert
2023-09-26 ioModul.c und ioModul.h: Prototyp für Funktion writeFile() hinzugefügt
2023-09-26 ioModul.c: Entwicklung der Funktion writeFile() in Prozess
2023-09-26 ioModul.c und ioModul.h: Funktion writeFile() refaktorisiert: Anzahl der Parameter verändert, Implementation fertig noch zu testen
2023-09-27 filter_IIR.c: Funktion iir_runFiP() refaktorisiert: Buffer zum Speichern der Ein- und Ausgabe getrennt, getesten, funktioniert
2023-09-27 filter_IIR.h: Inklusion der Bibliothek für printf-Format
2023-09-27 filter_IIR.h: Korrektur der Formel zur Berechnung der notwendigen Länge (in Bit) für Speichern-Ring-FIFO
2023-09-27 filter_IIR.c: iir_init() refaktorisiert: Korrektur der Postion der Endindex von FIFO
2023-09-27 filter_IIR.c und filter_IIR.h: Funktion iir_runFiP() refaktorisiert: Parameter type und seine Anwesenheit in Funktion weggeworfen,
2023-09-27 filter_IIR.c und filter_IIR.h: Funktion iir_runFlP() refaktorisiert: Parameter type und seine Anwesenheit in Funktion weggeworfen
2023-09-27 main.c: Anordnung des Testlaufs von iir_runFiP(), iir_runFlP() Funktionen, funktioniert gut
2023-09-27 filter_IIR.c: iir_init() refaktorisiert: Zuweisung über temporäre Variable um die falsche Interpretation zu vermeiden
2023-09-27 filter_IIR.c: Implementation der Funktion qFormatARM2TI() zur Umwandlung der Q-Format-Zahl von ARM-Form zu TI-Form
2023-09-27 filter_IIR.c: Funktion iir_init() refaktorisiert: Umwandlung der Faktoren vom Filter vom ARM-Q-Format zum TI-Q-Format um Genauigkeit und Arbeitsgeschwindigkeit zu verbessern
2023-09-27 filter_IIR.c: iir_runFiP() refaktorisiert: Operation von Division zum Bit-Shift gewechselt, da die Darstellung jetzt einheitlich in TI-Q-Format ist
2023-09-27 filter_FIR.c und filter_FIR.h: Erstellung der Header- und Source-Datei für filter in FIR-Form
2023-09-27 filter_IIR.c und filter_IIR.h: Struktur ffOldBuffer_t zu ffOldBufferIIR_t und Struktur ffOldBufferFloat_t zu ffOldBufferIIRFloat_t umbenannt
2023-09-27 filter_FIR.h: Inklusion der notwendigen Bibliotheken
2023-09-27 filterConfig.h und filter_IIR.h: Verschiebung des Macros OUTPUT_MAX_LEN von IIR_Filter- zu FilterConfig-Header
2023-09-27 filter_IIR.c und filter_IIR.h: Macros umbenannt: OLD_VALUES_BUFFER_LEN_BITS zu IIR_OLD_VALUES_BUFFER_LEN_BITS, OLD_VALUES_BUFFER_LEN zu IIR_OLD_VALUES_BUFFER_LEN
2023-09-27 filter_FIR.h: Definition der notwendigen Paramter für Speichern-Ring-FIFO und die Struktur für Ring-FIFO (für Nummer von Q-Format)
2023-09-27 filter_FIR.h: Definition der Struktur für Ring-FIFO (für Nummer von Floating-Point-Format)
2023-09-28 filter_FIR.c> globale Variablen für FIR-Filter hinzugeüfgt
2023-09-28 filter_FIR.c und filter_FIR.h: Prototyp für Funktion fir_init() hinzugefügt
2023-09-28 filter_FIR.c: Funktion qFormatARM2TI() von IIR_Filter.c Datei hier kopieren aufgrund der Notwendigkeit
2023-09-28 filter_FIR.c: Hinzufüge der notwendigen globalen Variablen (Floating-Point-Format)
2023-09-28 filter_FIR.c: Implementation der Funktion fir_init() fertig
2023-09-28 filter_FIR.c und filter_FIR.h: Prototyp für Funktion iir_runFiP() hinzugefügt (Filterung und Ausgabe in Q-Format)
2023-09-28 filter_FIR.c und filter_FIR.h: Falscher Name korrigiert: die Funktionsname soll fir_runFiP() statt iir_runFiP() sein
    [filter_FIR.c, filter_FIR.h]
2023-09-28 main.c: Anordnung des Testlauf für IIR-Filter. Das Ergebnis wurde zum Zweck der Nachprüfung in txt- und cvs-Datei ausgedruckt. Funktionieren beide Funktionen für Q-Format und Floating-Point-Format se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
2023-09-28 filter_FIR.c: Implementation von fir_runFiP() fertig
2023-09-28 main.c: Anordnung des Testlaufs von Window-Kaiser-FIR-Filter, funktioniert es gut
2023-09-29 main.c: Anordnung des Testlaufs für Least-Squares-FIR-Filter, funktioniert es gut
2023-09-29 main.c: Anordnung des Testlaufs für Equiripple-Filter, funktioniert gut
2023-09-29 main.c: Anordnung des Testlaufs für Bartlett-FIR-Filter, funktioniert gut
2023-10-02 filterIIR.m: Funktion filterIIR() implementiert, um die filterIIRScript zu ersetzen
2023-10-02 filterFIR.m: Funktion filterFIR() implementiert, um die filterFIRScript zu ersetzen
2023-10-02 main.m: Ersetzt des Einsatzes von filterIIRScript und filterFIRScript durch zwei Funktionen filterIIR() und filterFIR(): Falltrennung für die Versuche (die Teste)
2023-10-02 main.c: Anordnung des Testlaufs für Window-Rectangular-FIR-Filter, funktioniert gut
2023-10-02 main.m: Anordnung der geplannten Versuchen
2023-10-02 filter_IIR.c: iir_runFiP() refaktorisiert: Entfall der Variable testVar zum Debuggen
2023-10-02 printInFile.m und printOutFile.m: Änderung des Suffix der Ausgabendatei
2023-10-02 ioModul.c: readFile() refaktorisiert: Änderungen des Namen der gelesenen Eingabendatei
2023-10-02 output_eq_fixed.txt: in output_eq_fixed_matlab.txt umbenannt und die Werte mit der neuen Q-Format-Art Änderung der Phasneverschiebungskompensation aktualisiert
2023-10-02 output_eq_float.txt: in output_eq_float_matlab.txt umbenannt und die Werte mit der neuen Q-Format-Art und Änderung der Phasneverschiebungskompensation aktualisiert
2023-10-02 output_lsq_fixed.txt: in output_lsq_fixed_matlab.txt umbenannt und die Werte mit der neuen Q-Format-Art und Änderung der Phasneverschiebungskompensation aktualisiert
2023-10-02 output_lsq_float.txt: in output_lsq_float_matlab.txt umbenannt und die Werte mit der neuen Q-Format-Art und Änderung der Phasneverschiebungskompensation aktualisiert
2023-10-02 output_mf_fixed.txt: in output_mf_fixed_matlab.txt umbenannt und die Werte mit der neuen Q-Format-Art und Änderung der Phasneverschiebungskompensation aktualisiert
2023-10-02 output_mf_float.txt: in output_mf_float_matlab.txt umbenannt und die Werte mit der neuen Q-Format-Art und Änderung der Phasneverschiebungskompensation aktualisiert
2023-10-02 output_wb_fixed.txt: in output_wb_fixed_matlab.txt umbenannt und die Werte mit der neuen Q-Format-Art und Änderung der Phasneverschiebungskompensation aktualisiert
2023-10-02 output_wb_float.txt: in output_wb_float_matlab.txt umbenannt und die Werte mit der neuen Q-Format-Art und Änderung der Phasneverschiebungskompensation aktualisiert
2023-10-02 output_wt_float.tx: in output_wt_float_matlab.txt umbenannt und die Werte mit der neuen Q-Format-Art und Änderung der Phasneverschiebungskompensation aktualisiert
2023-10-02 output_wk_fixed_matlab.txt: in output_wk_float.txt umbenannt und die Werte mit der neuen Q-Format-Art und Änderung der Phasneverschiebungskompensation aktualisiert
2023-10-02 output_wt_fixed.txt: in output_wt_fixed_matlab.txt umbenannt und die Werte mit der neuen Q-Format-Art und Änderung der Phasneverschiebungskompensation aktualisiert
2023-10-02 output_wr_float.txt: in output_wr_float_matlab.txt umbenannt und die Werte mit der neuen Q-Format-Art und Änderung der Phasneverschiebungskompensation aktualisiert
2023-10-02 output_wk_fixed.txt: in output_wk_float_matlab.txt umbenannt und die Werte mit der neuen Q-Format-Art und Änderung der Phasneverschiebungskompensation aktualisiert
2023-10-02 output_wr_fixed.txt: in output_wr_fixed_matlab.txt umbenannt und die Werte mit der neuen Q-Format-Art und Änderung der Phasneverschiebungskompensation aktualisiert
2023-10-02 main.m: Implementation des 2. Versuch in Prozess: Rechteck-Impulse erzeugt
2023-10-03 main.m: Korrektur der falsche Kommentar im 1.Versuch. 3. Versuch (A = 5001 und Ton = 300 Samples) wird erst implementiert statt 2. Versuch
2023-10-03 filterIIR.m: Funktion refaktorisiert: Position der Legenden in der Abbildung verändert
2023-10-03 filterFIR.m: Funktion refaktorisiert: Position der Legenden im Diagramm verändert
2023-10-03 Ergebniss von Test3 bei A = 5001 und Ton = 300 Samples im Form der Abbildung gespeichert
2023-10-03 main.m: 3. Versuch bei A = 5001 und Ton = 200 Samples
2023-10-03 Ergebniss von Test3 bei A = 5001 und Ton = 200 Samples im Form der Abbildung gespeichert
2023-10-03 main.m: 3. Versuch bei A = 5001 und Ton = 140 Samples
2023-10-03 Ergebniss von Test3 bei A = 5001 und Ton = 140 Samples im Form der Abbildung gespeichert
2023-10-03 main.m: 3. Versuch bei A = 5001 und Ton = 60 Samples
2023-10-03 Ergebniss von Test3 bei A = 5001 und Ton = 60 Samples im Form der Abbildung gespeichert
2023-10-03 main.m: 3. Versuch bei A = 5001 und Ton = 8 Samples
2023-10-03 Ergebniss von Test3 bei A = 5001 und Ton = 8 Samples im Form der Abbildung gespeichert
2023-10-03 main.m: 3. Versuch bei A = 5001 und Ton = 4 Samples
2023-10-03 Ergebniss von Test3 bei A = 5001 und Ton = 4 Samples im Form der Abbildung gespeichert
2023-10-03 main.m: 3. Versuch bei A = 1001 und Ton = 300 Samples
2023-10-03 Ergebniss von Test3 bei A = 1001 und Ton = 300 Samples im Form der Abbildung gespeichert
2023-10-03 main.m: 3. Versuch bei A = 21 und Ton = 300 Samples
2023-10-03 Ergebniss von Test3 bei A = 21 und Ton = 300 Samples im Form der Abbildung gespeichert
2023-10-03 main.m: Implementation des 2. Versuches in Prozess
2023-10-03 main.m: 2. Versuche: Hinzufüge des Generators des Signals mit Geräuschen
2023-10-03 slopeArray.m: Implementation der Funktion slopeArray() zur Berechnung der Steigung zwischen 2 nebeneinander liegenden Werten
2023-10-03 main.m: Versuch 2. : Implementation für mf-Filter fertig
2023-10-03 main.m: Versuch 2. : Implementation für wk-Filter fertig
2023-10-03 main.m: Versuch 2. : Implementation für lsq-Filter fertig
2023-10-03 main.m: Versuch 2. : Implementation für eq-Filter fertig
2023-10-03 main.m: Korrektur der Berechnung der Diffenrenz der Steigung von Originalsignal und gefilterten Signal
2023-10-03 main.m: Versuch 2. : Implementation für wb-Filter fertig
2023-10-03 main.m: Versuch 2. : Implementation für wr-Filter fertig
2023-10-03 main.m: Versuch 2. : Implementation für wt-Filter fertig
2023-10-03 main.m: Die Magnitude des Geräusches verändert
2023-10-04 main.m und test1.m: Verschiebung der Quellcode für 1. Versuch in einem seperaten Skript mit dem Namen test1.m
2023-10-04 main.m: Korrektur der Schreibweise
2023-10-04 main.m und test2.m: Verschiebung der Quellcode für 2. Versuch in einem seperaten Skript mit dem Namen test2.m
2023-10-04 main.m: Versuch 4.: Funktion zur Erzeugung des Signals, das der Definition des Bereiches unter schwächer Wirkung der Störgroße entspricht
2023-10-04 main.m und test3.m: Verschiebung der Quellcode für 3. Versuch in einem seperaten Skript mit dem Namen test3.m
2023-10-04 main: Versuch 4.: Wiederanordnung aufgrund der Verschiebung des 3. Versuches
2023-10-04 main.m: Versuch 4.: Berechnung für mf-Filter fertig
2023-10-04 main.m: Versuch 4.: Berechnung für wk-Filter fertig
2023-10-04 main.m: Versuch 4.: Berechnung für lsq-Filter fertig
2023-10-04 main.m: Versuch 4.: Berechnung für eq-Filter fertig
2023-10-04 main.m: Versuch 4.: Berechnung für wb-Filter fertig
2023-10-04 main.m: Versuch 4.: Berechnung für wr-Filter fertig
2023-10-04 main.m: Versuch 4.: Berechnung für wt-Filter fertig
2023-10-04 main.m und test4.m: Verschiebung der Quellcode für 4. Versuch in einem seperaten Skript mit dem Namen test4.m
2023-10-05 test4.m: Kommentar über die Verlustpunkte korrigiert
2023-10-08 test1.m: Daten vor der Filterung in das Diagramm gezeichnet
2023-10-08 Erstellung des Projektes zum Lesen des Lidarprotokolls
2023-10-08 systematische Änderungen des Lidar-Lesen-Projektes
2023-10-08 checksum.h und checksum.c: Hinzufüge der checksum-Header und Source von der Mathe-Bibliothek
2023-10-08 ATMegaXX09Clock.h und ATMegaXX09Clock.c: Hinzufüge der HAL-Bibliothek für MCU-Clock
2023-10-08 MinMax.h: Hinzufüge der MinMax-Header von der Mathe-Bibliothek
2023-10-08 EEPROM.h: Hinzufüge der EEPROM-Header von HAL-Bibliothek
2023-10-08 FIFO.h, FIFO.c, FIFOa.S: Hinzufüge der FIFO-Header und Source von HAL-Bibliothek
2023-10-08 USART_config.h, USART.h und USART.c: Hinzufüge der USART-Header und Source von HAL-Bibliothek
2023-10-08 Port.h und Port.c: Hinzufüge der IO-PORT-Header und Source von HAL-Bibliothek
2023-10-08 lidarComProtocol.h: Hinzufüge der Header-Datei
2023-10-08 lidarComProtocol.h: Hinzufüge der Definition der Lidar-Adresse, das Protokoll-Start-Symbol und Protokoll-Zwang-End-Symbol
2023-10-08 lidarComProtocol.h: Hinzufüge der Kommandosliste von Lidar
2023-10-08 lidarComProtocol.h: enum lidarCommando zu lidarCmd umbenannt
2023-10-08 lidarComProtocol.h: Hinzufüge der Kommandos vom Antwortprotokoll und Umwandlungskoeffizient von Anforderungskommandos zu Antwortskommandos
2023-10-08 lidarComProtocol.h: Hinzufüge der Subkommandos für Betriebsmodus-Kommando (0x20)
2023-10-08 lidarComProtocol.h: Hizufüge der Datenteil vom Antwortprotokoll des Kommandos 0x20
2023-10-08 lidarComProtocol.h: Hizufüge der Datenteil vom Antwortprotokoll des Kommandos 0x30
2023-10-08 lidarComProtocol.h: Umbenennung von enum "measuredDataReqAns" zu "measuredDataReqAnsBlockA"
2023-10-12 Anpassen des Radarhalters auf die richtigen Lochdurchmesser für die Verschraubung mit dem Gehäuse. Hinzufügen einer Platinenverschraubung mittels M3 Schrauben und Muttern. Hinzufügen einer parametisi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
    [3D_Druck_V02.ipt]
2023-10-12 Update Adressbereich für Radar und LIDAR.
2023-10-17 test5.m: Matlab-Programm , um die Daten, die durch C-Programm ausgegeben werden, zu lesen
2023-10-17 main.m: Hinzufüge des Programms (im Form Skript) in main.m Programm
2023-10-17 lidarProtocolHandler.cbp and main.c: Erstellung des Programms zum Lesen und Auswerten des Lidar-Protocol
2023-10-17 crcCalculator.c und crcCalculator.h: Kopieren der CRC-Calculator-Bibliothek vom uC-USART-Projekt zu diesem Projekt
2023-10-17 filterConfig.h, filter_FIR.c, und filter_FIR.h: Hinzufüge der Implementation des ausgewählten Filtertyps aus dem FilterTesting-Projekt
2023-10-17 wr_dFormFilterCof.h und wr_qFormFilterCof.h: Hinzufüge der ausgewählten Parameter (unter dem Entwurf-Methode-Namen) aus dem FilterTesting-Projekt
2023-10-17 ioModul.c und ioModul.h: Hinzufüge der io-Modul-Daten aus dem FilterTesting-Projekt
2023-10-17 ioModul.h und ioModul.c: Hinzufüge des writeFileInt64() Funktionsprototypes
2023-10-17 ioModul.c: Implementation der Funktion writeFileInt64() hinzugefügt
2023-10-17 protocol.c und protocol.h: Hinzufüge der Header- und Source-Datei von Protocol-Handler
2023-10-17 protocol.h: Hinzufüge der notwendigen Bibliotheken
2023-10-17 protocol.h: Hinzufüge der Definition von Lidar-Default-Adresse, maximalen Messwerten bei der Messung von 0 bis 360 und 0.5Grad Auflösung und Checksum-Polynom
2023-10-17 protocol.h: Hinzufüge der Checksum-Berechnung-Bibliothek
2023-10-18 asciiTable.h: Hinzufüge der ASCII-Tabelle-Header-Datei
2023-10-18 protocol.h: Hinzufüge der Position der Byte in Anforderungsprotokoll-Header-Teil
2023-10-18 protocol.h: Hinzufüge der Position der Byte in Antwortsprotokoll-Header-Teil
2023-10-18 protocol.h: Definition der Größe der Datentype in Byte
2023-10-18 protocol.h: Definition der Offset-Bytes in Protokoll vom Kommando 0x31
2023-10-18 protocol.h: Definition der Größe der Bestandteilblöcke vom Kommando-0x31-Protokoll
2023-10-18 protocol.h: Definition des Bit-Mask zum Testen des Blockes A im Protokoll des Kommandoes 0x30
2023-10-18 protocol.h und protocol.c: Prototype der Funktion checkConfig() - Kommando 0x30 hinzugefügt
2023-10-18 protocol.c: Implementation der Funktion checkConfig() hinzugefügt
2023-10-18 protocol.h und protocol.c: Hinzufüge des Prototyps der checkData() Funktion
2023-10-18 protocol.c: Implementation der Funktion checkData() hinzugefügt
2023-10-18 protocol.c: checkData() refaktorisiert: gelesene Lidardaten werden in Buffer gespeichert
2023-10-18 protocol.h: Hinzufüge des Prototyps für Funktion getExtractedData()
2023-10-18 protocol.c: Implementation der Funktion getExtractedData() erledigt
2023-10-18 protocol.c und protocol.h: Prototyp für Funktion hwdInitAndResetReq() hinzugefügt
2023-10-18 protocol.c: Implementation der Funktion hwdInitAndResetReq() erledigt
2023-10-18 protocol.h und protocol.c: Prototyp der Funktion hwdInitAndResetRsp() hinzugefügt
2023-10-18 protocol.c: Implementation der Funktion hwdInitAndResetRsp() erledigt
2023-10-18 protocol.h: Bibliothek von string.h und Ascii-Tabelle hinzugefügt
2023-10-18 protocol.h: Trennung der Datenblöcke
2023-10-18 protocol.c: Sortierung der Funktionen mit Hilfe der Kommentare
2023-10-18 ioModul.h: Trennung der Datenblöcke
2023-10-18 main.c: Hinzufüge der notwendigen Bibliotheken
2023-10-18 Protokoll für Kommando 0x30-0x01 für Test der Funktion checkData() hinzugefügt
2023-10-18 lidarValues_filtered.txt und lidarValues_raw.txt: Hinzufüge der Daten für Matlab zum Lesen und Zeichen
2023-10-18 Löschen der nicht notwendige Daten
2023-10-18 Löschen der nicht mehr notwendigen Daten
2023-10-18 Protokoll für Kommando 0x36-0x02 für Test der Funktion checkData() hinzugefügt
2023-10-18 lidarComProtocol.h: Hinzufüge der Position der Blöcke in Protokoll des Kommandos 0x31
2023-10-19 asciiTable.h: Hinzufüge der Verfasserinformationen
2023-10-19 lidarIf.c und lidarIf.h: ERstellung einer kleinen Programmschnittstelle für Lidar
2023-10-19 asciiTable.h: Hinzufüge der ASCII-Tabelle
2023-10-19 lidarIf.h: Hinzufüge der notwendigen Bibliotheken
2023-10-19 lidar.h: Definition des Lidartyps und default-Firmware-Version
2023-10-20 Umbenennung des Prokjetes "Testen mit USVMonitor" zu "Testen mit USVData"
2023-10-20 Löschen der komplierten Daten, da nicht notwendig
2023-10-20 Löschen der Ausgabendaten, da nicht notwendig
2023-10-23 Code for IMU Signed-off-by: Joe G <grabow@amesys.de>
2023-10-26 Umbenennung der userUnit.h zu comUnit.h und Aktualisierung der Version
2023-10-26 Umbenennung der userUnit.c zu comUnit.c: Aktualiesrung der Version
2023-10-26 main.h: Aktualisierung der neuen Namen für Kommunikationseinheit
2023-10-26 errorList.h: Hinzufüge der Header - Datei für Fehler - Code
    [errorList.h]
2023-10-26 timerUnit.h: Hinzufüge der notwendigen Bibliothek und Beginn der Refaktorisierungsphase
2023-10-27 timerUnit.h und timerUnit.c: timerInit() refaktorisiert: Änderung der Parameter und Rückgabe, Dokumentation vorläufig gelöscht
2023-10-27 Löschen der nicht notwendigen Daten bei Umbenennung des Projektes
2023-10-27 timerUnit.h: neue Definition der Struktur zur Verwaltung des Timers
2023-10-27 timerUnit.h: Löschen der alten Struktur zur Verwaltung des Timers
2023-10-27 timerUnit.c: Löschen der alten globalen Variable und Deklaration der neuen Variable
2023-10-27 timerUnit.h: Definition der Anzahl der Modi für Timer-Einheit
2023-10-27 timerUnit.h: Definition der Faktor zur Umwandlung der Zeit von s zu ms und us
2023-10-27 timerUnit.h und timerUnit.c: waitUs() zu timer_stopWatch() und refaktorisiert: Funktion wird mit der neuen globalen Variablen angepasst
2023-10-27 timerUnit.c: Funktion timerInit() refaktorisiert
2023-10-27 timerUnit.h und timerUnit.c: Funktion timer_setState() Prototyp hinzugefügt
2023-10-27 timerUnit.c: Funktion timer_setState() implementiert, noch zu dokumentieren
2023-10-27 timerUnit.h und timerUnit.c: Prototyp für Funktion timer_setCounter() hinzugefügt
2023-10-27 timerUnit.c: Funktion timer_setCounter() implementiert, noch zu dokumentieren
2023-10-27 timerUnit.h und timerUnit.c: Funktion timer_getCounter() hinzugefügt, noch zu dokumentieren
2023-10-27 timerUnit.c: ISR für TCA0 refaktorisiert: mit der neuen Struktur angepasst
2023-10-27 timerUnit.c: die Funktionen von der alten Struktur gelöscht
2023-11-01 comUnit.h: Löschen der Definition über Anzahl der RX- und TX-Buffer. Ein für jedes Typ ist genug
2023-11-01 comUnit.h: Definition einer gesamte Länge für beide RX- und TX-Buffer
2023-11-01 comUnit.h: Definition der neuen gesamten Struktur für TX- und RX-Buffer
2023-11-01 comUnit.h: Definition der neuen Verwaltungsstruktur für diese Kommunikationseinheit
2023-11-01 comUnit.c: Löschen der mit der alten Struktur verbundenen globalen Variablen und ersetzen durch die mit der neuen Struktur verbundenen
2023-11-01 comUnit.c: usartCallbackTx() refaktorisiert: mit der neuen Struktur angepasst
2023-11-01 comUnit.c: usartCallbackRx() refaktorisiert: mit der neuen Struktur angepasst
2023-11-01 comUnit.c: usartDataTx() refaktorisiert: mit der neuen Struktur angepasst
2023-11-01 comUnit.c: usartDataRx() refaktorisiert: mit der neuen Struktur angepasst
2023-11-01 comUnit.c: initUserUnit() refaktorisiert: mit der neuen Struktur angepasst
2023-11-02 comUnit.c und comUnit.h: Revision aktualisiert
2023-11-02 comUnit.c: usartCallbackTx() refaktorisiert: Funktion optimiert und Kommentar leicht korrigiert
2023-11-02 timerUnit.c: Korrektur des Syntaxfehlers
2023-11-02 comUnit.h: Löschen der nicht mehr notwendigen Macros
2023-11-02 comUnit.c: Funktion usartDataTx() refaktorisiert: Code optimiert und neuen Timeout-Mechanismus mit Timer hinzugefügt
2023-11-02 Doku zur IMU
2023-11-02 comUnit.c: usartCallbackRx() refaktorisiert: Erhöhung der empfangbaren Byte-Anzahl
2023-11-02 comUnit.c: usartDataRx() refaktorisiert: Code optimiert mit und neuen Timeout-Mechanismus mit Timer hinzugefügt
2023-11-03 new IMU structure
2023-11-03 Initial board design
    [IMU.brd, IMU.sch]
2023-11-03 USV Slave Template
    [Gehäuse_CN-22-GU_assembly.stp, IMU.brd, IMU.sch, PCB_CN22GU_User_Unit.step, USV-Slave_Vorlage.brd, USV-Slave_Vorlage.sch]
2023-11-03 new IMS Board Version
    [USV-BG-001-SP-A.brd, USV-BG-002-SP-A.brd, USV-BG-002-SP-A.sch]
2023-11-05 Sheet and Board for IMU
    [USV-BG-002-SP-A.brd, USV-BG-002-SP-A.sch]
2023-11-05 Datablock as csv and json
    [Datenblock.csv]
2023-11-06 Button with Pullup
    [USV-BG-002-SP-A.brd, USV-BG-002-SP-A.sch]
2023-11-06 first IMU Code
2023-11-06 first IMU code with Python
2023-11-07 timerUnit.c: timerInit() refaktorisiert: Die Auflösung ist einstellbar bis 255-Zeitseinheit
2023-11-07 timerUnit.c: timer_setState() refaktorisiert: bedient über Benutzer Schnittstelle statt Hardware-Schnittstelle
2023-11-07 timerUnit.c und timerUnit.h: timer_setCounter() refaktorisiert: Werteintervall vom Argument erweitert, Benutzer-Schnittstelle statt Hardware-Schnittstelle benutzt
2023-11-07 timerUnit.h und timerUnit.c: Funktion waitCycle() gelöscht
2023-11-07 timerUnit.c und timerUnit.h: Funktion timer_getCounter() refaktorisiert: Rückgabe-Typ verändert
2023-11-07 timerUnit.c: timer_stopWatch() refaktorisiert: Benutzer-Schnittstelle statt Hardware-Schnittstelle verwendet
2023-11-07 timerUnit.c: globale Variable verändert
2023-11-07 timerUnit.c: ISR von TCA0 refaktorisiert: mit der neuen Struktur angepasst
2023-11-07 timerUnit.h: veraltete Struktur gelöscht
2023-11-07 timerUnit.h: die Hardware selbst geschriebene Struktur gelöscht, aufgrund der Verfügbarkeit von der Hersteller-HAL-Bibliothek
2023-11-07 timerUnit.h: veraltete Enumeration gelöscht
2023-11-07 Calibration with description of position
2023-11-07 add/update USV RS485 slave pin layout
2023-11-08 new sheet und board design
    [USV-BG-002-SP-A.brd, USV-BG-002-SP-A.sch]
2023-11-08 tools for the calibration of magnetic interference fields
    [data.csv]
2023-11-10 final circuit and final board design
    [USV-BG-002-SP-A.brd, USV-BG-002-SP-A.sch]
2023-11-10 Demo for measuring all data with calibrated magnetometer data
2023-11-13 usvMonitorHandlerAPI.c: Funktion searchReg() refaktorisiert: Verwendet Switch - case statt lineare Suche in Array, Zweck: optimierbar durch Kompiler möglich
2023-11-13 usvMonitorHandlerAPI.c: Funktion searchReg() zu getRegLen() umbenannt und die alte Code gelöscht
2023-11-13 usvMonitorHandlerAPI.c: Hinzufüge der globalen Variablen zum Speichern des Protokolls
2023-11-13 usvMonitorAPI.c: getData() refaktorisiert: Anpassung mit der neuen Funktion getRegLen() und Optimierung der Funktion
2023-11-13 usvMonitorHandlerAPI.c: setData() refaktorisiert: Anpassung mit neuen Funktion getRegLen() und Optimierung der Quellcode
2023-11-13 usvMonitorHandlerAPI.c: Teil der Funktion getData() wird in Subroutine getAndCheckData() geteilt. Zweck: spätere Wiederanwendung für getMultiregister() Funktion
2023-11-13 usvMonitorHandlerAPI.c: getMultiregister() refaktorisiert: Optimierung der Quellcode und Erweiterung der Lesenbereich (jetzt Multiregister mit mehr als 255 Bytes lesbar)
2023-11-14 usvMonitorHandlerAPI.c: Teil der Funktion setData() wird in Subroutine setAndCheckData() geteilt. Zweck: spätere Wiederanwendung für setMultiregister() Funktion
2023-11-14 usvMonitorHandlerAPI.c: Funktion getAndCheckData() refaktorisiert: Korrektur der falschen Indizen
2023-11-14 usvMonitorHandlerAPI.c: getMultiregister() refaktorisiert: Verschiebung der Position in Quellcode, Optimierung der Quellcode und Erweiterung, sodass das Datenblock mit der Länge mehr als 255 Bytes le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
2023-11-14 usvMonitorHandlerAPI.c: getRegLen() refaktorisiert: Die Länge des Datenblockes vom Lidar verändert
2023-11-14 usvMonitorHandlerAPI.c: getMultiregister() refaktorisiert: Korrektur der falschen Position des Registers
2023-11-14 usvMonitorHandlerAPI.c: Funktionen searchEnd(), getTotalLen(), readProtocolPrint(), protocolHeaderPrint()und writeProtocolTailPrint() gelöscht, da sie nicht mehr notwendig sind
2023-11-14 usvMonitorHandlerAPI.h: usvMonitorHandler_t Struktur refaktorisiert: Mitglied waitFunc_p entfernt, die Warte-Funktion auf die Antwort wird in Daten-Tx und -Rx integriert
2023-11-14 usvMonitorHandlerAPI.h und usvMonitorHandlerAPI.c: Funktion initDev() refaktorisiert: mit der Änderungen der Struktur usvMonitorHandler_t angepasst
2023-11-14 usvMonitorHandlerAPI.h: Strukturen uuaslReadProtocol_t, uuaslProtocolTail_t und uuaslProtocolHeader_t gelöscht, da sie nicht mehr notwendig sind
2023-11-14 usvMonitorHandlerAPI.h: die alte Macros GET_SLAVE_ADD_LOW_PART(a) und SET_SLAVE_ADD_LOW_PART(add) in neues Macro USV_PROTOCOL_SET_SLAVE_ADD_LOW(add) umbenannt
2023-11-14 usvMonitorHandlerAPI.h: alte Macros GET_SLAVE_ADD_HIGH_PART(a) und SET_SLAVE_ADD_HIGH_PART(add,rw) in neues Macro USV_PROTOCOL_SET_SLAVE_ADD_HIGH(add,rw) umbenannt
2023-11-14 usvMonitorHandlerAPI.h: PAYLOAD_PER_FRAME zu PROTOCOL_PAYLOAD_PER_FRAME umbenannt und neue Formel dafür festgestellt
2023-11-14 usvMonitorHandlerAPI.h: Definition der Arbeitszeit für Zielprogramm und Zeit für 1 Byte (USART: 1 Start bit, 8 Data Bits, 1 Parity Bits/Odd Parity , 1 End Bit, 250kBaud)
2023-11-14 usvMonitorHandlerAPI.h: Nummerierung der Datenblöcke und Definition des letzten Datenblockes
2023-11-14 usvMonitorHandlerAPI.h: Definition der Position im Protokollheader
2023-11-15 usvMonitorHandlerAPI.h: Definition der CPU-Freq und Inklusion der delay.h - Bibliothek
2023-11-15 usvMonitorHandlerAPI.h: Löschen der nicht mehr notwendigen Macros
2023-11-15 usvMonitorHandlerAPI.c: Funktionen mit der neuen Namen von Macros angepasst
2023-11-15 timerUnit.c: neues Typ für Variable timer_stepCounter und Deklaration der timer_res Variable (zum Speichern der Auflösung)
2023-11-15 timerUnit.c: timerInit() refaktorisiert: Timer wird nur einschaltet, wenn notwendig
2023-11-15 timerUnit.c: timer_setState() refaktorisiert: timer direkt ein- und ausgeschaltet ohne Zustand - Variable
2023-11-15 timerUnit.h und timerUnit.c: timer_setCounter() refaktorisiert: neues Typ für Argument/Parameter und die echte Zeit durch Schritte ersetzt
2023-11-15 timerUnit.c: ISR() refaktorisiert: Entfernung der Zustand - Variable
2023-11-15 timerUnit.h und timerUnit.c: timer_getCounter() refaktorisiert: neues Rückgabetyp und mit neuen Namen der Globalvariable angepasst
2023-11-15 timerUnit.c: timer_stopWatch() refaktorisiert: mit der neuen Namen der Globalvariablen angepasst
2023-11-15 timerUnit.h, timerUnit.c, usvMonitorHandlerAPI.h und usvMonitorHandlerAPI.c: neue Revision aktualisiert
2023-11-15 comUnit.c: Globale Variable tempVar deklarieren zum Speichern der vorläufigen Werte
2023-11-15 comUnit.c: usartCallbackRx() refaktorisiert: mit neuen Namen der globalen Variablen und optimiert und umgeschrieben, sodass sie die Anzahl von mehr als 31 Bytes empfangbar ist
2023-11-15 comUnit.h und comUnit.c: usartDataTx() refaktorisiert: neues Argument/Parameter hinzugefügt, optimiert und mit der timeout - Mechanismus integriert
2023-11-15 comUnit.h und comUnit.c: usartDataRx() refaktorisiert: neues Argument/Parameter hinzugefügt, optimiert und mit timeout - Mechanismus integriert
2023-11-15 comUnit.c: nicht mehr notwendigen Funktionen und Kommentare gelöscht, Format korrigiert
2023-11-15 main.c: main() refaktorisiert: READ_MULTIREGISTER - Versuch umgebaut, getestet, funktioniert besser als die alte
2023-11-15 main.c: main() refaktorisiert: WRITE_MULTIREGISTER - Versuch umgebaut, funktioniert besser als die alte Version
2023-11-15 main.c: main() refaktorisiert: error1 Variable wird global innerhalb vom main() sichtbar zum besseren Debuggen
    [main.c]
2023-11-15 main.c: main() refaktorisiert: Werte und Position der Variablen korrigiert
    [main.c]
2023-11-15 main.c: main() refaktorisiert: der übrigen Teil des WRITE_AND_READ_MULTI_REGISTER - Versuches hochgeladen
2023-11-15 main.c: main() refaktorisiert: Festlegung der Priorität für Interrupt
2023-11-15 main.c: main() refaktorisiert: neue optimierte Auflösung für timer/counter hinzugefügt
2023-11-15 main.c: Optimierung der übrigen Funktionen
2023-11-15 main.h, comUnit.h und comUnit.c: neue Version aktualisiert
2023-11-15 main.h: Inklusion der Bibliothek cpufunc.h vom AVR
2023-11-15 main.h: Hinzufüge des Header-Datei vom main.c
2023-11-15 main.c: Verschiebung der Inklusion der Bibliothek in Header - Datei und Definition der BADISR - ISR() um es zu vermeiden, dass die falsche, unerwünschte Interrupts die uC wiederherstellt
2023-11-15 main.c: Deklarieren der ucInit() Funktion
2023-11-15 main.h: Inklusion der AVR-Interrupt Bibliothek
2023-11-15 main.c: Aufruf der Funktion ucInit() und Aktivierung der Global-Interrupt-Flag/Fahne
2023-11-15 lidarIf.h: Definition der Funktionszeiger für rx-Funktion vom LidarHandler
2023-11-15 lidarIf.h: Definition des Funktionszeigers für tx - Funktion vom Lidar-Handler
2023-11-15 lidarIf.h: Definition der Struktur für Lidar-Handler
2023-11-15 lidarIf.h: übrige Änderungen
2023-11-15 lidarIf.c: übrige Änderungen
2023-11-15 LidarTest - Projekt: Änderungen vom IDE - System
2023-11-19 main.c und main.h: Deaktiviert usvMonitorHandlerAPI für Refaktorisierung
2023-11-25 usvDataHandler.h: Hinzufüge der notwendigen Bibliothek
2023-11-25 usvDataHandler.h: Definition der Verwaltungsstruktur für dieses Modul
2023-11-25 usvDataHandler.h: Verschiebung der usartConfig_t Struktur vom comUnit.h zu hier
2023-11-25 usvDataHandler.h: Definition der zwei Modi von diesem Modul
2023-11-25 usvDataHandler.h: Definition der Zustände und der Parameter für Setter - FSM
2023-11-25 usvDataHandler.h: Definition der Parameter und Zustände für Getter-FSM
2023-11-25 usvDataHandler.h: Definition der Rückruf-Funktion für FSM vom beiden setter- und getter-Objekt
2023-11-25 usvDataHandler.h und usvDataHandler.c: Funktion initDev() refaktorisiert: in usv_initDev() umbenannt und Parameter verändert und Anpassung mit der neuen Struktur vom Modul
2023-11-25 usvDataHandler.c: Löschen der schon vordefinierten Fehlerrückgabewert
2023-11-25 usvDataHandler.c: Löschen der Checksum-Funktion, da sie schon vordefiniert im neuen Bibliothek wird
2023-11-25 usvDataHandler.c: Deklaration der notwendigen globalen Variablen für das Modul
2023-11-25 usvDataHandler.c: Deklaration der notwendigen globalen Variablen
2023-11-25 usvDataHandler.c: checkRxData() refaktorisiert: verwendet der checksum - Funktion von der Bibliothek
2023-11-25 usvDataHandler.c: Deklaration der lookup-Tabelle und Zustände für setter- und getter-FSM
2023-11-25 usvDataHandler.c: Implementation der Handler-Funktion für USV_FSM_SETTER_START_STATE Zustand
2023-11-25 usvDataHandler.c: Implementation der Handler Funktion für USV_FSM_SETTER_READY_STATE Zustand
2023-11-25 usvDataHandler.c: Implementation der Handler-Funktion für USV_FSM_SETTER_TX_STATE Zustand
2023-11-25 usvDataHandler.c: Implementation der Handler-Funktion für den USV_FSM_SETTER_RX_STATE Zustand
2023-11-25 usvDataHandler.c: Implementation der usv_setProtocol() Funktion
2023-11-25 usvDataHandler.c: Implementation der usv_sendProtocol() Funktion
2023-11-25 usvDataHandler.h und usvDataHandler.c: Funktion setData() und setMultiregister() refaktorisiert: beide Funktionen werden in der neuen Funktion usv_setRegister() zusammengesetzt
2023-11-25 usvDataHandler.c: Implementation der Handler-Funktion für den Zustand USV_FSM_GETTER_START_STATE
2023-11-25 usvDataHandler.c: Implementation der Handler-Funktion für den Zustand USV_FSM_GETTER_READY_STATE
2023-11-25 usvDataHandler.h: Löschen der Notiz in der Entwurfphase
2023-11-25 usvDataHandler.c: Implementation der Handler-Funktion für den USV_FSM_GETTER_TX_STATE Zustand
2023-11-25 usvDataHandler.c: Implementation der Handler-Funktion für USV_FSM_GETTER_RX_CHECK_1_OHD_STATE Zustand
2023-11-25 usvDataHandler.c: Implementation der Handler-Funktion für den USV_FSM_GETTER_RX_CHECK_2_OHD_STATE Zustand
2023-11-25 usvDataHandler.c: Implementation der Handler-Funktion für den USV_FSM_GETTER_RX_DATA_STATE Zustand
2023-11-25 usvDataHandler.c: Implementation der Handler-Funktion für den USV_FSM_GETTER_RX_CHECK_3_OHD_STATE Zustand
2023-11-25 usvDataHandler.h und usvDataHandler.c: getData() und getMultiregister() refaktorisiert: beide Funktionen in der neuen Funktion usv_getRegister() zusammengefasst
2023-11-25 usvDataHandler.c: globalen Variablen zum Empfangen und Senden der Daten zwischen der Rückruffunktion in USART-ISR() und FSM-Zustand-Handler-Funktionen
2023-11-25 usvDataHandler.c: Implementation der in ISR Rückruffunktion usartCallbackTx()
2023-11-25 usvDataHandler.c: Implementation der in ISR Rückruffunktion usartCallbackRx()
2023-11-25 usvDataHandler.c und usvDataHandler.h: Implementation der usv_getLockState() und usv_getProRes() Funktion
2023-11-25 comUnit.c und comUnit.h: Löschen der Daten. Alle Prozesse werden erneut in usvDataHandler-Modul implementiert
2023-11-25 main.h: Bibliotheken mit der neuen Implementation angepasst
2023-11-25 main.c: Testen mit den neuen FSM-Strukturen und Funktionen. Funktioniert gut
2023-11-25 checksum.h: Definition der neuen Parameter
2023-11-25 checksum.c: Deklaration der globalen Variablen für CRC8-Methode
2023-11-25 checksum.h und checksum.c: Implementation der Funktion crc8Init()
2023-11-25 checksum.c: crc8() refaktorisiert: in neuen Namen crc8CodeGen() umbenannt und Implementation optimiert
2023-11-26 lidarHandler.h und lidarHandler.c: Erstellung der Header- und Execute-Daten für Lidar-Handler
2023-11-26 timerUnit.c und timerUnit.h: Hinzufüge des Timer-Moduls von Projekt "Testen mit USVData"
2023-11-26 checksum.h und checksum.c: Aktualisierung des Checksum-Moduls vom Projekt "Testen mit USVData"
2023-11-26 lidarHandler.h: Inklusion der notwendigen Bibliotheken
2023-11-26 lidarHandler.h: Definition der notwendigen Parameter
2023-11-26 lidarHandler.h: Definition der Position im Protocol-Header
2023-11-26 lidarHandler.h: Definition der Zustände vom FSM für das Meldung-Polling
2023-11-26 lidarHandler.h: Definition der Zustände für FSM vom getter
2023-11-26 lidarHandler.h: Definition der Struktur für Verwaltung des Moduls
2023-11-26 lidarHandler.h: Definition der Struktur zur Konfiguration der USART-Einheit von HAL-Bibliothek
2023-11-26 lidarHandler.h: Definition der Modi für LidarHandler
2023-11-27 checksum.c und checksum.h: Hinzufüge der Version
2023-11-27 checksum.h und checksum.c: Hinzufüge der Version
2023-11-27 -Add current sensor CYHCT-L20K-U60A-42 to '02 Hardware' folder. -Add calibration function from current sensor in to folder '01 Stromsensor'.
    [Kalibrierfunktion CYHCT-L20K-U60A-42.xlsx]
2023-11-29 timerUnit.h und timerUnit.c: Vergrößerung der Auflösungsintervall vom Timer-Einheit
2023-11-30 usvDataHandler.c: usv_sendProtocol() refaktorisiert: Löschen der nicht notwendigen Stellen
2023-12-04 Radar-Software: Verschiebung der alten Daten in einem Order
2023-12-10 lidarIf.c: Löschen der nicht mehr notwendigen Datei
2023-12-10 asciiTable.h: Verschiebung der Datei
2023-12-10 Hinzufüge der Filter-Daten aus Ordner vom Codeblocks Projekt
2023-12-10 lidarComProtocol.h: Verschoben und umbenannt. Neuer Name lidarHandlerProtocol.h
2023-12-10 lidarIf.h: Löschen der nicht mehr notwendigen Datei
2023-12-12 Update lidarProtocolHandler.cbp and .atsuo
2023-12-21 new version
    [Datenblock.csv]
2023-12-21 new version Signed-off-by: Joe G <grabow@amesys.de>
2023-12-23 Ship-Dynamics Signed-off-by: Joe G <grabow@amesys.de>
2023-12-25 LidarMain-Projekt: Hinzufüge der HAL-Bibliothek
2023-12-25 TestRadar-Projekt: Hinzufüge der HAL-Bibliothek
2023-12-25 TestRadar-Projekt: Hinzufüge der Timer-Einheit
2023-12-25 RadarTest-Projekt: Hinzufüge der ASCII-Tabelle
2023-12-25 RadarTest-Projekt: Hinzufüge der Fehlerliste
2023-12-25 radarHandler.h: Hinzufüge der Header-Datei für Radar-Handler-Programm
2023-12-25 Hinzufüge der Ausführungsdatei für Radar-Handler-Programm
2023-12-25 registerModel.h: Hinzufüge der Header-Datei für einen Registermodel
2023-12-25 main.h: Erstellung der Header-Datei für main.c
2023-12-25 main.c: Verschiebung der Inklusion der Header-Datei in main.h. Umbenennung der Namen vom Computer in den vom Autor
2023-12-25 registerModel.h: Inklusion der Standard-Int-Header-Datei. Erstellung des Modells für einen 8-Bit Register
2023-12-25 radarHandler.h: Definition der Nachricht nach dem Einschalten vom Radar und des Protokolls zum Anfordern der Daten und seine Länge
2024-01-17 Datenblock Stand 17.01.24
    [Datenblock.csv]
2024-01-17 Excel data block conversion tool
    [Datenblock.csv]
2024-01-24 USART.c: Hinzufüge der Funktion zur Rücksetzen vom FIFO im Fehlerfall
2024-01-24 USART.c: Korrektur der Auslesen des Registers, um den Fehler beim Löschen des System-Flag zu bewältigen
2024-01-24 USART.h: Hinzufüge der Funktion zum Rücksetzen der FIFO im Fehlerfall
2024-01-24 LidarMain-Projekt: Hinzufüge der MinMax.h Header-Datei vom Math-HAL-Lib
2024-01-24 checksum.h und checksum.c hinzugefügt
2024-01-24 wr_qFormFilterCof.h: Importieren der Filter-Coeffizienten vom Matlab
2024-01-24 comConfig.h: Hinzufüge der Header-Datei
2024-01-24 comConfig.h: Inklusion der notwendigen Bibliothek, Definition der Struktur zum Speichern der USART-Konfigurationsdaten
2024-01-24 comConfig.h: Definition der Enumeration für die Position, in der die Funktion aufgerufen wird
2024-01-24 Hinzufüge der lidarHandler.h Header-Datei
2024-01-24 lidarHandler.h: Definition der Macros der Lidar-bezogenen Paramteter
2024-01-24 lidarHandler.h: Definition der Arbeitsmodi für Lidar-Handler-Modul
2024-01-24 lidarHandler.h: Definition der Byte-Position für Protokoll
2024-01-24 lidarHandler.h: Definiton der Zustände für Parametrierung-FSM
2024-01-24 lidarHandler.h: Hinzufüge der Zustände für Rücksetzen-FSM
2024-01-24 lidarHandler.h: Definition der Zustände für Datenempfangen-FSM
2024-01-24 lidarHandler.h: Definition des Funktions- und Zeigertyps der FSM-Zustand-Handler-Routine
2024-01-24 lidarHandler.h: Definition der Zustände für Lidar-Handler-Modul-FSM
2024-01-24 lidarHandler.h: Definition der Funktions- und Zeigertyps der FSM-Zustand-Handler-Routine
2024-01-24 lidarHandler.h: Definition des Registers zur internen Modul-Verwaltung
2024-01-24 lidarHandler.h: Definition der Register zur Ausgabe des Modul-Zustandes
2024-01-24 lidarHandler.h: Hinzufüge der Positionsfestlegung im Modul-Status-Register
2024-01-24 lidarHandler.h: Definition der Modul-Haupt-FSM für externe Verwendung
2024-01-24 lidarHandler.h: Definition des Prototyps für lidar_initDev(), lidar_getStatus() und lidar_setAddr() Funktionen
2024-01-24 lidarHandler.h: Hinzufüge der Abkürzungsliste
2024-01-24 lidarHandlerProtocol.h: Hinzufüge der lidarHandlerProtocol.h Header-Datei
2024-01-24 lidarHandlerProtocol.h: Inklusion der notwendigen Bibliothek
2024-01-24 lidarHandlerProtocol.h: Definition der Protokoll-bezogenen Parameter
2024-01-24 lidarHandlerProtocol.h: Definition der besonderen ACK- und NACK-Zeichen für falsches Protokoll
2024-01-24 lidarHandlerProtocol.h: Definition der Adresse von Lidar-Register und Unterkommandos
2024-01-24 lidarHandlerProtocol.h: Definition vom "bit-map" der Konfiguration im Daten-Anfrage-Protokoll
2024-01-24 Hinzufüge der registerModel.h Header-Datei für spätere Anwendung bei Kommunikationskanal zwischen lidarHandler-, usvHandler- und lidarDataPrc-Modul
2024-01-24 registerModel.h: Inklusion der notwendigen Bibliothek
2024-01-24 registerModel.h: weiter vom vorherigen Commit: und Definition des Models von einem 8-Bits-Register
2024-01-24 comConfig.h: Definition der Bits-Position für Zustand- und Daten-Senden-Anfrage Flags im Kommunikationskanal
2024-01-30 Hinzufüge der lidarHandler.c Source-Datei
2024-01-30 lidarHandler.c: Hinzufüge der maximalen Länge von USART-FIFO
2024-01-30 lidarHandler.c: Hinzufüge der internen Variablen für dieses Modul
2024-01-30 lidarHandler.c: Hinzufüge der Variablen zum vorläufigen Speichern der Eingabe von USART-HAL-Programm
2024-01-30 lidarHandler.c: Hinzufüge der Variablen für die jetztigen Zustände der internen Zustandsmaschine
2024-01-30 lidar.Handler.c: Hinzufüge der vorläufigen Variablen zum Speichern des Zustandes im ISR-Rückruf-Funktion
2024-01-30 lidarHandler.c: Deklaration der Rückruf-Funktionen der Synchronisation-FSM
2024-01-30 lidarHandler.c: Deklaration der Rückruf-Funktionen der Datenanfragen-FSM
2024-01-30 lidarHandler.c: Deklaration der Rückrufsfunktionen der Rücksetzen-FSM
2024-01-30 lidarHandler.c: Deklaration des Arrays zum Speichern aller Look-up-Tabellen der FSM-Rückruffunktionen
2024-01-30 lidarHandler.c: Deklaration der Rückruffunktionen der Hauptzustandsmaschine zum Treiben dieses Moduls
2024-01-30 lidarHandler.c: lidar_checksum16(): Implementation der Checksum-Funktion für Lidar mit Hinweis vom Datenblatt
2024-01-30 lidarHandler.c: Implementation der Funktion zur Generation der Adresse und Kommando in Antwortsprotokoll
2024-01-30 lidarHandler.c: Implementation der Funktion zum Empfangen der Daten vom USART-FIFO
2024-01-30 lidarHandler.c: Hinzufüge der Funktion zum Überprüfen der empfangenen Daten mit Hilfe der Lidar-checksum-Funktion
2024-01-30 lidarHandler.c: Hinzufüge der Funktion lidar_dataCheck() zum Checken der Konfigurations- und Firmware-Daten
2024-01-30 lidarHandler.c: Hinzufüge der Funktion lidar_getCmdDataLen() zur Ausgabe der Länge der Lidar-Datenblöcke
2024-01-30 lidarHandler.c: Hinzufüge der Funktion zum Erzeugen des Protokolls zum Datenanfragen
2024-01-30 lidarHandler.c: Hinzufüge der Funktion lidar_sendProtocol()
2024-01-30 lidarHandler.c: Hinzufüge der Funktion zum Checken des Kommunikation-IO-Streams
2024-01-30 lidarHandler.c: Hizufüge der Funktion lidar_dataGet() zum Empfangen der Messdaten
2024-01-30 lidarHandler.c: Hinzufüge des fehlenden Teils der Funktion lidar_dataGet()
2024-01-30 lidarHandler.c: Hinzufüge der Zustand-Handler-Routinen für Synchronisierung-FSM
2024-01-30 lidarHandler.c: Hinzufüge der Zustand-Handler-Routinen der Sensor-Rücksetzen-FSM
2024-01-30 lidarHandler.c: Hinzufüge der Zustand-Handler-Routine für Datenempfangen-FSM
2024-01-30 lidarHandler.c: Hinzufüge der Zustand-Handler-Routinen für Hauptzustandsmaschine des Lidar-Handler-Modul
2024-01-30 lidarHandler.c: Implementation der Funktion lidar_callbackTx() für Rückruf in USART-TX-ISR()
2024-01-30 lidarHandler.c: Implementation der Funktion lidar_callbackRx() für Rückruf in USART-RX-ISR
2024-01-30 lidarHandler.c: Implementaion der Funktion lidar_initDev() hinzugefügt
2024-01-30 lidarHandler.c: Hinzufüge der Funktionen lidar_getStatus() und setAddr() hinzugefügt
2024-01-30 lidarHandler.c: Hinzufüge der List der Abkürzungen im Quellcode
2024-01-30 Hinzufüge der lidarDataPrc.h Header-Datei
2024-01-30 lidarDataPrc.h: Inklusion der notwendigen Bibliothek
2024-01-30 lidarDataPrc.h: Definition der Parameter für die internen Variablen
2024-01-30 lidarDataPrc.h: Definition der Parameter für Lidar-Filter
2024-01-30 lidarDataPrc.h: Definition des FIFO-Buffers zum Speichern der alten Werte im Filter
2024-01-30 lidarDataPrc.h: Definition der Struktur zur Verwaltung des Moduls
2024-01-30 lidarDataPrc.h: Definition der Unterabtastungstype für das Modul
2024-01-30 lidarDataPrc.h: Hinzufüge der Deklaration der Funktionen fil_init(), fil_setNConvertData(), fil_run(), fil_compressNReturn()
2024-01-30 lidarDataPrc.h: Hinzufüge der List der Abkürzungen in Quellcode
2024-01-30 Hinzufüge der lidarDataPrc.c Source-Datei
2024-01-30 lidarDataPrc.c: Deklaration der intern verwendeten Variablen
2024-01-30 lidarDataPrc.c: Hinzufüge der Funktion fil_qFExtend() zur Erweiterung der Q-Format vom 16Bits zu 32Bits
2024-01-30 lidarDataPrc: Implementation der Funktion fil_init() hinzugefügt
2024-01-30 lidarDataPrc.c: Implementation der Funktion fil_setData() hinzugefügt
2024-01-30 lidarHandler.c: Implementation der Funktion fil_setNConvertData() und ihre Subroutine fil_convertData() hinzugefügt
2024-02-04 lidarDataPrc.c: Hinzufüge der Implementation der Subroutine redundacyAdd()
2024-02-04 lidarDataPrc.c: Hinzufüge der Subroutine filtering()
2024-02-04 lidarDataPrc.c: Hinzufüge der Subroutine shiftPhaseCompensation()
2024-02-04 lidarDataPrc.c: Hinzufüge der Funktion fil_run() für Filterungsvorgang
2024-02-04 lidarDataPrc.c: Hinzufüge der Funktion fil_compressNReturn() zur Ausgabe der Daten
2024-02-04 timerUnit.h: Hinzufüge der Header-Datei vom Timer-Einheit
2024-02-04 timerUnit.h: Inklusion der System-Bibliothek-Header-Daten
2024-02-04 timerUnit.h: Inklusion der HAL-Bibliothek-Header-Daten
2024-02-04 timerUnit.h: Inklusion der Header-Datei für Fehlertyp-Ausgabe
2024-02-04 timerUnit.h: Definition der Faktoren zur Umwandlung von s zu us und ms
2024-02-04 timerUnit.h: Definition der Max. und Min. Auflösung für Timer-Einheit
2024-02-04 timerUnit.h: Definition der drei Auflösungsstufe für Timer-Einheit
2024-02-04 timerUnit.h: Hinzufüge der Abkürzungsliste
2024-02-04 timerUnit.h: Definition der Verwaltungsstruktur für Timer-Einheit
2024-02-04 timerUnit.h: Deklaration der Funktion timer_init()
2024-02-04 timerUnit.h: Deklaration der Funktionen zur Überwachung des USV-Data-Handlers
2024-02-04 timerUnit.h: Deklaration der Funktionen zur Überwachung des Lidar-Handlers
2024-02-04 timerUnit.c: Hinzufüge der Source-Datei für Timer-Einheit
2024-02-04 timerUnit.c: Hinzufüge der internen globalen Variablen
2024-02-04 timerUnit.c: Hinzufüge der Implementation der timer_init() Funktion
2024-02-04 timerUnit.c: Hinzufüge der Implementation der Funktion usvTimer_setState()
2024-02-04 timerUnit.c: Hinzufüge der Implementation der Funktion usvTimer_setCounter()
2024-02-04 timerUnit.c: Implementation der Funktion usvTimer_getCounter()
2024-02-04 timerUnit.c: Hinzufüge der Implementation von Funktion lidarTimer_setState()
2024-02-04 timerUnit.c: Implementation der Funktion lidarTimer_setCounter()
2024-02-04 timerUnit.c: Hinzufüge der Implementation von Funktion lidarTimer_getCounter()
2024-02-04 timerUnit.c: Implementation und Dokumentation der ISR von Timer/Zähler TCB0 (für USV-Data-Handler) hinzugefügt
2024-02-04 timerUnit.c: Hinzufüge der Implementation und Dokumentation der ISR für Timer/Zähler TCB1 (für Lidar-Handler) hinzugefügt
2024-02-04 timerUnit.c: Hinzufüge der Liste für Abkürzungen
2024-02-04 usvDataHandler.h: Hinzufüge der Header-Datei
2024-02-04 usvDataHandler.h: Inklusion der Header-Daten der System-Bibliotheken
2024-02-04 usvDataHanlder.h: Inklusion der HAL-Bibiliothek-Header-Daten
2024-02-04 usvDataHandler.h: Inklusion der Header-Daten für Timer-Einheit, Konfiguration für Kommunikation und 8-Bits-Register-Model
2024-02-04 usvDataHandler.h: Definition der Paramter für Protokoll-Behandlung
2024-02-04 usvDataHandler.h: Definition der Parameter für internen Variablen zur Behandlung des Protokoll-Datenrahmens
2024-02-04 usvDataHandler.h: Definition der Zeit für Datenbearbeitung beim Zielprogramm
2024-02-04 usvDataHandler.h: Definition der Protokoll-bezogene Informationen
2024-02-04 usvDataHandler.h: Definition der maximalen Versuchmale im Fehlerfall
2024-02-04 usvDataHandler.h: Definition der Datenblockadresse beim USV-Data-Programm
2024-02-04 usvDataHandler.h: Definition der Byte-Position beim Header des Protokolls
2024-02-04 usvDataHandler.h: Definition der Arbeitsmodus vom diesem Modul, bisher nur Setter-Modus möglich
2024-02-04 usvDataHandler.h: Definition der Zustände der Setter-FSM (zum Datenschreiben im Datenblock)
2024-02-04 usvDataHandler.h: Definition der Zustände der Getter-FSM (zum Datenempfangen aus Datenblock)
2024-02-04 usvDataHandler.h: Definition der Funktionstyp und Funktionszeiger für FSM-Zustand-Handler-Routine
2024-02-04 usvDataHandler.h: Definition der Zustände für Modul-FSM
2024-02-04 usvDataHandler.h: Definition von Funktionstyp und Funktionszeiger der Zustand-Handler-Routine
2024-02-04 usvDataHandler.h: Definition der Fehlerquelle für Fehlerbehandlungsfunktion
2024-02-04 usvDataHandler.h: Deklaration der Haupt-FSM dieses Modul
2024-02-04 usvDataHandler.h: Deklaration der Modulfunktionen
2024-02-04 usvDataHandler.h: Hinzufüge der Abkürzungsliste
2024-02-04 usvDataHandler.c: Hinzufüge der Source-Datei
2024-02-04 usvDataHandler.c: Hinzufüge der USART-FIFO-Max-Len konstanten Variablen
2024-02-04 usvDataHandler.c: Deklaration der Variablen zum Speichern und zur Verwaltung des Protokolls
2024-02-04 usvDataHandler.c: Deklaration der Variablen zum Speichern der noch nicht gesendeten Daten
2024-02-04 usvDataHandler.c: Hinzufüge der Zeiger zur externen Daten-Buffer und -Variablen
2024-02-04 usvDataHandler.c: Deklaration der Variablen zur Modulverwaltung
2024-02-04 usvDataHandler.c: Deklaration der Variablen zum Speichern der Ausgabe vom USART-HAL-Bibliothek
2024-02-04 usvDataHandler.c: Deklaration der Zustand-Handler-Funktionen und Look-up-Tabelle für Setter-FSM
2024-02-04 usvDataHandler.c: Deklaration der Zustand-Handler-Routine und Look-up-Tabelle der Haupt-FSM von diesem Modul
2024-02-04 usvDataHandler.c: Hinzufüge der Implementation und Dokumentation der Funktion getRegLen()
2024-02-04 usvDataHandler.c: Implementation der Funktion checkRxData() zur Überprüfen der empfangenen Daten
2024-02-04 usvDataHandler.c: Implementation der Funktion usv_ioStreamStatusAvai()
2024-02-04 usvDataHandler.c: Implementation der Funktion usv_ioStreamDataAvai()
2024-02-04 usvDataHandler.c: Hinzufüge der Funktion usv_setProtocol() zur Erstellung eines Protokolls
2024-02-04 usvDataHandler.c: Implementation der Routine usv_sendProtocol() zum Senden des Protokolls
2024-02-04 usvDataHandler.c: Implementation der Funktion usv_setRegister() zum Auslösen des Datenblock-Schreiben-Vorganges
2024-02-04 usvDataHandler.c: Hinzufüge der Zustand-Handler-Routine für Setter-FSM
2024-02-04 usvDataHandler.c: Implementation der Zustand-Handler-Routine der Modul-Haupt-FSM
2024-02-04 usvDataHandler.c: Implementation der Funktion zum Rückruf in USART-TX-ISR
2024-02-04 usvDataHandler.c: Implementation der Funktion usartCallbackRx() zum Rückruf in der USART-RX-ISR
2024-02-04 usvDataHandler.c: Implementation und Dokumentation der Funktion usv_initDev()
2024-02-04 usvDataHandler.c: Implementation der Funktion usv_setAddr()
2024-02-04 usvDataHandler.c: Hinzufüge der Abkürzungstabelle
2024-02-04 main.h: Hinzufüge der Header-Datei
2024-02-04 main.c: Erstellt der Haupt-Source-Datei des Projektes
2024-02-04 main.c: Hinzufüge der Routine zur Behandlung eines BAD-ISR
2024-02-04 main.h: Inklusion der Header-Daten der System-Bibliotheken
2024-02-04 main.h: Inklusion der Header-Datei der Filter-Koeffizienten (vom Matlab importiert)
2024-02-04 main.h: Inklusion der Header-Daten der HAL-Bibliothek
2024-02-04 main.h: Inklusion der Header-Daten von Timer-Einheit, Lidar-Handler-, USV-Data-Handler- und Datenverarbeitungseinheit
2024-02-04 main.h: Definition der Checksum-Polynome für Lidar- und USV-Handler
2024-02-04 Definition der Länge der Nachkommastelle der eingegebenen Filterkoeffizienten
2024-02-04 main.c: Deklaration der Variablen der Kommunikationskanal zwischen Lidar-, USV-Data-Handler und Datenverarbeitungseinheit
2024-02-04 main.c: Deklaration der Variablen zur Behandlung des Lidar-Handler-Moduls
2024-02-04 main.c: Deklaration der Variablen zur Behandlung des USV-Data-Handler-Moduls
2024-02-04 main.c: Deklaration der Zwischenvariablen zur Konfiguration aller Module
2024-02-04 main.c: Initialisierung des System-Clock-Moduls
2024-02-04 main.c: Initalisierung der Timer-Einheit, IO-Pin, Lidar-Handler, USV-Data-Handlers
2024-02-04 main.c: Initalisierung der Datenverarbeitungseinheit und Aktivieren des globalen Interrupt-Flags
2024-02-04 main.c: Hinzufüge der Implementation des Programmsablaufs
2024-02-04 LidarMain-Projekt: systematische Änderungen
2024-02-04 LidarTest-Projekt: Speichern der Test-Daten ohne Dokumentation
2024-02-04 lidarProtocolHandler-Projekt: Speichern der optimierten FIR-Filter
2024-02-04 RadarMain-Projekt: Hinzufüge der Quellcode der HAL-Bibliotheken
2024-02-04 asciiTable.h: Hinzufüge der Header-Datei für Ascii-Zeichen
2024-02-04 errorList.h: Hinzufüge der Rückgabe-Fehler-Code-Header-Datei
    [errorList.h]
2024-02-04 comConfig.h: Inklusion der notwendigen Bibliothek
2024-02-04 comConfig.h: Definition der Position der Zustand- und Daten-Flag im Register des Kommunikationskanals
2024-02-04 comConfig.h: Definition der für Konfiguration vom USART notwendigen Struktur
2024-02-04 comConfig.h: Definition der Enumeration zum Markieren der Position des Programmablaufs
2024-02-04 registerModel.h: Hinzufüge eines Models, das für die Simulation des Kommunikationskanal notwendig ist.
2024-02-04 timerUnit.h und timerUnit.c: Die Namen der Funktion und Variablen werden für RadarMain-Projekt angepasst. Sie sind ähnlich mit den im LidarMain-Projekt, nur die Funktions- und Variablenamen anders
2024-02-04 usvDataHandler.h: Hinzufüge der Header-Datei vom LidarMain-Projekt. Da ihre Funktionen identisch sind
2024-02-04 usvDataHandler.c: Hinzufüge der nicht für dieses Projekt angepassten Funktionen und Variablen
2024-02-04 usvDataHandler.c: Funktion usv_mainFsmStatusTxSHandlerFunc() refaktorisiert: die Adresse mit RadarMain-Projekt angepasst
2024-02-05 radarHandler.h: Hinzufüge der Header-Datei
2024-02-05 radarHandler.h: Inklusion der Header-Datei der System-Bibliothek
2024-02-05 radarHandler.h: Inklusion der Header-Datei der HAL-Bibliothek
2024-02-05 radarHandler.h: Inklusion der notwendigen Header-Daten
2024-02-05 radarHandler.h: Definition der Radar-bezogene Parameter
2024-02-05 radarHandler.h: Definition der Parameter für Ausgabe-Buffer und Arbeitszeit für Radar-Sensor
2024-02-05 radarHandler.h: Definition des Arbeitsmoduses vom Radar
2024-02-05 radarHandler.h: Definition der Zustände für Radar-Synchronisation-FSM
2024-02-05 radarHandler.h: Definition der Radar-Datenempfangen-FSM
2024-02-05 radarHandler.h: Definition der Rückruffunktionstyp und des Funktionszeigers
2024-02-05 radarHandler.h: Definition der Zustände für Haupt-FSM dieses Modul
2024-02-05 radarHandler.h: Definition des Rückruffunktionstyps und Funktionszeigers
2024-02-05 radarHandler.h: Definition der Eingabe-FIFO zum Speichern der Eingabe
2024-02-05 radarHandler.h: Definition der Zustand-Ausgabe-Register
2024-02-05 radarHandler.h: Definition der Struktur zur internen Verwaltung des Moduls
2024-02-05 radarHandler.h: Deklaration der notwendigen externen Funktionen
2024-02-05 radarHandler.h: Hinzufüge der Abkürzungsliste
2024-02-05 radarHandler.c: Hinzufüge der Source-Datei
2024-02-05 radarHandler: Deklaration der konstanten für Länge des USART-FIFO-Buffers
2024-02-05 radarHandler.c: Deklaration der internen globalen Variablen zur Protokollbehandlung
2024-02-05 radarHandler.c: Deklaration der Zeiger zu den externen Ausgabe-Buffer
2024-02-05 radarHandler.c: Deklaration der Verwaltungsvariablen
2024-02-05 radarHandler.c: Deklaration der vorläufigen Variablen zum Speichern der Ausgabe von HAL-Bibliothek-ISR
2024-02-05 radarHandler.c: Deklaration der Variablen zur Verwaltung der internen FSM
2024-02-05 radarHandler.c: Deklaration der Zustand-Handler-Routine und Look-up-Tabelle für Radar-Synchronisierung-FSM
2024-02-05 radarHandler.c: Deklaration der Zustand-Handler-Routinen und Look-up-Tabelle für Datenempfangen-FSM
2024-02-05 radarHandler.c: Deklaration der gesamten Look-up-Tabellen der internen FSMs
2024-02-05 radarHandler.c: Deklaration der Zustand-Hanlder-Routinen und Look-up-Tabelle für Modul-Haupt-FSM
2024-02-05 radarHandler.c: Implementation der Funktion uint8_t checkFIFOFullState() hinzugefügt
2024-02-05 radarHandler.c: Implementation der Funktion checkFIFOEmptyState() hinzugefügt
2024-02-05 radarHandler.c: Hinzufüge der Implementation der Funktion getFIFODataNum()
2024-02-05 radarHandler.c: Hinzufüge der Implementation der Funktion getFIFOFreeSpace()
2024-02-05 radarHandler.c: Hinzufüge der Funktion radar_ioStreamStatusAvai()
2024-02-05 radarHandler.c: Hinzufüge der Implementation der Funktion radar_ioStreamDataAvai()
2024-02-05 radarHandler.c: Hinzufüge der Implementation der Funktion radar_fifoFlush() zum Rücksetzen des Daten-FIFO-Buffers
2024-02-05 radarHandler.c: Hinzufüge der Implementation der Funktion searchNumFormatInStr() zur Erkennung der Position einer Nummerreihe in einer Zeichenfolge
2024-02-05 radarHandler.c: Hinzufüge der Implementation der Zustand-Handler-Routine für Radar-Synchronisation-FSM
2024-02-05 radarHandler.c: Hinzufüge der Implementation der Zustand-Handler-Routine für Radar-Datenempfangen-FSM
2024-02-05 radarHandler.c: Hinzufüge der Implementation der Zustand-Handler-Routine für Radar-Haupt-FSM
2024-02-05 radarHandler.c: Hinzufüge der Funktion radar_callbackTx() zum Rückruf in der USART-TX-ISR
2024-02-05 radarHandler.c: Hinzufüge der Funktion radar_callbackRx() zum Rückruf in der USART-RX-ISR
2024-02-05 radarHandler.c: Hinzufüge der Implementation der Funktion radar_initDev()
2024-02-05 radarHandler.c: Implementation der Funktion radar_getStatus()
2024-02-05 radarHandler.c: Hinzufüge der Abkürzungstabelle
2024-02-05 radarDataPrc.h: Hinzufüge der Header-Datei
2024-02-05 radarDataPrc.h: Inklusion der notwendigen System-Bibliothek-Header-Daten
2024-02-05 radarDataPrc.h: Definition der Bits-Länge für Nachkommastelle von Geschwindigkeit und Abstand
2024-02-05 radarDataPrc.h: Hinzufüge der Deklaration der externen Funktion
2024-02-05 radarDataPrc.h: Hinzufüge der Abkürzungsliste
2024-02-05 radarDataPrc.c: Hinzufüge der Source-Datei
2024-02-05 radarDataPrc.c: Hinzufüge der Implementation der Funktion data_compareNReturn()
2024-02-05 main.h: Inklusion der Header-Daten der notwendigen System-Bibliotheken
2024-02-05 main.h: Inklusion der Header-Daten von Timer-Einheit, Radar-Handler-, USV-Data-Handler- und Datenverarbeitungseinheit
2024-02-05 main.h: Definition des Checksum-Polynoms für USV-Data-Handler
2024-02-05 TestRadar-Projekt: Speichern der Test-Daten ohne Dokumentation
2024-02-05 main.m: Umbenennung der Test, da es ein Extra-Versuch ist (nur zum Überblick, keine Bewertung)
2024-02-05 test2.m: Hinzufüge der Beschreibung und Kommentare
2024-02-05 test2.m: Hinzufüge der Kommentare
2024-02-05 filterFIR.m: Funktion filterFIR() refaktorisiert: Namen und Typ des letzten Arguments verändert, Hinzufüge der Namen für die Abbildung
2024-02-05 filterIIR.m: Funktion filterIIR() refaktorisiert: Namen und Typ des letzten Arguments verändert, Hinzufüge der Namen für die Abbildung
2024-02-05 test2.m: Korrektur der Kommentare
2024-02-05 test2.m: Löschen der figureNo Variable und seine Anwesenheit in der Quellcode
2024-02-05 test2.m: Löschen der Abbildung über die Steigung in den Einzelunterbereichen
2024-02-05 test1.m: Name der Achsen hinzugefügt
2024-02-05 test3.m: Verbesserung der Kommentare
2024-02-05 test3.m: Hinzufüge der Namen sowie der Achsennamen des Originalsignaldiagramms
2024-02-05 test3.m: Löschen der figureNo Variable und seiner Anwesenheit in Quellcode
2024-02-05 test3.m: Zusammenpacken der draw Variable an nur eine Stelle
2024-02-05 test3.m: Anpassung mit der neuen filterFIR() und filterIIR() Funktionen
2024-02-05 test4.m: Hinzufüge der Namen und Achsenname des Signaldiagramms
2024-02-05 test4.m: Verbesserung der Kommentare
2024-02-05 test4.m: Zusammenpacken der draw Variable an nur eine Stelle
2024-02-05 test1.m: Korrektur der Rechtschreibung im Diagramm
2024-02-05 test4.m: Korrektur der Rechtschreibung im Diagramm
2024-02-05 test4.m: Löschen der figureNo Variable
2024-02-05 test4.m: Anpassung mit der neuen Funktion filterIIR() und filterFIR()
2024-02-05 test4.m: Korrektur der Nummer des Versuches
2024-02-05 test0.m: Anpassung mit der neuen Funktion filterIIR() und filterFIR()
2024-02-05 test5.m: Verbesserung der Kommentare, Hinzufüge Namen für Diagramme
2024-02-05 test1.m: Hinzufüge des Dokumentationsabschnittes
2024-02-05 test2.m: Hinzufüge des Dokumentationsabschnittes
2024-02-05 test3.m: Hinzufüge des Dokumentationsabschnittes
2024-02-05 main.m: Korrektur der Kommentare und Anpassung der Variablennamen
2024-02-05 filterOrder.m: Korrektur der Formel
2024-02-05 main.m: Berechnung der Abtastfrequenz und Ordnung hinzugefügt
2024-02-05 stackClass.m: Löschen des nicht mehr notwendigen Programms
2024-02-05 test0.m: Hinzufüge der Beschreibung
2024-02-05 filterSampleFreq.m: Funktion filterSampleFreq() refaktorisiert: Anpassung mit der Formeln in der Dokumentation
2024-02-05 main.m: Berechnung der Abtastfrequenz unter Anwendung der Funktion filterSampleFreq()
2024-02-05 Umbenennung des Ordners
2024-02-05 Anpassung mit der neuen filterSampleFreq()
2024-02-06 asciiTable.h: Hinzufüge der Version und Revision
2024-02-06 comConfig: Hinzufüge der Beschreibung
2024-02-06 usvDataHandler.h: Hinzufüge der Beschreibung
2024-02-06 usvDataHandler.c: Dokumentation refaktorisiert: Korrektur der Beschreibung und Ausgabe
2024-02-06 usvDataHandler.h: Adresse von Register korrigiert
    [usvDataHandler.h]
2024-02-06 usvDataHandler.c: getRegLen() refaktorisiert: die Länge von ER4_ADD verkürzt
2024-02-06 lidarHandler.c: Korrektur der Definition der Zustand-Register-Länge
2024-02-06 lidarHandler.h: Struktur lidarStatus_t refaktorisiert: die Länge des Datenblockes reduziert
2024-02-06 lidarHandler.c: lidar_paramStartSHandlerFunc() refaktorisiert: Anpassung mit der neuen Struktur von Variable lidar_status (deren Typ lidarStatus_t ist)
2024-02-06 lidarHandler.c: lidar_mainSyncSignalCheckSHandler() refaktorisiert: Anpassung mit der neuen Struktur von Variable lidar_status (deren Typ lidarStatus_t ist)
2024-02-06 lidarHandler.c: lidar_mainDataCheckSHandler() refaktorisiert: Anpassung mit der neuen Struktur von Variable lidar_status (deren Typ lidarStatus_t ist)
2024-02-06 lidarHandler.c: lidar_mainResetPollingSHandler() refaktorisiert: Anpassung mit der neuen Struktur von Variable lidar_status (deren Typ lidarStatus_t ist)
2024-02-06 usvDataHandler.h: Korrektur des Formates vom usvRegAdd_t
2024-02-06 usvDataHandler.c: Dokumentation der Funktion usv_ioStreamStatusAvai() hinzugefügt
2024-02-06 usvDataHandler.c: Dokumentation der Funktion usv_ioStreamDataAvai() hinzugefügt
2024-02-06 usvDataHandler.c: Hinzufüge der Dokumentation der Funktion usv_setProtocol()
2024-02-06 usvDataHandler.c: Dokumentation der Funktion usv_sendProtocol()
2024-02-06 usvDataHandler.c: Dokumentation der Funktion usv_setRegister()
2024-02-06 usvDataHandler.c: Dokumentation der Funktion fsm_setterTxStateHandlerFunc()
2024-02-06 usvDataHandler.c: Dokumentation der Funktion fsm_setterRxStateHandlerFunc()
2024-02-06 usvDataHandler.c: Dokumentation der Funktion fsm_setterRxStateHandlerFunc() korrigiert
    [usvDataHandler.c]
2024-02-06 usvDataHandler.c: Dokumentation der Funktion fsm_setterEndSHandlerFunc() hinzugefügt
2024-02-06 usvDataHandler.c: Dokumentation der Funktion usv_mainFsmStartSHandlerFunc()
2024-02-06 usvDataHandler.c: Dokumentation der Funktionen usv_mainFsmStatusTxSHandlerFunc(), usv_mainFsmStatusRspPollSHandlerFunc() und usv_mainFsmStatusRspCheckSHandlerFunc() hinzugefügt
2024-02-07 usvDataHandler.c: Hinzufüge der Dokumentation der Funktion usv_mainFsmDataTxSHandlerFunc()
2024-02-07 usvDataHandler.c: Dokumentation der Funktion usv_mainFsmDataRspPollSHandlerFunc()
2024-02-07 usvDataHandler.c: Dokumentation der Funktion usv_mainFsmDataRspCheckStateFunc()
2024-02-07 usvDataHandler.c: Dokumentation der Funktion usv_mainFsmErrorSHandlerFunc()
2024-02-07 usvDataHandler.c: Dokumentation der Ruckrüffunktion usartCallbackTx()
2024-02-07 usvDataHandler.c: Dokumentation der Funktion usartCallbackTx() refaktorisiert: Korrektur der Fehler beim Argument data
2024-02-07 usvDataHandler.c: Dokumentation der Ruckrüffunktion usartCallbackRx()
2024-02-07 usvDataHandler.c: Dokumentation der Funktion usv_setAddr()
2024-02-07 timerUnit.h: Beschreibung hinzugefügt
2024-02-07 timerUnit.c: Hinzufüge der Beschreibung
2024-02-07 timerUnit.c: Dokumentation der Funktion timer_init()
2024-02-07 timerUnit.c: Dokumentation aller Funktionen zum Steuern des USV-Data-Wächter
2024-02-07 timerUnit.c: Dokumentation aller Funktionen zum Steuern des Lidar-Wächters
2024-02-07 registerModel.h: Hinzufüge der Beschreibung
2024-02-07 errorList.h: Hinzufüge der Dateibeschreibung
    [errorList.h]
2024-02-07 lidarHandlerProtocol.h: Hinzufüge der Beschreibung
2024-02-07 lidarDataPrc.h: Hinzufüge der Beschreibung
2024-02-07 lidarDataPrc.c: Beschreibung hinzugefügt
2024-02-07 lidarData.c: Dokumentation der Funktion fil_qFExtend()
2024-02-07 lidarDataPrc.c: Dokumentation der Funktion fil_init()
2024-02-07 lidarDataPrc.c: Dokumentation der Funktion fil_setData()
2024-02-07 lidarDataPrc.c: Dokumentation der Funktion fil_convertData()
2024-02-07 lidarDataPrc.c: Dokumentation der Funktion fil_setNConvertData()
2024-02-07 lidarDataPrc.c: Dokumentation der Funktion redundacyAdd()
2024-02-07 lidarDataPrc.c: Hinzufüge der Dokumentation der Funktion filtering()
2024-02-07 lidarDataPrc.c: Dokumentation der Funktion shiftPhaseCompensation()
2024-02-07 lidarDataPrc.c: Dokumentation der Funktion fil_run()
2024-02-07 lidarDataPrc.c: Dokumentation der Funktion fil_compressNReturn()
2024-02-07 lidarHandler.h: Beschreibung hinzugefügt
2024-02-07 lidarHandler.c: Beschreibung hinzugefügt
2024-02-07 lidarHandler.c: Hinzufüge der Dokumentation der Funktion lidar_checksum16()
2024-02-07 lidarHandler.c: Dokumentation der Funktion lidar_rspVal() hinzugefügt
2024-02-07 lidarHandler.c: Dokumentation der Funktion lidar_rxRountine()
2024-02-07 lidarHandler.c: Dokumentation der Funktion lidar_checkRXData()
2024-02-07 lidarHandler.c: Dokumentation der Funktion lidar_checkRXData() refaktorisiert: Rückgabe korrigiert
    [lidarHandler.c]
2024-02-07 lidarHandler.c: Dokumentation der Funktion lidar_dataCheck()
2024-02-07 lidarHandler.c: Dokumentation der Funktion lidar_getCmdDataLen()
2024-02-07 lidarHandler.c: Dokumentation der Funktion lidar_setProtocol()
2024-02-07 lidarHandler.c: Hinzufüge der Dokumentation der Funktion lidar_sendProtocol()
2024-02-07 lidarHandler.c: Dokumentation der Funktion lidar_ioStreamStatusAvai()
2024-02-07 lidarHandler.c: Dokumentation der Funktion lidar_ioStreamDataAvai()
2024-02-07 lidarHandler.c: Dokumentation der Funktion lidar_dataGet()
2024-02-07 lidarHandler.c: Dokumentation aller Zustand-Handler-Routine der Synchronisation-FSM
2024-02-07 lidarHandler.c: Dokumentation aller Zustand-Handler-Routinen der Rücksetzen-FSM hinzugefügt
2024-02-07 lidarHandler.c: Dokumentation aller Zustand-Handler-Routine der Datenempfangen-FSM hinzugefügt
2024-02-07 lidarHandler.c: Aktualisieren der Dokumentation über den Pause-Zustand aller internen FSMs
2024-02-07 lidarHandler.c: Dokumentation aller Zustand-Handler-Routinen der Lidar-Haupt-FSM hinzugefügt
2024-02-07 lidarHandler.c: Dokumentation der Rückruffunktion lidar_callbackTx() hinzugeüfgt
2024-02-07 lidarHandler.c: Dokumentation der Rückruffunktion lidar_callbackRx()
2024-02-07 lidarHandler.c: Dokumentation der Funktion lidar_initDev() hinzugefügt
2024-02-07 lidarHandler.c: Dokumentation der Funktion lidar_getStatus() hinzugefügt
2024-02-07 lidarHandler.c: Dokumentation der Funktion lidar_setAddr()
2024-02-07 asciiTable.h: Hinzufüge der Version, Revision und Beschreibung
2024-02-07 comConfig.h: Beschreibung, Version und Revision und Korrektur der Rechtschreibung hinzugefügt
2024-02-07 errorList.h: Beschreibung und Revision hinzugefügt
    [errorList.h]
2024-02-07 usvDataHandler.h: Aktualisieren der Beschreibung, Revision und der Register-Adresse
2024-02-07 usvDataHandler: Hinzufüge der Beschreibung, Aktualisierung der Version und Revision sowie die Registerlänge
2024-02-07 usvDataHandler.c: Dokumentation der Funktion getRegLen() refaktorisiert: Aktualisierung des Inhaltes
2024-02-07 usvDataHandler.c: Dokumentation der Funktion checkRxData()
2024-02-07 usvDataHandler.c: Dokumentation der Funktion usv_ioStreamStatusAvai()
2024-02-07 usvDataHandler.c: Dokumentation der Funktion usv_ioStreamDataAvai()
2024-02-07 usvDataHandler.c: Dokumentation der Funktion usv_setProtocol()
2024-02-07 usvDataHandler.c: Dokumentation aller Zustand-Handler-Routine der Datensenden-FSM hinzugefügt
2024-02-07 usvDataHandler.c: Dokumentation aller Zustand-Handler-Routinen der Modul-Haupt-FSM
2024-02-07 usvDataHandler.c: Dokumentation der Rückruffunktion usartCallbackTx() hinzugefügt
2024-02-07 usvDataHandler.c: Dokumentation von usartCallbackRx() refaktorisiert: Korrektur die Beschreibung des adress-Argumentes
2024-02-07 usvDataHandler.c: Dokumentation der Rückruffunktion usartCallbackRx()
2024-02-07 usvDataHandler.c: Dokumentation der usv_initDev() Funktion aktualisiert
2024-02-07 usvDataHandler.c: Dokumentation der Funktion usv_initDev() aktualisiert
2024-02-07 timerUnit.h: Hinzufüge der Beschreibung und Revision
2024-02-07 timerUnit.c: Hinzufüge der Beschreibung und Revision
2024-02-07 timerUnit.c: Hinzufüge der Dokumentation der Funktion timer_init()
2024-02-07 timerUnit.c: Dokumentation aller Funktionen zum Steuern des USV-Data-Wätchers hinzugefügt
2024-02-07 timerUnit.c: Hinzufüge der Dokumentation der Funktionen zum Steuern des Radar-Handler-Wätchers
2024-02-07 registerModel.h: Hinzufüge der Beschreibung und Revision
2024-02-07 main.h: Hinzufüge der Beschreibung und Revision
2024-02-07 main.c: Hinzufüge der Beschreibung und der Revision
2024-02-08 radarHandler.c: Dokumentation der Funktion checkFIFOFullState() hinzugefügt
2024-02-08 radarHandler.h: Hinzufüge der Beschreibung und der Revision
2024-02-08 radarHandler.c: Hinzufüge der Beschreibung und Revision
2024-02-08 radarHandler.c: Dokumentation der Funktion getFIFODataNum()
2024-02-08 radarHandler.c: Dokumentation der Funktion getFIFOFreeSpace()
2024-02-08 radarHandler.c: Dokumentation der Funktion radar_ioStreamStatusAvai()
2024-02-08 radarHandler.c: Dokumentation der Funktion radar_ioStreamDataAvai()
2024-02-08 radarHandler.c: Dokumentation der Funktion radar_fifoFlush()
2024-02-08 radarHandler.c: Dokumentation der Funktion searchNumFormatInStr()
2024-02-08 radarHandler.c: Hinzufüge der Dokumentation aller Zustand-Handler-Routinen der Synchronisation-FSM
2024-02-08 radarHandler.c: Hinzufüge der DOkumentation aller Zustand-Handler-Routinen der Datenempfangen-FSM
2024-02-08 radarHandler.c: Hinzufüge der Rückgabe in der Dokumentation der Funktion radar_dataEndSHandlerFunc()
2024-02-08 radarHandler.c: Dokumentation der Zustand-Handler-Routinen der Datenempfangen-FSM
2024-02-08 lidarHandler.c: Dokumentation der Funktion lidar_callbackTx() refaktorisiert: Beschreibung des adress-Argument korrigiert
    [lidarHandler.c]
2024-02-08 radarHandler.c: Dokumentation der Funktion radar_callbackTx()
2024-02-08 radarHandler.c: Dokumentation der Funktion radar_callbackRx()
2024-02-08 radarHandler.c: Dokumentation der Funktion radar_initDev() hinzugefügt
2024-02-08 radarHandler.c: Dokumentation der Funktion radar_getStatus()
2024-02-08 radarDataPrc.h: Hinzufüge der Beschreibung und Revison
2024-02-08 radarDataPrc.c: Hinzufüge der Beschreibung und Revision
2024-02-08 radarHandler.c: Hinzufüge der Dokumentation der Funktion data_compareNReturn()
2024-02-08 filter_FIR.c: Entfernung aller nicht notwendigen Teile
2024-02-08 main.c: Hinzufüge des Info-Teil und die Dokumentation
2024-02-08 main.c: Löschen der Uhrzeit im Info-Teil
2024-02-08 filterConfig.h: Hinzufüge des Info-Teils
2024-02-08 filter_FIR.c: Hinzufüge des Info-Teils
2024-02-08 filter_FIR.h: Hinzufüge des Info-Teils
2024-02-08 ioModul.c: Hinzufüge des Info-Teils
2024-02-08 ioModul.h: Hinzufüge des Info-Teils
2024-02-08 ioModul.c: Dokumentation der Funktion readFile()
2024-02-08 ioModul.c: Dokumentation der Funktion getData()
2024-02-08 ioModul.c: Dokumentation der Funktion writeFileInt32()
2024-02-08 lidarProtocolHandler.cbp: Hinzufüge Doxygen-Addon
2024-02-08 ioModul.c: Dokumentation der Funktion writeFileInt32 aktualisieren
2024-02-08 ioModul.c: Dokumentation der Funktion writeFileInt64()
2024-02-08 filter_FIR.c: Dokumentation der Funktion fir_init()
2024-02-08 filter_FIR.c: Dokumentation der Funktion fir_runFiP()
2024-02-08 asciiTable.h und crcCalculator.c: Hinzufüge des Info-Teils
2024-02-08 main.c: Ausdrucken des Ausgabe-Pfads
2024-02-08 Unbenennung des Ordners 02_Mikrocontroller in 03 Mikrocontroller
2024-02-08 Löschen der altmodischen Dokumentationen
2024-02-08 Update Note.txt: Löschen der altmodischen Dokumentationen
2024-02-08 FilterTesting-Projekt: Löschen der Daten, da sie nicht im Main-Branch notwendig sind. Ordner beinhalten für Ausgabe vom Matlab-Programm
2024-02-08 Löschen des "Inbetriebnahme USART"-Projekt, da es in main-Branch nicht notwendig ist
2024-02-08 Löschen des "LidarTest"-Projekt, da es in main-Branch nicht notwendig ist
2024-02-08 Löschen des "Testen mit USVData"-Projektes, da sie in main-Branch nicht notwendig ist
2024-04-08 IMU Data
2024-07-11 digitaler Zwilling
    [Datenblock.csv, positions.csv]
2024-10-10 RPi Pico PIO Modul für UART
2024-10-16 Futaba SBUS Driver
2024-10-16 function for drive(trust, rudder)
2024-10-16 function for drive(trust,rudder)
2024-11-20 Datenblock erweitert (Lichterführung)
    [Datenblock.csv]
2024-11-20 Datenbloch erweitert (Lichterführung)
    [Datenblock.csv]
