s2chhaen/USV/(notices)

Notices in the files:
parts and their libraries:
Eagle_WR-MM: Copyright: Würth Elektronik
